RobertBaruch/lmarv/3dshapes/CAY_17-J.step

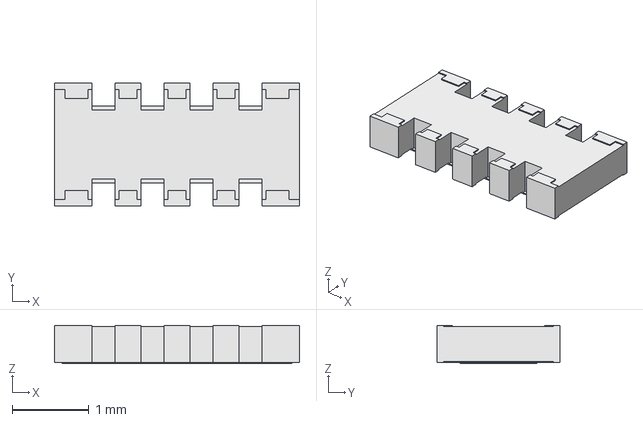
[picture p1: CAD file, 2018-12-16]
3dshapes/CAY_17-J.step
3.20 x 1.60 x 0.5 mm
