RobertBaruch/lmarv/3dshapes/APTD2012.step

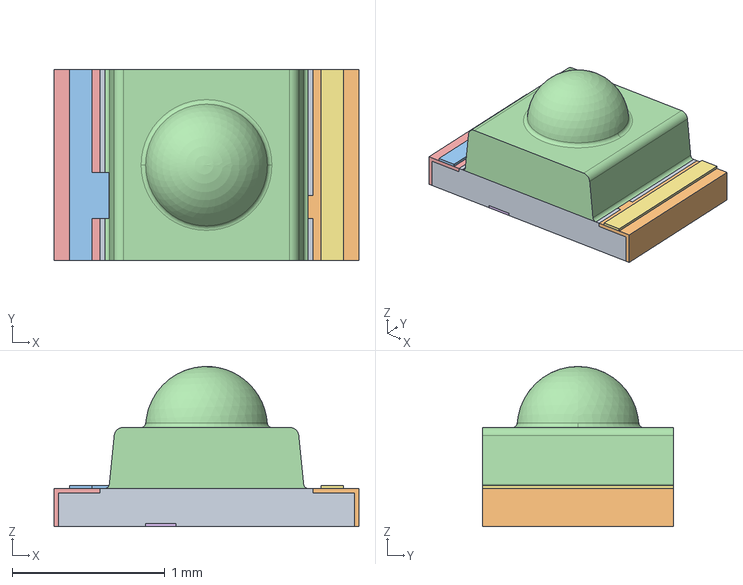
[picture p2: CAD file, 2018-12-16]
3dshapes/APTD2012.step
2.00 x 1.25 x 1.05 mm
