RobertBaruch/lmarv/3dshapes/qfp52_P1mm_14x14mm_v3_cp.step

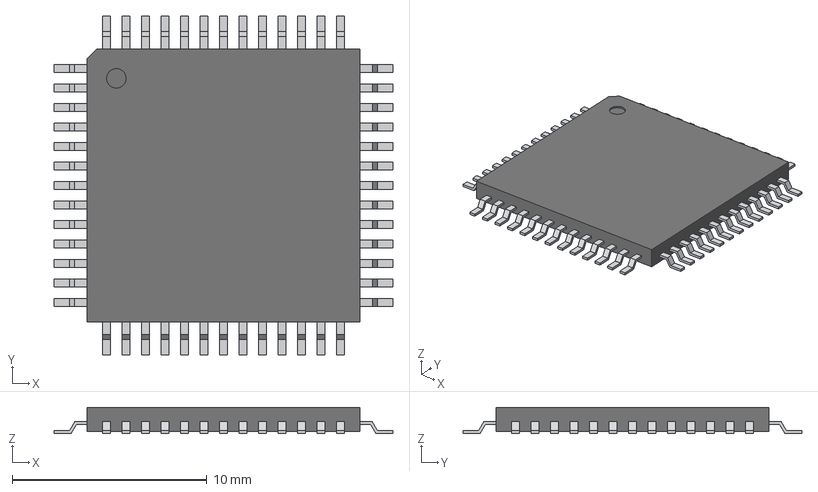
[picture p3: CAD file, 2018-12-16]
3dshapes/qfp52_P1mm_14x14mm_v3_cp.step
17.4 x 17.4 x 1.35 mm
