RobertBaruch/lmarv/lmarv-1/riscv-instructions-book/instr-add-datapath.png

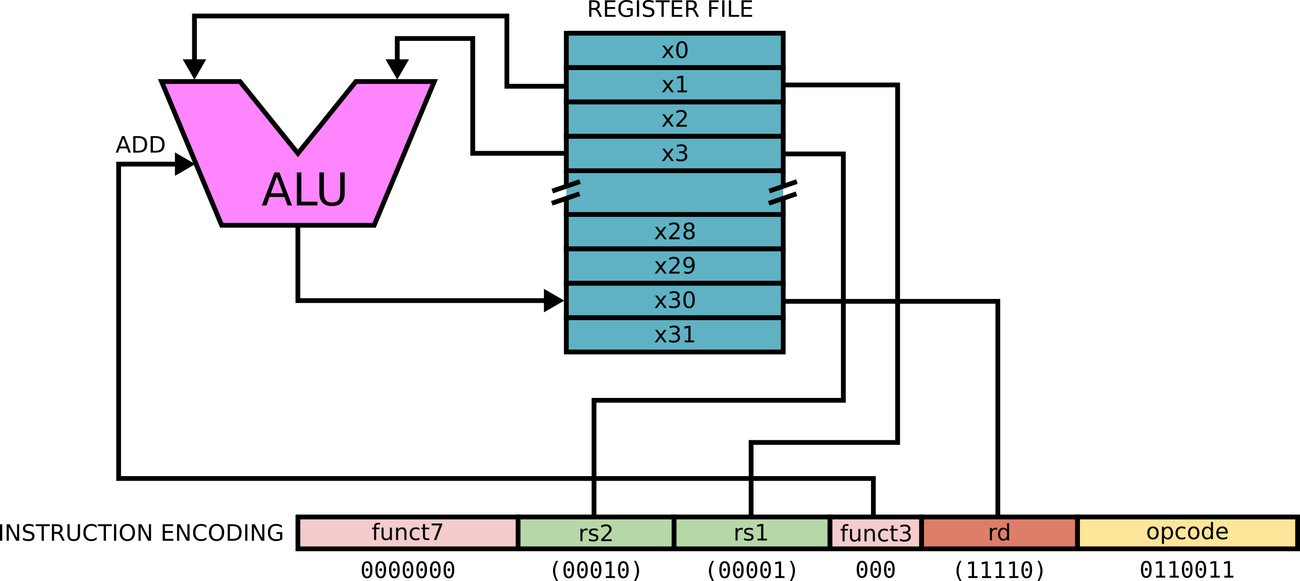
lmarv-1/riscv-instructions-book/instr-add-datapath.png
