RobertBaruch/lmarv/lmarv-1/riscv-instructions-book/instr-add-example.png

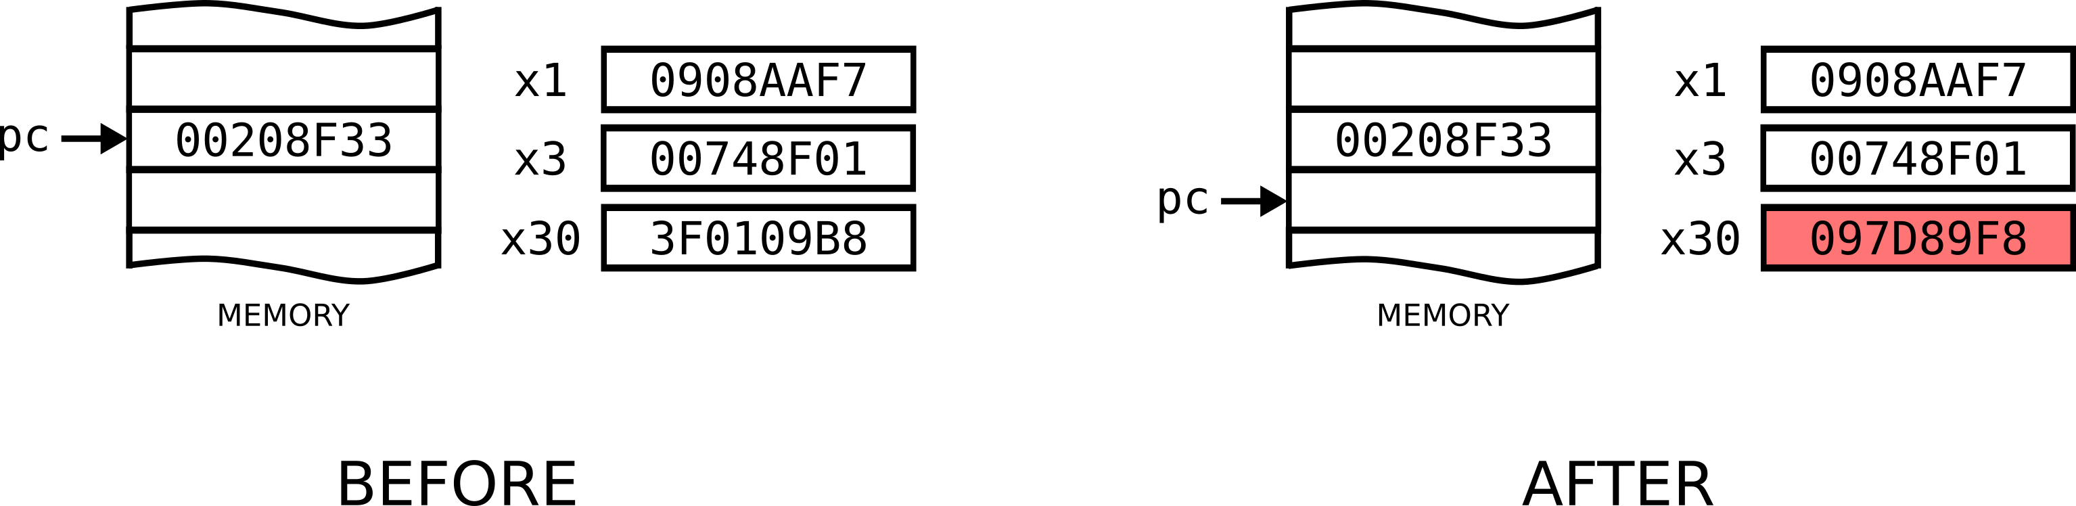
lmarv-1/riscv-instructions-book/instr-add-example.png
