RobertBaruch/lmarv/lmarv-1/riscv-instructions-book/instr-addi-datapath.png

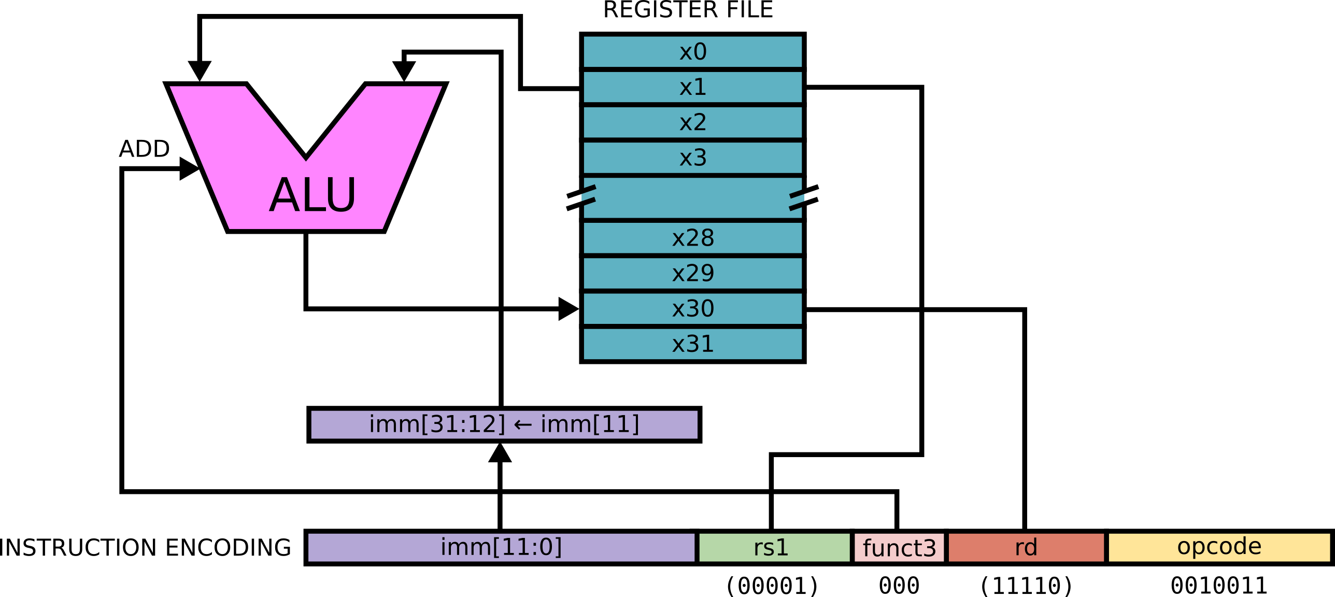
lmarv-1/riscv-instructions-book/instr-addi-datapath.png
