RobertBaruch/lmarv/lmarv-1/riscv-instructions-book/instr-auipc-datapath.png

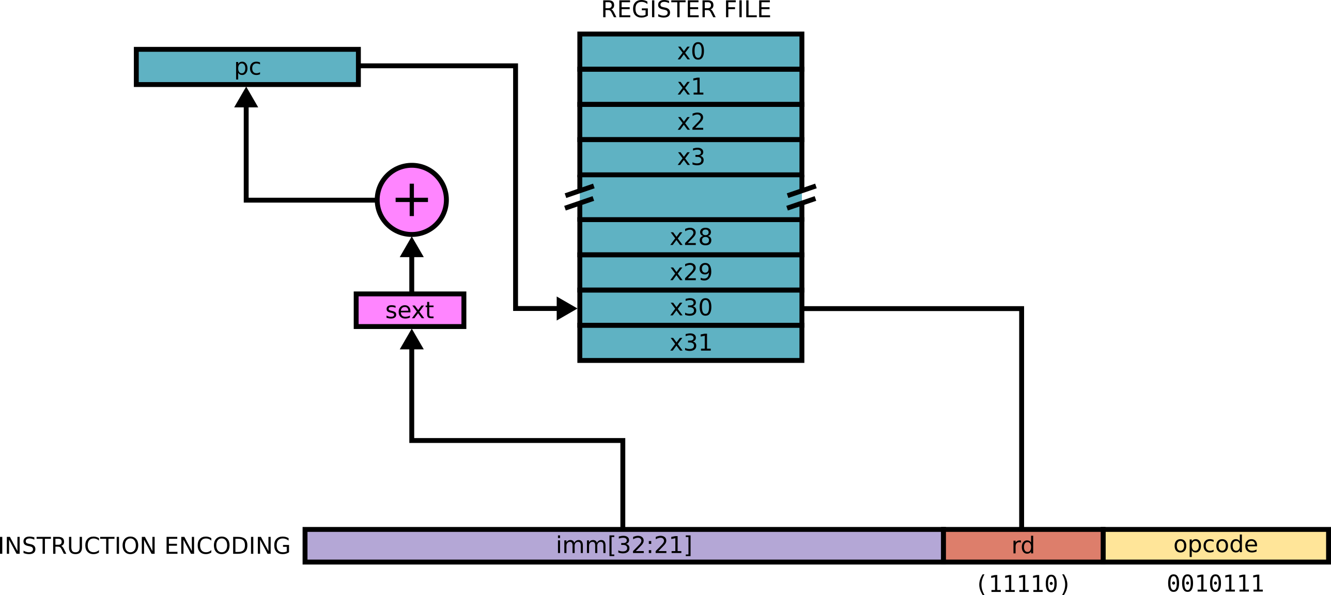
lmarv-1/riscv-instructions-book/instr-auipc-datapath.png
