RobertBaruch/lmarv/lmarv-1/riscv-instructions-book/instr-auipc-example.png

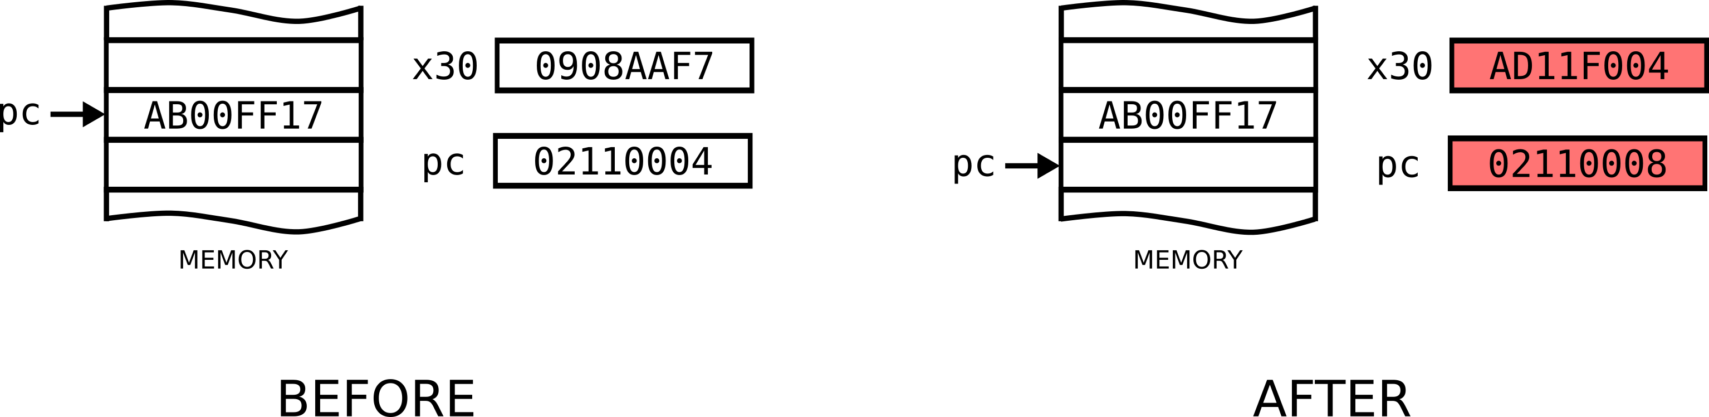
lmarv-1/riscv-instructions-book/instr-auipc-example.png
