RobertBaruch/lmarv/lmarv-1/riscv-instructions-book/instr-beq-datapath.png

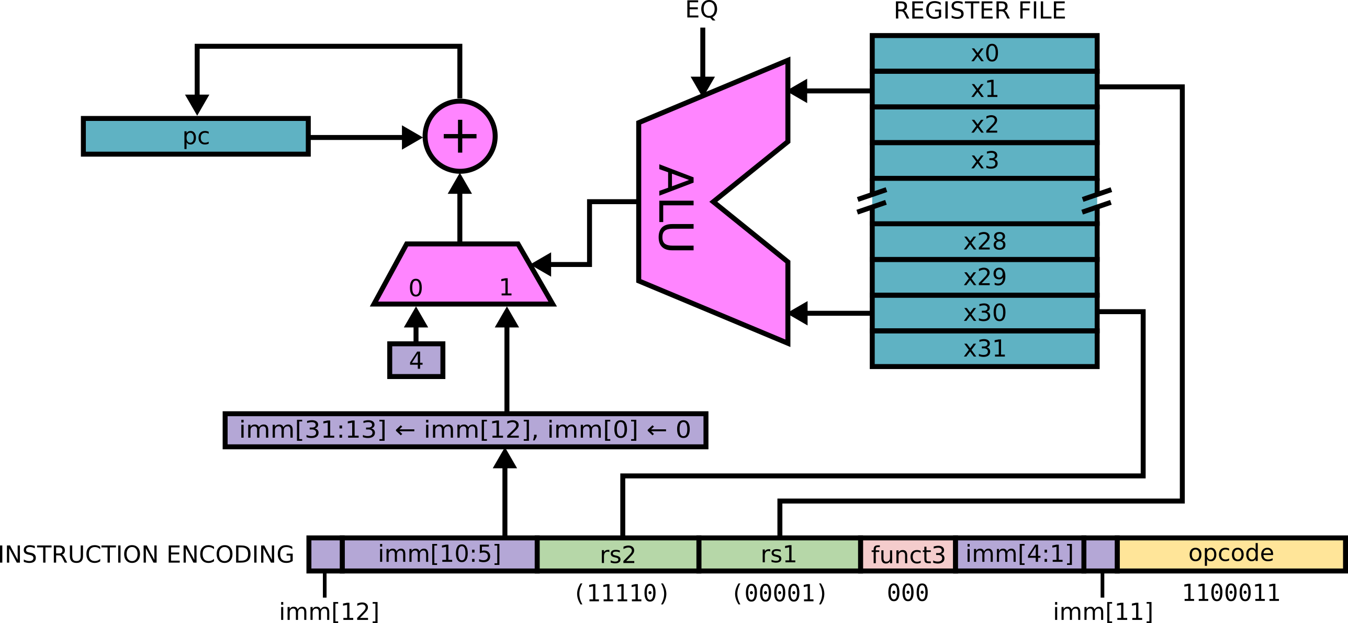
lmarv-1/riscv-instructions-book/instr-beq-datapath.png
