RobertBaruch/lmarv/lmarv-1/riscv-instructions-book/instr-beq-example.png

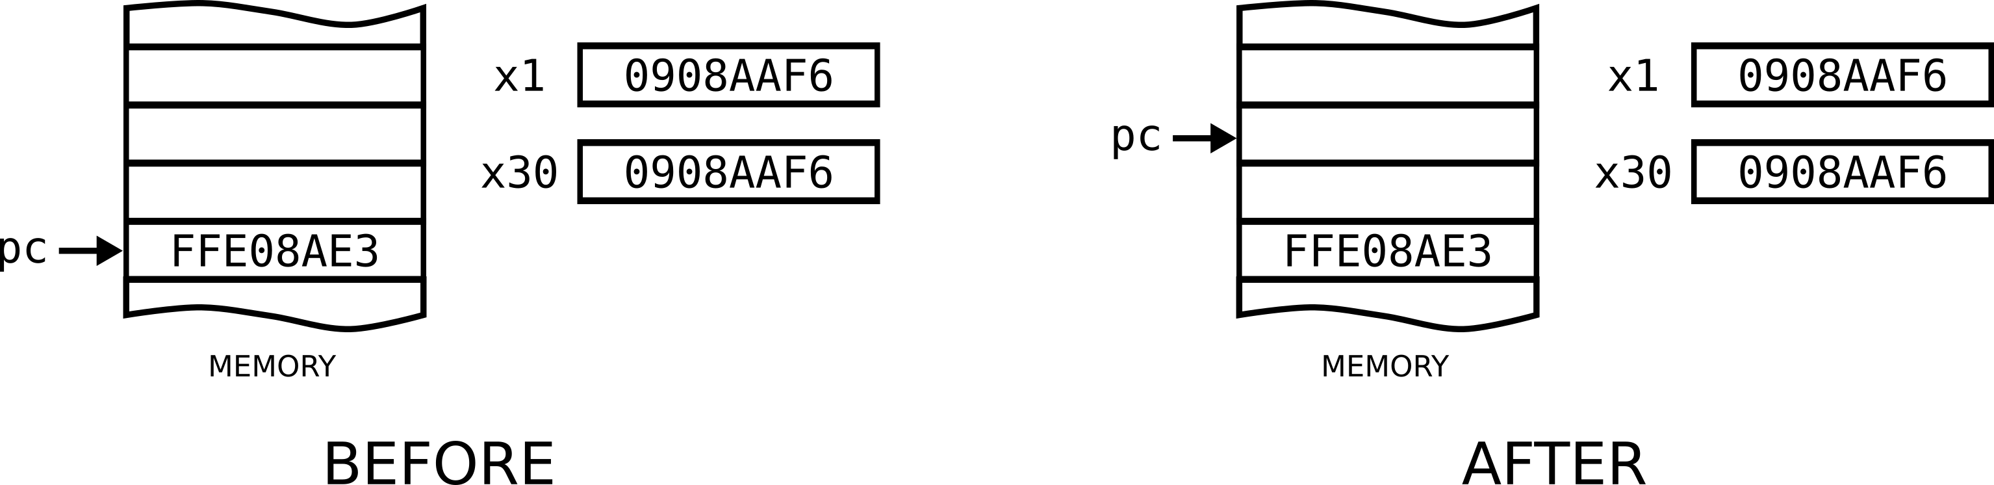
lmarv-1/riscv-instructions-book/instr-beq-example.png
