RobertBaruch/lmarv/lmarv-1/riscv-instructions-book/instr-csrrw-datapath.png

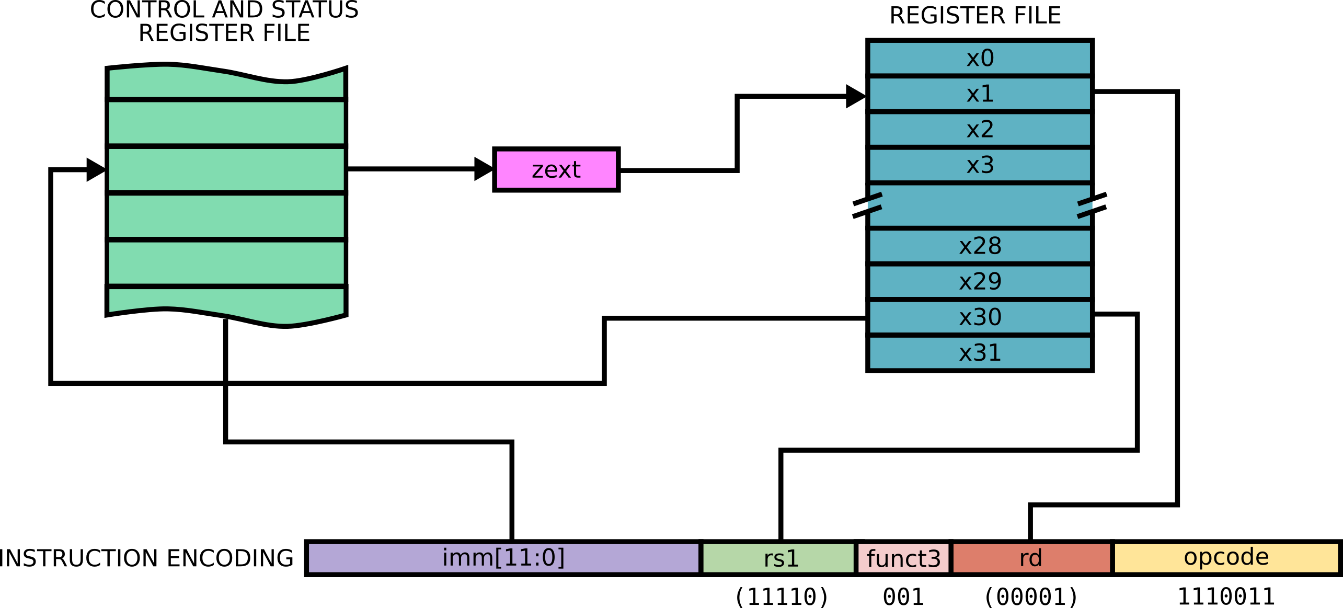
lmarv-1/riscv-instructions-book/instr-csrrw-datapath.png
