RobertBaruch/lmarv/lmarv-1/riscv-instructions-book/instr-csrrw-example.png

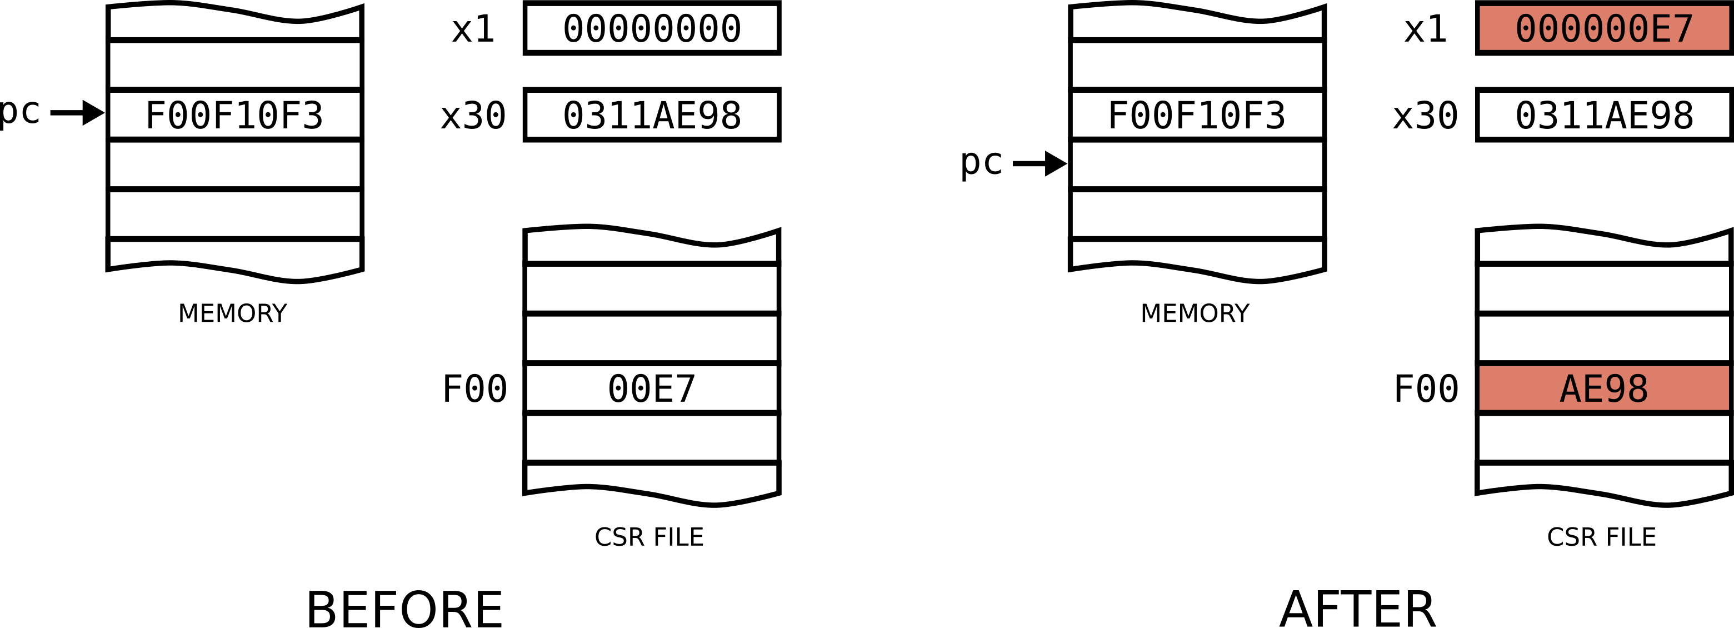
lmarv-1/riscv-instructions-book/instr-csrrw-example.png
