RobertBaruch/lmarv/lmarv-1/riscv-instructions-book/instr-diag-beq.png

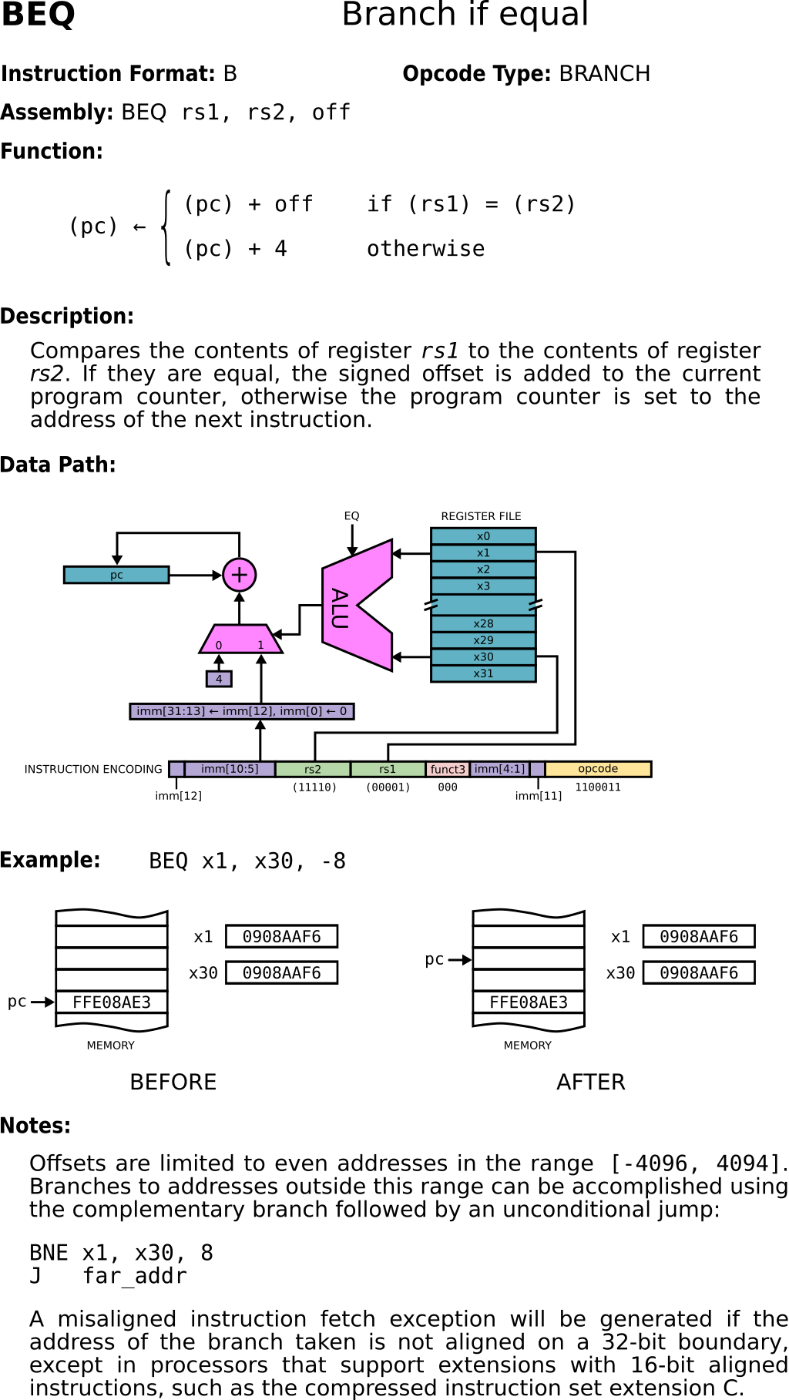
lmarv-1/riscv-instructions-book/instr-diag-beq.png
