RobertBaruch/lmarv/lmarv-1/riscv-instructions-book/instr-diag-csrrw.png

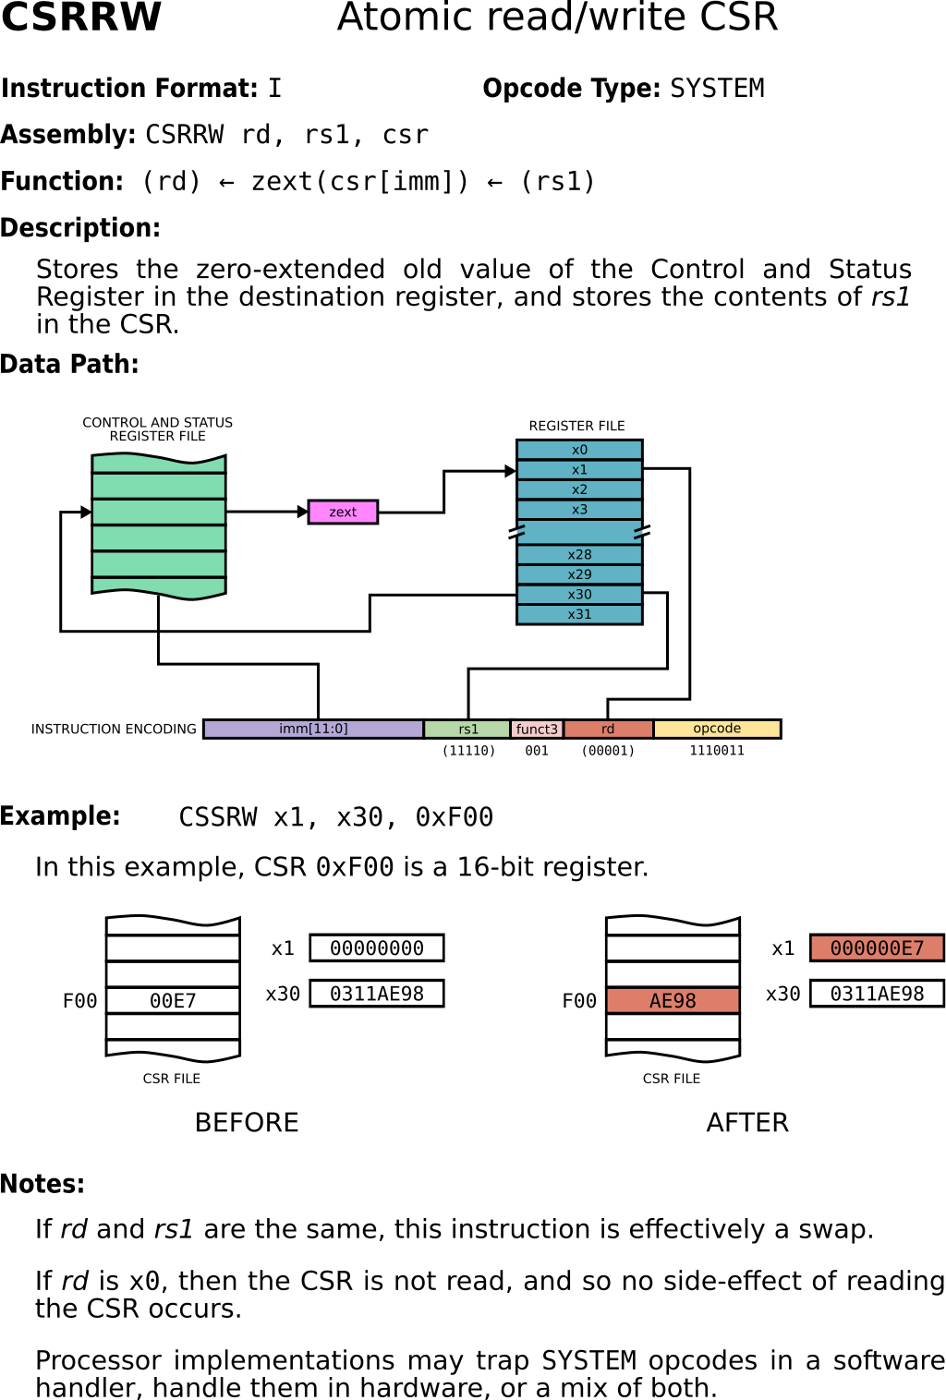
lmarv-1/riscv-instructions-book/instr-diag-csrrw.png
