RobertBaruch/lmarv/lmarv-1/riscv-instructions-book/instr-diag-jal.png

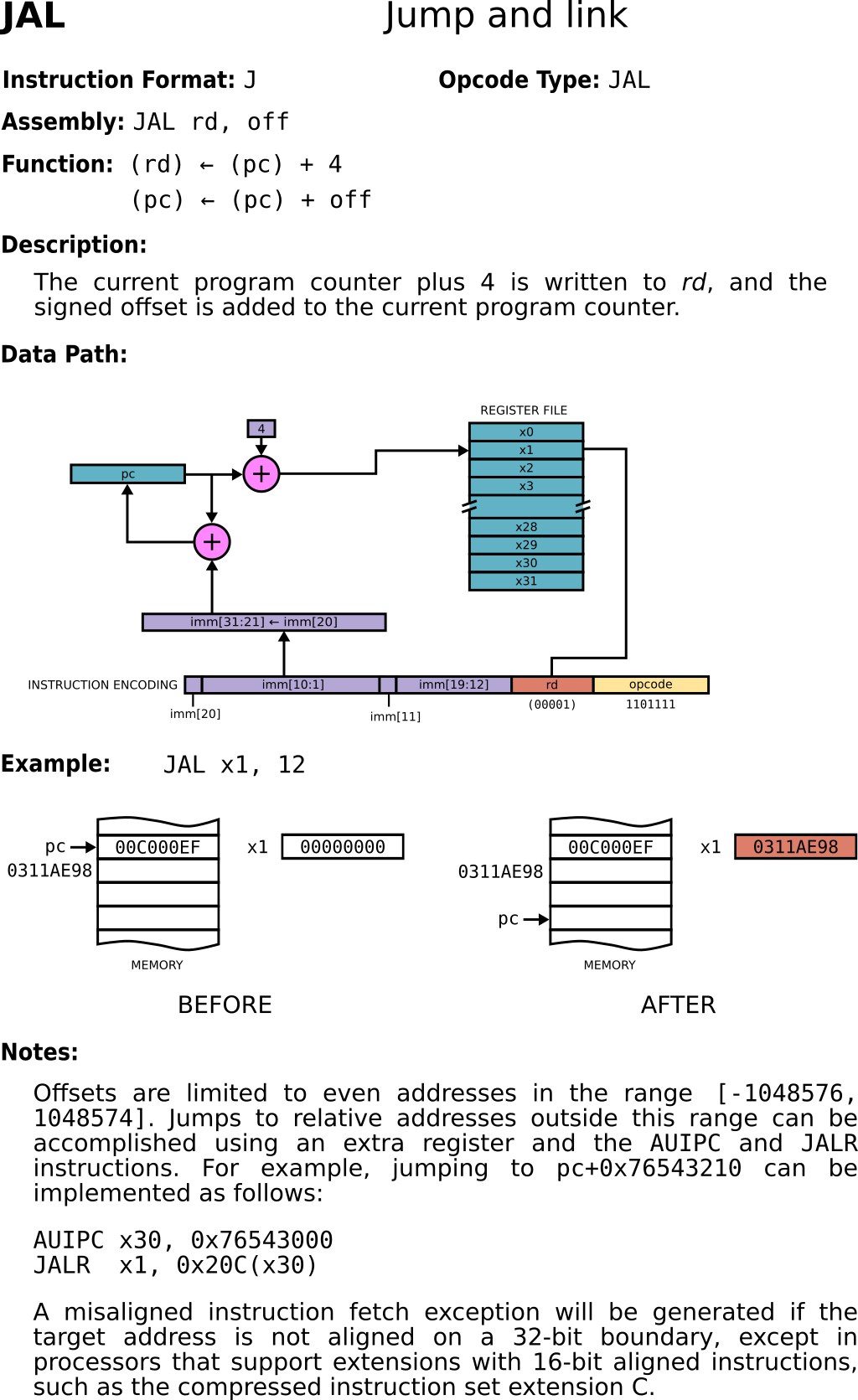
lmarv-1/riscv-instructions-book/instr-diag-jal.png
