RobertBaruch/lmarv/lmarv-1/riscv-instructions-book/instr-diag-jalr.png

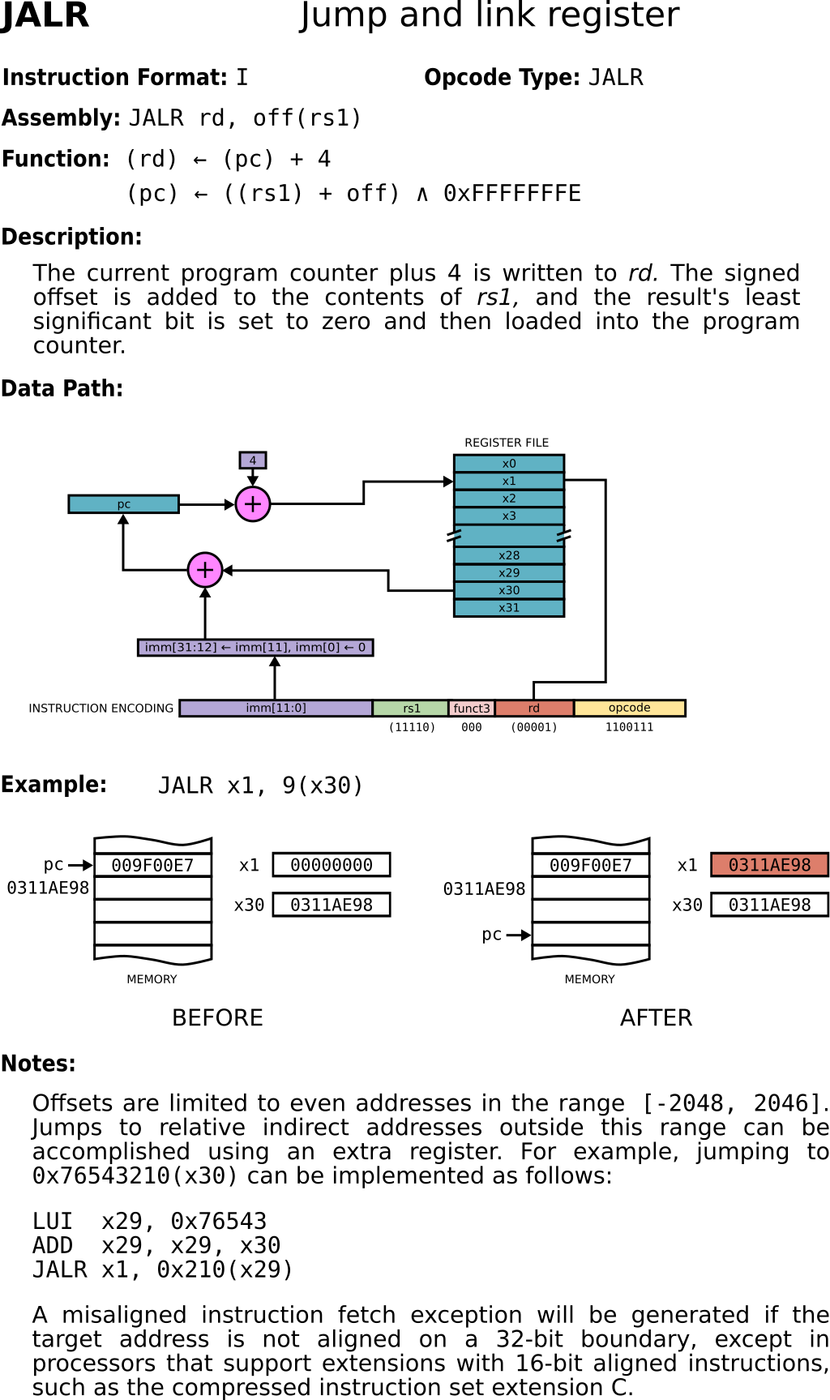
lmarv-1/riscv-instructions-book/instr-diag-jalr.png
