RobertBaruch/lmarv/lmarv-1/riscv-instructions-book/instr-diag-lh.png

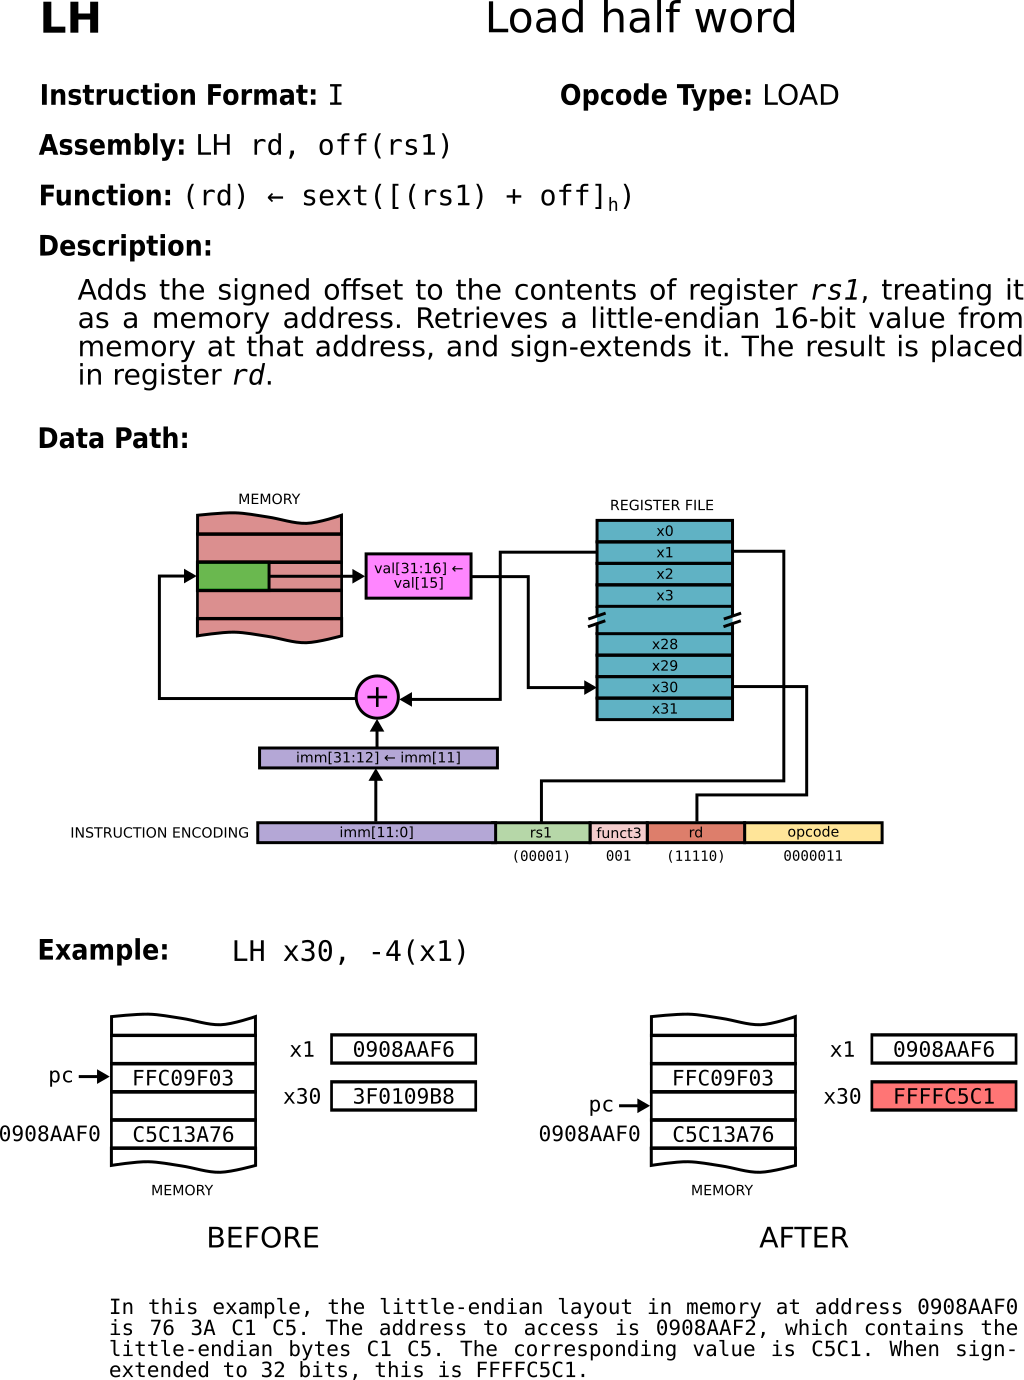
lmarv-1/riscv-instructions-book/instr-diag-lh.png
