RobertBaruch/lmarv/lmarv-1/riscv-instructions-book/instr-diag-nop.png

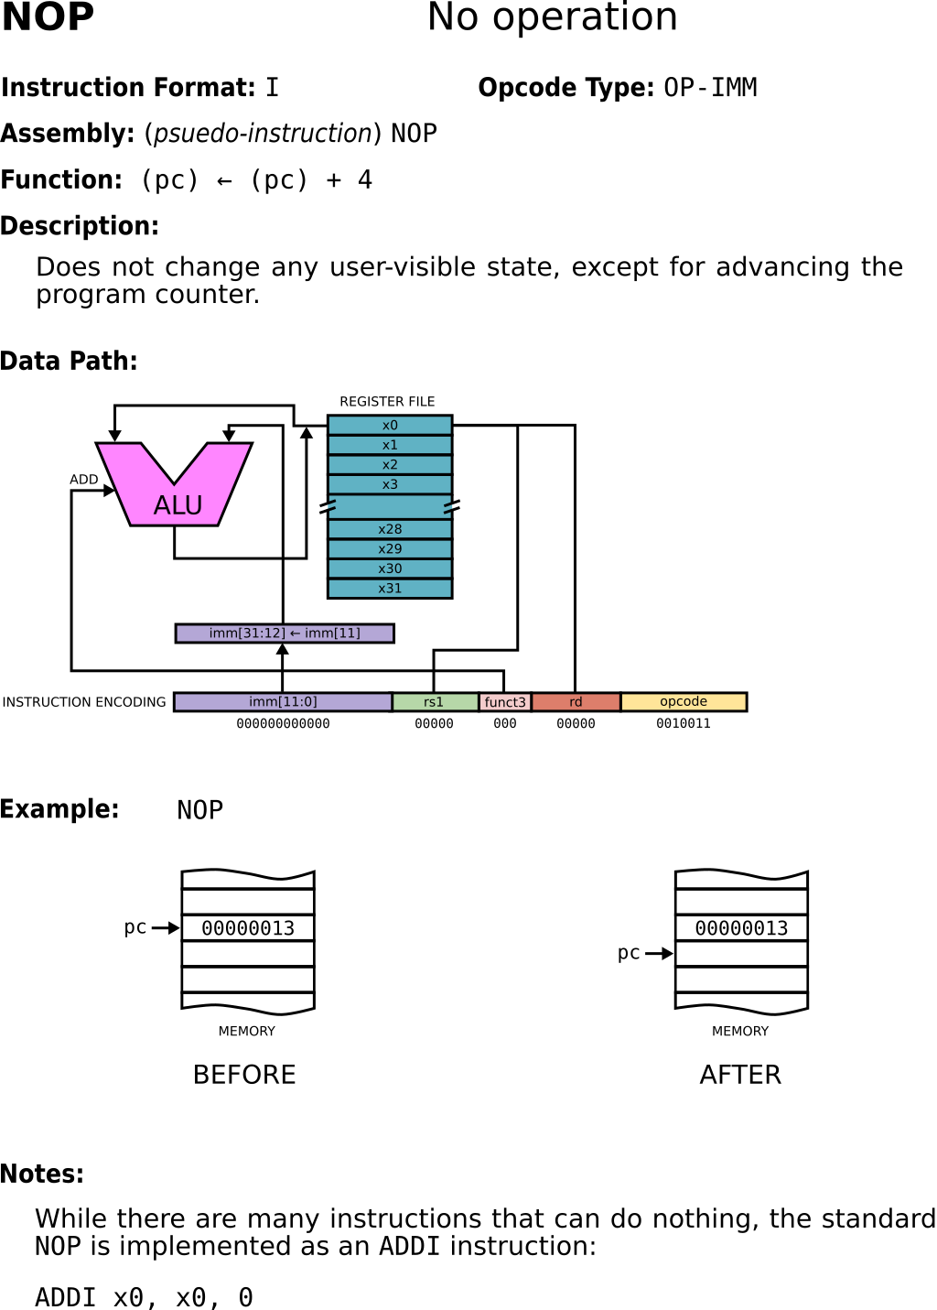
lmarv-1/riscv-instructions-book/instr-diag-nop.png
