RobertBaruch/lmarv/lmarv-1/riscv-instructions-book/instr-jal-datapath.png

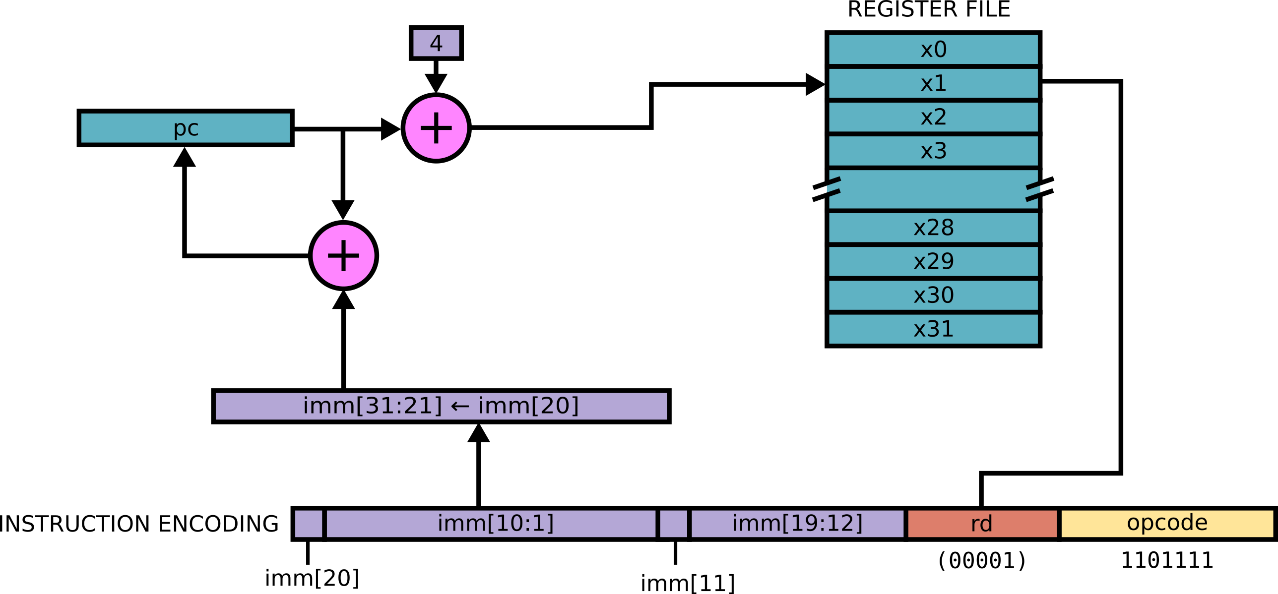
lmarv-1/riscv-instructions-book/instr-jal-datapath.png
