RobertBaruch/lmarv/lmarv-1/riscv-instructions-book/instr-jal-example.png

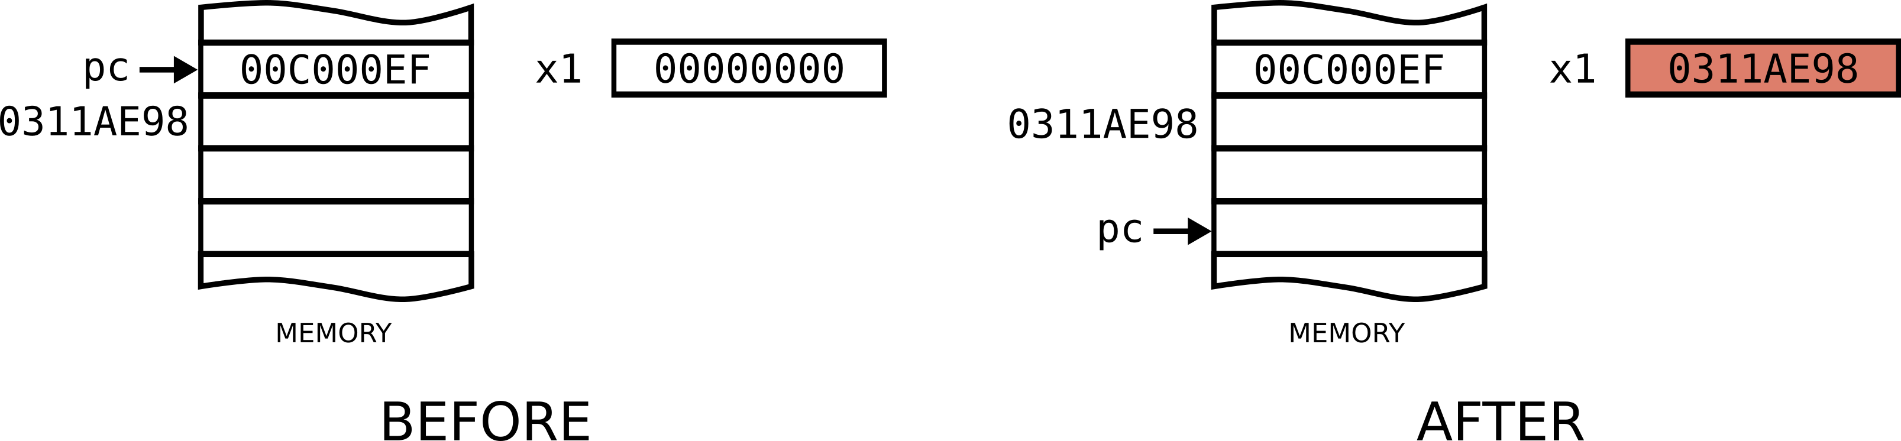
lmarv-1/riscv-instructions-book/instr-jal-example.png
