RobertBaruch/lmarv/lmarv-1/riscv-instructions-book/instr-jalr-datapath.png

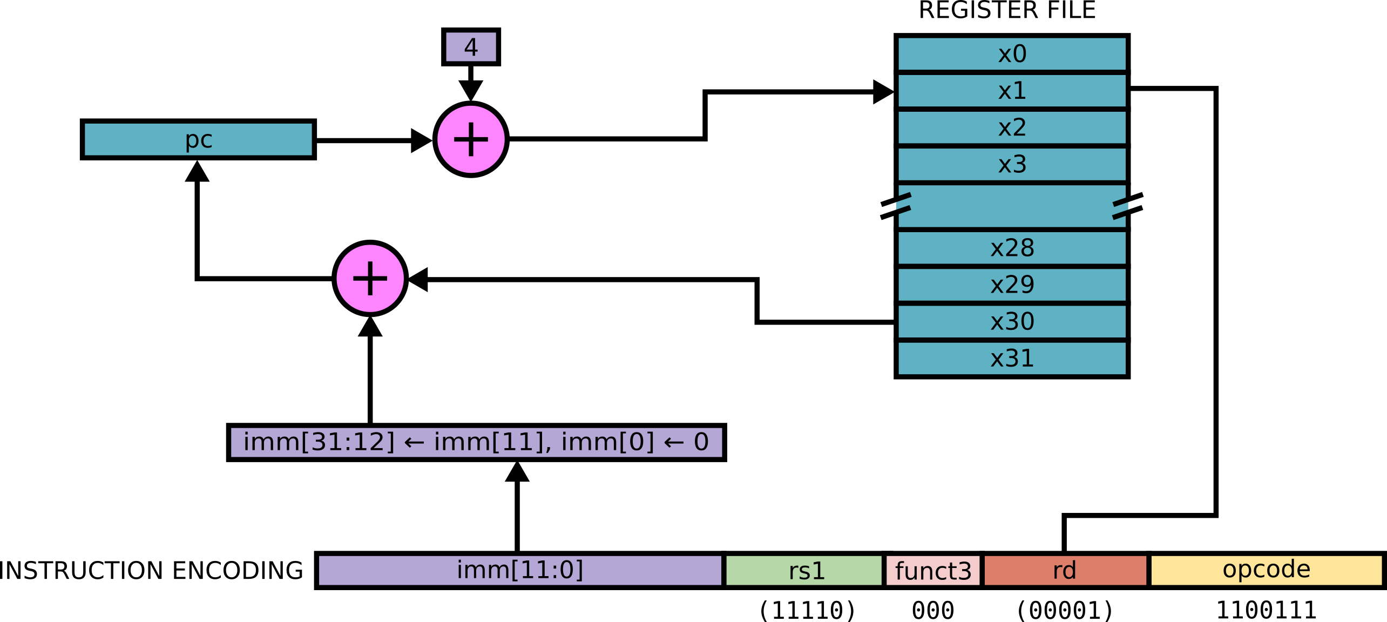
lmarv-1/riscv-instructions-book/instr-jalr-datapath.png
