RobertBaruch/lmarv/lmarv-1/riscv-instructions-book/instr-jalr-example.png

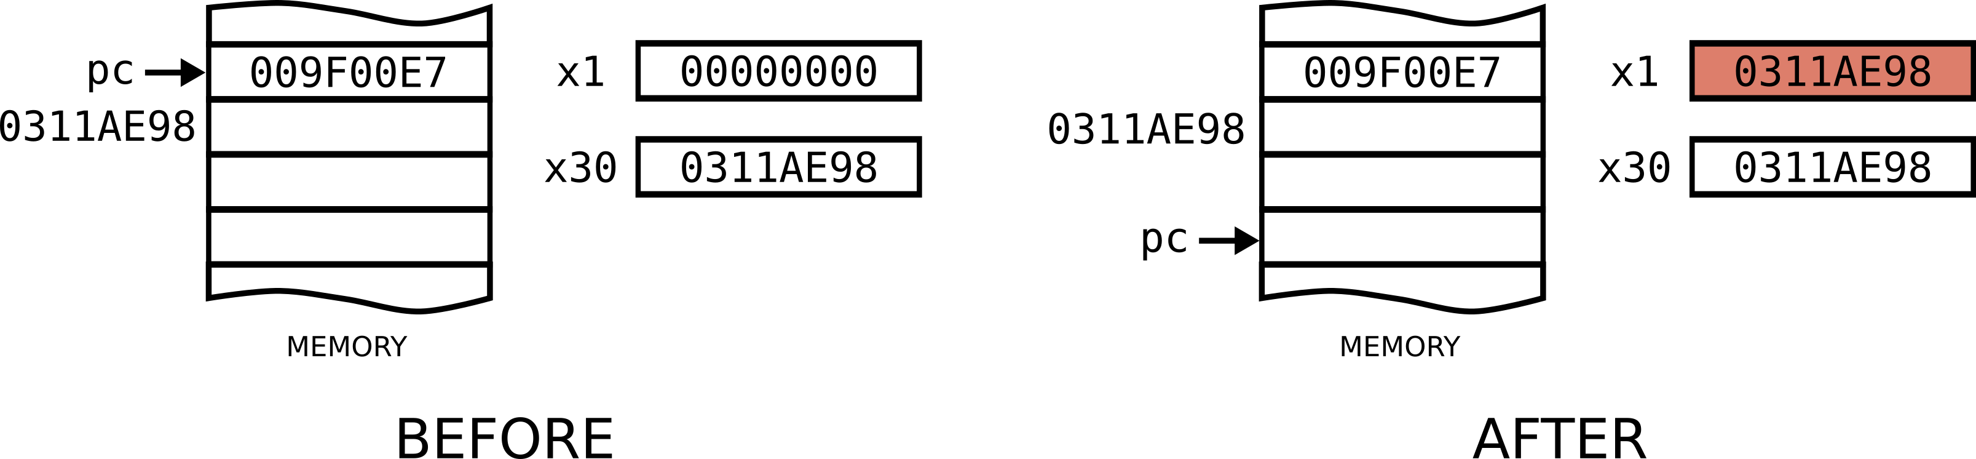
lmarv-1/riscv-instructions-book/instr-jalr-example.png
