RobertBaruch/lmarv/lmarv-1/riscv-instructions-book/instr-lb-datapath.png

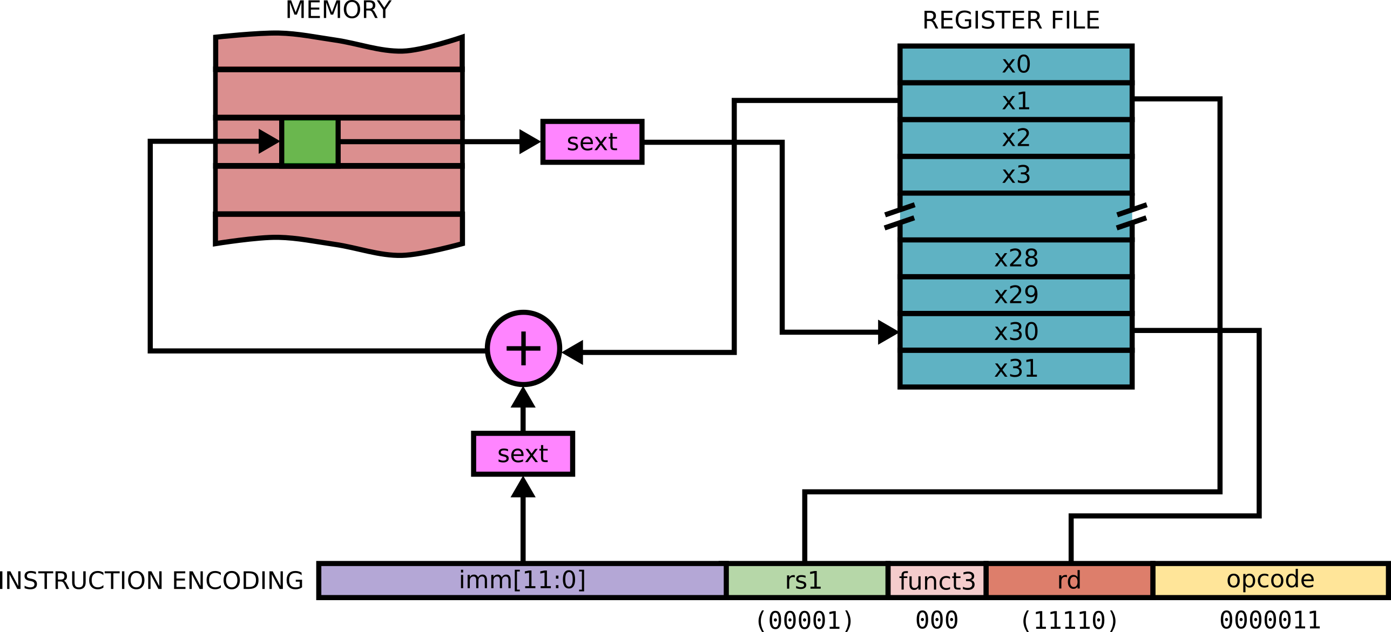
lmarv-1/riscv-instructions-book/instr-lb-datapath.png
