RobertBaruch/lmarv/lmarv-1/riscv-instructions-book/instr-lb-example.png

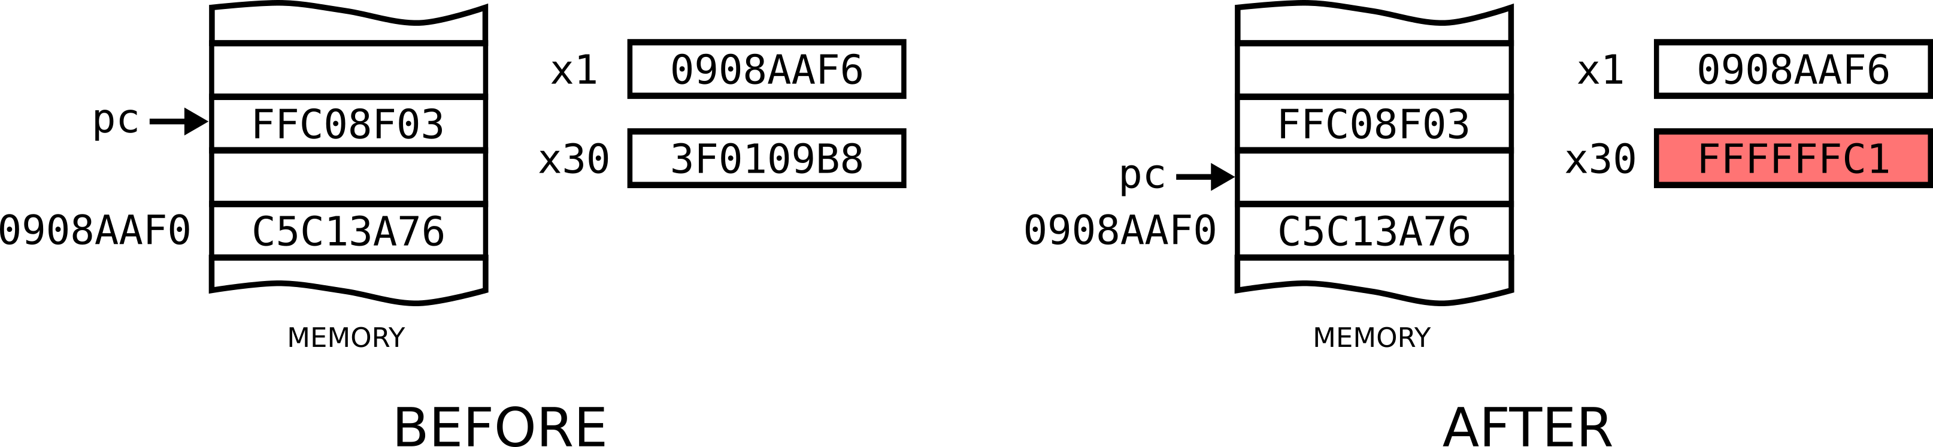
lmarv-1/riscv-instructions-book/instr-lb-example.png
