RobertBaruch/lmarv/lmarv-1/riscv-instructions-book/instr-lui-datapath.png

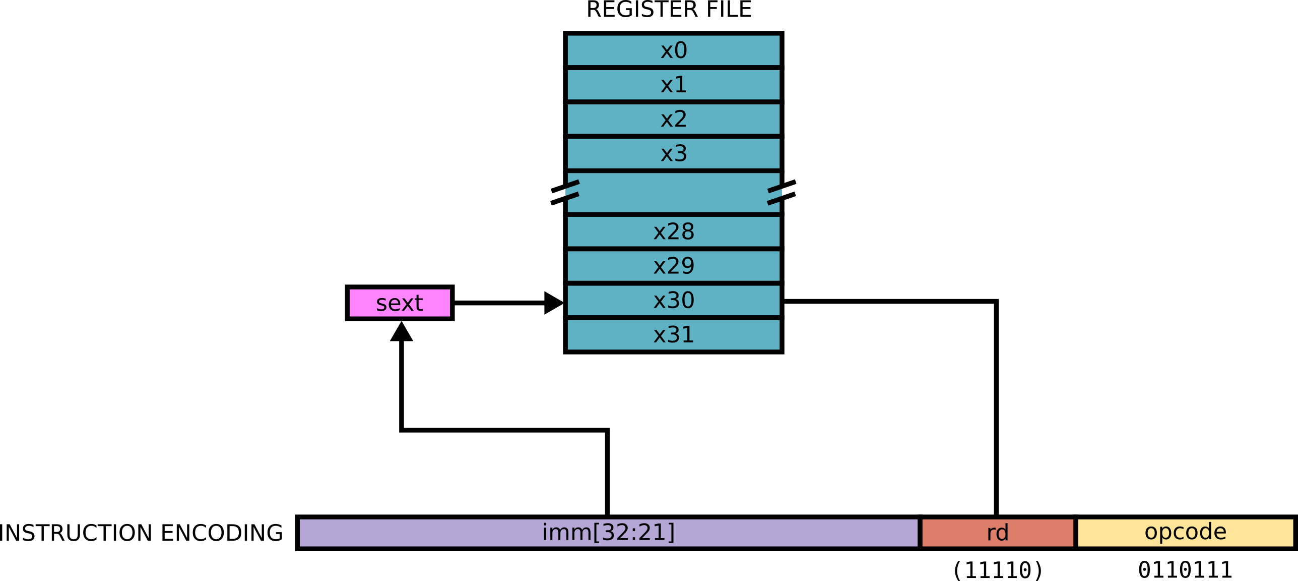
lmarv-1/riscv-instructions-book/instr-lui-datapath.png
