RobertBaruch/lmarv/lmarv-1/riscv-instructions-book/instr-lw-example.png

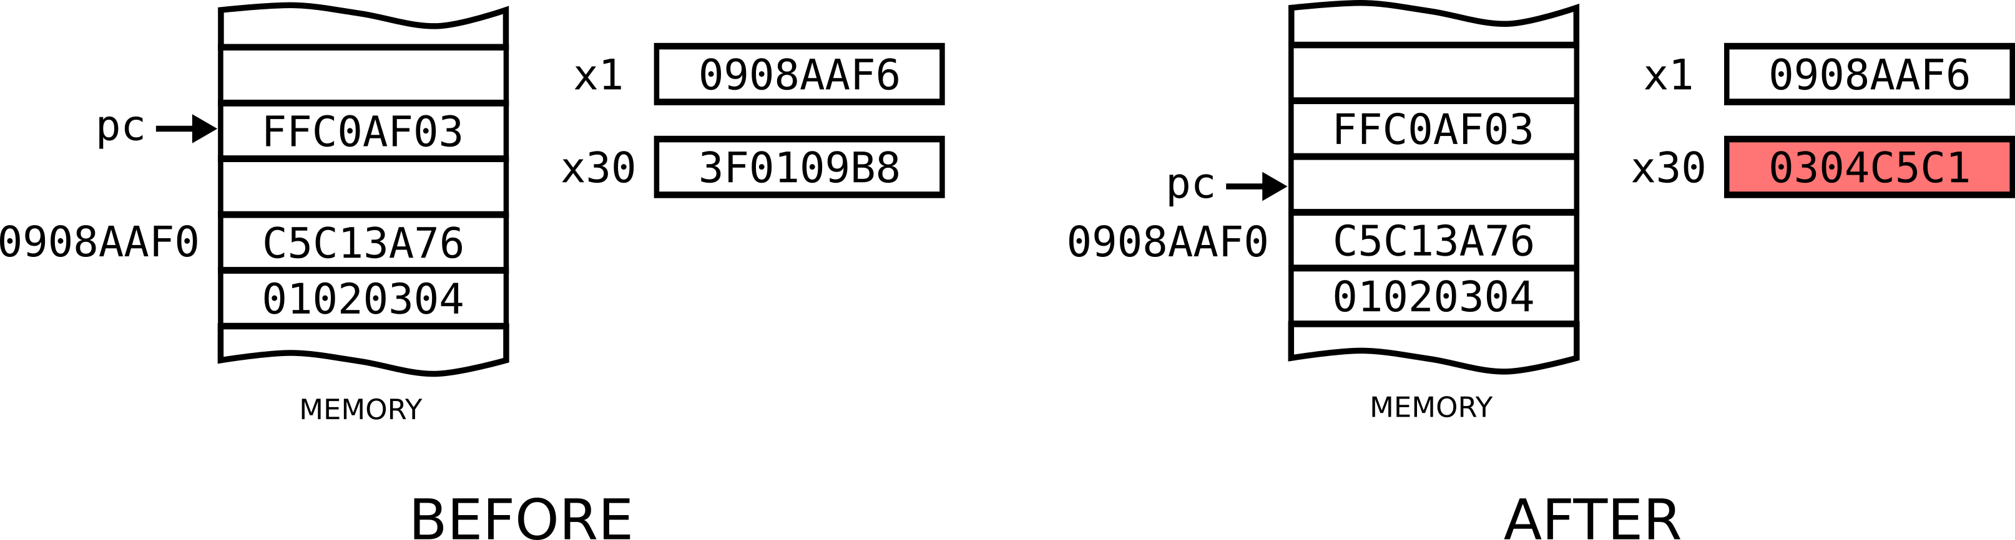
lmarv-1/riscv-instructions-book/instr-lw-example.png
