RobertBaruch/lmarv/lmarv-1/riscv-instructions-book/instr-sb-datapath.png

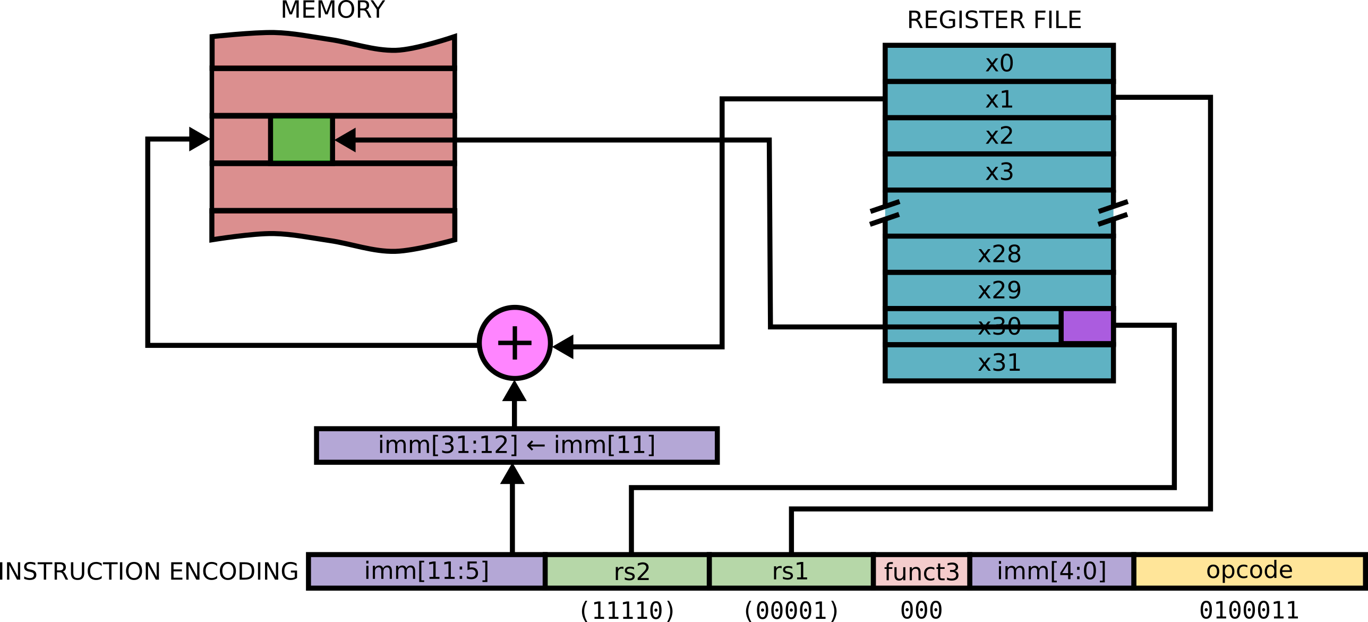
lmarv-1/riscv-instructions-book/instr-sb-datapath.png
