RobertBaruch/lmarv/lmarv-1/riscv-instructions-book/rev32-1.png

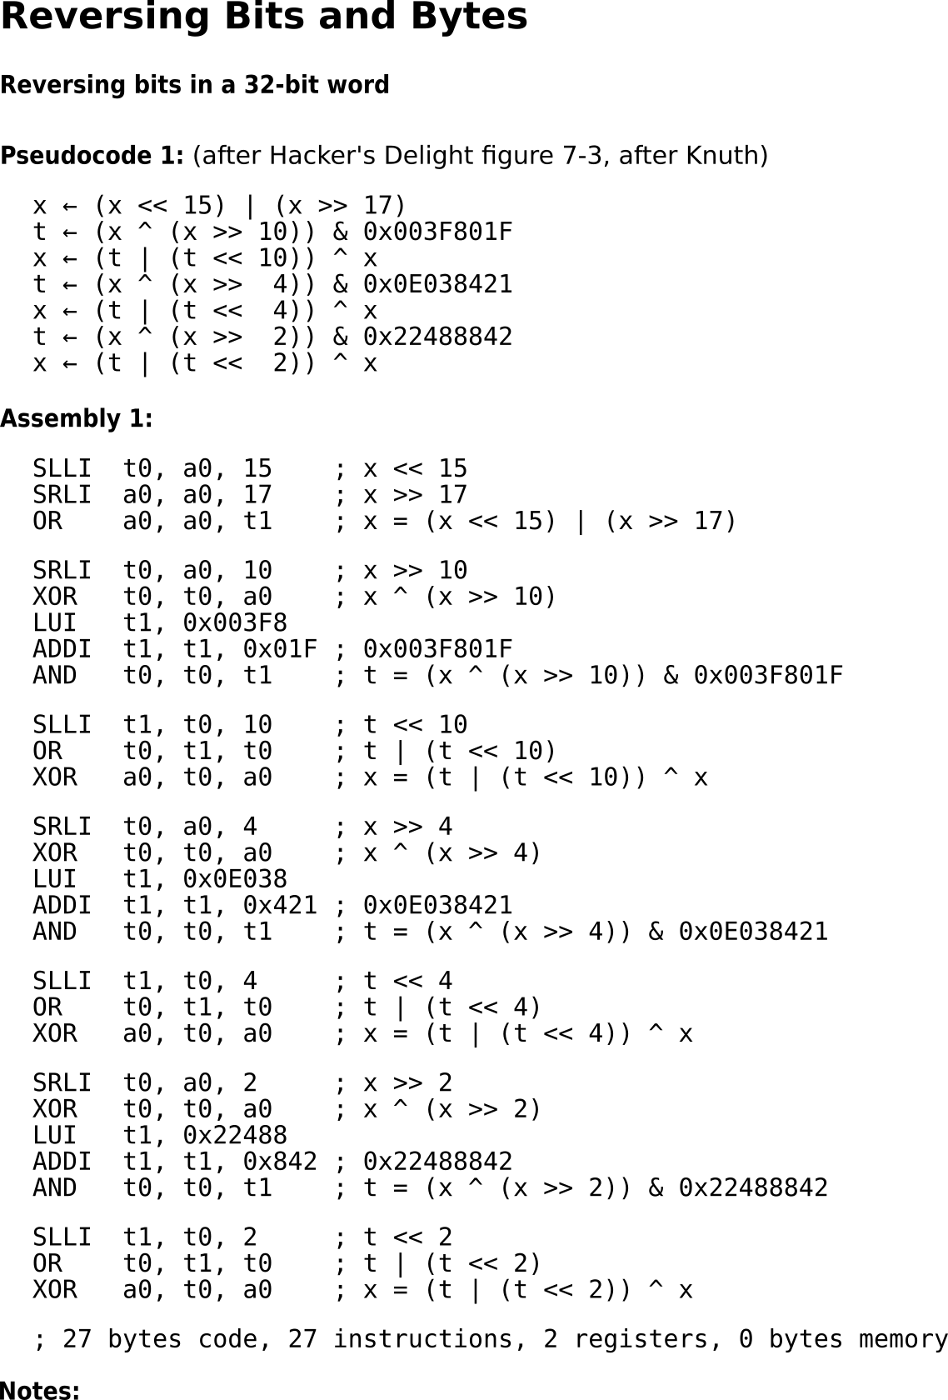
lmarv-1/riscv-instructions-book/rev32-1.png
