RobertBaruch/lmarv/lmarv-1/riscv-instructions-book/rev32-1a.png

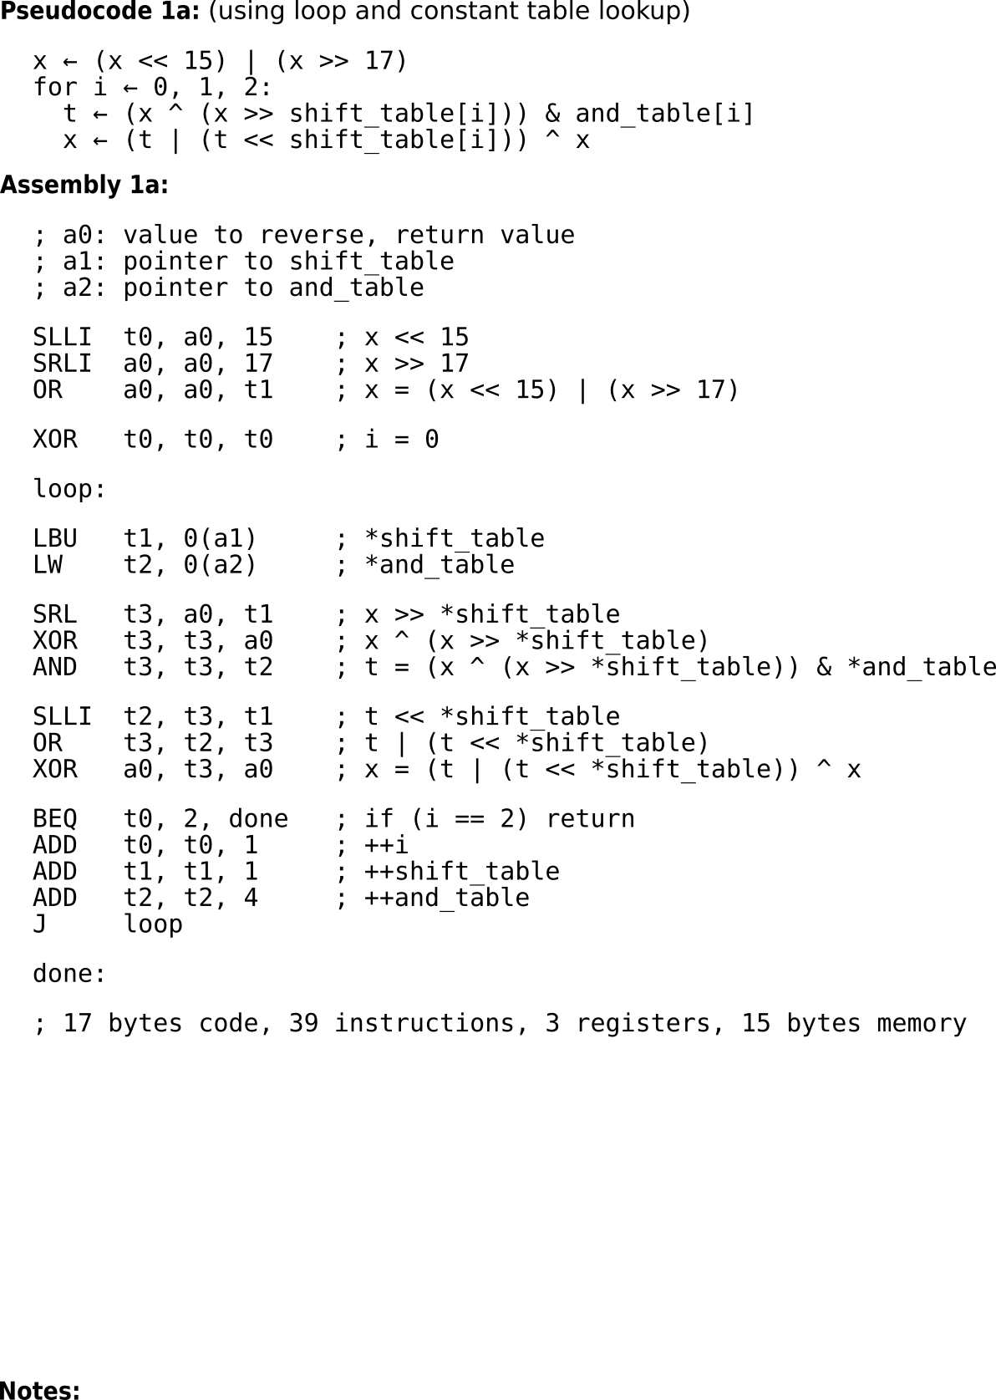
lmarv-1/riscv-instructions-book/rev32-1a.png
