RobertBaruch/lmarv/lmarv-1/riscv-instructions-book/rev32-2.png

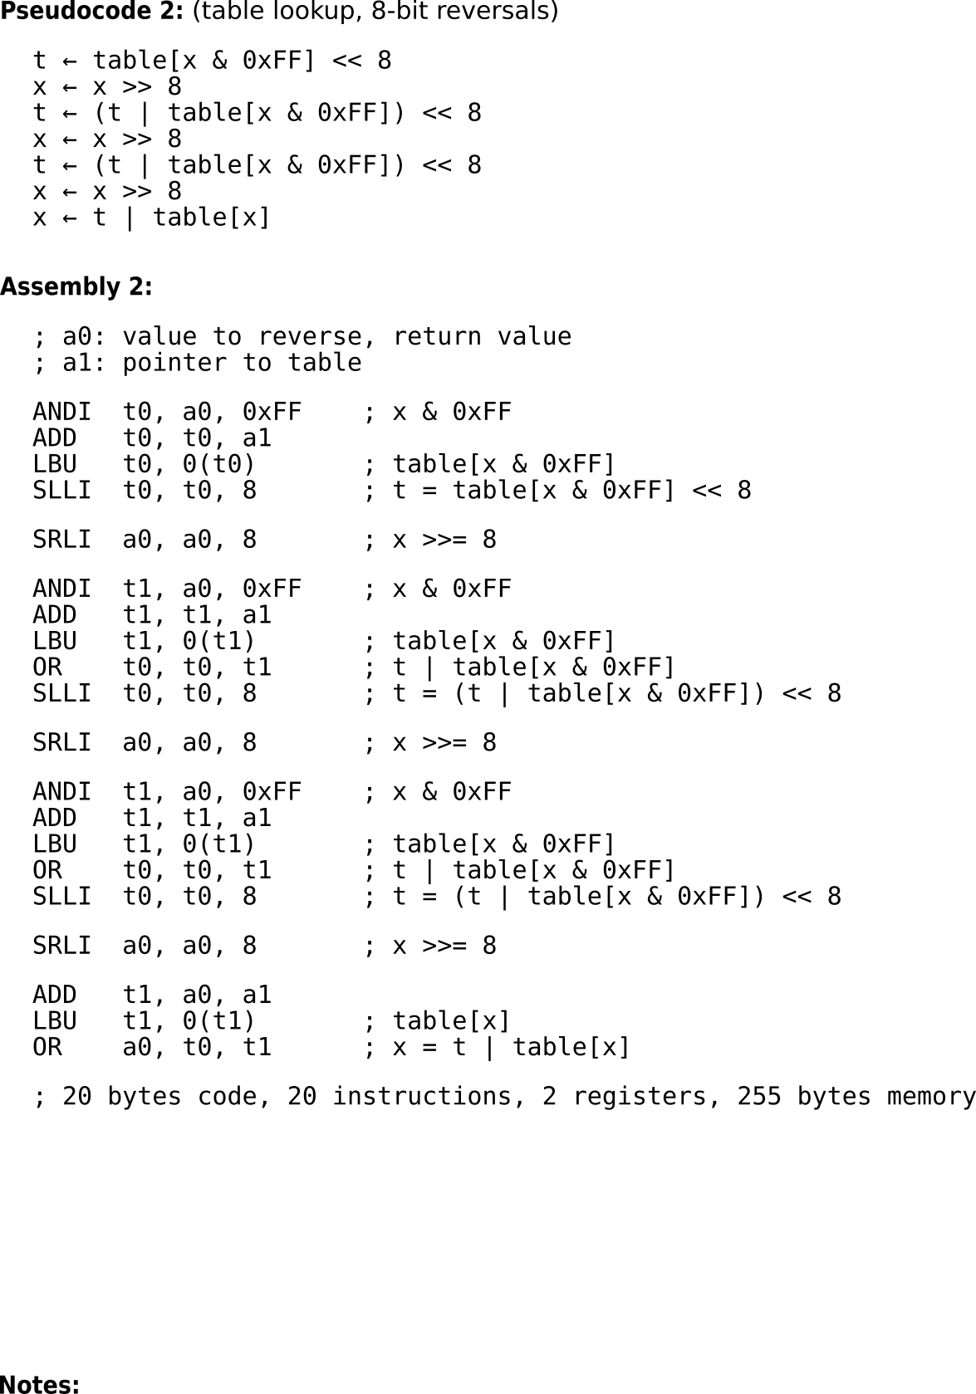
lmarv-1/riscv-instructions-book/rev32-2.png
