RobertBaruch/lmarv/lmarv-1/tester_v2/tester_v2.pdf

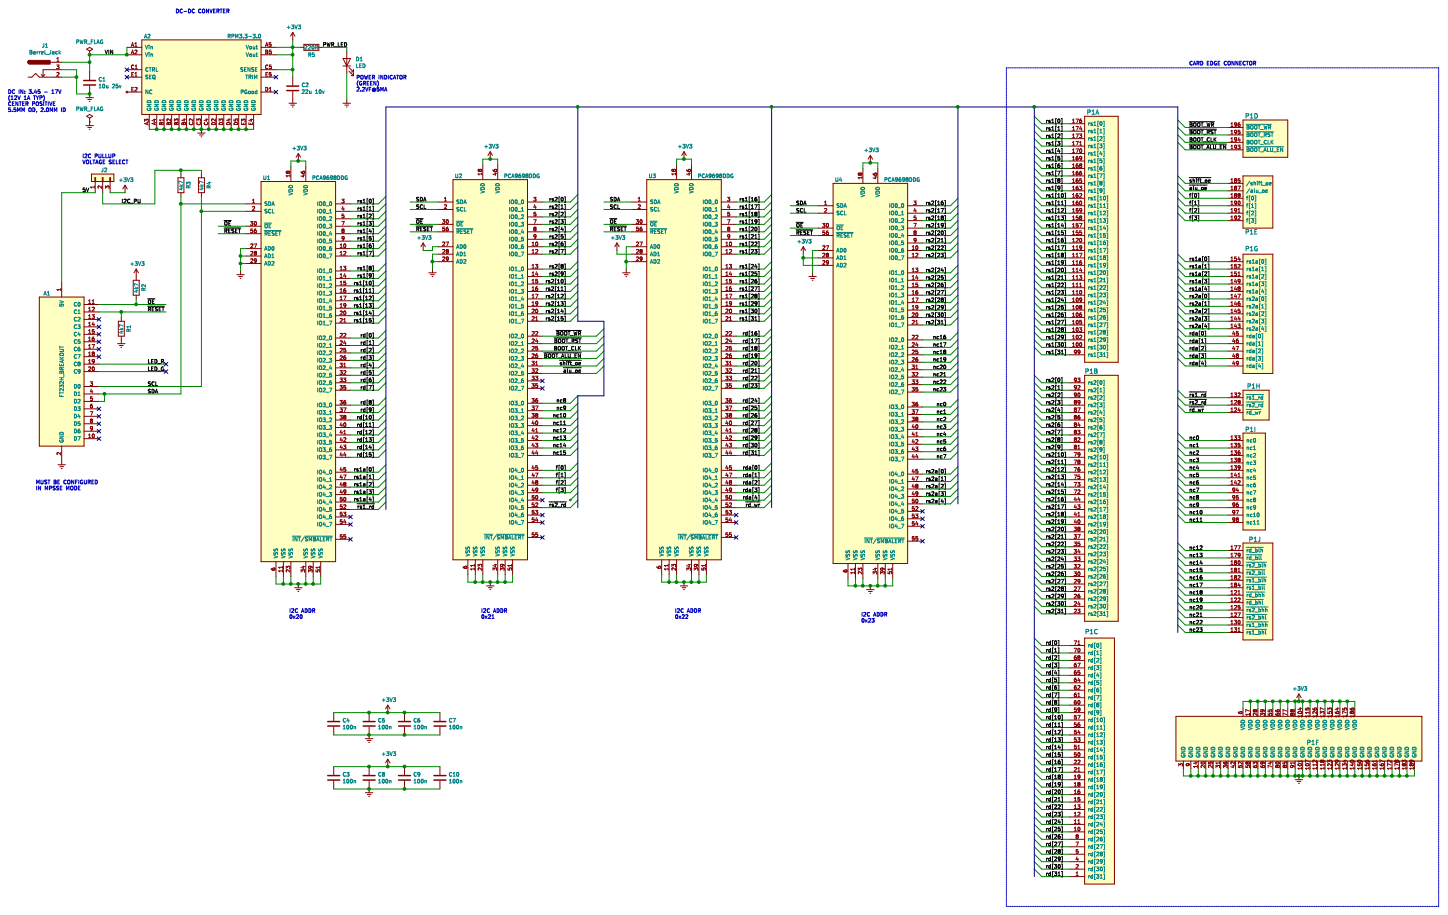
[picture p31: page 1]
