RobertBaruch/lmarv/lmarv-1/tester_v2/tester_v2-F.Cu.pdf

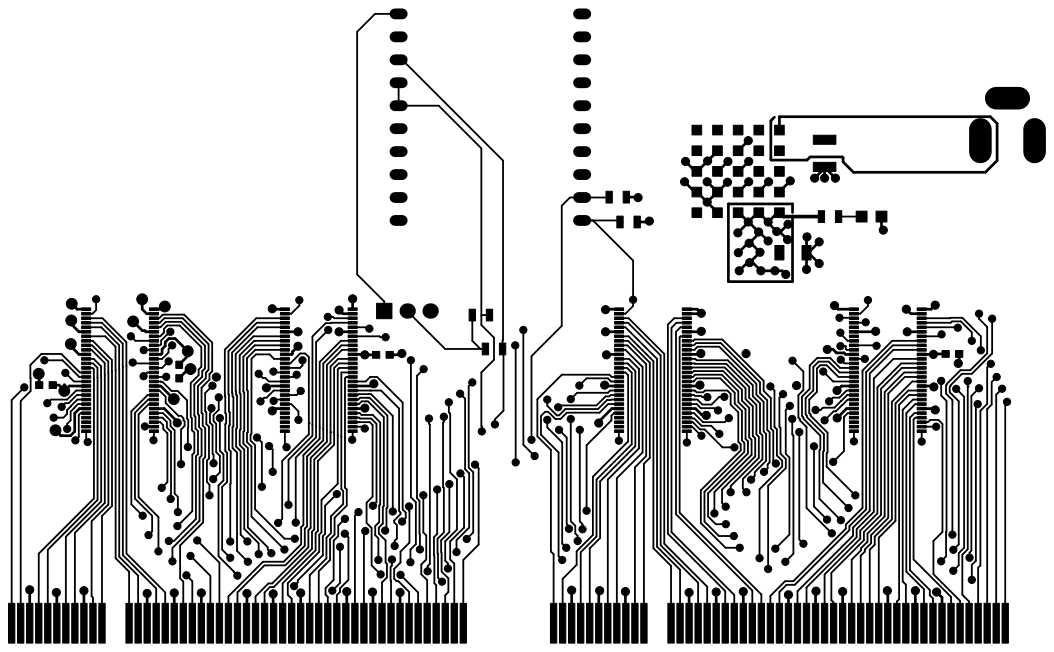
[picture p32: page 1]
