RobertBaruch/lmarv/lmarv-1/test_for_smd_networks/fabs/test_for_smd_networks-F.Mask.pdf

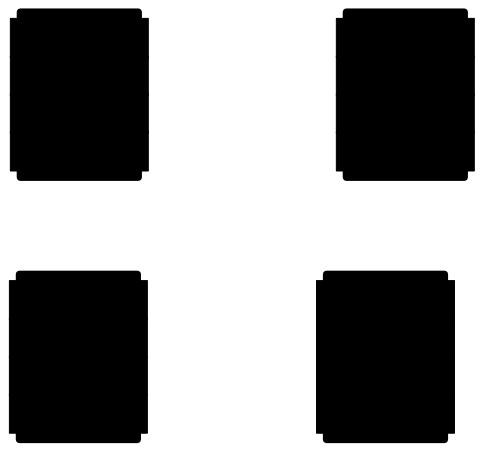
[picture p33: page 1]
