RobertBaruch/lmarv/lmarv-1/alu/alu.pdf

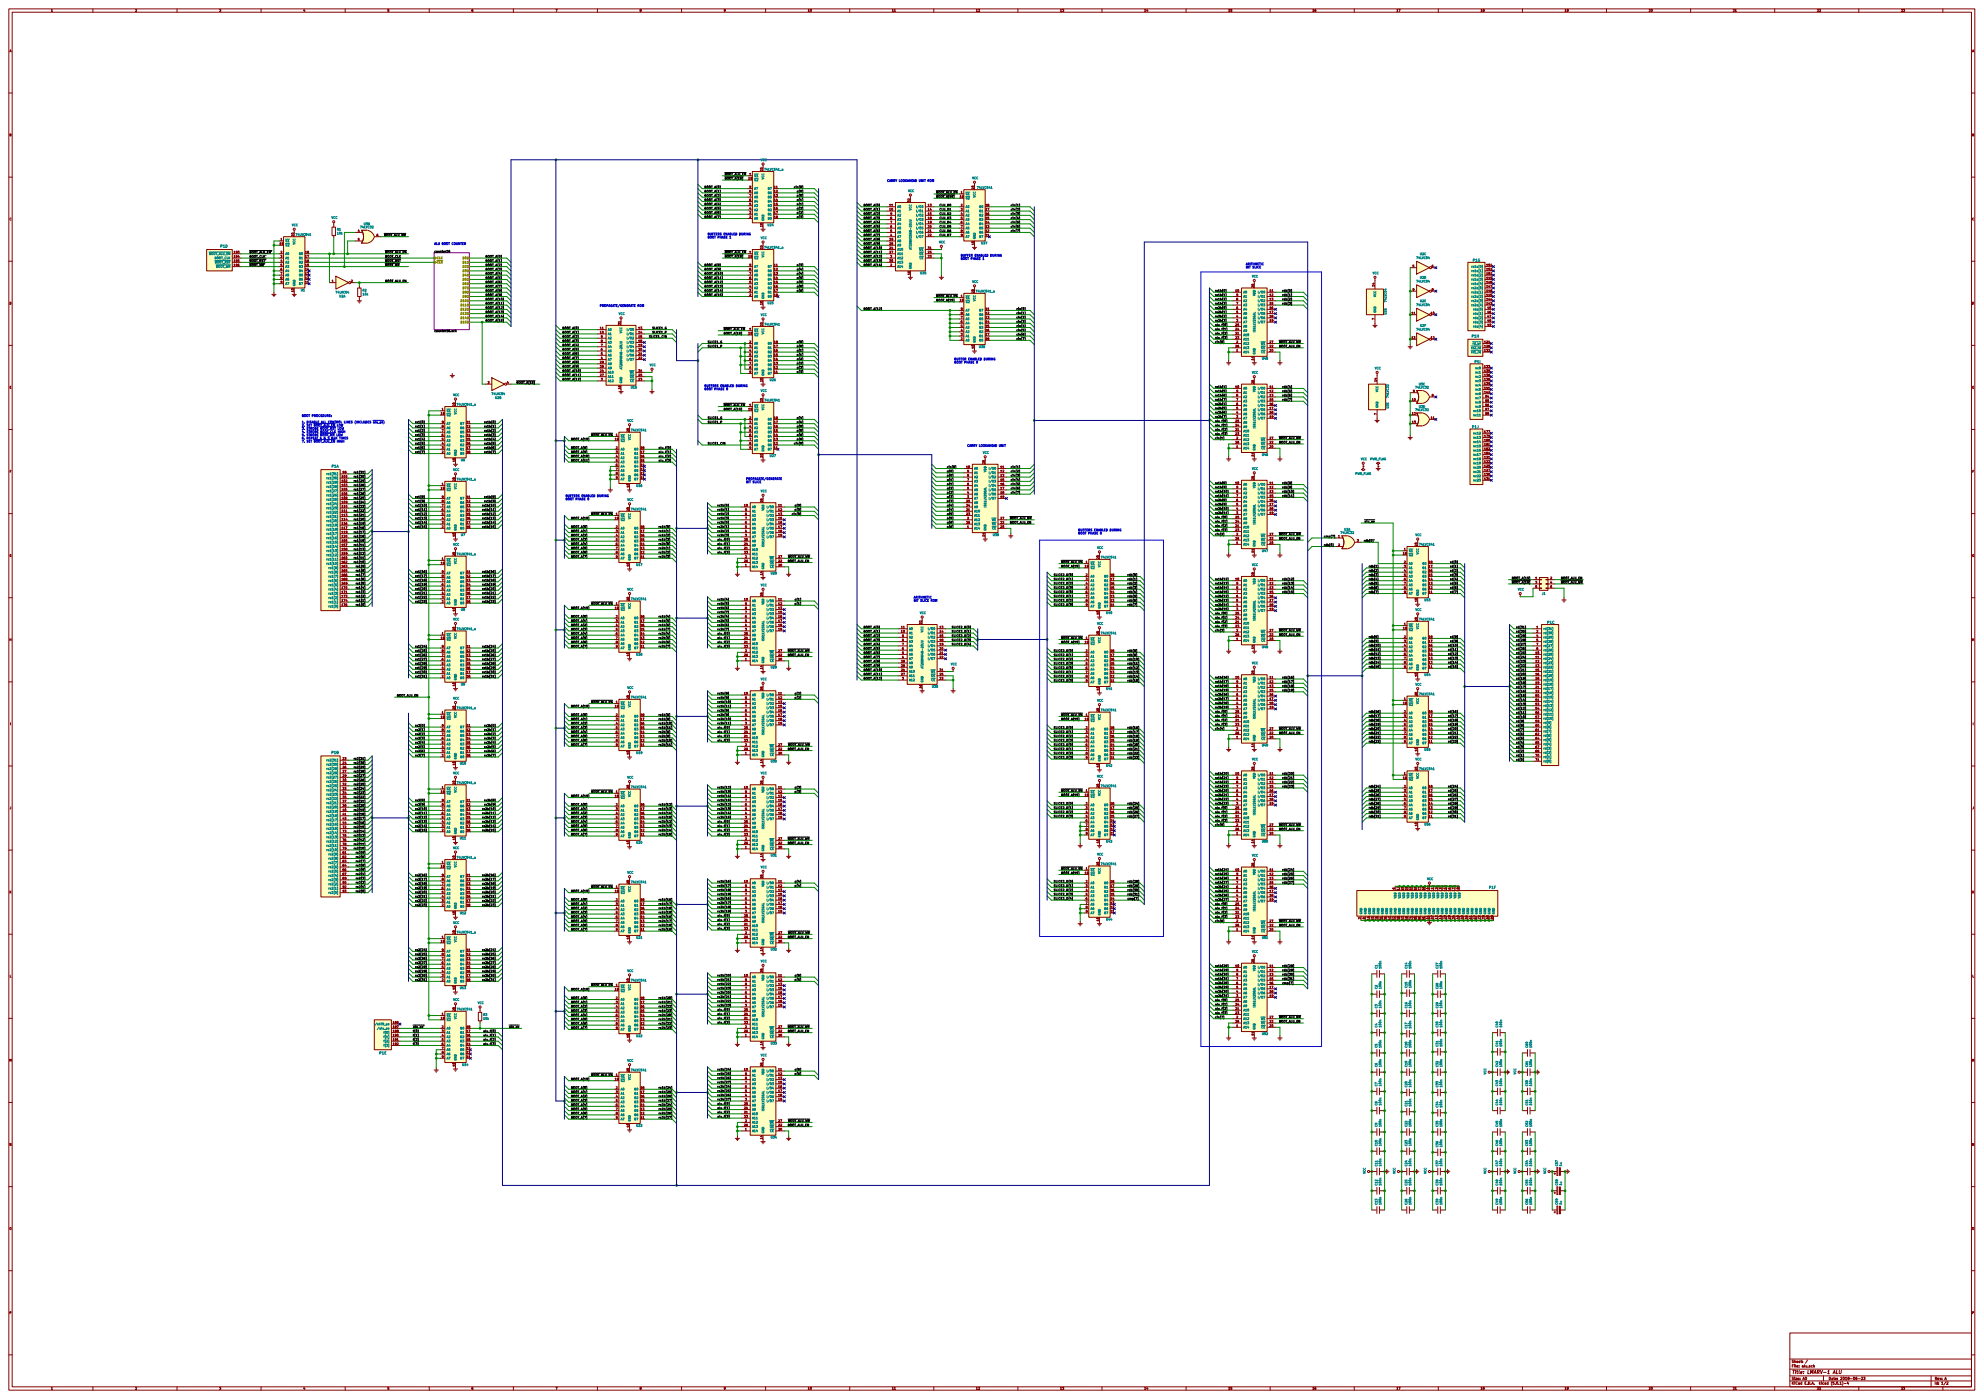
[picture p34: page 1]

CARRY LOOKAHEAD UNIT ROM

cin[6] BUFFER ENABLED DURING

BOOT PROCEDURE: 1. DISABLE ALL CONTROL LINES (INCLUDES alu_oe) 2. SET BOOT_ALU_EN LOW

Id: 1/2 Title: LMARV-1 ALU

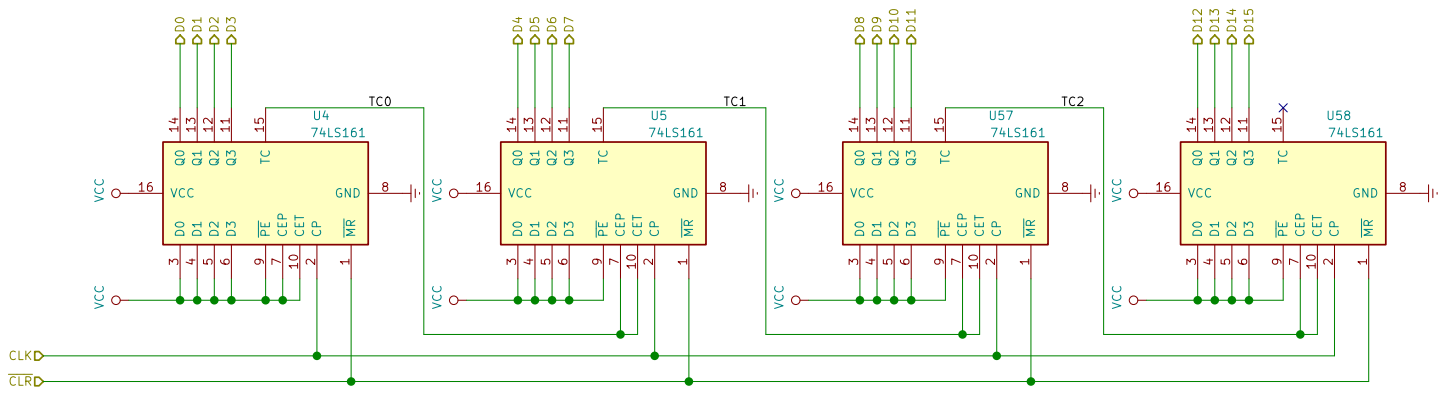
[picture p35: page 2]

Id: 2/2 Title: File: counter16.sch Sheet: /counter16/ MR
