RobertBaruch/lmarv/lmarv-1/alu/fabs/alu-B.Fab.pdf

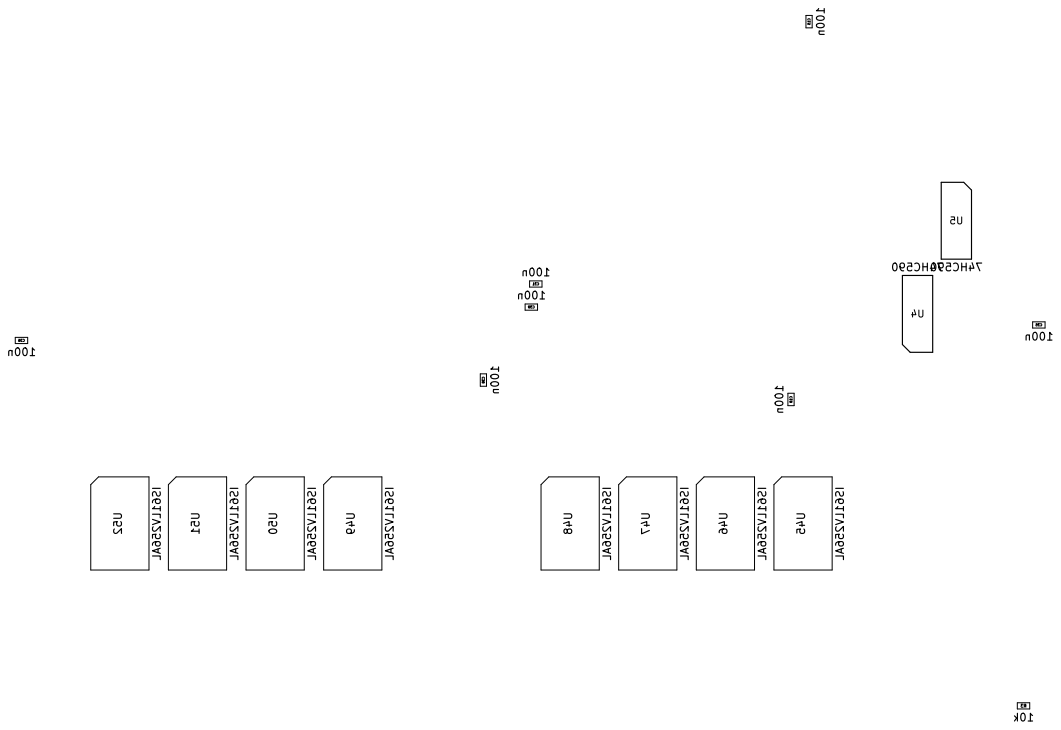
[picture p36: page 1]
