RobertBaruch/lmarv/lmarv-1/alu/fabs/alu-Edge.Cuts.pdf

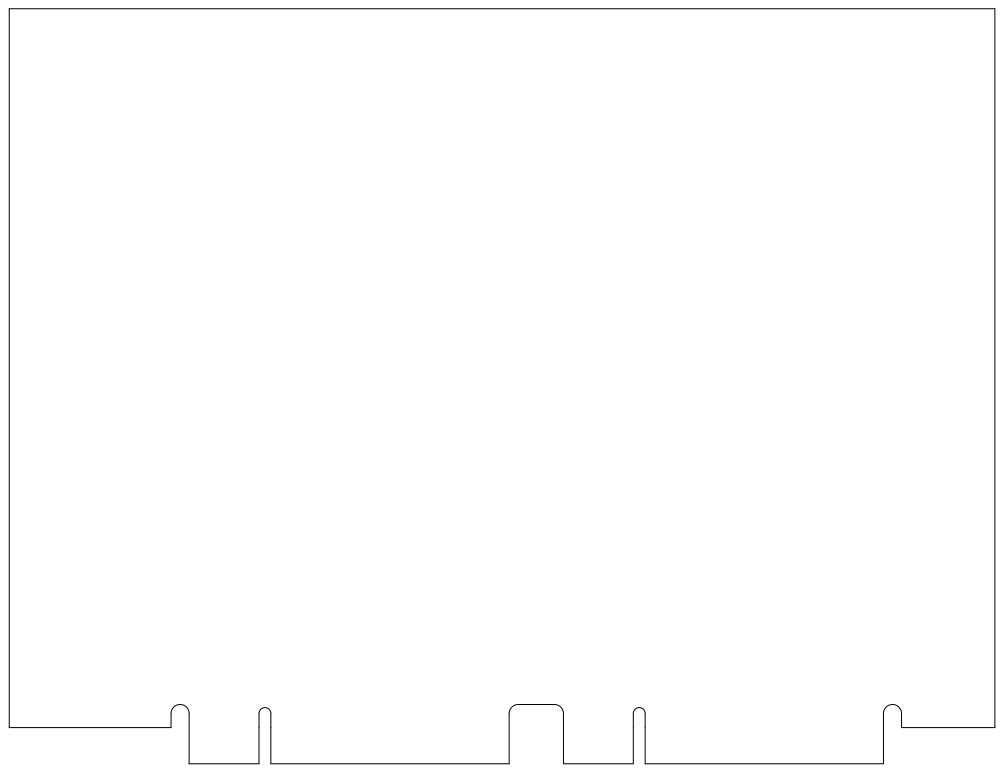
[picture p37: page 1]
