RobertBaruch/lmarv/lmarv-1/alu/fabs/alu-F.Fab.pdf

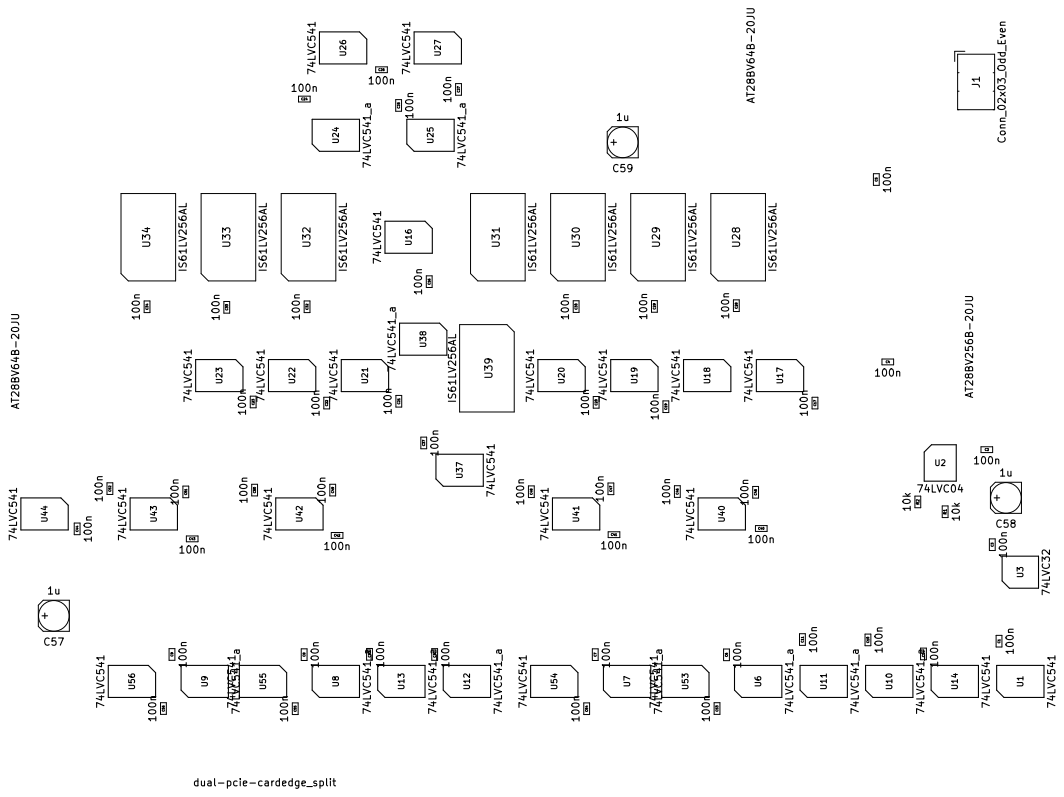
[picture p38: page 1]
