RobertBaruch/lmarv/lmarv-1/alu - v0/alu-schematic.pdf

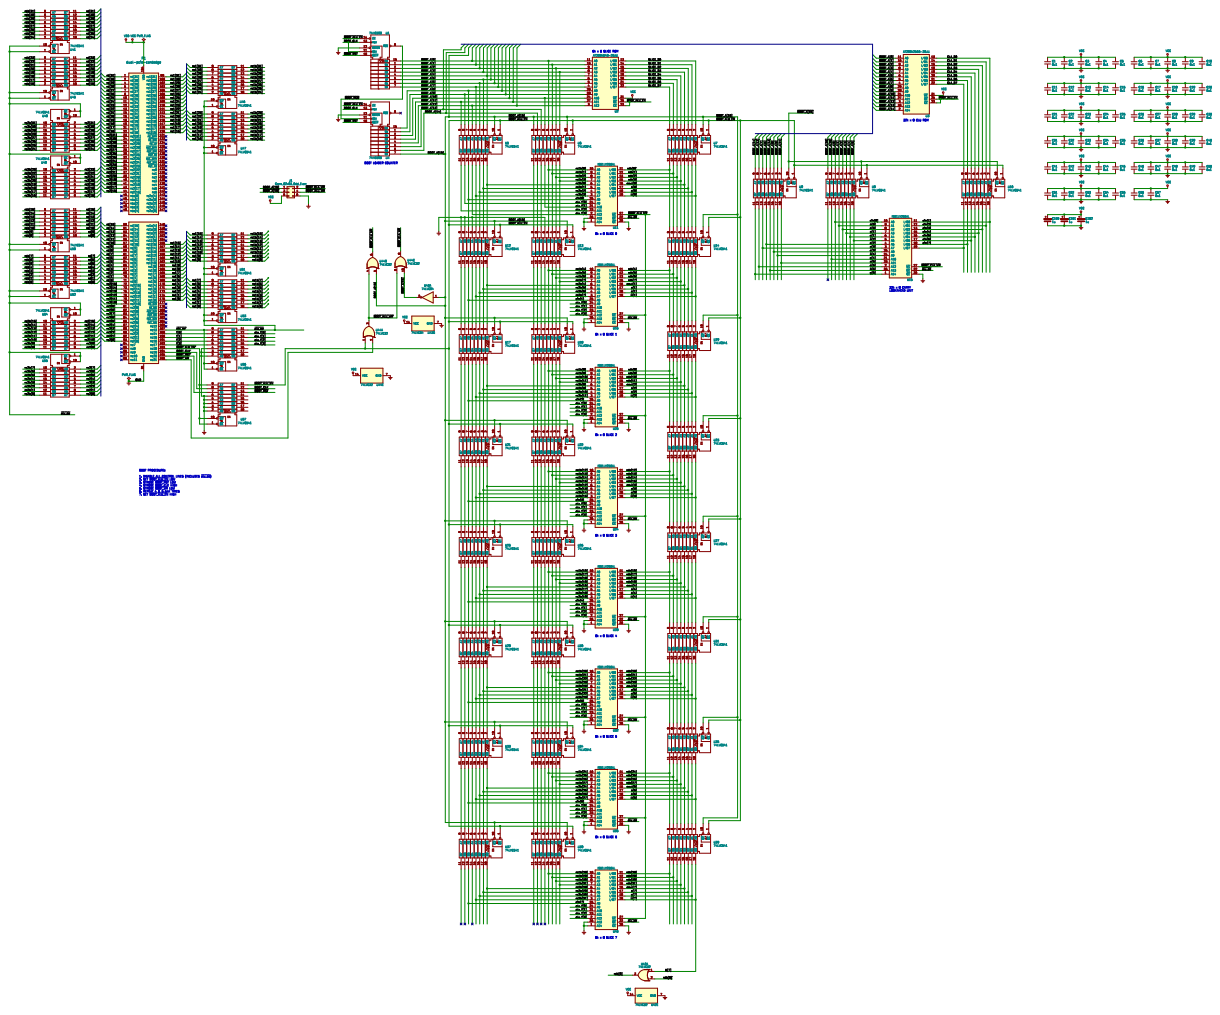
[picture p39: page 1]
