RobertBaruch/lmarv/lmarv-1/alu/alu.kicad_pcb

## KiCad design lmarv-1/alu/alu.kicad_pcb (2019-01-28)

Schematic: alu.sch, LMARV-1 ALU

Parts:
C1, C2, C3, C4, C5, C14, C15, C16, C24, C25, C26, C27, C28, C29, C30, C31, C32, C33, C34, C35, C36, C37, C38, C39, C40, C41, C42, C43, C44, C45, C46, C47, C48, C49, C50, C51, C52, C57, C58, C59: 100n; C_0603_1608Metric
C100, C101, C102: 1u; CP_Elec_4x4.5
D1, D2: APTD2012LSURCK; D_0805_Wide
P1: dual-pcie-cardedge_split; PCI-EXPRESS
R1, R2, R3, R4: 10k; R_0603_1608Metric
R5, R6: 3k3; R_0603_1608Metric
U1, U14, U16, U26, U27, U37, U40, U41, U42, U43, U44: 74LVC541; TSSOP-20_4.4x6.5mm_P0.65mm
U2: 74LVC04; TSSOP-14_4.4x5mm_P0.65mm
U3: 74LVC32; TSSOP-14_4.4x5mm_P0.65mm
U15: AT28BV64B-20JU; PLCC-32_THT-Socket
U24, U25, U38: 74LVC541_a; TSSOP-20_4.4x6.5mm_P0.65mm
U28, U29, U30, U31, U32, U33, U34, U39, U45, U46, U47, U48, U49, U50, U51, U52: IS61LV256AL; TSOP-I-28_18.4x8mm_Pitch0.55mm
U35: AT28BV256B-20JU; PLCC32
U36: AT28BV64B-20JU; PLCC32
U59: 74LS157; TSSOP-16_4.4x5mm_P0.65mm

Connections:
/BOOT_A[0]: U15.11 (A0), U24.9 (A7), U35.11 (A0), U36.11 (A0); also elsewhere on the board
/BOOT_A[1]: U15.10 (A1), U24.8 (A6), U35.10 (A1), U36.10 (A1); also elsewhere on the board
/BOOT_A[2]: U15.9 (A2), U24.7 (A5), U35.9 (A2), U36.9 (A2); also elsewhere on the board
/BOOT_A[3]: U15.8 (A3), U24.6 (A4), U35.8 (A3), U36.8 (A3); also elsewhere on the board
/BOOT_A[4]: U15.7 (A4), U24.5 (A3), U35.7 (A4), U36.7 (A4); also elsewhere on the board
/BOOT_A[5]: U15.6 (A5), U24.4 (A2), U35.6 (A5), U36.6 (A5); also elsewhere on the board
/BOOT_A[6]: U15.5 (A6), U24.3 (A1), U35.5 (A6), U36.5 (A6); also elsewhere on the board
/BOOT_A[7]: U15.4 (A7), U24.2 (A0), U35.4 (A7), U36.4 (A7); also elsewhere on the board
/BOOT_A[8]: U15.29 (A8), U16.2 (A0), U25.9 (A7), U35.29 (A8), U36.29 (A8); also elsewhere on the board
/BOOT_A[9]: U15.28 (A9), U16.3 (A1), U25.8 (A6), U35.28 (A9), U36.28 (A9); also elsewhere on the board
/BOOT_A[10]: U15.24 (A10), U16.4 (A2), U25.7 (A5), U35.24 (A10), U36.24 (A10); also elsewhere on the board
/BOOT_A[11]: U15.27 (A11), U16.5 (A3), U25.6 (A4), U35.27 (A11), U36.27 (A11); also elsewhere on the board
/BOOT_A[12]: U15.3 (A12), U25.5 (A3), U35.3 (A12), U36.3 (A12), U38.2 (A0), U38.3 (A1), U38.4 (A2), U38.5 (A3), U38.6 (A4), U38.7 (A5), U38.8 (A6), U38.9 (A7); also elsewhere on the board
/BOOT_A[13]: U25.4 (A2), U35.30 (A13); also elsewhere on the board
/BOOT_A[14]: U25.3 (A1), U35.2 (A14); also elsewhere on the board
/BOOT_A[15]: U2.3, U3.12, U16.19 (~G2), U25.2 (A0), U26.19 (~G2), U27.19 (~G2), U38.19 (~G2), U40.19 (~G2), U41.19 (~G2), U42.19 (~G2), U43.19 (~G2), U44.19 (~G2); also elsewhere on the board
/BOOT_CLK: U1.17 (B1); also elsewhere on the board
/BOOT_CLK': P1.194 (BOOT_CLK), U1.3 (A1)
/CLU_D0: U35.13 (I/O0), U37.2 (A0)
/CLU_D1: U35.14 (I/O1), U37.3 (A1)
/CLU_D2: U35.15 (I/O2), U37.4 (A2)
/CLU_D3: U35.18 (I/O3), U37.5 (A3)
/CLU_D4: U35.19 (I/O4), U37.6 (A4)
/CLU_D5: U35.20 (I/O5), U37.7 (A5)
/CLU_D6: U35.21 (I/O6), U37.8 (A6)
/CLU_D7: U35.22 (I/O7), U37.9 (A7)
/SLICE1_CIN: U15.15 (I/O2), U27.8 (A6)
/SLICE1_G: U15.13 (I/O0), U26.2 (A0), U26.4 (A2), U26.6 (A4), U26.8 (A6), U27.2 (A0), U27.4 (A2), U27.6 (A4)
/SLICE1_P: U15.14 (I/O1), U26.3 (A1), U26.5 (A3), U26.7 (A5), U26.9 (A7), U27.3 (A1), U27.5 (A3), U27.7 (A5), U27.9 (A7)
/SLICE2_D[0]: U36.13 (I/O0), U40.2 (A0), U40.6 (A4), U41.2 (A0), U41.6 (A4), U42.2 (A0), U42.6 (A4), U43.2 (A0), U44.2 (A0)
/SLICE2_D[1]: U36.14 (I/O1), U40.3 (A1), U40.7 (A5), U41.3 (A1), U41.7 (A5), U42.3 (A1), U42.7 (A5), U43.3 (A1), U44.3 (A1)
/SLICE2_D[2]: U36.15 (I/O2), U40.4 (A2), U40.8 (A6), U41.4 (A2), U41.8 (A6), U42.4 (A2), U42.8 (A6), U43.4 (A2), U44.4 (A2)
/SLICE2_D[3]: U36.18 (I/O3), U40.5 (A3), U40.9 (A7), U41.5 (A3), U41.9 (A7), U42.5 (A3), U42.9 (A7), U43.5 (A3), U44.5 (A3)
/SLICE2_D[4]: U36.19 (I/O4), U44.6 (A4)
/alu_f[0]: U14.17 (B1), U16.18 (B0), U28.25 (A8), U29.25 (A8), U30.25 (A8), U31.25 (A8), U32.25 (A8), U33.25 (A8), U34.25 (A8), U45.25 (A8), U46.25 (A8), U47.25 (A8), U48.25 (A8), U49.25 (A8), U50.25 (A8), U51.25 (A8), U52.25 (A8)
/alu_f[1]: U14.16 (B2), U16.17 (B1), U28.24 (A9), U29.24 (A9), U30.24 (A9), U31.24 (A9), U32.24 (A9), U33.24 (A9), U34.24 (A9), U45.24 (A9), U46.24 (A9), U47.24 (A9), U48.24 (A9), U49.24 (A9), U50.24 (A9), U51.24 (A9), U52.24 (A9)
/alu_f[2]: U14.15 (B3), U16.16 (B2), U28.21 (A10), U29.21 (A10), U30.21 (A10), U31.21 (A10), U32.21 (A10), U33.21 (A10), U34.21 (A10), U45.21 (A10), U46.21 (A10), U47.21 (A10), U48.21 (A10), U49.21 (A10), U50.21 (A10), U51.21 (A10), U52.21 (A10)
/alu_f[3]: U14.14 (B4), U16.15 (B3), U28.23 (A11), U29.23 (A11), U30.23 (A11), U31.23 (A11), U32.23 (A11), U33.23 (A11), U34.23 (A11), U45.23 (A11), U46.23 (A11), U47.23 (A11), U48.23 (A11), U49.23 (A11), U50.23 (A11), U51.23 (A11), U52.23 (A11)
/cin0': U45.2 (A12), U59.4 (Za)
/cin0_boot: R4.1, U38.11 (B7), U59.3 (I1a)
/cin[0]: U24.11 (B7), U27.12 (B6), U28.13 (I/O2), U39.10 (A0), U59.2 (I0a)
/cin[1]: U37.18 (B0), U38.12 (B6), U39.11 (I/O0), U46.2 (A12)
/cin[2]: U37.17 (B1), U38.13 (B5), U39.12 (I/O1), U47.2 (A12)
/cin[3]: U37.16 (B2), U38.14 (B4), U39.13 (I/O2), U48.2 (A12)
/cin[4]: U37.15 (B3), U38.15 (B3), U39.15 (I/O3), U49.2 (A12)
/cin[5]: U37.14 (B4), U38.16 (B2), U39.16 (I/O4), U50.2 (A12)
/cin[6]: U37.13 (B5), U38.17 (B1), U39.17 (I/O5), U51.2 (A12)
/cin[7]: U37.12 (B6), U38.18 (B0), U39.18 (I/O6), U52.2 (A12)
/cmp[7]: U3.1, U44.14 (B4), U52.16 (I/O4)
/f[0]: P1.188 (f[0]), U14.3 (A1)
/f[1]: P1.190 (f[1]), U14.4 (A2)
/f[2]: P1.191 (f[2]), U14.5 (A3)
/f[3]: P1.192 (f[3]), U14.6 (A4)
/g[0]: U24.12 (B6), U26.18 (B0), U28.11 (I/O0), U39.9 (A1)
/g[1]: U24.14 (B4), U26.16 (B2), U29.11 (I/O0), U39.7 (A3)
/g[2]: U24.16 (B2), U26.14 (B4), U30.11 (I/O0), U39.5 (A5)
/g[3]: U24.18 (B0), U26.12 (B6), U31.11 (I/O0), U39.3 (A7)
/g[4]: U25.12 (B6), U27.18 (B0), U32.11 (I/O0), U39.24 (A9)
/g[5]: U25.14 (B4), U27.16 (B2), U33.11 (I/O0), U39.23 (A11)
/g[6]: U25.16 (B2), U27.14 (B4), U34.11 (I/O0), U39.26 (A13)
/p[0]: U24.13 (B5), U26.17 (B1), U28.12 (I/O1), U39.8 (A2)
/p[1]: U24.15 (B3), U26.15 (B3), U29.12 (I/O1), U39.6 (A4)
/p[2]: U24.17 (B1), U26.13 (B5), U30.12 (I/O1), U39.4 (A6)
/p[3]: U25.11 (B7), U26.11 (B7), U31.12 (I/O1), U39.25 (A8)
/p[4]: U25.13 (B5), U27.17 (B1), U32.12 (I/O1), U39.21 (A10)
/p[5]: U25.15 (B3), U27.15 (B3), U33.12 (I/O1), U39.2 (A12)
/p[6]: U25.17 (B1), U27.13 (B5), U34.12 (I/O1), U39.1 (A14)
/rd[0]: P1.71 (rd[0]); also elsewhere on the board
/rd[1]: P1.70 (rd[1]); also elsewhere on the board
/rd[2]: P1.68 (rd[2]); also elsewhere on the board
/rd[3]: P1.67 (rd[3]); also elsewhere on the board
/rd[4]: P1.65 (rd[4]); also elsewhere on the board
/rd[5]: P1.64 (rd[5]); also elsewhere on the board
/rd[6]: P1.62 (rd[6]); also elsewhere on the board
/rd[7]: P1.61 (rd[7]); also elsewhere on the board
/rd[8]: P1.60 (rd[8]); also elsewhere on the board
/rd[9]: P1.59 (rd[9]); also elsewhere on the board
/rd[10]: P1.57 (rd[10]); also elsewhere on the board
/rd[11]: P1.56 (rd[11]); also elsewhere on the board
/rd[12]: P1.54 (rd[12]); also elsewhere on the board
/rd[13]: P1.53 (rd[13]); also elsewhere on the board
/rd[14]: P1.51 (rd[14]); also elsewhere on the board
/rd[15]: P1.50 (rd[15]); also elsewhere on the board
/rd[16]: P1.22 (rd[16]); also elsewhere on the board
/rd[17]: P1.21 (rd[17]); also elsewhere on the board
/rd[18]: P1.19 (rd[18]); also elsewhere on the board
/rd[19]: P1.18 (rd[19]); also elsewhere on the board
/rd[20]: P1.16 (rd[20]); also elsewhere on the board
/rd[21]: P1.15 (rd[21]); also elsewhere on the board
/rd[22]: P1.13 (rd[22]); also elsewhere on the board
/rd[23]: P1.12 (rd[23]); also elsewhere on the board
/rd[24]: P1.11 (rd[24]); also elsewhere on the board
/rd[25]: P1.10 (rd[25]); also elsewhere on the board
/rd[26]: P1.8 (rd[26]); also elsewhere on the board
/rd[27]: P1.7 (rd[27]); also elsewhere on the board
/rd[28]: P1.5 (rd[28]); also elsewhere on the board
/rd[29]: P1.4 (rd[29]); also elsewhere on the board
/rd[30]: P1.2 (rd[30]); also elsewhere on the board
/rd[31]: P1.1 (rd[31]); also elsewhere on the board
/rdb[0]: U3.2, U40.18 (B0), U45.11 (I/O0)
/rdb[0]': U3.3; also elsewhere on the board
/rdb[1]: U40.17 (B1), U45.12 (I/O1); also elsewhere on the board
/rdb[2]: U40.16 (B2), U45.13 (I/O2); also elsewhere on the board
/rdb[3]: U40.15 (B3), U45.15 (I/O3); also elsewhere on the board
/rdb[4]: U40.14 (B4), U46.11 (I/O0); also elsewhere on the board
/rdb[5]: U40.13 (B5), U46.12 (I/O1); also elsewhere on the board
/rdb[6]: U40.12 (B6), U46.13 (I/O2); also elsewhere on the board
/rdb[7]: U40.11 (B7), U46.15 (I/O3); also elsewhere on the board
/rdb[8]: U41.18 (B0), U47.11 (I/O0); also elsewhere on the board
/rdb[9]: U41.17 (B1), U47.12 (I/O1); also elsewhere on the board
/rdb[10]: U41.16 (B2), U47.13 (I/O2); also elsewhere on the board
/rdb[11]: U41.15 (B3), U47.15 (I/O3); also elsewhere on the board
/rdb[12]: U41.14 (B4), U48.11 (I/O0); also elsewhere on the board
/rdb[13]: U41.13 (B5), U48.12 (I/O1); also elsewhere on the board
/rdb[14]: U41.12 (B6), U48.13 (I/O2); also elsewhere on the board
/rdb[15]: U41.11 (B7), U48.15 (I/O3); also elsewhere on the board
/rdb[16]: U42.18 (B0), U49.11 (I/O0); also elsewhere on the board
/rdb[17]: U42.17 (B1), U49.12 (I/O1); also elsewhere on the board
/rdb[18]: U42.16 (B2), U49.13 (I/O2); also elsewhere on the board
/rdb[19]: U42.15 (B3), U49.15 (I/O3); also elsewhere on the board
/rdb[20]: U42.14 (B4), U50.11 (I/O0); also elsewhere on the board
/rdb[21]: U42.13 (B5), U50.12 (I/O1); also elsewhere on the board
/rdb[22]: U42.12 (B6), U50.13 (I/O2); also elsewhere on the board
/rdb[23]: U42.11 (B7), U50.15 (I/O3); also elsewhere on the board
/rdb[24]: U43.18 (B0), U51.11 (I/O0); also elsewhere on the board
/rdb[25]: U43.17 (B1), U51.12 (I/O1); also elsewhere on the board
/rdb[26]: U43.16 (B2), U51.13 (I/O2); also elsewhere on the board
/rdb[27]: U43.15 (B3), U51.15 (I/O3); also elsewhere on the board
/rdb[28]: U44.18 (B0), U52.11 (I/O0); also elsewhere on the board
/rdb[29]: U44.17 (B1), U52.12 (I/O1); also elsewhere on the board
/rdb[30]: U44.16 (B2), U52.13 (I/O2); also elsewhere on the board
/rdb[31]: U44.15 (B3), U52.15 (I/O3); also elsewhere on the board
/rs1[0]: P1.176 (rs1[0]); also elsewhere on the board
/rs1[1]: P1.174 (rs1[1]); also elsewhere on the board
/rs1[2]: P1.173 (rs1[2]); also elsewhere on the board
/rs1[3]: P1.171 (rs1[3]); also elsewhere on the board
/rs1[4]: P1.170 (rs1[4]); also elsewhere on the board
/rs1[5]: P1.169 (rs1[5]); also elsewhere on the board
/rs1[6]: P1.168 (rs1[6]); also elsewhere on the board
/rs1[7]: P1.166 (rs1[7]); also elsewhere on the board
/rs1[8]: P1.165 (rs1[8]); also elsewhere on the board
/rs1[9]: P1.163 (rs1[9]); also elsewhere on the board
/rs1[10]: P1.162 (rs1[10]); also elsewhere on the board
/rs1[11]: P1.160 (rs1[11]); also elsewhere on the board
/rs1[12]: P1.159 (rs1[12]); also elsewhere on the board
/rs1[13]: P1.158 (rs1[13]); also elsewhere on the board
/rs1[14]: P1.157 (rs1[14]); also elsewhere on the board
/rs1[15]: P1.155 (rs1[15]); also elsewhere on the board
/rs1[16]: P1.120 (rs1[16]); also elsewhere on the board
/rs1[17]: P1.119 (rs1[17]); also elsewhere on the board
/rs1[18]: P1.117 (rs1[18]); also elsewhere on the board
/rs1[19]: P1.116 (rs1[19]); also elsewhere on the board
/rs1[20]: P1.114 (rs1[20]); also elsewhere on the board
/rs1[21]: P1.113 (rs1[21]); also elsewhere on the board
/rs1[22]: P1.111 (rs1[22]); also elsewhere on the board
/rs1[23]: P1.110 (rs1[23]); also elsewhere on the board
/rs1[24]: P1.109 (rs1[24]); also elsewhere on the board
/rs1[25]: P1.108 (rs1[25]); also elsewhere on the board
/rs1[26]: P1.106 (rs1[26]); also elsewhere on the board
/rs1[27]: P1.105 (rs1[27]); also elsewhere on the board
/rs1[28]: P1.103 (rs1[28]); also elsewhere on the board
/rs1[29]: P1.102 (rs1[29]); also elsewhere on the board
/rs1[30]: P1.100 (rs1[30]); also elsewhere on the board
/rs1[31]: P1.99 (rs1[31]); also elsewhere on the board
/rs1b[0]: U28.10 (A0), U45.10 (A0); also elsewhere on the board
/rs1b[1]: U28.9 (A1), U45.9 (A1); also elsewhere on the board
/rs1b[2]: U28.8 (A2), U45.8 (A2); also elsewhere on the board
/rs1b[3]: U28.7 (A3), U45.7 (A3); also elsewhere on the board
/rs1b[4]: U29.10 (A0), U46.10 (A0); also elsewhere on the board
/rs1b[5]: U29.9 (A1), U46.9 (A1); also elsewhere on the board
/rs1b[6]: U29.8 (A2), U46.8 (A2); also elsewhere on the board
/rs1b[7]: U29.7 (A3), U46.7 (A3); also elsewhere on the board
/rs1b[8]: U30.10 (A0), U47.10 (A0); also elsewhere on the board
/rs1b[9]: U30.9 (A1), U47.9 (A1); also elsewhere on the board
/rs1b[10]: U30.8 (A2), U47.8 (A2); also elsewhere on the board
/rs1b[11]: U30.7 (A3), U47.7 (A3); also elsewhere on the board
/rs1b[12]: U31.10 (A0), U48.10 (A0); also elsewhere on the board
/rs1b[13]: U31.9 (A1), U48.9 (A1); also elsewhere on the board
/rs1b[14]: U31.8 (A2), U48.8 (A2); also elsewhere on the board
/rs1b[15]: U31.7 (A3), U48.7 (A3); also elsewhere on the board
/rs1b[16]: U32.10 (A0), U49.10 (A0); also elsewhere on the board
/rs1b[17]: U32.9 (A1), U49.9 (A1); also elsewhere on the board
/rs1b[18]: U32.8 (A2), U49.8 (A2); also elsewhere on the board
/rs1b[19]: U32.7 (A3), U49.7 (A3); also elsewhere on the board
/rs1b[20]: U33.10 (A0), U50.10 (A0); also elsewhere on the board
/rs1b[21]: U33.9 (A1), U50.9 (A1); also elsewhere on the board
/rs1b[22]: U33.8 (A2), U50.8 (A2); also elsewhere on the board
/rs1b[23]: U33.7 (A3), U50.7 (A3); also elsewhere on the board
/rs1b[24]: U34.10 (A0), U51.10 (A0); also elsewhere on the board
/rs1b[25]: U34.9 (A1), U51.9 (A1); also elsewhere on the board
/rs1b[26]: U34.8 (A2), U51.8 (A2); also elsewhere on the board
/rs1b[27]: U34.7 (A3), U51.7 (A3); also elsewhere on the board
/rs1b[28]: U52.10 (A0); also elsewhere on the board
/rs1b[29]: U52.9 (A1); also elsewhere on the board
/rs1b[30]: U52.8 (A2); also elsewhere on the board
/rs1b[31]: U52.7 (A3); also elsewhere on the board
/rs2[0]: P1.93 (rs2[0]); also elsewhere on the board
/rs2[1]: P1.92 (rs2[1]); also elsewhere on the board
/rs2[2]: P1.90 (rs2[2]); also elsewhere on the board
/rs2[3]: P1.89 (rs2[3]); also elsewhere on the board
/rs2[4]: P1.87 (rs2[4]); also elsewhere on the board
/rs2[5]: P1.86 (rs2[5]); also elsewhere on the board
/rs2[6]: P1.84 (rs2[6]); also elsewhere on the board
/rs2[7]: P1.83 (rs2[7]); also elsewhere on the board
/rs2[8]: P1.82 (rs2[8]); also elsewhere on the board
/rs2[9]: P1.81 (rs2[9]); also elsewhere on the board
/rs2[10]: P1.79 (rs2[10]); also elsewhere on the board
/rs2[11]: P1.78 (rs2[11]); also elsewhere on the board
/rs2[12]: P1.76 (rs2[12]); also elsewhere on the board
/rs2[13]: P1.75 (rs2[13]); also elsewhere on the board
/rs2[14]: P1.73 (rs2[14]); also elsewhere on the board
/rs2[15]: P1.72 (rs2[15]); also elsewhere on the board
/rs2[16]: P1.44 (rs2[16]); also elsewhere on the board
/rs2[17]: P1.43 (rs2[17]); also elsewhere on the board
/rs2[18]: P1.41 (rs2[18]); also elsewhere on the board
/rs2[19]: P1.40 (rs2[19]); also elsewhere on the board
/rs2[20]: P1.38 (rs2[20]); also elsewhere on the board
/rs2[21]: P1.37 (rs2[21]); also elsewhere on the board
/rs2[22]: P1.35 (rs2[22]); also elsewhere on the board
/rs2[23]: P1.34 (rs2[23]); also elsewhere on the board
/rs2[24]: P1.33 (rs2[24]); also elsewhere on the board
/rs2[25]: P1.32 (rs2[25]); also elsewhere on the board
/rs2[26]: P1.30 (rs2[26]); also elsewhere on the board
/rs2[27]: P1.29 (rs2[27]); also elsewhere on the board
/rs2[28]: P1.27 (rs2[28]); also elsewhere on the board
/rs2[29]: P1.26 (rs2[29]); also elsewhere on the board
/rs2[30]: P1.24 (rs2[30]); also elsewhere on the board
/rs2[31]: P1.23 (rs2[31]); also elsewhere on the board
/rs2b[0]: U28.6 (A4), U45.6 (A4); also elsewhere on the board
/rs2b[1]: U28.5 (A5), U45.5 (A5); also elsewhere on the board
/rs2b[2]: U28.4 (A6), U45.4 (A6); also elsewhere on the board
/rs2b[3]: U28.3 (A7), U45.3 (A7); also elsewhere on the board
/rs2b[4]: U29.6 (A4), U46.6 (A4); also elsewhere on the board
/rs2b[5]: U29.5 (A5), U46.5 (A5); also elsewhere on the board
/rs2b[6]: U29.4 (A6), U46.4 (A6); also elsewhere on the board
/rs2b[7]: U29.3 (A7), U46.3 (A7); also elsewhere on the board
/rs2b[8]: U30.6 (A4), U47.6 (A4); also elsewhere on the board
/rs2b[9]: U30.5 (A5), U47.5 (A5); also elsewhere on the board
/rs2b[10]: U30.4 (A6), U47.4 (A6); also elsewhere on the board
/rs2b[11]: U30.3 (A7), U47.3 (A7); also elsewhere on the board
/rs2b[12]: U31.6 (A4), U48.6 (A4); also elsewhere on the board
/rs2b[13]: U31.5 (A5), U48.5 (A5); also elsewhere on the board
/rs2b[14]: U31.4 (A6), U48.4 (A6); also elsewhere on the board
/rs2b[15]: U31.3 (A7), U48.3 (A7); also elsewhere on the board
/rs2b[16]: U32.6 (A4), U49.6 (A4); also elsewhere on the board
/rs2b[17]: U32.5 (A5), U49.5 (A5); also elsewhere on the board
/rs2b[18]: U32.4 (A6), U49.4 (A6); also elsewhere on the board
/rs2b[19]: U32.3 (A7), U49.3 (A7); also elsewhere on the board
/rs2b[20]: U33.6 (A4), U50.6 (A4); also elsewhere on the board
/rs2b[21]: U33.5 (A5), U50.5 (A5); also elsewhere on the board
/rs2b[22]: U33.4 (A6), U50.4 (A6); also elsewhere on the board
/rs2b[23]: U33.3 (A7), U50.3 (A7); also elsewhere on the board
/rs2b[24]: U34.6 (A4), U51.6 (A4); also elsewhere on the board
/rs2b[25]: U34.5 (A5), U51.5 (A5); also elsewhere on the board
/rs2b[26]: U34.4 (A6), U51.4 (A6); also elsewhere on the board
/rs2b[27]: U34.3 (A7), U51.3 (A7); also elsewhere on the board
/rs2b[28]: U52.6 (A4); also elsewhere on the board
/rs2b[29]: U52.5 (A5); also elsewhere on the board
/rs2b[30]: U52.4 (A6); also elsewhere on the board
/rs2b[31]: U52.3 (A7); also elsewhere on the board
/~BOOT_ALU_EN: R1.2, U1.18 (B0), U2.1, U3.5, U16.1 (~G1), U24.1 (~G1), U25.1 (~G1), U26.1 (~G1), U27.1 (~G1), U37.1 (~G1), U38.1 (~G1), U40.1 (~G1), U41.1 (~G1), U42.1 (~G1), U43.1 (~G1), U44.1 (~G1); also elsewhere on the board
/~BOOT_ALU_EN': P1.193 (~BOOT_ALU_EN), U1.2 (A0)
/~BOOT_ALU_WR: U3.6, U3.10, U3.13
/~BOOT_A[15]: U2.4, U3.9, U24.19 (~G2), U25.19 (~G2), U37.19 (~G2)
/~BOOT_PH0_WR: U3.11, U28.27 (~WE), U29.27 (~WE), U30.27 (~WE), U31.27 (~WE), U32.27 (~WE), U33.27 (~WE), U34.27 (~WE), U45.27 (~WE), U46.27 (~WE), U47.27 (~WE), U48.27 (~WE), U49.27 (~WE), U50.27 (~WE), U51.27 (~WE), U52.27 (~WE)
/~BOOT_PH1_WR: U3.8, U39.27 (~WE)
/~BOOT_RST': P1.195 (~BOOT_RST), U1.4 (A2)
/~BOOT_WR: U1.15 (B3), U3.4
/~BOOT_WR': P1.196 (~BOOT_WR), U1.5 (A3)
/~alu_oe: R3.2, U14.18 (B0); also elsewhere on the board
/~alu_oe': P1.187 (/alu_oe), U14.2 (A0), U14.7 (A5)
/~alu_oe_led: D2.1 (K), U14.13 (B5)
unnamed: D1.2 (A), R5.2
unnamed: D2.2 (A), R6.2

Notes on the sheet:
BOOT PROCEDURE: 1. DISABLE ALL CONTROL LINES (INCLUDES ~alu_oe~) 2. SET ~BOOT_ALU_EN~ LOW 3. STROBE ~BOOT_RST~ LOW 4. STROBE BOOT_CLK HIGH 5. STROBE ~BOOT_WR~ LOW 6. REPEAT 4 & 5 64K TIMES 7. SET ~BOOT_ALU_EN~ HIGH
BUFFERS ENABLED DURING BOOT PHASE 0
BUFFERS ENABLED DURING BOOT PHASE 1
BUFFER ENABLED DURING BOOT PHASE 1
CARRY LOOKAHEAD UNIT
ALU BOOT COUNTER
PROPAGATE/GENERATE BIT SLICE
ARITHMETIC BIT SLICE
BUFFER ENABLED DURING BOOT PHASE 0
CARRY LOOKAHEAD UNIT ROM
PROPAGATE/GENERATE ROM
ARITHMETIC BIT SLICE ROM
A15&~ALU_BOOT_WR~

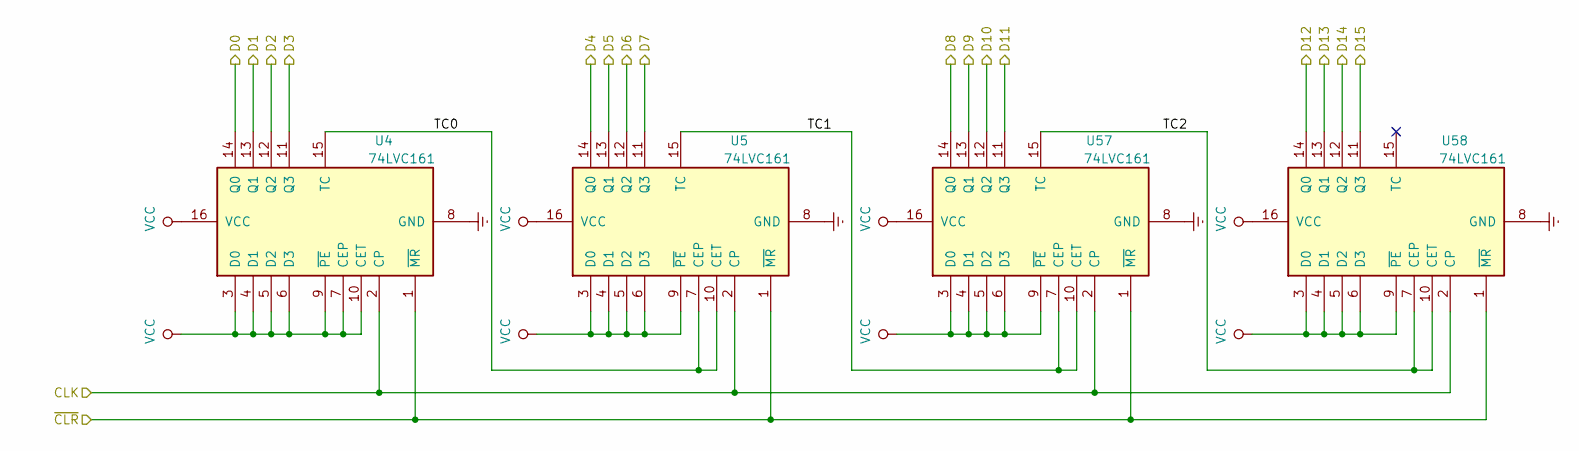
[picture p40: schematic counter16.sch]

Parts:
U4, U5, U57, U58: 74LVC161; TSSOP-16_4.4x5mm_P0.65mm

Connections:
/BOOT_A[0]: U4.14 (Q0); also elsewhere on the board
/BOOT_A[1]: U4.13 (Q1); also elsewhere on the board
/BOOT_A[2]: U4.12 (Q2); also elsewhere on the board
/BOOT_A[3]: U4.11 (Q3); also elsewhere on the board
/BOOT_A[4]: U5.14 (B4); also elsewhere on the board
/BOOT_A[5]: U5.13 (B5); also elsewhere on the board
/BOOT_A[6]: U5.12 (B6); also elsewhere on the board
/BOOT_A[7]: U5.11 (B7); also elsewhere on the board
/BOOT_A[8]: U57.14 (Q0); also elsewhere on the board
/BOOT_A[9]: U57.13 (Q1); also elsewhere on the board
/BOOT_A[10]: U57.12 (Q2); also elsewhere on the board
/BOOT_A[11]: U57.11 (Q3); also elsewhere on the board
/BOOT_A[12]: U58.14 (Q0); also elsewhere on the board
/BOOT_A[13]: U58.13 (Q1); also elsewhere on the board
/BOOT_A[14]: U58.12 (Q2); also elsewhere on the board
/BOOT_A[15]: U58.11 (Q3); also elsewhere on the board
/BOOT_CLK: U4.2 (CP), U5.2 (A0), U57.2 (CP), U58.2 (CP); also elsewhere on the board
/counter16/TC1: U5.15 (B3), U57.7 (CEP), U57.10 (CET)
/counter16/TC2: U57.15 (TC), U58.7 (CEP), U58.10 (CET)

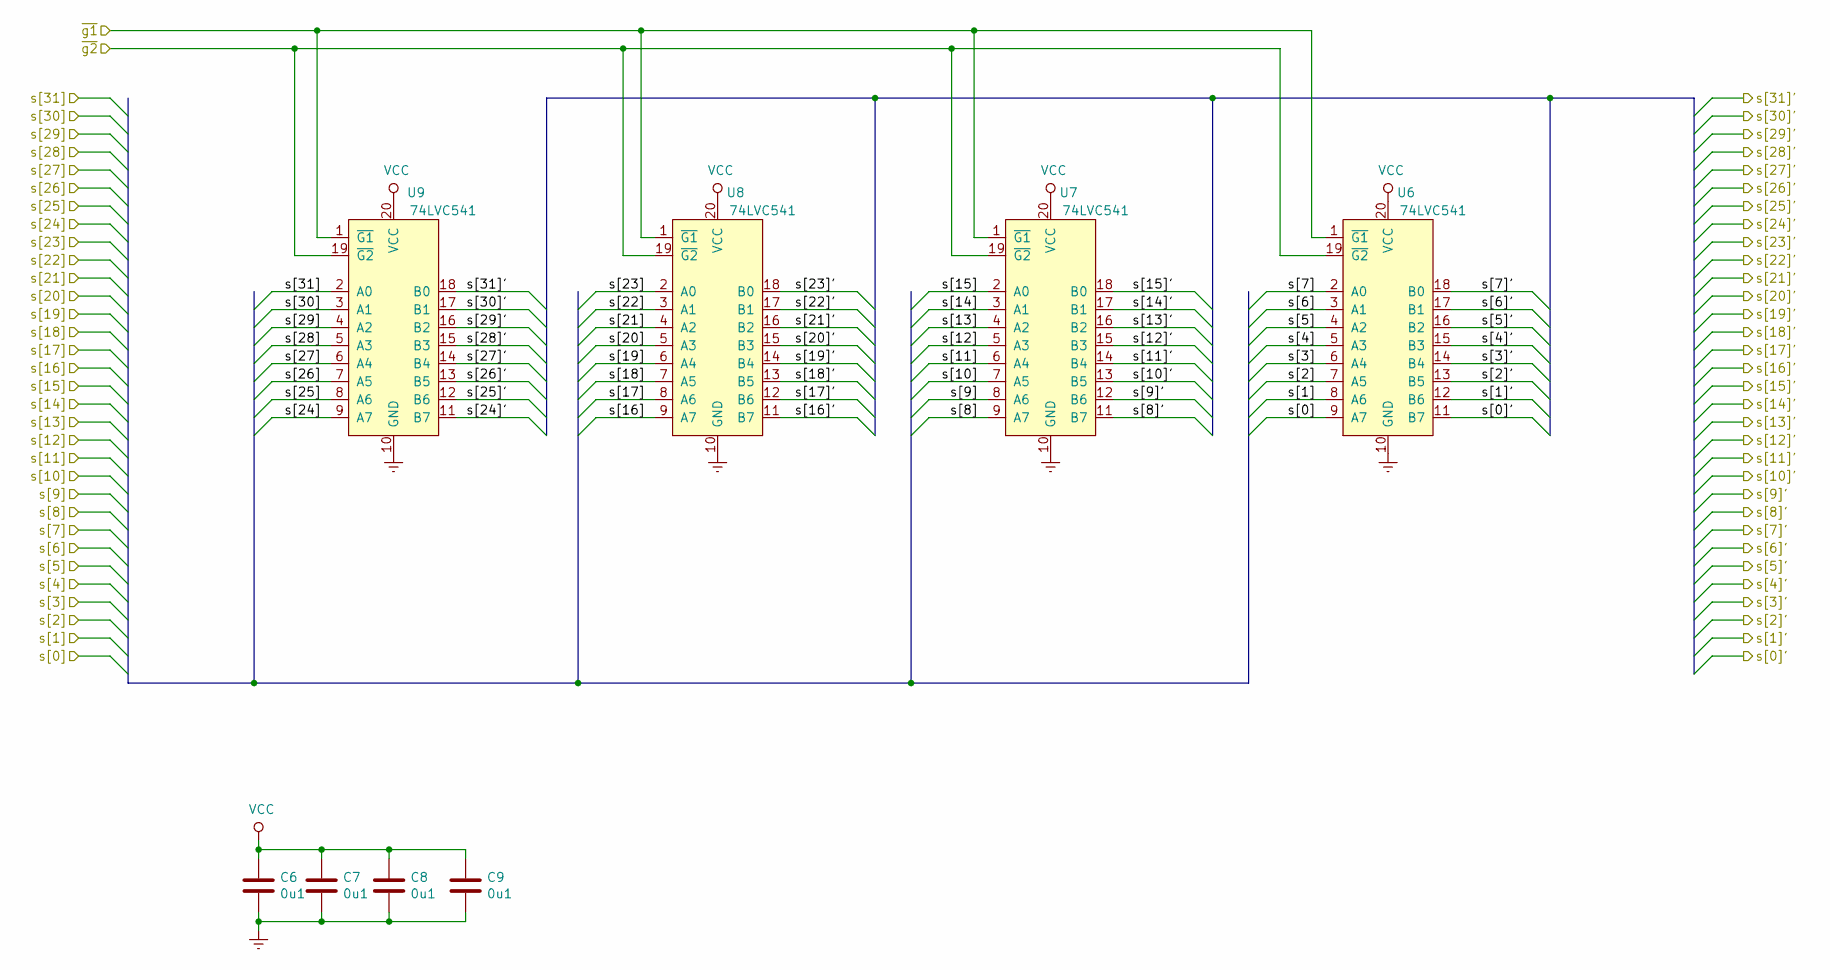
[picture p41: schematic buffer32.sch]

Parts:
C13, C14, C15, C16: 0u1; C_0603_1608Metric
U5, U6, U7, U8: 74LVC541; TSSOP-20_4.4x6.5mm_P0.65mm

Connections:
/BOOT_A[4]: U5.14 (B4); also elsewhere on the board
/BOOT_A[5]: U5.13 (B5); also elsewhere on the board
/BOOT_A[6]: U5.12 (B6); also elsewhere on the board
/BOOT_A[7]: U5.11 (B7); also elsewhere on the board
/BOOT_CLK: U5.2 (A0); also elsewhere on the board
/counter16/TC1: U5.15 (B3); also elsewhere on the board
/rs1[0]: U6.9 (A7); also elsewhere on the board
/rs1[1]: U6.8 (A6); also elsewhere on the board
/rs1[2]: U6.7 (A5); also elsewhere on the board
/rs1[3]: U6.6 (A4); also elsewhere on the board
/rs1[4]: U6.5 (A3); also elsewhere on the board
/rs1[5]: U6.4 (A2); also elsewhere on the board
/rs1[6]: U6.3 (A1); also elsewhere on the board
/rs1[7]: U6.2 (A0); also elsewhere on the board
/rs1[8]: U7.9 (A7); also elsewhere on the board
/rs1[9]: U7.8 (A6); also elsewhere on the board
/rs1[10]: U7.7 (A5); also elsewhere on the board
/rs1[11]: U7.6 (A4); also elsewhere on the board
/rs1[12]: U7.5 (A3); also elsewhere on the board
/rs1[13]: U7.4 (A2); also elsewhere on the board
/rs1[14]: U7.3 (A1); also elsewhere on the board
/rs1[15]: U7.2 (A0); also elsewhere on the board
/rs1[16]: U8.9 (A7); also elsewhere on the board
/rs1[17]: U8.8 (A6); also elsewhere on the board
/rs1[18]: U8.7 (A5); also elsewhere on the board
/rs1[19]: U8.6 (A4); also elsewhere on the board
/rs1[20]: U8.5 (A3); also elsewhere on the board
/rs1[21]: U8.4 (A2); also elsewhere on the board
/rs1[22]: U8.3 (A1); also elsewhere on the board
/rs1[23]: U8.2 (A0); also elsewhere on the board
/rs1b[0]: U6.11 (B7); also elsewhere on the board
/rs1b[1]: U6.12 (B6); also elsewhere on the board
/rs1b[2]: U6.13 (B5); also elsewhere on the board
/rs1b[3]: U6.14 (B4); also elsewhere on the board
/rs1b[4]: U6.15 (B3); also elsewhere on the board
/rs1b[5]: U6.16 (B2); also elsewhere on the board
/rs1b[6]: U6.17 (B1); also elsewhere on the board
/rs1b[7]: U6.18 (B0); also elsewhere on the board
/rs1b[8]: U7.11 (B7); also elsewhere on the board
/rs1b[9]: U7.12 (B6); also elsewhere on the board
/rs1b[10]: U7.13 (B5); also elsewhere on the board
/rs1b[11]: U7.14 (B4); also elsewhere on the board
/rs1b[12]: U7.15 (B3); also elsewhere on the board
/rs1b[13]: U7.16 (B2); also elsewhere on the board
/rs1b[14]: U7.17 (B1); also elsewhere on the board
/rs1b[15]: U7.18 (B0); also elsewhere on the board
/rs1b[16]: U8.11 (B7); also elsewhere on the board
/rs1b[17]: U8.12 (B6); also elsewhere on the board
/rs1b[18]: U8.13 (B5); also elsewhere on the board
/rs1b[19]: U8.14 (B4); also elsewhere on the board
/rs1b[20]: U8.15 (B3); also elsewhere on the board
/rs1b[21]: U8.16 (B2); also elsewhere on the board
/rs1b[22]: U8.17 (B1); also elsewhere on the board
/rs1b[23]: U8.18 (B0); also elsewhere on the board

Parts of its further copies:
C6, C7, C8, C9, C10, C11, C12, C17, C18, C19, C20, C21, C22, C23, C53, C54, C55, C56, C60: 0u1; C_0603_1608Metric
U9, U10, U11, U12, U13, U17, U18, U19, U20, U21, U22, U23, U60: 74LVC541; TSSOP-20_4.4x6.5mm_P0.65mm

Connections of its further copies:
/BOOT_A[0]: U17.2 (A0), U18.2 (A0), U19.2 (A0), U20.2 (A0), U21.2 (A0), U22.2 (A0), U23.2 (A0), U60.2 (A0); also elsewhere on the board
/BOOT_A[1]: U17.3 (A1), U18.3 (A1), U19.3 (A1), U20.3 (A1), U21.3 (A1), U22.3 (A1), U23.3 (A1), U60.3 (A1); also elsewhere on the board
/BOOT_A[2]: U17.4 (A2), U18.4 (A2), U19.4 (A2), U20.4 (A2), U21.4 (A2), U22.4 (A2), U23.4 (A2), U60.4 (A2); also elsewhere on the board
/BOOT_A[3]: U17.5 (A3), U18.5 (A3), U19.5 (A3), U20.5 (A3), U21.5 (A3), U22.5 (A3), U23.5 (A3), U60.5 (A3); also elsewhere on the board
/BOOT_A[4]: U17.6 (A4), U18.6 (A4), U19.6 (A4), U20.6 (A4), U21.6 (A4), U22.6 (A4), U23.6 (A4), U60.6 (A4); also elsewhere on the board
/BOOT_A[5]: U17.7 (A5), U18.7 (A5), U19.7 (A5), U20.7 (A5), U21.7 (A5), U22.7 (A5), U23.7 (A5), U60.7 (A5); also elsewhere on the board
/BOOT_A[6]: U17.8 (A6), U18.8 (A6), U19.8 (A6), U20.8 (A6), U21.8 (A6), U22.8 (A6), U23.8 (A6), U60.8 (A6); also elsewhere on the board
/BOOT_A[7]: U17.9 (A7), U18.9 (A7), U19.9 (A7), U20.9 (A7), U21.9 (A7), U22.9 (A7), U23.9 (A7), U60.9 (A7); also elsewhere on the board
/BOOT_A[15]: U17.19 (~G2), U18.19 (~G2), U19.19 (~G2), U20.19 (~G2), U21.1 (~G1), U22.1 (~G1), U23.1 (~G1), U60.1 (~G1); also elsewhere on the board
/rs1[24]: U9.9 (A7); also elsewhere on the board
/rs1[25]: U9.8 (A6); also elsewhere on the board
/rs1[26]: U9.7 (A5); also elsewhere on the board
/rs1[27]: U9.6 (A4); also elsewhere on the board
/rs1[28]: U9.5 (A3); also elsewhere on the board
/rs1[29]: U9.4 (A2); also elsewhere on the board
/rs1[30]: U9.3 (A1); also elsewhere on the board
/rs1[31]: U9.2 (A0); also elsewhere on the board
/rs1b[0]: U17.18 (B0); also elsewhere on the board
/rs1b[1]: U17.17 (B1); also elsewhere on the board
/rs1b[2]: U17.16 (B2); also elsewhere on the board
/rs1b[3]: U17.15 (B3); also elsewhere on the board
/rs1b[4]: U18.18 (B0); also elsewhere on the board
/rs1b[5]: U18.17 (B1); also elsewhere on the board
/rs1b[6]: U18.16 (B2); also elsewhere on the board
/rs1b[7]: U18.15 (B3); also elsewhere on the board
/rs1b[8]: U19.18 (B0); also elsewhere on the board
/rs1b[9]: U19.17 (B1); also elsewhere on the board
/rs1b[10]: U19.16 (B2); also elsewhere on the board
/rs1b[11]: U19.15 (B3); also elsewhere on the board
/rs1b[12]: U20.18 (B0); also elsewhere on the board
/rs1b[13]: U20.17 (B1); also elsewhere on the board
/rs1b[14]: U20.16 (B2); also elsewhere on the board
/rs1b[15]: U20.15 (B3); also elsewhere on the board
/rs1b[16]: U21.18 (B0); also elsewhere on the board
/rs1b[17]: U21.17 (B1); also elsewhere on the board
/rs1b[18]: U21.16 (B2); also elsewhere on the board
/rs1b[19]: U21.15 (B3); also elsewhere on the board
/rs1b[20]: U22.18 (B0); also elsewhere on the board
/rs1b[21]: U22.17 (B1); also elsewhere on the board
/rs1b[22]: U22.16 (B2); also elsewhere on the board
/rs1b[23]: U22.15 (B3); also elsewhere on the board
/rs1b[24]: U9.11 (B7), U23.18 (B0); also elsewhere on the board
/rs1b[25]: U9.12 (B6), U23.17 (B1); also elsewhere on the board
/rs1b[26]: U9.13 (B5), U23.16 (B2); also elsewhere on the board
/rs1b[27]: U9.14 (B4), U23.15 (B3); also elsewhere on the board
/rs1b[28]: U9.15 (B3), U60.18 (B0); also elsewhere on the board
/rs1b[29]: U9.16 (B2), U60.17 (B1); also elsewhere on the board
/rs1b[30]: U9.17 (B1), U60.16 (B2); also elsewhere on the board
/rs1b[31]: U9.18 (B0), U60.15 (B3); also elsewhere on the board
/rs2[0]: U10.9 (A7); also elsewhere on the board
/rs2[1]: U10.8 (A6); also elsewhere on the board
/rs2[2]: U10.7 (A5); also elsewhere on the board
/rs2[3]: U10.6 (A4); also elsewhere on the board
/rs2[4]: U10.5 (A3); also elsewhere on the board
/rs2[5]: U10.4 (A2); also elsewhere on the board
/rs2[6]: U10.3 (A1); also elsewhere on the board
/rs2[7]: U10.2 (A0); also elsewhere on the board
/rs2[8]: U11.9 (A7); also elsewhere on the board
/rs2[9]: U11.8 (A6); also elsewhere on the board
/rs2[10]: U11.7 (A5); also elsewhere on the board
/rs2[11]: U11.6 (A4); also elsewhere on the board
/rs2[12]: U11.5 (A3); also elsewhere on the board
/rs2[13]: U11.4 (A2); also elsewhere on the board
/rs2[14]: U11.3 (A1); also elsewhere on the board
/rs2[15]: U11.2 (A0); also elsewhere on the board
/rs2[16]: U12.9 (A7); also elsewhere on the board
/rs2[17]: U12.8 (A6); also elsewhere on the board
/rs2[18]: U12.7 (A5); also elsewhere on the board
/rs2[19]: U12.6 (A4); also elsewhere on the board
/rs2[20]: U12.5 (A3); also elsewhere on the board
/rs2[21]: U12.4 (A2); also elsewhere on the board
/rs2[22]: U12.3 (A1); also elsewhere on the board
/rs2[23]: U12.2 (A0); also elsewhere on the board
/rs2[24]: U13.9 (A7); also elsewhere on the board
/rs2[25]: U13.8 (A6); also elsewhere on the board
/rs2[26]: U13.7 (A5); also elsewhere on the board
/rs2[27]: U13.6 (A4); also elsewhere on the board
/rs2[28]: U13.5 (A3); also elsewhere on the board
/rs2[29]: U13.4 (A2); also elsewhere on the board
/rs2[30]: U13.3 (A1); also elsewhere on the board
/rs2[31]: U13.2 (A0); also elsewhere on the board
/rs2b[0]: U10.11 (B7), U17.14 (B4); also elsewhere on the board
/rs2b[1]: U10.12 (B6), U17.13 (B5); also elsewhere on the board
/rs2b[2]: U10.13 (B5), U17.12 (B6); also elsewhere on the board
/rs2b[3]: U10.14 (B4), U17.11 (B7); also elsewhere on the board
/rs2b[4]: U10.15 (B3), U18.14 (B4); also elsewhere on the board
/rs2b[5]: U10.16 (B2), U18.13 (B5); also elsewhere on the board
/rs2b[6]: U10.17 (B1), U18.12 (B6); also elsewhere on the board
/rs2b[7]: U10.18 (B0), U18.11 (B7); also elsewhere on the board
/rs2b[8]: U11.11 (B7), U19.14 (B4); also elsewhere on the board
/rs2b[9]: U11.12 (B6), U19.13 (B5); also elsewhere on the board
/rs2b[10]: U11.13 (B5), U19.12 (B6); also elsewhere on the board
/rs2b[11]: U11.14 (B4), U19.11 (B7); also elsewhere on the board
/rs2b[12]: U11.15 (B3), U20.14 (B4); also elsewhere on the board
/rs2b[13]: U11.16 (B2), U20.13 (B5); also elsewhere on the board
/rs2b[14]: U11.17 (B1), U20.12 (B6); also elsewhere on the board
/rs2b[15]: U11.18 (B0), U20.11 (B7); also elsewhere on the board
/rs2b[16]: U12.11 (B7), U21.14 (B4); also elsewhere on the board
/rs2b[17]: U12.12 (B6), U21.13 (B5); also elsewhere on the board
/rs2b[18]: U12.13 (B5), U21.12 (B6); also elsewhere on the board
/rs2b[19]: U12.14 (B4), U21.11 (B7); also elsewhere on the board
/rs2b[20]: U12.15 (B3), U22.14 (B4); also elsewhere on the board
/rs2b[21]: U12.16 (B2), U22.13 (B5); also elsewhere on the board
/rs2b[22]: U12.17 (B1), U22.12 (B6); also elsewhere on the board
/rs2b[23]: U12.18 (B0), U22.11 (B7); also elsewhere on the board
/rs2b[24]: U13.11 (B7), U23.14 (B4); also elsewhere on the board
/rs2b[25]: U13.12 (B6), U23.13 (B5); also elsewhere on the board
/rs2b[26]: U13.13 (B5), U23.12 (B6); also elsewhere on the board
/rs2b[27]: U13.14 (B4), U23.11 (B7); also elsewhere on the board
/rs2b[28]: U13.15 (B3), U60.14 (B4); also elsewhere on the board
/rs2b[29]: U13.16 (B2), U60.13 (B5); also elsewhere on the board
/rs2b[30]: U13.17 (B1), U60.12 (B6); also elsewhere on the board
/rs2b[31]: U13.18 (B0), U60.11 (B7); also elsewhere on the board
/~BOOT_ALU_EN: U17.1 (~G1), U18.1 (~G1), U19.1 (~G1), U20.1 (~G1), U21.19 (~G2), U22.19 (~G2), U23.19 (~G2), U60.19 (~G2); also elsewhere on the board
