RobertBaruch/lmarv/lmarv-1/alu/alu.kicad_pcb

## KiCad design lmarv-1/alu/alu.kicad_pcb (continued)

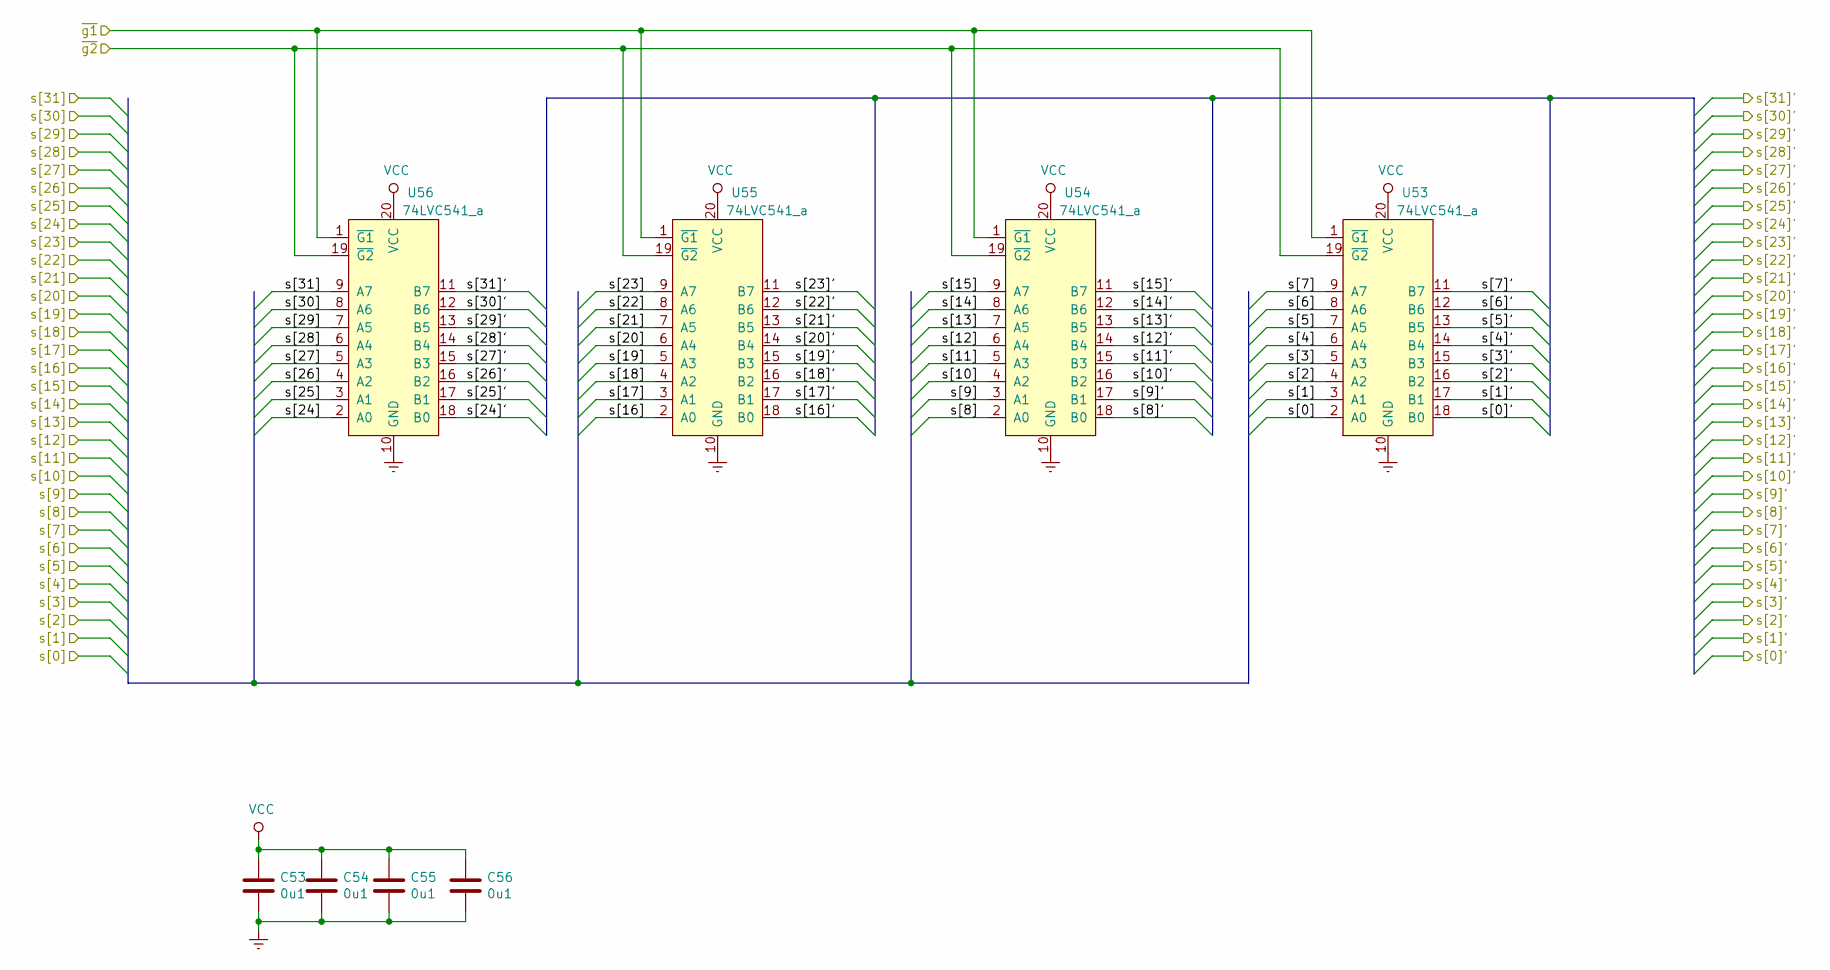
[picture p42: schematic buffer32_rev.sch]

Parts:
C13, C14, C15, C16: 0u1; C_0603_1608Metric
U53, U54, U55, U56: 74LVC541_a; TSSOP-20_4.4x6.5mm_P0.65mm

Connections:
/rd[0]: U53.18 (B0); also elsewhere on the board
/rd[1]: U53.17 (B1); also elsewhere on the board
/rd[2]: U53.16 (B2); also elsewhere on the board
/rd[3]: U53.15 (B3); also elsewhere on the board
/rd[4]: U53.14 (B4); also elsewhere on the board
/rd[5]: U53.13 (B5); also elsewhere on the board
/rd[6]: U53.12 (B6); also elsewhere on the board
/rd[7]: U53.11 (B7); also elsewhere on the board
/rd[8]: U54.18 (B0); also elsewhere on the board
/rd[9]: U54.17 (B1); also elsewhere on the board
/rd[10]: U54.16 (B2); also elsewhere on the board
/rd[11]: U54.15 (B3); also elsewhere on the board
/rd[12]: U54.14 (B4); also elsewhere on the board
/rd[13]: U54.13 (B5); also elsewhere on the board
/rd[14]: U54.12 (B6); also elsewhere on the board
/rd[15]: U54.11 (B7); also elsewhere on the board
/rd[16]: U55.18 (B0); also elsewhere on the board
/rd[17]: U55.17 (B1); also elsewhere on the board
/rd[18]: U55.16 (B2); also elsewhere on the board
/rd[19]: U55.15 (B3); also elsewhere on the board
/rd[20]: U55.14 (B4); also elsewhere on the board
/rd[21]: U55.13 (B5); also elsewhere on the board
/rd[22]: U55.12 (B6); also elsewhere on the board
/rd[23]: U55.11 (B7); also elsewhere on the board
/rd[24]: U56.18 (B0); also elsewhere on the board
/rd[25]: U56.17 (B1); also elsewhere on the board
/rd[26]: U56.16 (B2); also elsewhere on the board
/rd[27]: U56.15 (B3); also elsewhere on the board
/rd[28]: U56.14 (B4); also elsewhere on the board
/rd[29]: U56.13 (B5); also elsewhere on the board
/rd[30]: U56.12 (B6); also elsewhere on the board
/rd[31]: U56.11 (B7); also elsewhere on the board
/rdb[0]': U53.2 (A0); also elsewhere on the board
/rdb[1]: U53.3 (A1); also elsewhere on the board
/rdb[2]: U53.4 (A2); also elsewhere on the board
/rdb[3]: U53.5 (A3); also elsewhere on the board
/rdb[4]: U53.6 (A4); also elsewhere on the board
/rdb[5]: U53.7 (A5); also elsewhere on the board
/rdb[6]: U53.8 (A6); also elsewhere on the board
/rdb[7]: U53.9 (A7); also elsewhere on the board
/rdb[8]: U54.2 (A0); also elsewhere on the board
/rdb[9]: U54.3 (A1); also elsewhere on the board
/rdb[10]: U54.4 (A2); also elsewhere on the board
/rdb[11]: U54.5 (A3); also elsewhere on the board
/rdb[12]: U54.6 (A4); also elsewhere on the board
/rdb[13]: U54.7 (A5); also elsewhere on the board
/rdb[14]: U54.8 (A6); also elsewhere on the board
/rdb[15]: U54.9 (A7); also elsewhere on the board
/rdb[16]: U55.2 (A0); also elsewhere on the board
/rdb[17]: U55.3 (A1); also elsewhere on the board
/rdb[18]: U55.4 (A2); also elsewhere on the board
/rdb[19]: U55.5 (A3); also elsewhere on the board
/rdb[20]: U55.6 (A4); also elsewhere on the board
/rdb[21]: U55.7 (A5); also elsewhere on the board
/rdb[22]: U55.8 (A6); also elsewhere on the board
/rdb[23]: U55.9 (A7); also elsewhere on the board
/rdb[24]: U56.2 (A0); also elsewhere on the board
/rdb[25]: U56.3 (A1); also elsewhere on the board
/rdb[26]: U56.4 (A2); also elsewhere on the board
/rdb[27]: U56.5 (A3); also elsewhere on the board
/rdb[28]: U56.6 (A4); also elsewhere on the board
/rdb[29]: U56.7 (A5); also elsewhere on the board
/rdb[30]: U56.8 (A6); also elsewhere on the board
/rdb[31]: U56.9 (A7); also elsewhere on the board
/~alu_oe: U53.1 (~G1), U53.19 (~G2), U54.1 (~G1), U54.19 (~G2), U55.1 (~G1), U55.19 (~G2), U56.1 (~G1), U56.19 (~G2); also elsewhere on the board

Parts of its further copies:
C6, C7, C8, C9, C10, C11, C12, C17, C18, C19, C20, C21, C22, C23, C53, C54, C55, C56, C60: 0u1; C_0603_1608Metric

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
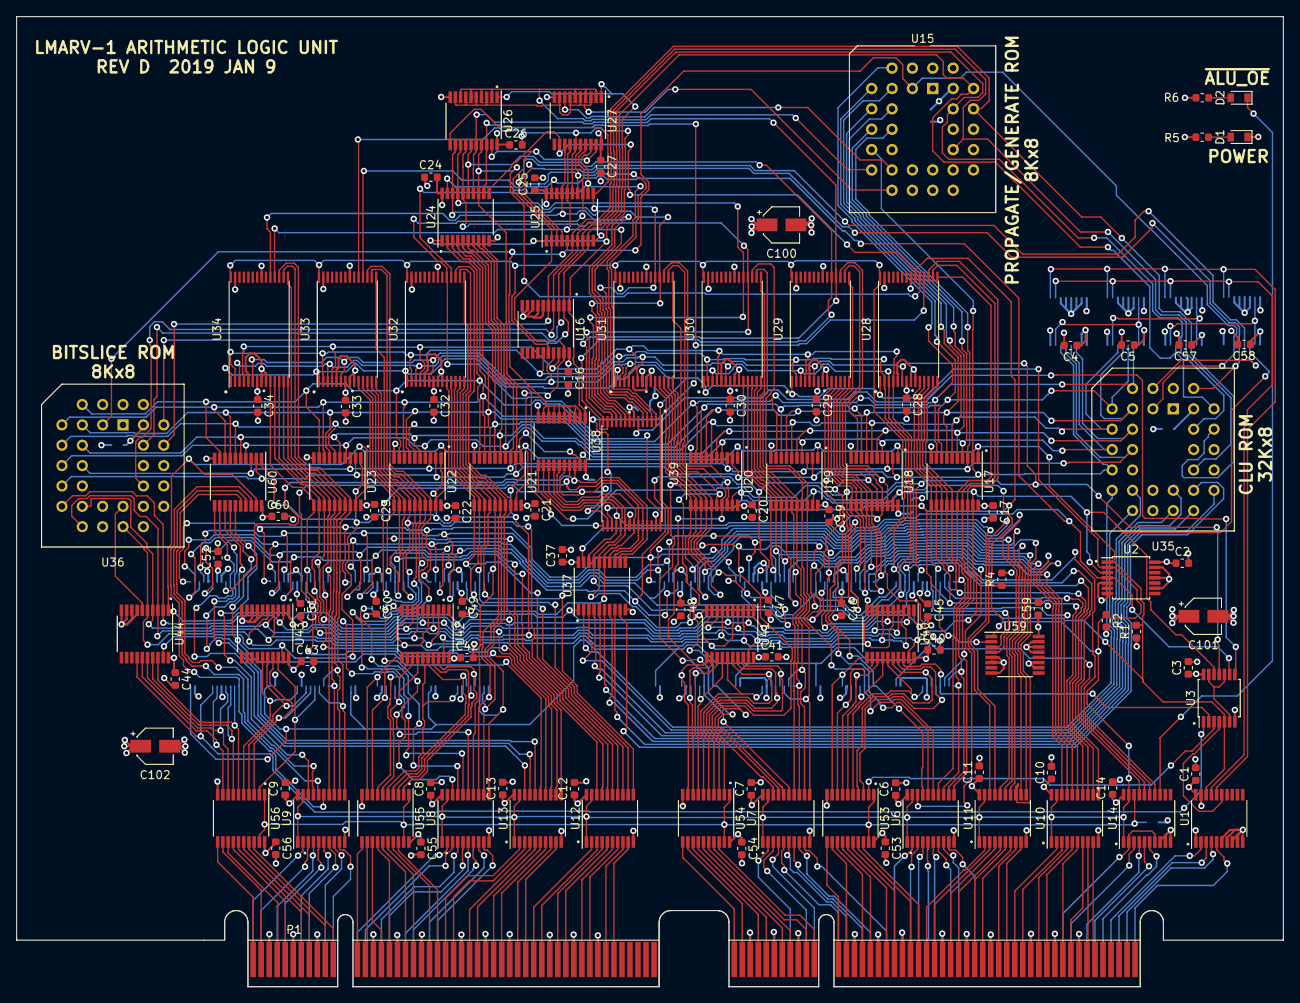
[picture p43: board lmarv-1/alu/alu.kicad_pcb from above]

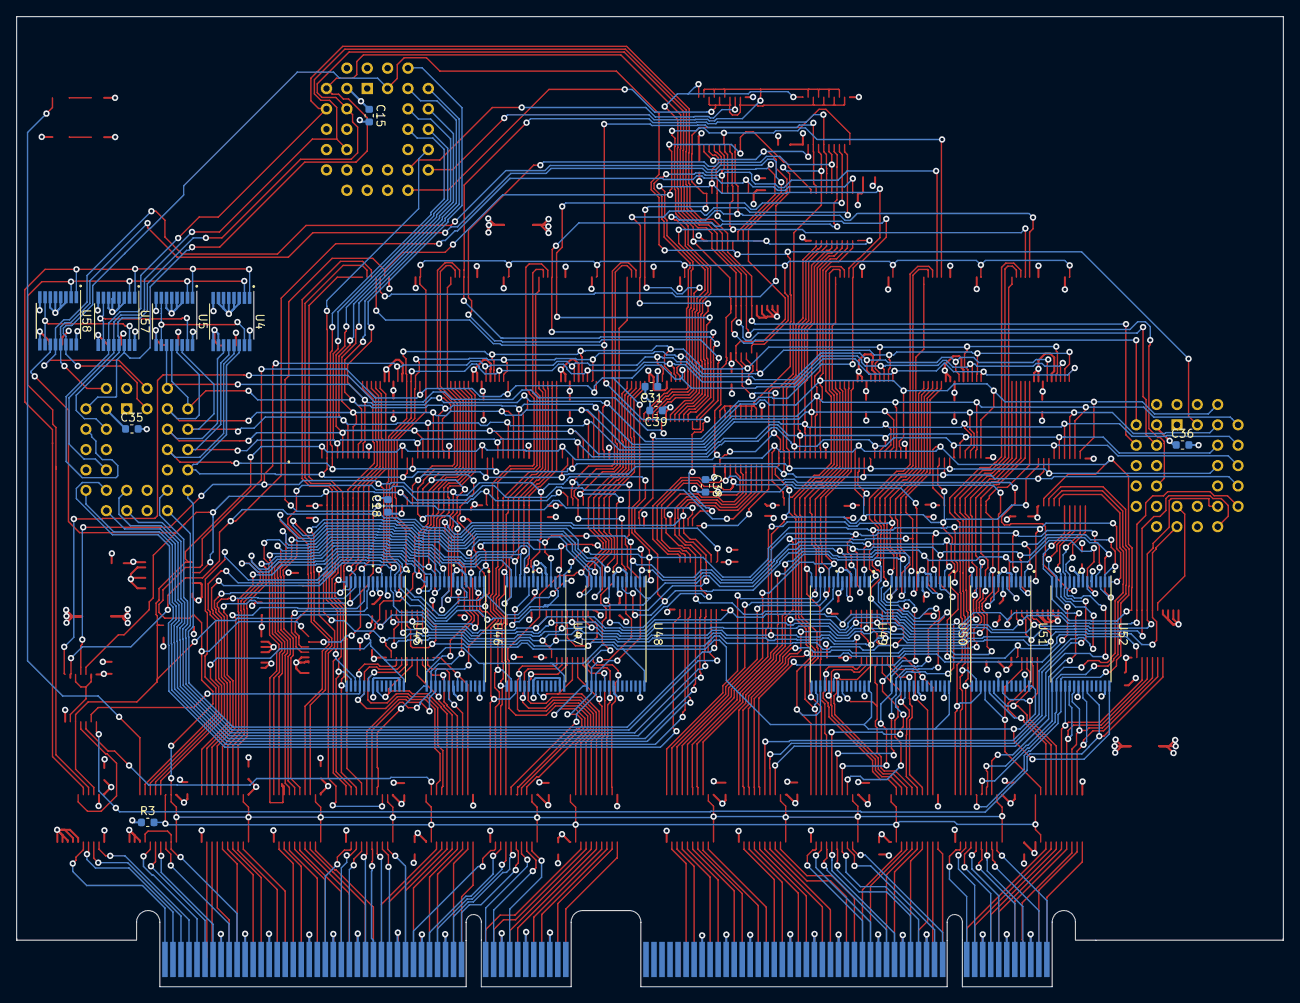
[picture p44: board lmarv-1/alu/alu.kicad_pcb from below]

Board: 4 copper layers, 158.0 x 121.0 mm, 132 parts (20 on the bottom side), 281 nets.
