RobertBaruch/lmarv/lmarv-1/ram-based-register-card/ram-based-register-card.kicad_pcb

## KiCad design lmarv-1/ram-based-register-card/ram-based-register-card.kicad_pcb (2019-01-28)

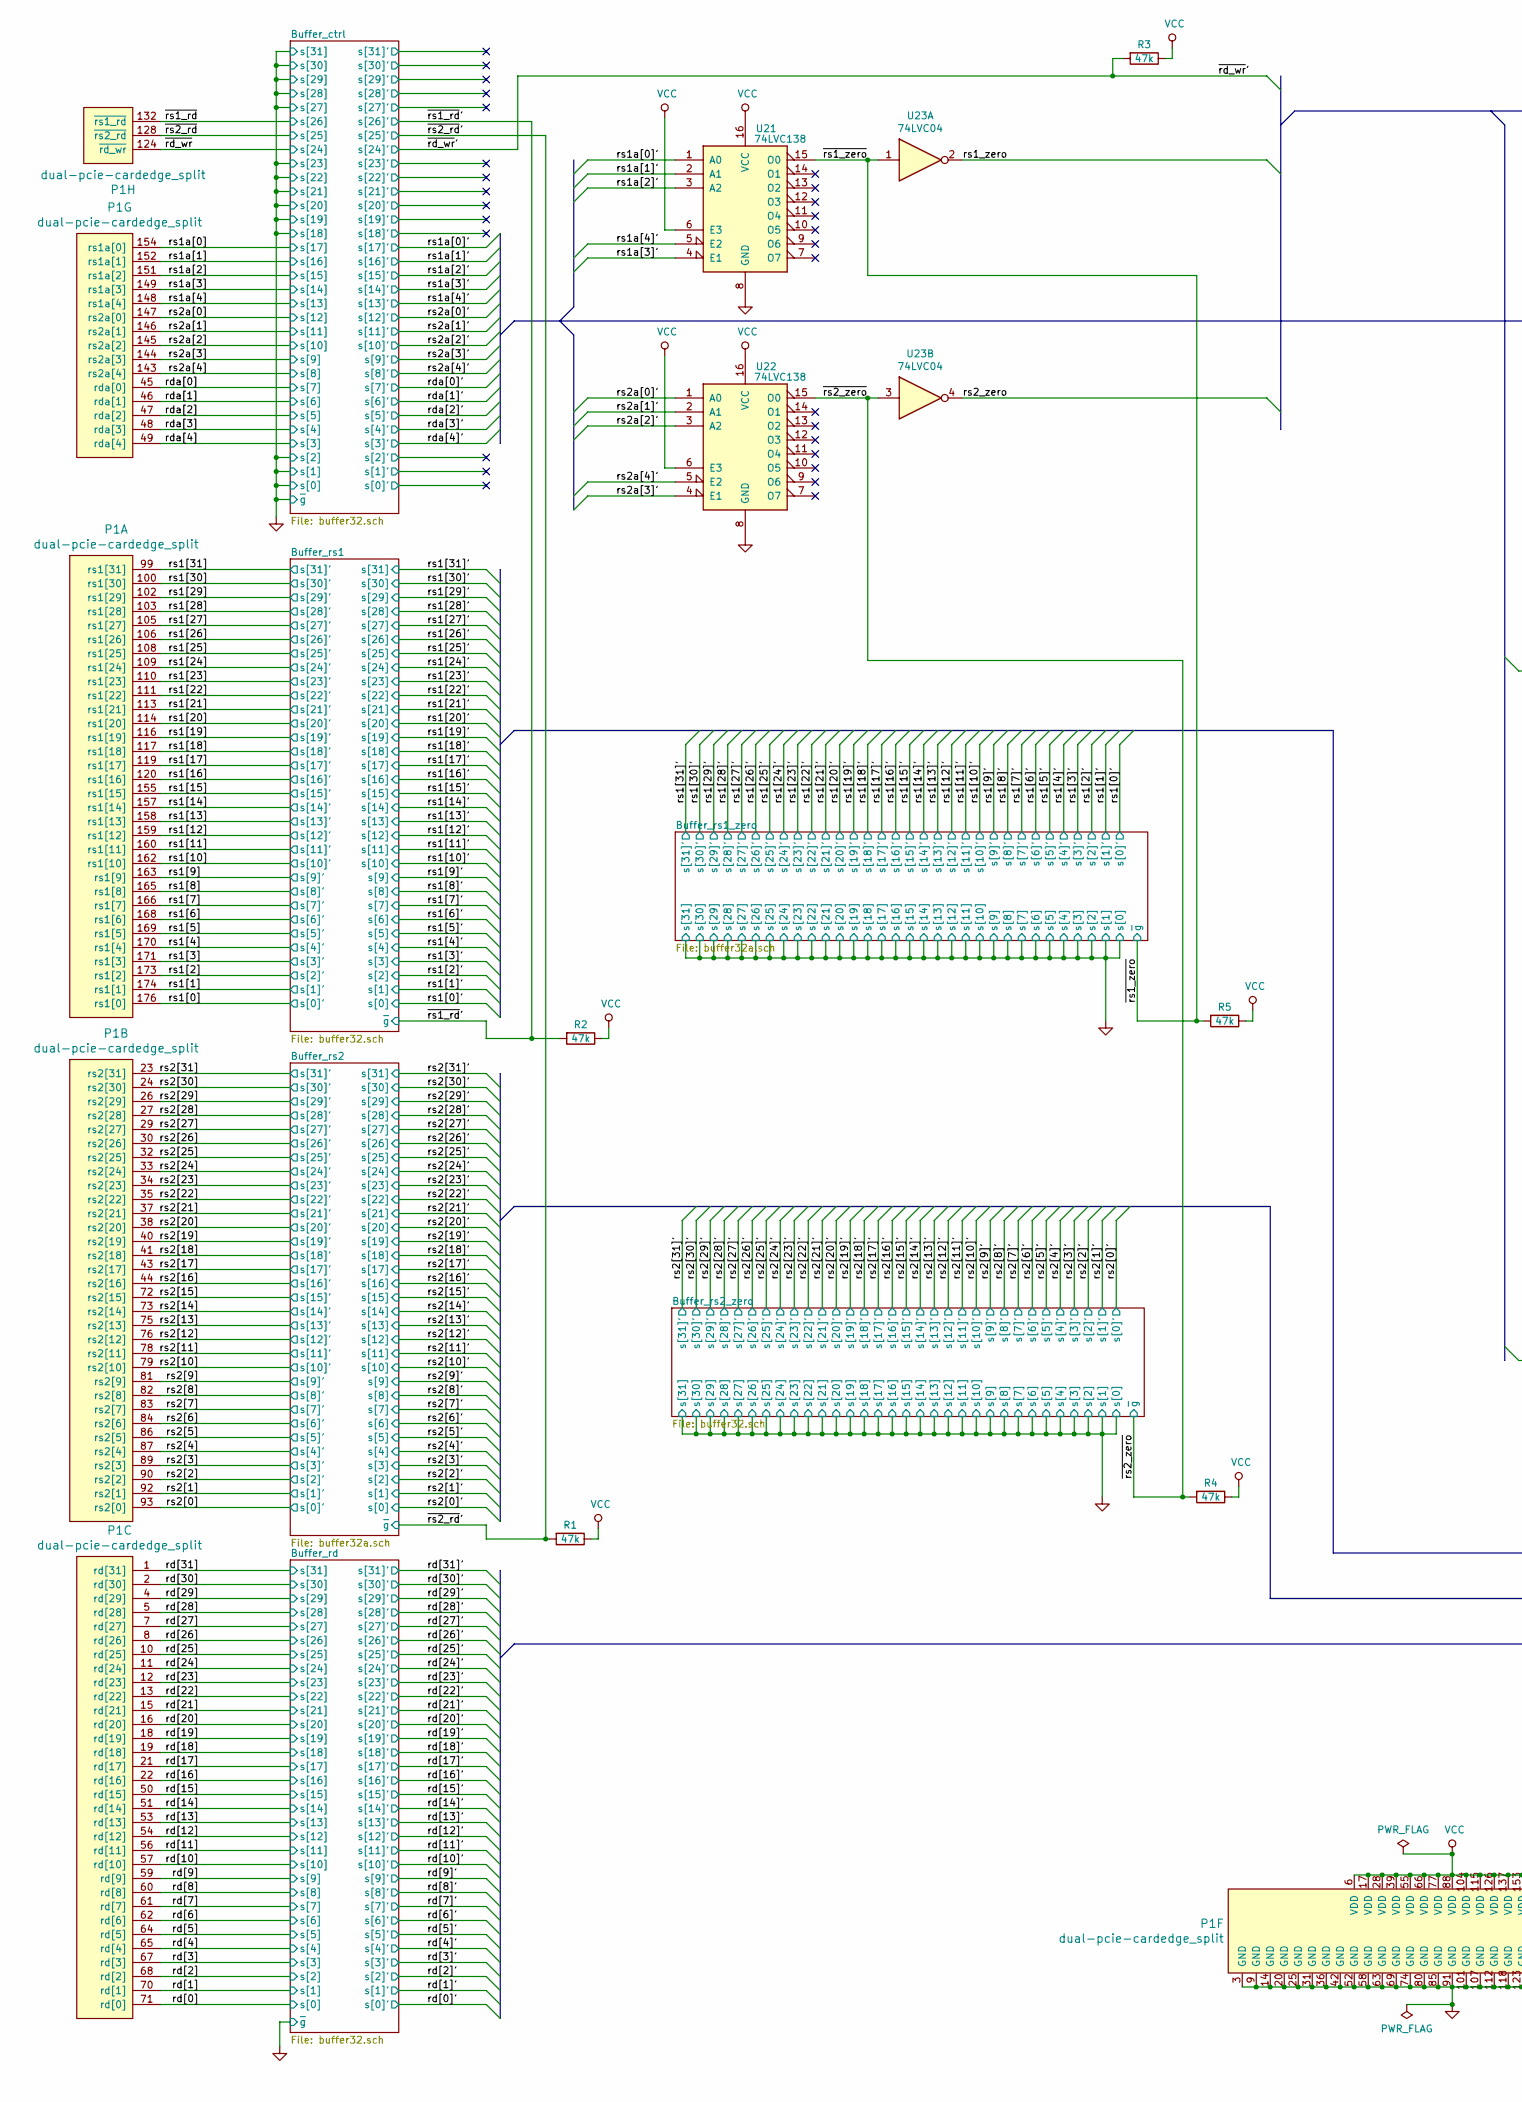
[picture p45: schematic ram-based-register-card.sch, part in row 1, column 1]

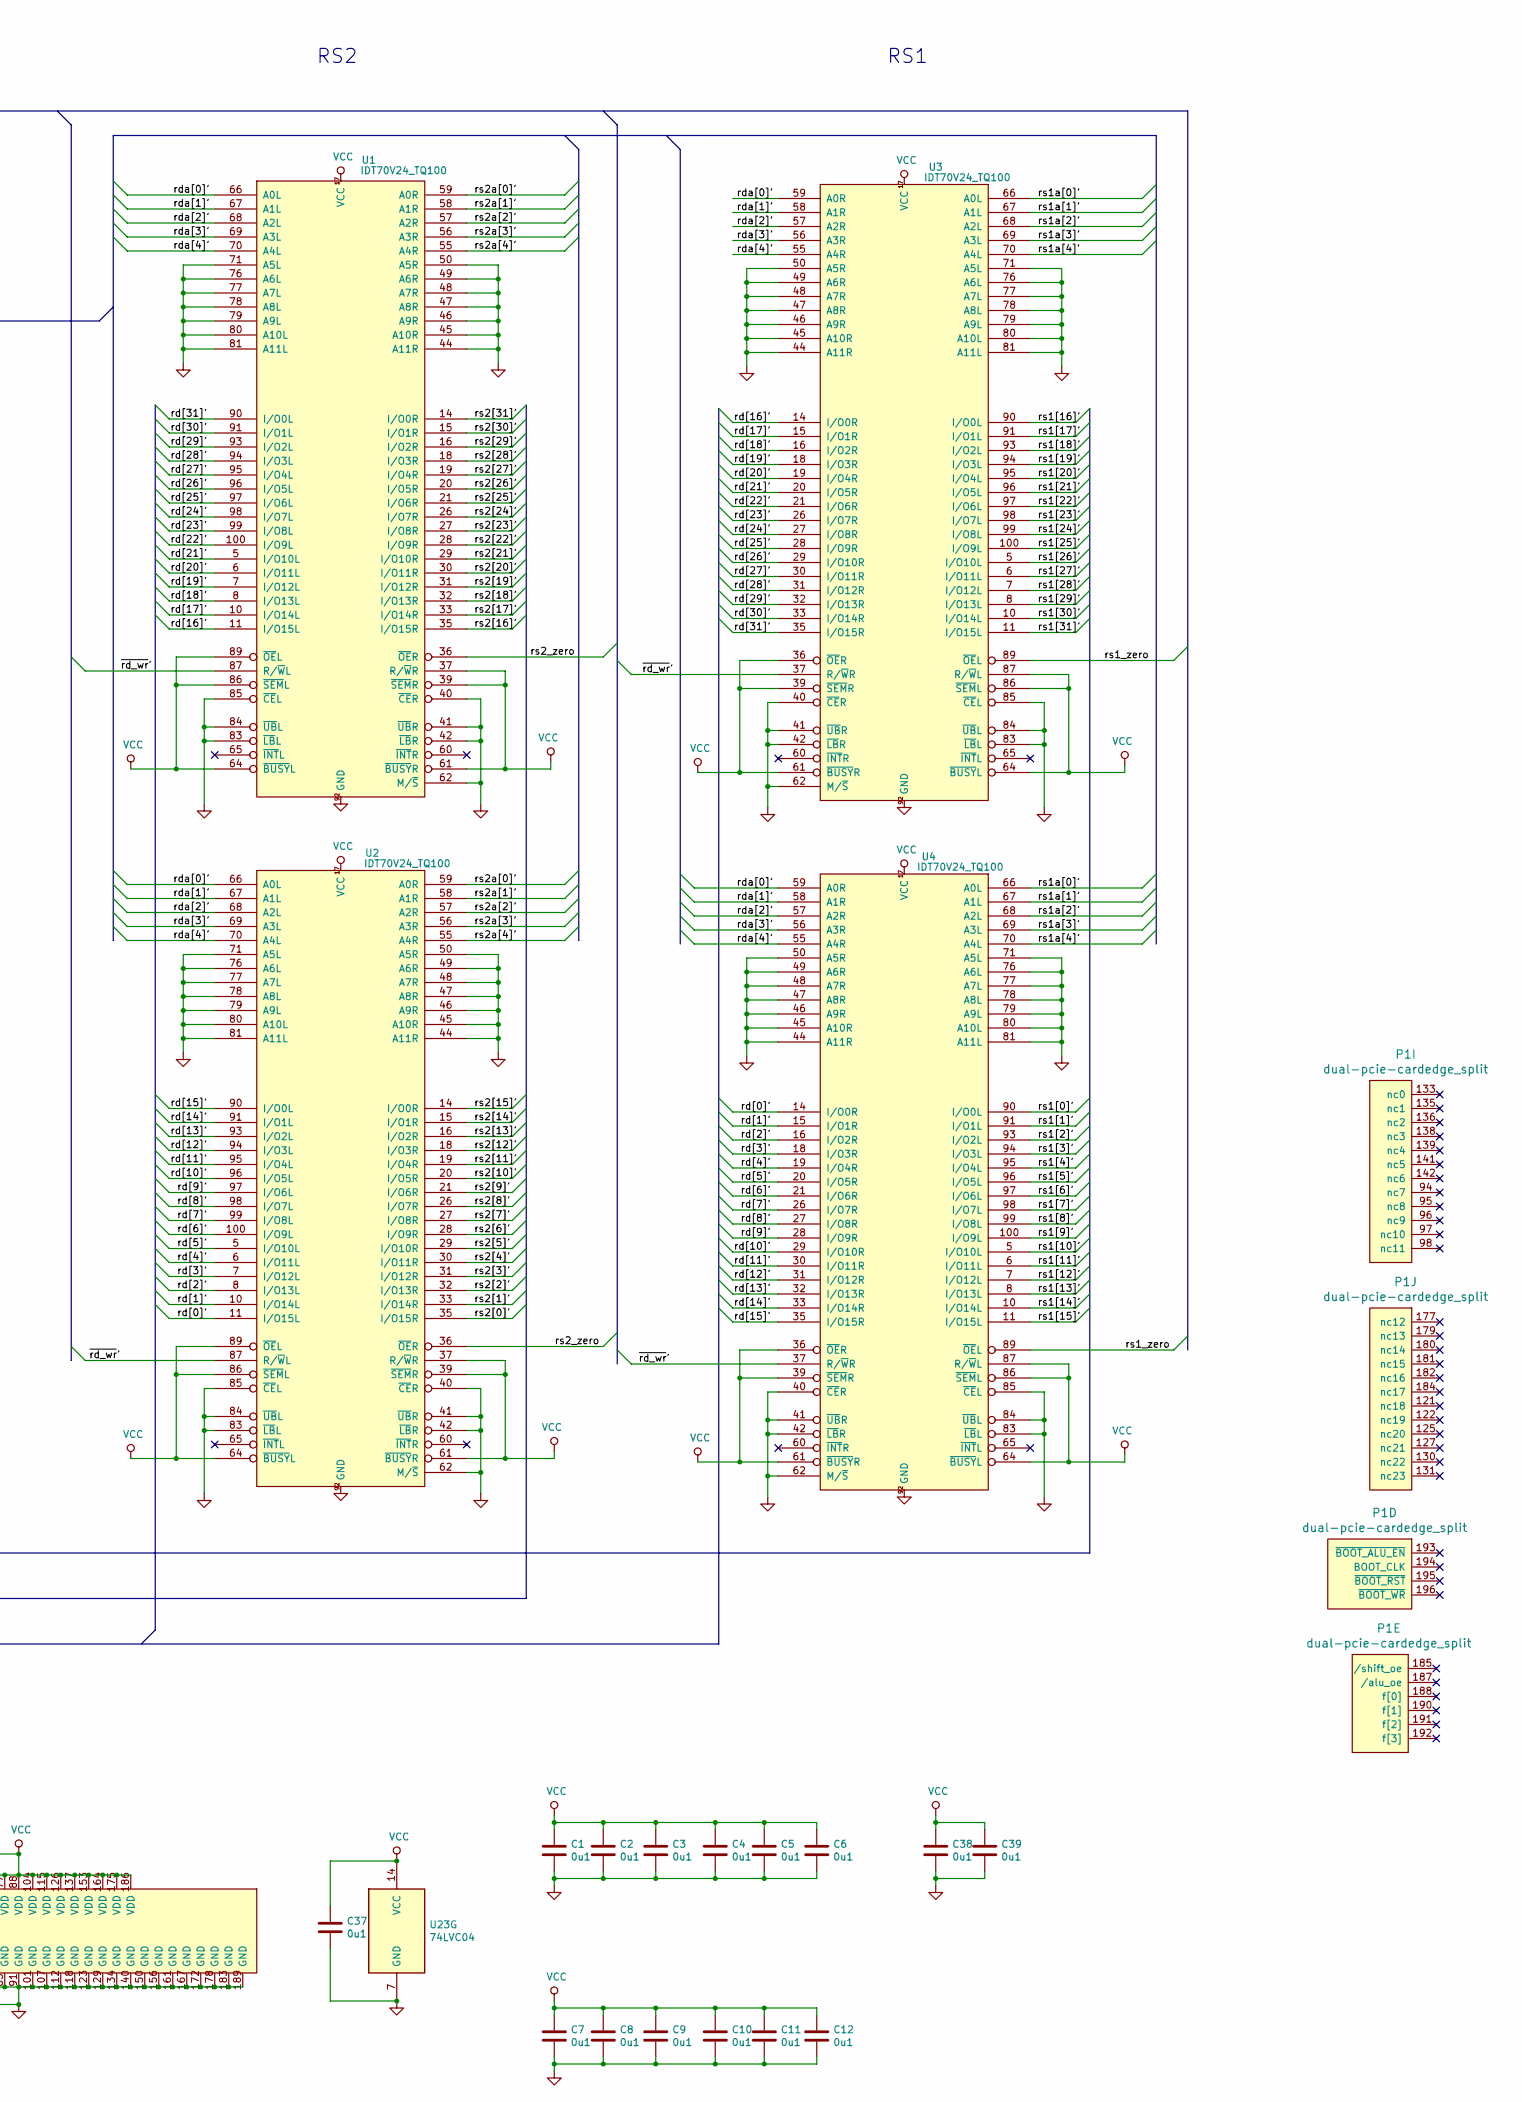
[picture p46: schematic ram-based-register-card.sch, part in row 1, column 2]

Parts:
C1, C2, C3, C4, C5, C6, C7, C8, C9, C10, C11, C12, C37, C38, C39: 0u1; C_0603_1608Metric
P1: dual-pcie-cardedge_split; PCI-EXPRESS
R1, R2, R3, R4, R5: 47k; R_0603_1608Metric
U1, U2, U3, U4: IDT70V24_TQ100; TQFP-100_14x14mm_P0.5mm
U21, U22: 74LVC138; TSSOP-16_4.4x5mm_P0.65mm
U23: 74LVC04; TSSOP-14_4.4x5mm_P0.65mm

Connections:
/rd[0]: P1.71 (rd[0]); also elsewhere on the board
/rd[0]': U2.11 (I/O15L), U4.14 (I/O0R); also elsewhere on the board
/rd[1]: P1.70 (rd[1]); also elsewhere on the board
/rd[1]': U2.10 (I/O14L), U4.15 (I/O1R); also elsewhere on the board
/rd[2]: P1.68 (rd[2]); also elsewhere on the board
/rd[2]': U2.8 (I/O13L), U4.16 (I/O2R); also elsewhere on the board
/rd[3]: P1.67 (rd[3]); also elsewhere on the board
/rd[3]': U2.7 (I/O12L), U4.18 (I/O3R); also elsewhere on the board
/rd[4]: P1.65 (rd[4]); also elsewhere on the board
/rd[4]': U2.6 (I/O11L), U4.19 (I/O4R); also elsewhere on the board
/rd[5]: P1.64 (rd[5]); also elsewhere on the board
/rd[5]': U2.5 (I/O10L), U4.20 (I/O5R); also elsewhere on the board
/rd[6]: P1.62 (rd[6]); also elsewhere on the board
/rd[6]': U2.100 (I/O9L), U4.21 (I/O6R); also elsewhere on the board
/rd[7]: P1.61 (rd[7]); also elsewhere on the board
/rd[7]': U2.99 (I/O8L), U4.26 (I/O7R); also elsewhere on the board
/rd[8]: P1.60 (rd[8]); also elsewhere on the board
/rd[8]': U2.98 (I/O7L), U4.27 (I/O8R); also elsewhere on the board
/rd[9]: P1.59 (rd[9]); also elsewhere on the board
/rd[9]': U2.97 (I/O6L), U4.28 (I/O9R); also elsewhere on the board
/rd[10]: P1.57 (rd[10]); also elsewhere on the board
/rd[10]': U2.96 (I/O5L), U4.29 (I/O10R); also elsewhere on the board
/rd[11]: P1.56 (rd[11]); also elsewhere on the board
/rd[11]': U2.95 (I/O4L), U4.30 (I/O11R); also elsewhere on the board
/rd[12]: P1.54 (rd[12]); also elsewhere on the board
/rd[12]': U2.94 (I/O3L), U4.31 (I/O12R); also elsewhere on the board
/rd[13]: P1.53 (rd[13]); also elsewhere on the board
/rd[13]': U2.93 (I/O2L), U4.32 (I/O13R); also elsewhere on the board
/rd[14]: P1.51 (rd[14]); also elsewhere on the board
/rd[14]': U2.91 (I/O1L), U4.33 (I/O14R); also elsewhere on the board
/rd[15]: P1.50 (rd[15]); also elsewhere on the board
/rd[15]': U2.90 (I/O0L), U4.35 (I/O15R); also elsewhere on the board
/rd[16]: P1.22 (rd[16]); also elsewhere on the board
/rd[16]': U1.11 (I/O15L), U3.14 (I/O0R); also elsewhere on the board
/rd[17]: P1.21 (rd[17]); also elsewhere on the board
/rd[17]': U1.10 (I/O14L), U3.15 (I/O1R); also elsewhere on the board
/rd[18]: P1.19 (rd[18]); also elsewhere on the board
/rd[18]': U1.8 (I/O13L), U3.16 (I/O2R); also elsewhere on the board
/rd[19]: P1.18 (rd[19]); also elsewhere on the board
/rd[19]': U1.7 (I/O12L), U3.18 (I/O3R); also elsewhere on the board
/rd[20]: P1.16 (rd[20]); also elsewhere on the board
/rd[20]': U1.6 (I/O11L), U3.19 (I/O4R); also elsewhere on the board
/rd[21]: P1.15 (rd[21]); also elsewhere on the board
/rd[21]': U1.5 (I/O10L), U3.20 (I/O5R); also elsewhere on the board
/rd[22]: P1.13 (rd[22]); also elsewhere on the board
/rd[22]': U1.100 (I/O9L), U3.21 (I/O6R); also elsewhere on the board
/rd[23]: P1.12 (rd[23]); also elsewhere on the board
/rd[23]': U1.99 (I/O8L), U3.26 (I/O7R); also elsewhere on the board
/rd[24]: P1.11 (rd[24]); also elsewhere on the board
/rd[24]': U1.98 (I/O7L), U3.27 (I/O8R); also elsewhere on the board
/rd[25]: P1.10 (rd[25]); also elsewhere on the board
/rd[25]': U1.97 (I/O6L), U3.28 (I/O9R); also elsewhere on the board
/rd[26]: P1.8 (rd[26]); also elsewhere on the board
/rd[26]': U1.96 (I/O5L), U3.29 (I/O10R); also elsewhere on the board
/rd[27]: P1.7 (rd[27]); also elsewhere on the board
/rd[27]': U1.95 (I/O4L), U3.30 (I/O11R); also elsewhere on the board
/rd[28]: P1.5 (rd[28]); also elsewhere on the board
/rd[28]': U1.94 (I/O3L), U3.31 (I/O12R); also elsewhere on the board
/rd[29]: P1.4 (rd[29]); also elsewhere on the board
/rd[29]': U1.93 (I/O2L), U3.32 (I/O13R); also elsewhere on the board
/rd[30]: P1.2 (rd[30]); also elsewhere on the board
/rd[30]': U1.91 (I/O1L), U3.33 (I/O14R); also elsewhere on the board
/rd[31]: P1.1 (rd[31]); also elsewhere on the board
/rd[31]': U1.90 (I/O0L), U3.35 (I/O15R); also elsewhere on the board
/rda[0]: P1.45 (rda[0]); also elsewhere on the board
/rda[0]': U1.66 (A0L), U2.66 (A0L), U3.59 (A0R), U4.59 (A0R); also elsewhere on the board
/rda[1]: P1.46 (rda[1]); also elsewhere on the board
/rda[1]': U1.67 (A1L), U2.67 (A1L), U3.58 (A1R), U4.58 (A1R); also elsewhere on the board
/rda[2]: P1.47 (rda[2]); also elsewhere on the board
/rda[2]': U1.68 (A2L), U2.68 (A2L), U3.57 (A2R), U4.57 (A2R); also elsewhere on the board
/rda[3]: P1.48 (rda[3]); also elsewhere on the board
/rda[3]': U1.69 (A3L), U2.69 (A3L), U3.56 (A3R), U4.56 (A3R); also elsewhere on the board
/rda[4]: P1.49 (rda[4]); also elsewhere on the board
/rda[4]': U1.70 (A4L), U2.70 (A4L), U3.55 (A4R), U4.55 (A4R); also elsewhere on the board
/rs1[0]: P1.176 (rs1[0]); also elsewhere on the board
/rs1[0]': U4.90 (I/O0L); also elsewhere on the board
/rs1[1]: P1.174 (rs1[1]); also elsewhere on the board
/rs1[1]': U4.91 (I/O1L); also elsewhere on the board
/rs1[2]: P1.173 (rs1[2]); also elsewhere on the board
/rs1[2]': U4.93 (I/O2L); also elsewhere on the board
/rs1[3]: P1.171 (rs1[3]); also elsewhere on the board
/rs1[3]': U4.94 (I/O3L); also elsewhere on the board
/rs1[4]: P1.170 (rs1[4]); also elsewhere on the board
/rs1[4]': U4.95 (I/O4L); also elsewhere on the board
/rs1[5]: P1.169 (rs1[5]); also elsewhere on the board
/rs1[5]': U4.96 (I/O5L); also elsewhere on the board
/rs1[6]: P1.168 (rs1[6]); also elsewhere on the board
/rs1[6]': U4.97 (I/O6L); also elsewhere on the board
/rs1[7]: P1.166 (rs1[7]); also elsewhere on the board
/rs1[7]': U4.98 (I/O7L); also elsewhere on the board
/rs1[8]: P1.165 (rs1[8]); also elsewhere on the board
/rs1[8]': U4.99 (I/O8L); also elsewhere on the board
/rs1[9]: P1.163 (rs1[9]); also elsewhere on the board
/rs1[9]': U4.100 (I/O9L); also elsewhere on the board
/rs1[10]: P1.162 (rs1[10]); also elsewhere on the board
/rs1[10]': U4.5 (I/O10L); also elsewhere on the board
/rs1[11]: P1.160 (rs1[11]); also elsewhere on the board
/rs1[11]': U4.6 (I/O11L); also elsewhere on the board
/rs1[12]: P1.159 (rs1[12]); also elsewhere on the board
/rs1[12]': U4.7 (I/O12L); also elsewhere on the board
/rs1[13]: P1.158 (rs1[13]); also elsewhere on the board
/rs1[13]': U4.8 (I/O13L); also elsewhere on the board
/rs1[14]: P1.157 (rs1[14]); also elsewhere on the board
/rs1[14]': U4.10 (I/O14L); also elsewhere on the board
/rs1[15]: P1.155 (rs1[15]); also elsewhere on the board
/rs1[15]': U4.11 (I/O15L); also elsewhere on the board
/rs1[16]: P1.120 (rs1[16]); also elsewhere on the board
/rs1[16]': U3.90 (I/O0L); also elsewhere on the board
/rs1[17]: P1.119 (rs1[17]); also elsewhere on the board
/rs1[17]': U3.91 (I/O1L); also elsewhere on the board
/rs1[18]: P1.117 (rs1[18]); also elsewhere on the board
/rs1[18]': U3.93 (I/O2L); also elsewhere on the board
/rs1[19]: P1.116 (rs1[19]); also elsewhere on the board
/rs1[19]': U3.94 (I/O3L); also elsewhere on the board
/rs1[20]: P1.114 (rs1[20]); also elsewhere on the board
/rs1[20]': U3.95 (I/O4L); also elsewhere on the board
/rs1[21]: P1.113 (rs1[21]); also elsewhere on the board
/rs1[21]': U3.96 (I/O5L); also elsewhere on the board
/rs1[22]: P1.111 (rs1[22]); also elsewhere on the board
/rs1[22]': U3.97 (I/O6L); also elsewhere on the board
/rs1[23]: P1.110 (rs1[23]); also elsewhere on the board
/rs1[23]': U3.98 (I/O7L); also elsewhere on the board
/rs1[24]: P1.109 (rs1[24]); also elsewhere on the board
/rs1[24]': U3.99 (I/O8L); also elsewhere on the board
/rs1[25]: P1.108 (rs1[25]); also elsewhere on the board
/rs1[25]': U3.100 (I/O9L); also elsewhere on the board
/rs1[26]: P1.106 (rs1[26]); also elsewhere on the board
/rs1[26]': U3.5 (I/O10L); also elsewhere on the board
/rs1[27]: P1.105 (rs1[27]); also elsewhere on the board
/rs1[27]': U3.6 (I/O11L); also elsewhere on the board
/rs1[28]: P1.103 (rs1[28]); also elsewhere on the board
/rs1[28]': U3.7 (I/O12L); also elsewhere on the board
/rs1[29]: P1.102 (rs1[29]); also elsewhere on the board
/rs1[29]': U3.8 (I/O13L); also elsewhere on the board
/rs1[30]: P1.100 (rs1[30]); also elsewhere on the board
/rs1[30]': U3.10 (I/O14L); also elsewhere on the board
/rs1[31]: P1.99 (rs1[31]); also elsewhere on the board
/rs1[31]': U3.11 (I/O15L); also elsewhere on the board
/rs1_zero: U3.89 (~OE~L), U4.89 (~OE~L), U23.2
/rs1a[0]: P1.154 (rs1a[0]); also elsewhere on the board
/rs1a[0]': U3.66 (A0L), U4.66 (A0L), U21.1 (A0); also elsewhere on the board
/rs1a[1]: P1.152 (rs1a[1]); also elsewhere on the board
/rs1a[1]': U3.67 (A1L), U4.67 (A1L), U21.2 (A1); also elsewhere on the board
/rs1a[2]: P1.151 (rs1a[2]); also elsewhere on the board
/rs1a[2]': U3.68 (A2L), U4.68 (A2L), U21.3 (A2); also elsewhere on the board
/rs1a[3]: P1.149 (rs1a[3]); also elsewhere on the board
/rs1a[3]': U3.69 (A3L), U4.69 (A3L), U21.4 (E1); also elsewhere on the board
/rs1a[4]: P1.148 (rs1a[4]); also elsewhere on the board
/rs1a[4]': U3.70 (A4L), U4.70 (A4L), U21.5 (E2); also elsewhere on the board
/rs2[0]: P1.93 (rs2[0]); also elsewhere on the board
/rs2[0]': U2.35 (I/O15R); also elsewhere on the board
/rs2[1]: P1.92 (rs2[1]); also elsewhere on the board
/rs2[1]': U2.33 (I/O14R); also elsewhere on the board
/rs2[2]: P1.90 (rs2[2]); also elsewhere on the board
/rs2[2]': U2.32 (I/O13R); also elsewhere on the board
/rs2[3]: P1.89 (rs2[3]); also elsewhere on the board
/rs2[3]': U2.31 (I/O12R); also elsewhere on the board
/rs2[4]: P1.87 (rs2[4]); also elsewhere on the board
/rs2[4]': U2.30 (I/O11R); also elsewhere on the board
/rs2[5]: P1.86 (rs2[5]); also elsewhere on the board
/rs2[5]': U2.29 (I/O10R); also elsewhere on the board
/rs2[6]: P1.84 (rs2[6]); also elsewhere on the board
/rs2[6]': U2.28 (I/O9R); also elsewhere on the board
/rs2[7]: P1.83 (rs2[7]); also elsewhere on the board
/rs2[7]': U2.27 (I/O8R); also elsewhere on the board
/rs2[8]: P1.82 (rs2[8]); also elsewhere on the board
/rs2[8]': U2.26 (I/O7R); also elsewhere on the board
/rs2[9]: P1.81 (rs2[9]); also elsewhere on the board
/rs2[9]': U2.21 (I/O6R); also elsewhere on the board
/rs2[10]: P1.79 (rs2[10]); also elsewhere on the board
/rs2[10]': U2.20 (I/O5R); also elsewhere on the board
/rs2[11]: P1.78 (rs2[11]); also elsewhere on the board
/rs2[11]': U2.19 (I/O4R); also elsewhere on the board
/rs2[12]: P1.76 (rs2[12]); also elsewhere on the board
/rs2[12]': U2.18 (I/O3R); also elsewhere on the board
/rs2[13]: P1.75 (rs2[13]); also elsewhere on the board
/rs2[13]': U2.16 (I/O2R); also elsewhere on the board
/rs2[14]: P1.73 (rs2[14]); also elsewhere on the board
/rs2[14]': U2.15 (I/O1R); also elsewhere on the board
/rs2[15]: P1.72 (rs2[15]); also elsewhere on the board
/rs2[15]': U2.14 (I/O0R); also elsewhere on the board
/rs2[16]: P1.44 (rs2[16]); also elsewhere on the board
/rs2[16]': U1.35 (I/O15R); also elsewhere on the board
/rs2[17]: P1.43 (rs2[17]); also elsewhere on the board
/rs2[17]': U1.33 (I/O14R); also elsewhere on the board
/rs2[18]: P1.41 (rs2[18]); also elsewhere on the board
/rs2[18]': U1.32 (I/O13R); also elsewhere on the board
/rs2[19]: P1.40 (rs2[19]); also elsewhere on the board
/rs2[19]': U1.31 (I/O12R); also elsewhere on the board
/rs2[20]: P1.38 (rs2[20]); also elsewhere on the board
/rs2[20]': U1.30 (I/O11R); also elsewhere on the board
/rs2[21]: P1.37 (rs2[21]); also elsewhere on the board
/rs2[21]': U1.29 (I/O10R); also elsewhere on the board
/rs2[22]: P1.35 (rs2[22]); also elsewhere on the board
/rs2[22]': U1.28 (I/O9R); also elsewhere on the board
/rs2[23]: P1.34 (rs2[23]); also elsewhere on the board
/rs2[23]': U1.27 (I/O8R); also elsewhere on the board
/rs2[24]: P1.33 (rs2[24]); also elsewhere on the board
/rs2[24]': U1.26 (I/O7R); also elsewhere on the board
/rs2[25]: P1.32 (rs2[25]); also elsewhere on the board
/rs2[25]': U1.21 (I/O6R); also elsewhere on the board
/rs2[26]: P1.30 (rs2[26]); also elsewhere on the board
/rs2[26]': U1.20 (I/O5R); also elsewhere on the board
/rs2[27]: P1.29 (rs2[27]); also elsewhere on the board
/rs2[27]': U1.19 (I/O4R); also elsewhere on the board
/rs2[28]: P1.27 (rs2[28]); also elsewhere on the board
/rs2[28]': U1.18 (I/O3R); also elsewhere on the board
/rs2[29]: P1.26 (rs2[29]); also elsewhere on the board
/rs2[29]': U1.16 (I/O2R); also elsewhere on the board
/rs2[30]: P1.24 (rs2[30]); also elsewhere on the board
/rs2[30]': U1.15 (I/O1R); also elsewhere on the board
/rs2[31]: P1.23 (rs2[31]); also elsewhere on the board
/rs2[31]': U1.14 (I/O0R); also elsewhere on the board
/rs2_zero: U1.36 (~OE~R), U2.36 (~OE~R), U23.4
/rs2a[0]: P1.147 (rs2a[0]); also elsewhere on the board
/rs2a[0]': U1.59 (A0R), U2.59 (A0R), U22.1 (A0); also elsewhere on the board
/rs2a[1]: P1.146 (rs2a[1]); also elsewhere on the board
/rs2a[1]': U1.58 (A1R), U2.58 (A1R), U22.2 (A1); also elsewhere on the board
/rs2a[2]: P1.145 (rs2a[2]); also elsewhere on the board
/rs2a[2]': U1.57 (A2R), U2.57 (A2R), U22.3 (A2); also elsewhere on the board
/rs2a[3]: P1.144 (rs2a[3]); also elsewhere on the board
/rs2a[3]': U1.56 (A3R), U2.56 (A3R), U22.4 (E1); also elsewhere on the board
/rs2a[4]: P1.143 (rs2a[4]); also elsewhere on the board
/rs2a[4]': U1.55 (A4R), U2.55 (A4R), U22.5 (E2); also elsewhere on the board
/~rd_wr: P1.124 (~rd_wr); also elsewhere on the board
/~rd_wr~': R3.2, U1.87 (R/~W~L), U2.87 (R/~W~L), U3.37 (R/~W~R), U4.37 (R/~W~R); also elsewhere on the board
/~rs1_rd: P1.132 (~rs1_rd); also elsewhere on the board
/~rs1_rd~': R2.2; also elsewhere on the board
/~rs1_zero: R5.2, U21.15 (O0), U23.1; also elsewhere on the board
/~rs2_rd: P1.128 (~rs2_rd); also elsewhere on the board
/~rs2_rd~': R1.2; also elsewhere on the board
/~rs2_zero: R4.2, U22.15 (O0), U23.3; also elsewhere on the board
GND: C1.2, C2.2, C3.2, C4.2, C5.2, C6.2, C7.2, C8.2, C9.2, C10.2, C11.2, C12.2, C37.2, C38.2, C39.2, P1.3 (GND), P1.9 (GND), P1.14 (GND), P1.20 (GND), P1.25 (GND), P1.31 (GND), P1.36 (GND), P1.42 (GND), P1.52 (GND), P1.58 (GND), P1.63 (GND), P1.69 (GND), P1.74 (GND), P1.80 (GND), P1.85 (GND), P1.91 (GND), P1.101 (GND), P1.107 (GND), P1.112 (GND), P1.118 (GND), P1.123 (GND), P1.129 (GND), P1.134 (GND), P1.140 (GND), P1.150 (GND), P1.156 (GND), P1.161 (GND), P1.167 (GND), P1.172 (GND), P1.178 (GND), P1.183 (GND), P1.189 (GND), U1.9 (GND), U1.13 (GND), U1.34 (GND), U1.38 (GND), U1.40 (~CE~R), U1.41 (~UB~R), U1.42 (~LB~R), U1.44 (A11R), U1.45 (A10R), U1.46 (A9R), U1.47 (A8R), U1.48 (A7R), U1.49 (A6R), U1.50 (A5R), U1.62 (M/~S~), U1.63 (GND), U1.71 (A5L), U1.76 (A6L), U1.77 (A7L), U1.78 (A8L), U1.79 (A9L), U1.80 (A10L), U1.81 (A11L), U1.83 (~LB~L), U1.84 (~UB~L), U1.85 (~CE~L), U1.92 (GND), U2.9 (GND), U2.13 (GND), U2.34 (GND), U2.38 (GND), U2.40 (~CE~R), U2.41 (~UB~R), U2.42 (~LB~R), U2.44 (A11R), U2.45 (A10R), U2.46 (A9R), U2.47 (A8R), U2.48 (A7R), U2.49 (A6R), U2.50 (A5R), U2.62 (M/~S~), U2.63 (GND), U2.71 (A5L), U2.76 (A6L), U2.77 (A7L), U2.78 (A8L), U2.79 (A9L), U2.80 (A10L), U2.81 (A11L), U2.83 (~LB~L), U2.84 (~UB~L), U2.85 (~CE~L), U2.92 (GND), U3.9 (GND), U3.13 (GND), U3.34 (GND), U3.38 (GND), U3.40 (~CE~R), U3.41 (~UB~R), U3.42 (~LB~R), U3.44 (A11R), U3.45 (A10R), U3.46 (A9R), U3.47 (A8R), U3.48 (A7R), U3.49 (A6R), U3.50 (A5R), U3.62 (M/~S~), U3.63 (GND), U3.71 (A5L), U3.76 (A6L), U3.77 (A7L), U3.78 (A8L), U3.79 (A9L), U3.80 (A10L), U3.81 (A11L), U3.83 (~LB~L), U3.84 (~UB~L), U3.85 (~CE~L), U3.92 (GND), U4.9 (GND), U4.13 (GND), U4.34 (GND), U4.38 (GND), U4.40 (~CE~R), U4.41 (~UB~R), U4.42 (~LB~R), U4.44 (A11R), U4.45 (A10R), U4.46 (A9R), U4.47 (A8R), U4.48 (A7R), U4.49 (A6R), U4.50 (A5R), U4.62 (M/~S~), U4.63 (GND), U4.71 (A5L), U4.76 (A6L), U4.77 (A7L), U4.78 (A8L), U4.79 (A9L), U4.80 (A10L), U4.81 (A11L), U4.83 (~LB~L), U4.84 (~UB~L), U4.85 (~CE~L), U4.92 (GND), U21.8 (GND), U22.8 (GND), U23.7 (GND); also elsewhere on the board
VCC: C1.1, C2.1, C3.1, C4.1, C5.1, C6.1, C7.1, C8.1, C9.1, C10.1, C11.1, C12.1, C37.1, C38.1, C39.1, P1.6 (VDD), P1.17 (VDD), P1.28 (VDD), P1.39 (VDD), P1.55 (VDD), P1.66 (VDD), P1.77 (VDD), P1.88 (VDD), P1.104 (VDD), P1.115 (VDD), P1.126 (VDD), P1.137 (VDD), P1.153 (VDD), P1.164 (VDD), P1.175 (VDD), P1.186 (VDD), R1.1, R2.1, R3.1, R4.1, R5.1, U1.12 (VCC), U1.17 (VCC), U1.37 (R/~W~R), U1.39 (~SEM~R), U1.61 (~BUSY~R), U1.64 (~BUSY~L), U1.86 (~SEM~L), U1.88 (VCC), U1.89 (~OE~L), U2.12 (VCC), U2.17 (VCC), U2.37 (R/~W~R), U2.39 (~SEM~R), U2.61 (~BUSY~R), U2.64 (~BUSY~L), U2.86 (~SEM~L), U2.88 (VCC), U2.89 (~OE~L), U3.12 (VCC), U3.17 (VCC), U3.36 (~OE~R), U3.39 (~SEM~R), U3.61 (~BUSY~R), U3.64 (~BUSY~L), U3.86 (~SEM~L), U3.87 (R/~W~L), U3.88 (VCC), U4.12 (VCC), U4.17 (VCC), U4.36 (~OE~R), U4.39 (~SEM~R), U4.61 (~BUSY~R), U4.64 (~BUSY~L), U4.86 (~SEM~L), U4.87 (R/~W~L), U4.88 (VCC), U21.6 (E3), U21.16 (VCC), U22.6 (E3), U22.16 (VCC), U23.14 (VCC); also elsewhere on the board

Notes on the sheet:
RS2
RS1
