RobertBaruch/lmarv/lmarv-1/ram-based-register-card/ram-based-register-card.kicad_pcb

## KiCad design lmarv-1/ram-based-register-card/ram-based-register-card.kicad_pcb (continued)

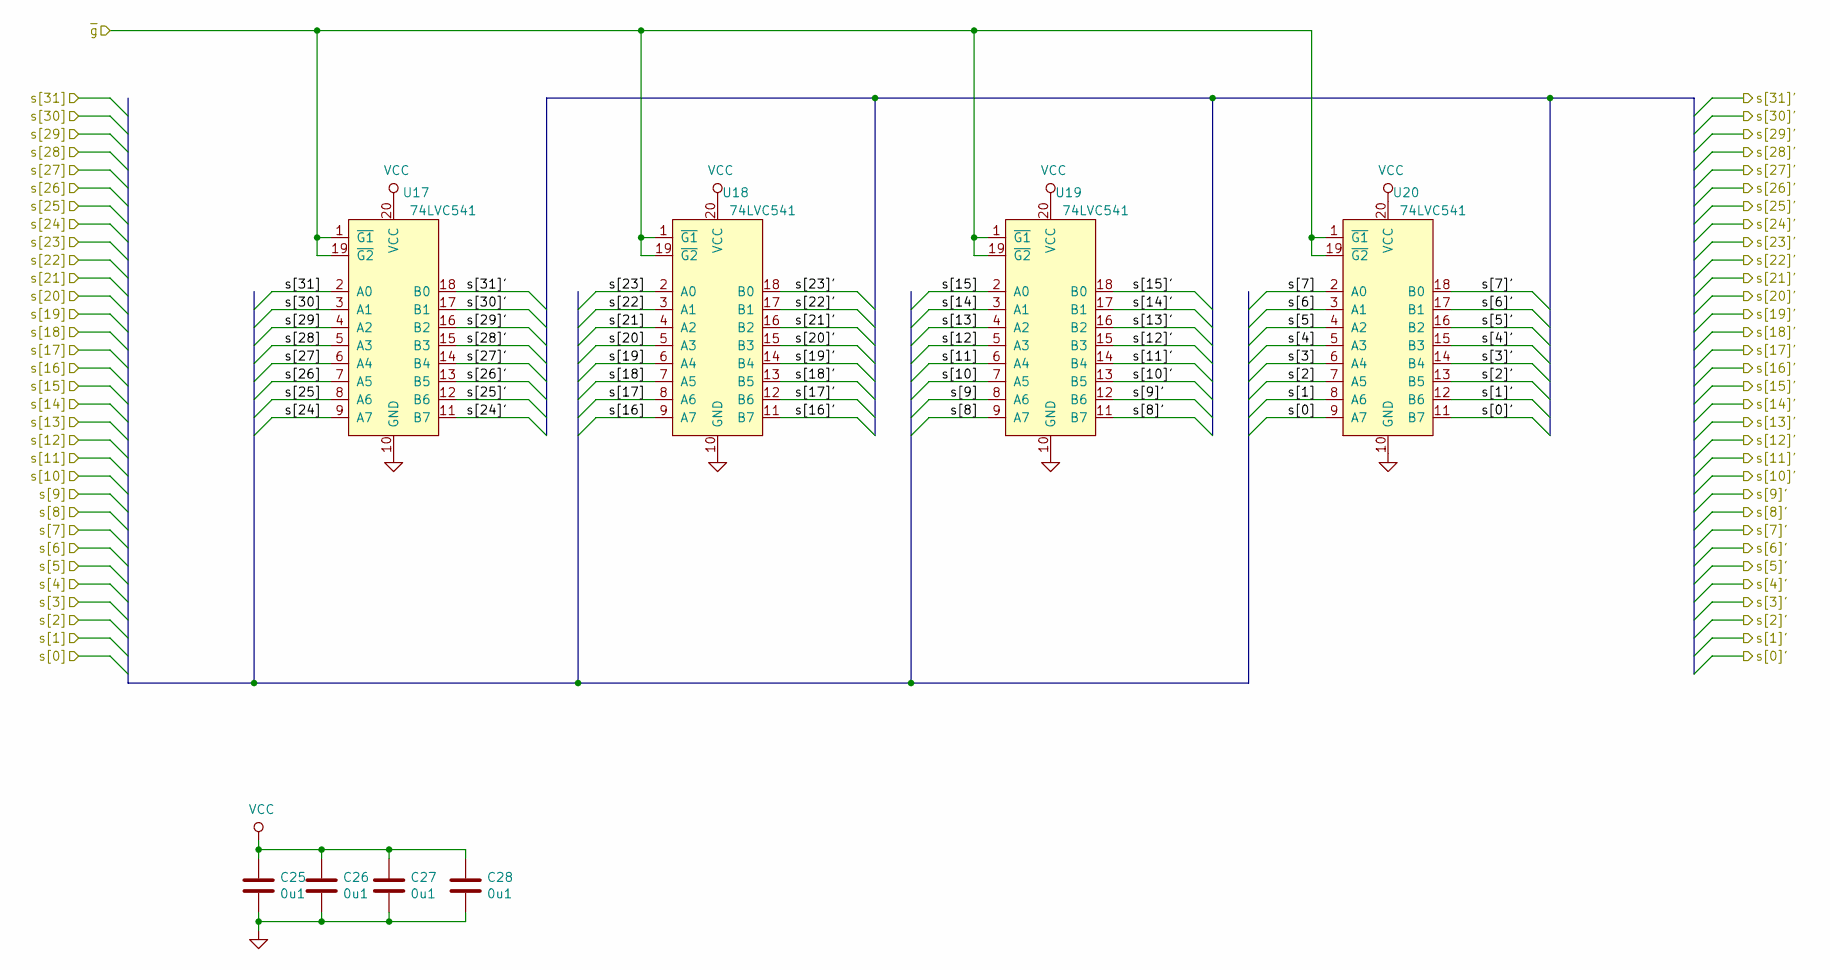
[picture p47: schematic buffer32.sch]

Parts:
C13, C14, C15, C16: 0u1; C_0603_1608Metric
U5, U6, U7, U8: 74LVC541; TSSOP-20_4.4x6.5mm_P0.65mm

Connections:
/rs1[0]: U8.11 (B7); also elsewhere on the board
/rs1[0]': U8.9 (A7); also elsewhere on the board
/rs1[1]: U8.12 (B6); also elsewhere on the board
/rs1[1]': U8.8 (A6); also elsewhere on the board
/rs1[2]: U8.13 (B5); also elsewhere on the board
/rs1[2]': U8.7 (A5); also elsewhere on the board
/rs1[3]: U8.14 (B4); also elsewhere on the board
/rs1[3]': U8.6 (A4); also elsewhere on the board
/rs1[4]: U8.15 (B3); also elsewhere on the board
/rs1[4]': U8.5 (A3); also elsewhere on the board
/rs1[5]: U8.16 (B2); also elsewhere on the board
/rs1[5]': U8.4 (A2); also elsewhere on the board
/rs1[6]: U8.17 (B1); also elsewhere on the board
/rs1[6]': U8.3 (A1); also elsewhere on the board
/rs1[7]: U8.18 (B0); also elsewhere on the board
/rs1[7]': U8.2 (A0); also elsewhere on the board
/rs1[8]: U7.11 (B7); also elsewhere on the board
/rs1[8]': U7.9 (A7); also elsewhere on the board
/rs1[9]: U7.12 (B6); also elsewhere on the board
/rs1[9]': U7.8 (A6); also elsewhere on the board
/rs1[10]: U7.13 (B5); also elsewhere on the board
/rs1[10]': U7.7 (A5); also elsewhere on the board
/rs1[11]: U7.14 (B4); also elsewhere on the board
/rs1[11]': U7.6 (A4); also elsewhere on the board
/rs1[12]: U7.15 (B3); also elsewhere on the board
/rs1[12]': U7.5 (A3); also elsewhere on the board
/rs1[13]: U7.16 (B2); also elsewhere on the board
/rs1[13]': U7.4 (A2); also elsewhere on the board
/rs1[14]: U7.17 (B1); also elsewhere on the board
/rs1[14]': U7.3 (A1); also elsewhere on the board
/rs1[15]: U7.18 (B0); also elsewhere on the board
/rs1[15]': U7.2 (A0); also elsewhere on the board
/rs1[16]: U6.11 (B7); also elsewhere on the board
/rs1[16]': U6.9 (A7); also elsewhere on the board
/rs1[17]: U6.12 (B6); also elsewhere on the board
/rs1[17]': U6.8 (A6); also elsewhere on the board
/rs1[18]: U6.13 (B5); also elsewhere on the board
/rs1[18]': U6.7 (A5); also elsewhere on the board
/rs1[19]: U6.14 (B4); also elsewhere on the board
/rs1[19]': U6.6 (A4); also elsewhere on the board
/rs1[20]: U6.15 (B3); also elsewhere on the board
/rs1[20]': U6.5 (A3); also elsewhere on the board
/rs1[21]: U6.16 (B2); also elsewhere on the board
/rs1[21]': U6.4 (A2); also elsewhere on the board
/rs1[22]: U6.17 (B1); also elsewhere on the board
/rs1[22]': U6.3 (A1); also elsewhere on the board
/rs1[23]: U6.18 (B0); also elsewhere on the board
/rs1[23]': U6.2 (A0); also elsewhere on the board
/rs1[24]: U5.11 (B7); also elsewhere on the board
/rs1[24]': U5.9 (A7); also elsewhere on the board
/rs1[25]: U5.12 (B6); also elsewhere on the board
/rs1[25]': U5.8 (A6); also elsewhere on the board
/rs1[26]: U5.13 (B5); also elsewhere on the board
/rs1[26]': U5.7 (A5); also elsewhere on the board
/rs1[27]: U5.14 (B4); also elsewhere on the board
/rs1[27]': U5.6 (A4); also elsewhere on the board
/rs1[28]: U5.15 (B3); also elsewhere on the board
/rs1[28]': U5.5 (A3); also elsewhere on the board
/rs1[29]: U5.16 (B2); also elsewhere on the board
/rs1[29]': U5.4 (A2); also elsewhere on the board
/rs1[30]: U5.17 (B1); also elsewhere on the board
/rs1[30]': U5.3 (A1); also elsewhere on the board
/rs1[31]: U5.18 (B0); also elsewhere on the board
/rs1[31]': U5.2 (A0); also elsewhere on the board
/~rs1_rd~': U5.1 (~G1), U5.19 (~G2), U6.1 (~G1), U6.19 (~G2), U7.1 (~G1), U7.19 (~G2), U8.1 (~G1), U8.19 (~G2); also elsewhere on the board
GND: C13.2, C14.2, C15.2, C16.2, U5.10 (GND), U6.10 (GND), U7.10 (GND), U8.10 (GND); also elsewhere on the board
VCC: C13.1, C14.1, C15.1, C16.1, U5.20 (VCC), U6.20 (VCC), U7.20 (VCC), U8.20 (VCC); also elsewhere on the board

Parts of its further copies:
C17, C18, C19, C20, C21, C22, C23, C24, C25, C26, C27, C28, C29, C30, C31, C32, C33, C34, C35, C36: 0u1; C_0603_1608Metric
U13, U14, U15, U16, U17, U18, U19, U20, U28, U29, U30, U31, U32: 74LVC541; TSSOP-20_4.4x6.5mm_P0.65mm

Connections of its further copies:
/Buffer_ctrl/s[0]': U20.11 (B7)
/Buffer_ctrl/s[1]': U20.12 (B6)
/Buffer_ctrl/s[2]': U20.13 (B5)
/Buffer_ctrl/s[18]': U18.13 (B5)
/Buffer_ctrl/s[19]': U18.14 (B4)
/Buffer_ctrl/s[20]': U18.15 (B3)
/Buffer_ctrl/s[21]': U18.16 (B2)
/Buffer_ctrl/s[22]': U18.17 (B1)
/Buffer_ctrl/s[23]': U18.18 (B0)
/Buffer_ctrl/s[27]': U17.14 (B4)
/Buffer_ctrl/s[28]': U17.15 (B3)
/Buffer_ctrl/s[29]': U17.16 (B2)
/Buffer_ctrl/s[30]': U17.17 (B1)
/Buffer_ctrl/s[31]': U17.18 (B0)
/rd[0]: U16.9 (A7); also elsewhere on the board
/rd[0]': U16.11 (B7); also elsewhere on the board
/rd[1]: U16.8 (A6); also elsewhere on the board
/rd[1]': U16.12 (B6); also elsewhere on the board
/rd[2]: U16.7 (A5); also elsewhere on the board
/rd[2]': U16.13 (B5); also elsewhere on the board
/rd[3]: U16.6 (A4); also elsewhere on the board
/rd[3]': U16.14 (B4); also elsewhere on the board
/rd[4]: U16.5 (A3); also elsewhere on the board
/rd[4]': U16.15 (B3); also elsewhere on the board
/rd[5]: U16.4 (A2); also elsewhere on the board
/rd[5]': U16.16 (B2); also elsewhere on the board
/rd[6]: U16.3 (A1); also elsewhere on the board
/rd[6]': U16.17 (B1); also elsewhere on the board
/rd[7]: U16.2 (A0); also elsewhere on the board
/rd[7]': U16.18 (B0); also elsewhere on the board
/rd[8]: U15.9 (A7); also elsewhere on the board
/rd[8]': U15.11 (B7); also elsewhere on the board
/rd[9]: U15.8 (A6); also elsewhere on the board
/rd[9]': U15.12 (B6); also elsewhere on the board
/rd[10]: U15.7 (A5); also elsewhere on the board
/rd[10]': U15.13 (B5); also elsewhere on the board
/rd[11]: U15.6 (A4); also elsewhere on the board
/rd[11]': U15.14 (B4); also elsewhere on the board
/rd[12]: U15.5 (A3); also elsewhere on the board
/rd[12]': U15.15 (B3); also elsewhere on the board
/rd[13]: U15.4 (A2); also elsewhere on the board
/rd[13]': U15.16 (B2); also elsewhere on the board
/rd[14]: U15.3 (A1); also elsewhere on the board
/rd[14]': U15.17 (B1); also elsewhere on the board
/rd[15]: U15.2 (A0); also elsewhere on the board
/rd[15]': U15.18 (B0); also elsewhere on the board
/rd[16]: U14.9 (A7); also elsewhere on the board
/rd[16]': U14.11 (B7); also elsewhere on the board
/rd[17]: U14.8 (A6); also elsewhere on the board
/rd[17]': U14.12 (B6); also elsewhere on the board
/rd[18]: U14.7 (A5); also elsewhere on the board
/rd[18]': U14.13 (B5); also elsewhere on the board
/rd[19]: U14.6 (A4); also elsewhere on the board
/rd[19]': U14.14 (B4); also elsewhere on the board
/rd[20]: U14.5 (A3); also elsewhere on the board
/rd[20]': U14.15 (B3); also elsewhere on the board
/rd[21]: U14.4 (A2); also elsewhere on the board
/rd[21]': U14.16 (B2); also elsewhere on the board
/rd[22]: U14.3 (A1); also elsewhere on the board
/rd[22]': U14.17 (B1); also elsewhere on the board
/rd[23]: U14.2 (A0); also elsewhere on the board
/rd[23]': U14.18 (B0); also elsewhere on the board
/rd[24]: U13.9 (A7); also elsewhere on the board
/rd[24]': U13.11 (B7); also elsewhere on the board
/rd[25]: U13.8 (A6); also elsewhere on the board
/rd[25]': U13.12 (B6); also elsewhere on the board
/rd[26]: U13.7 (A5); also elsewhere on the board
/rd[26]': U13.13 (B5); also elsewhere on the board
/rd[27]: U13.6 (A4); also elsewhere on the board
/rd[27]': U13.14 (B4); also elsewhere on the board
/rd[28]: U13.5 (A3); also elsewhere on the board
/rd[28]': U13.15 (B3); also elsewhere on the board
/rd[29]: U13.4 (A2); also elsewhere on the board
/rd[29]': U13.16 (B2); also elsewhere on the board
/rd[30]: U13.3 (A1); also elsewhere on the board
/rd[30]': U13.17 (B1); also elsewhere on the board
/rd[31]: U13.2 (A0); also elsewhere on the board
/rd[31]': U13.18 (B0); also elsewhere on the board
/rda[0]: U20.2 (A0); also elsewhere on the board
/rda[0]': U20.18 (B0); also elsewhere on the board
/rda[1]: U20.3 (A1); also elsewhere on the board
/rda[1]': U20.17 (B1); also elsewhere on the board
/rda[2]: U20.4 (A2); also elsewhere on the board
/rda[2]': U20.16 (B2); also elsewhere on the board
/rda[3]: U20.5 (A3); also elsewhere on the board
/rda[3]': U20.15 (B3); also elsewhere on the board
/rda[4]: U20.6 (A4); also elsewhere on the board
/rda[4]': U20.14 (B4); also elsewhere on the board
/rs1a[0]: U18.8 (A6); also elsewhere on the board
/rs1a[0]': U18.12 (B6); also elsewhere on the board
/rs1a[1]: U18.9 (A7); also elsewhere on the board
/rs1a[1]': U18.11 (B7); also elsewhere on the board
/rs1a[2]: U19.2 (A0); also elsewhere on the board
/rs1a[2]': U19.18 (B0); also elsewhere on the board
/rs1a[3]: U19.3 (A1); also elsewhere on the board
/rs1a[3]': U19.17 (B1); also elsewhere on the board
/rs1a[4]: U19.4 (A2); also elsewhere on the board
/rs1a[4]': U19.16 (B2); also elsewhere on the board
/rs2[0]': U32.11 (B7); also elsewhere on the board
/rs2[1]': U32.12 (B6); also elsewhere on the board
/rs2[2]': U32.13 (B5); also elsewhere on the board
/rs2[3]': U32.14 (B4); also elsewhere on the board
/rs2[4]': U32.15 (B3); also elsewhere on the board
/rs2[5]': U32.16 (B2); also elsewhere on the board
/rs2[6]': U32.17 (B1); also elsewhere on the board
/rs2[7]': U32.18 (B0); also elsewhere on the board
/rs2[8]': U31.11 (B7); also elsewhere on the board
/rs2[9]': U31.12 (B6); also elsewhere on the board
/rs2[10]': U31.13 (B5); also elsewhere on the board
/rs2[11]': U31.14 (B4); also elsewhere on the board
/rs2[12]': U31.15 (B3); also elsewhere on the board
/rs2[13]': U31.16 (B2); also elsewhere on the board
/rs2[14]': U31.17 (B1); also elsewhere on the board
/rs2[15]': U31.18 (B0); also elsewhere on the board
/rs2[16]': U30.11 (B7); also elsewhere on the board
/rs2[17]': U30.12 (B6); also elsewhere on the board
/rs2[18]': U30.13 (B5); also elsewhere on the board
/rs2[19]': U30.14 (B4); also elsewhere on the board
/rs2[20]': U30.15 (B3); also elsewhere on the board
/rs2[21]': U30.16 (B2); also elsewhere on the board
/rs2[22]': U30.17 (B1); also elsewhere on the board
/rs2[23]': U30.18 (B0); also elsewhere on the board
/rs2[24]': U29.11 (B7); also elsewhere on the board
/rs2[25]': U29.12 (B6); also elsewhere on the board
/rs2[26]': U29.13 (B5); also elsewhere on the board
/rs2[27]': U29.14 (B4); also elsewhere on the board
/rs2[28]': U29.15 (B3); also elsewhere on the board
/rs2[29]': U29.16 (B2); also elsewhere on the board
/rs2[30]': U29.17 (B1); also elsewhere on the board
/rs2[31]': U29.18 (B0); also elsewhere on the board
/rs2a[0]: U19.5 (A3); also elsewhere on the board
/rs2a[0]': U19.15 (B3); also elsewhere on the board
/rs2a[1]: U19.6 (A4); also elsewhere on the board
/rs2a[1]': U19.14 (B4); also elsewhere on the board
/rs2a[2]: U19.7 (A5); also elsewhere on the board
/rs2a[2]': U19.13 (B5); also elsewhere on the board
/rs2a[3]: U19.8 (A6); also elsewhere on the board
/rs2a[3]': U19.12 (B6); also elsewhere on the board
/rs2a[4]: U19.9 (A7); also elsewhere on the board
/rs2a[4]': U19.11 (B7); also elsewhere on the board
/~rd_wr: U17.9 (A7); also elsewhere on the board
/~rd_wr~': U17.11 (B7); also elsewhere on the board
/~rs1_rd: U17.7 (A5); also elsewhere on the board
/~rs1_rd~': U17.13 (B5); also elsewhere on the board
/~rs2_rd: U17.8 (A6); also elsewhere on the board
/~rs2_rd~': U17.12 (B6); also elsewhere on the board
/~rs2_zero: U29.1 (~G1), U29.19 (~G2), U30.1 (~G1), U30.19 (~G2), U31.1 (~G1), U31.19 (~G2), U32.1 (~G1), U32.19 (~G2); also elsewhere on the board
GND: C17.2, C18.2, C19.2, C20.2, C21.2, C22.2, C23.2, C24.2, C25.2, C26.2, C27.2, C28.2, C29.2, C30.2, C31.2, C32.2, C33.2, C34.2, C35.2, C36.2, U13.1 (~G1), U13.10 (GND), U13.19 (~G2), U14.1 (~G1), U14.10 (GND), U14.19 (~G2), U15.1 (~G1), U15.10 (GND), U15.19 (~G2), U16.1 (~G1), U16.10 (GND), U16.19 (~G2), U17.1 (~G1), U17.2 (A0), U17.3 (A1), U17.4 (A2), U17.5 (A3), U17.6 (A4), U17.10 (GND), U17.19 (~G2), U18.1 (~G1), U18.2 (A0), U18.3 (A1), U18.4 (A2), U18.5 (A3), U18.6 (A4), U18.7 (A5), U18.10 (GND), U18.19 (~G2), U19.1 (~G1), U19.10 (GND), U19.19 (~G2), U20.1 (~G1), U20.7 (A5), U20.8 (A6), U20.9 (A7), U20.10 (GND), U20.19 (~G2), U29.2 (A0), U29.3 (A1), U29.4 (A2), U29.5 (A3), U29.6 (A4), U29.7 (A5), U29.8 (A6), U29.9 (A7), U29.10 (GND), U30.2 (A0), U30.3 (A1), U30.4 (A2), U30.5 (A3), U30.6 (A4), U30.7 (A5), U30.8 (A6), U30.9 (A7), U30.10 (GND), U31.2 (A0), U31.3 (A1), U31.4 (A2), U31.5 (A3), U31.6 (A4), U31.7 (A5), U31.8 (A6), U31.9 (A7), U31.10 (GND), U32.2 (A0), U32.3 (A1), U32.4 (A2), U32.5 (A3), U32.6 (A4), U32.7 (A5), U32.8 (A6), U32.9 (A7), U32.10 (GND); also elsewhere on the board
VCC: C17.1, C18.1, C19.1, C20.1, C21.1, C22.1, C23.1, C24.1, C25.1, C26.1, C27.1, C28.1, C29.1, C30.1, C31.1, C32.1, C33.1, C34.1, C35.1, C36.1, U13.20 (VCC), U14.20 (VCC), U15.20 (VCC), U16.20 (VCC), U17.20 (VCC), U18.20 (VCC), U19.20 (VCC), U20.20 (VCC), U29.20 (VCC), U30.20 (VCC), U31.20 (VCC), U32.20 (VCC); also elsewhere on the board

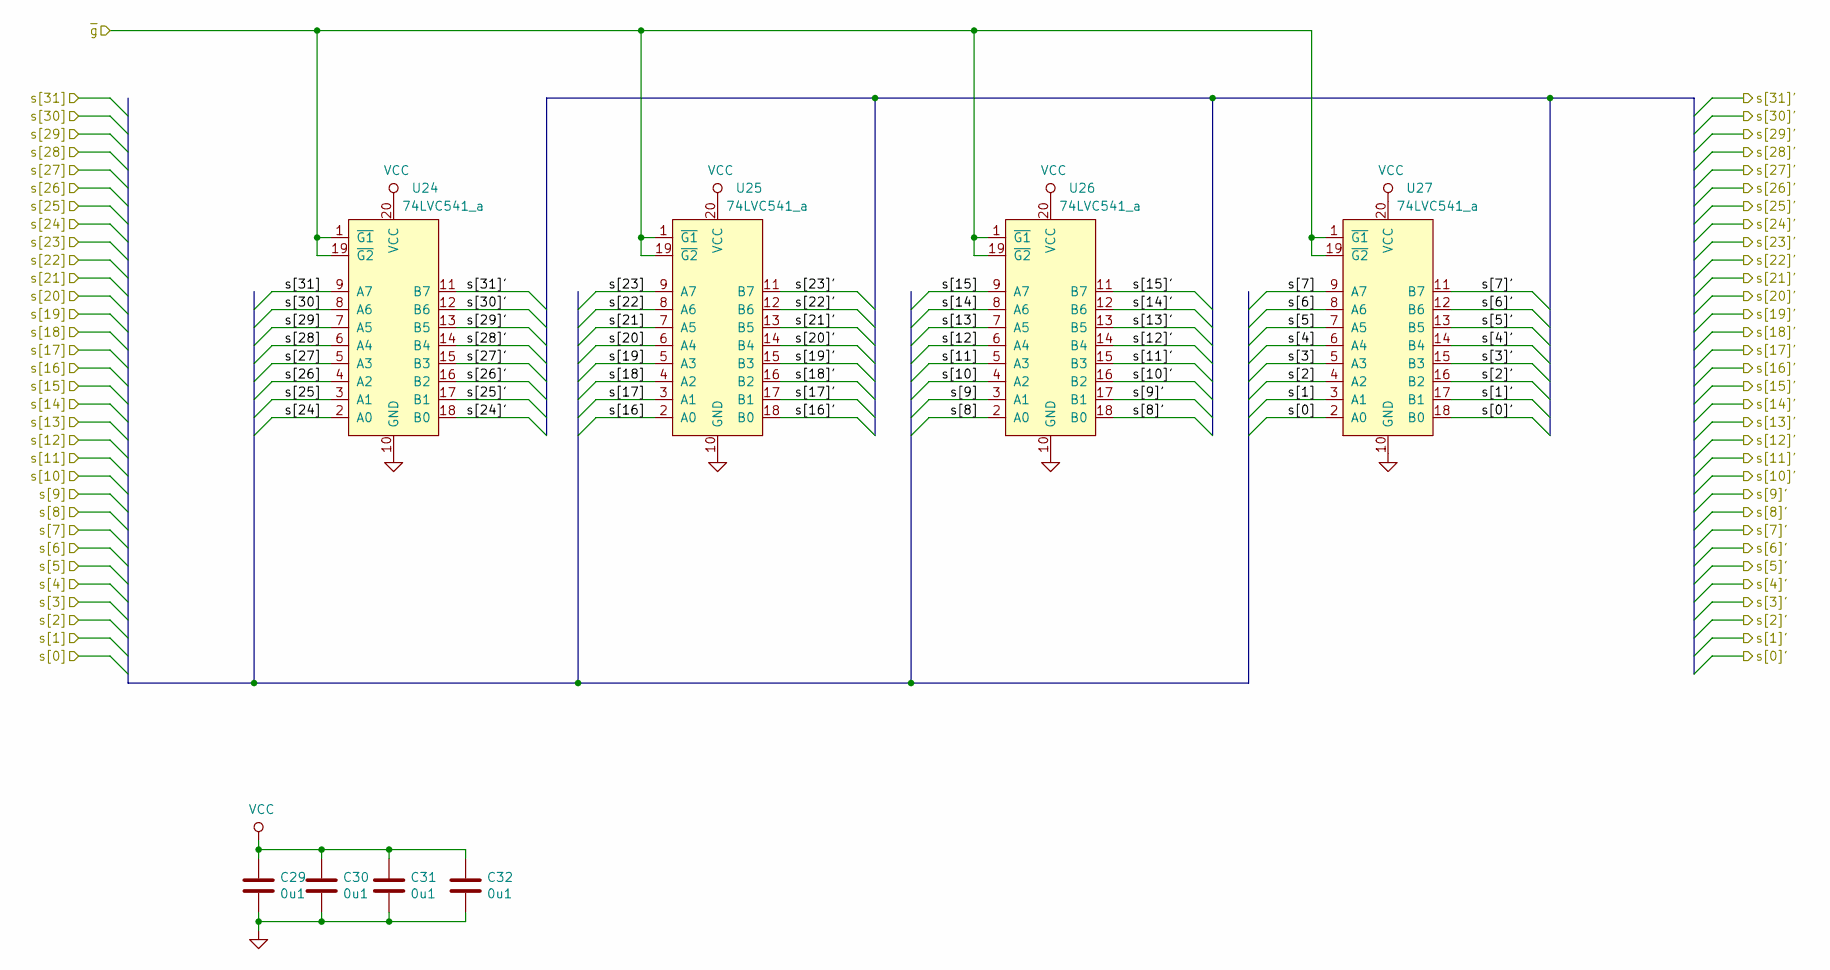
[picture p48: schematic buffer32a.sch]

Parts:
C13, C14, C15, C16: 0u1; C_0603_1608Metric
U9, U10, U11, U12: 74LVC541_a; TSSOP-20_4.4x6.5mm_P0.65mm

Connections:
/rs2[0]: U12.18 (B0); also elsewhere on the board
/rs2[0]': U12.2 (A0); also elsewhere on the board
/rs2[1]: U12.17 (B1); also elsewhere on the board
/rs2[1]': U12.3 (A1); also elsewhere on the board
/rs2[2]: U12.16 (B2); also elsewhere on the board
/rs2[2]': U12.4 (A2); also elsewhere on the board
/rs2[3]: U12.15 (B3); also elsewhere on the board
/rs2[3]': U12.5 (A3); also elsewhere on the board
/rs2[4]: U12.14 (B4); also elsewhere on the board
/rs2[4]': U12.6 (A4); also elsewhere on the board
/rs2[5]: U12.13 (B5); also elsewhere on the board
/rs2[5]': U12.7 (A5); also elsewhere on the board
/rs2[6]: U12.12 (B6); also elsewhere on the board
/rs2[6]': U12.8 (A6); also elsewhere on the board
/rs2[7]: U12.11 (B7); also elsewhere on the board
/rs2[7]': U12.9 (A7); also elsewhere on the board
/rs2[8]: U11.18 (B0); also elsewhere on the board
/rs2[8]': U11.2 (A0); also elsewhere on the board
/rs2[9]: U11.17 (B1); also elsewhere on the board
/rs2[9]': U11.3 (A1); also elsewhere on the board
/rs2[10]: U11.16 (B2); also elsewhere on the board
/rs2[10]': U11.4 (A2); also elsewhere on the board
/rs2[11]: U11.15 (B3); also elsewhere on the board
/rs2[11]': U11.5 (A3); also elsewhere on the board
/rs2[12]: U11.14 (B4); also elsewhere on the board
/rs2[12]': U11.6 (A4); also elsewhere on the board
/rs2[13]: U11.13 (B5); also elsewhere on the board
/rs2[13]': U11.7 (A5); also elsewhere on the board
/rs2[14]: U11.12 (B6); also elsewhere on the board
/rs2[14]': U11.8 (A6); also elsewhere on the board
/rs2[15]: U11.11 (B7); also elsewhere on the board
/rs2[15]': U11.9 (A7); also elsewhere on the board
/rs2[16]: U10.18 (B0); also elsewhere on the board
/rs2[16]': U10.2 (A0); also elsewhere on the board
/rs2[17]: U10.17 (B1); also elsewhere on the board
/rs2[17]': U10.3 (A1); also elsewhere on the board
/rs2[18]: U10.16 (B2); also elsewhere on the board
/rs2[18]': U10.4 (A2); also elsewhere on the board
/rs2[19]: U10.15 (B3); also elsewhere on the board
/rs2[19]': U10.5 (A3); also elsewhere on the board
/rs2[20]: U10.14 (B4); also elsewhere on the board
/rs2[20]': U10.6 (A4); also elsewhere on the board
/rs2[21]: U10.13 (B5); also elsewhere on the board
/rs2[21]': U10.7 (A5); also elsewhere on the board
/rs2[22]: U10.12 (B6); also elsewhere on the board
/rs2[22]': U10.8 (A6); also elsewhere on the board
/rs2[23]: U10.11 (B7); also elsewhere on the board
/rs2[23]': U10.9 (A7); also elsewhere on the board
/rs2[24]: U9.18 (B0); also elsewhere on the board
/rs2[24]': U9.2 (A0); also elsewhere on the board
/rs2[25]: U9.17 (B1); also elsewhere on the board
/rs2[25]': U9.3 (A1); also elsewhere on the board
/rs2[26]: U9.16 (B2); also elsewhere on the board
/rs2[26]': U9.4 (A2); also elsewhere on the board
/rs2[27]: U9.15 (B3); also elsewhere on the board
/rs2[27]': U9.5 (A3); also elsewhere on the board
/rs2[28]: U9.14 (B4); also elsewhere on the board
/rs2[28]': U9.6 (A4); also elsewhere on the board
/rs2[29]: U9.13 (B5); also elsewhere on the board
/rs2[29]': U9.7 (A5); also elsewhere on the board
/rs2[30]: U9.12 (B6); also elsewhere on the board
/rs2[30]': U9.8 (A6); also elsewhere on the board
/rs2[31]: U9.11 (B7); also elsewhere on the board
/rs2[31]': U9.9 (A7); also elsewhere on the board
/~rs2_rd~': U9.1 (~G1), U9.19 (~G2), U10.1 (~G1), U10.19 (~G2), U11.1 (~G1), U11.19 (~G2), U12.1 (~G1), U12.19 (~G2); also elsewhere on the board
GND: C13.2, C14.2, C15.2, C16.2, U9.10 (GND), U10.10 (GND), U11.10 (GND), U12.10 (GND); also elsewhere on the board
VCC: C13.1, C14.1, C15.1, C16.1, U9.20 (VCC), U10.20 (VCC), U11.20 (VCC), U12.20 (VCC); also elsewhere on the board

Parts of its further copies:
C17, C18, C19, C20, C21, C22, C23, C24, C25, C26, C27, C28, C29, C30, C31, C32, C33, C34, C35, C36: 0u1; C_0603_1608Metric
U24, U25, U26, U27: 74LVC541_a; TSSOP-20_4.4x6.5mm_P0.65mm

Connections of its further copies:
/rs1[0]': U27.18 (B0); also elsewhere on the board
/rs1[1]': U27.17 (B1); also elsewhere on the board
/rs1[2]': U27.16 (B2); also elsewhere on the board
/rs1[3]': U27.15 (B3); also elsewhere on the board
/rs1[4]': U27.14 (B4); also elsewhere on the board
/rs1[5]': U27.13 (B5); also elsewhere on the board
/rs1[6]': U27.12 (B6); also elsewhere on the board
/rs1[7]': U27.11 (B7); also elsewhere on the board
/rs1[8]': U26.18 (B0); also elsewhere on the board
/rs1[9]': U26.17 (B1); also elsewhere on the board
/rs1[10]': U26.16 (B2); also elsewhere on the board
/rs1[11]': U26.15 (B3); also elsewhere on the board
/rs1[12]': U26.14 (B4); also elsewhere on the board
/rs1[13]': U26.13 (B5); also elsewhere on the board
/rs1[14]': U26.12 (B6); also elsewhere on the board
/rs1[15]': U26.11 (B7); also elsewhere on the board
/rs1[16]': U25.18 (B0); also elsewhere on the board
/rs1[17]': U25.17 (B1); also elsewhere on the board
/rs1[18]': U25.16 (B2); also elsewhere on the board
/rs1[19]': U25.15 (B3); also elsewhere on the board
/rs1[20]': U25.14 (B4); also elsewhere on the board
/rs1[21]': U25.13 (B5); also elsewhere on the board
/rs1[22]': U25.12 (B6); also elsewhere on the board
/rs1[23]': U25.11 (B7); also elsewhere on the board
/rs1[24]': U24.18 (B0); also elsewhere on the board
/rs1[25]': U24.17 (B1); also elsewhere on the board
/rs1[26]': U24.16 (B2); also elsewhere on the board
/rs1[27]': U24.15 (B3); also elsewhere on the board
/rs1[28]': U24.14 (B4); also elsewhere on the board
/rs1[29]': U24.13 (B5); also elsewhere on the board
/rs1[30]': U24.12 (B6); also elsewhere on the board
/rs1[31]': U24.11 (B7); also elsewhere on the board
/~rs1_zero: U24.1 (~G1), U24.19 (~G2), U25.1 (~G1), U25.19 (~G2), U26.1 (~G1), U26.19 (~G2), U27.1 (~G1), U27.19 (~G2); also elsewhere on the board
GND: C17.2, C18.2, C19.2, C20.2, C21.2, C22.2, C23.2, C24.2, C25.2, C26.2, C27.2, C28.2, C29.2, C30.2, C31.2, C32.2, C33.2, C34.2, C35.2, C36.2, U24.2 (A0), U24.3 (A1), U24.4 (A2), U24.5 (A3), U24.6 (A4), U24.7 (A5), U24.8 (A6), U24.9 (A7), U24.10 (GND), U25.2 (A0), U25.3 (A1), U25.4 (A2), U25.5 (A3), U25.6 (A4), U25.7 (A5), U25.8 (A6), U25.9 (A7), U25.10 (GND), U26.2 (A0), U26.3 (A1), U26.4 (A2), U26.5 (A3), U26.6 (A4), U26.7 (A5), U26.8 (A6), U26.9 (A7), U26.10 (GND), U27.2 (A0), U27.3 (A1), U27.4 (A2), U27.5 (A3), U27.6 (A4), U27.7 (A5), U27.8 (A6), U27.9 (A7), U27.10 (GND); also elsewhere on the board
VCC: C17.1, C18.1, C19.1, C20.1, C21.1, C22.1, C23.1, C24.1, C25.1, C26.1, C27.1, C28.1, C29.1, C30.1, C31.1, C32.1, C33.1, C34.1, C35.1, C36.1, U24.20 (VCC), U25.20 (VCC), U26.20 (VCC), U27.20 (VCC); also elsewhere on the board

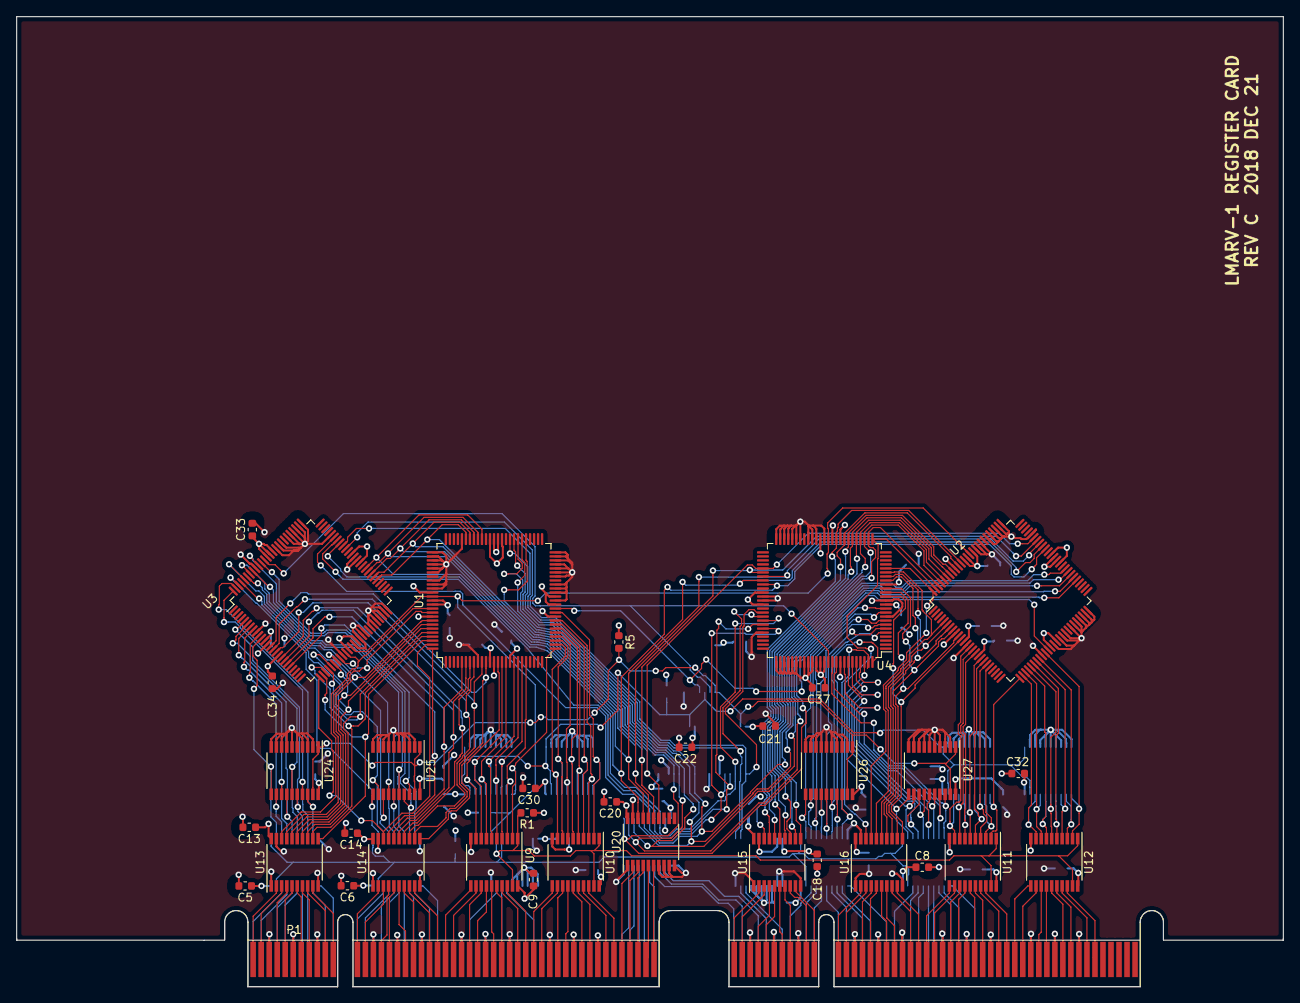
[picture p49: board ram-based-register-card.kicad_pcb from above]

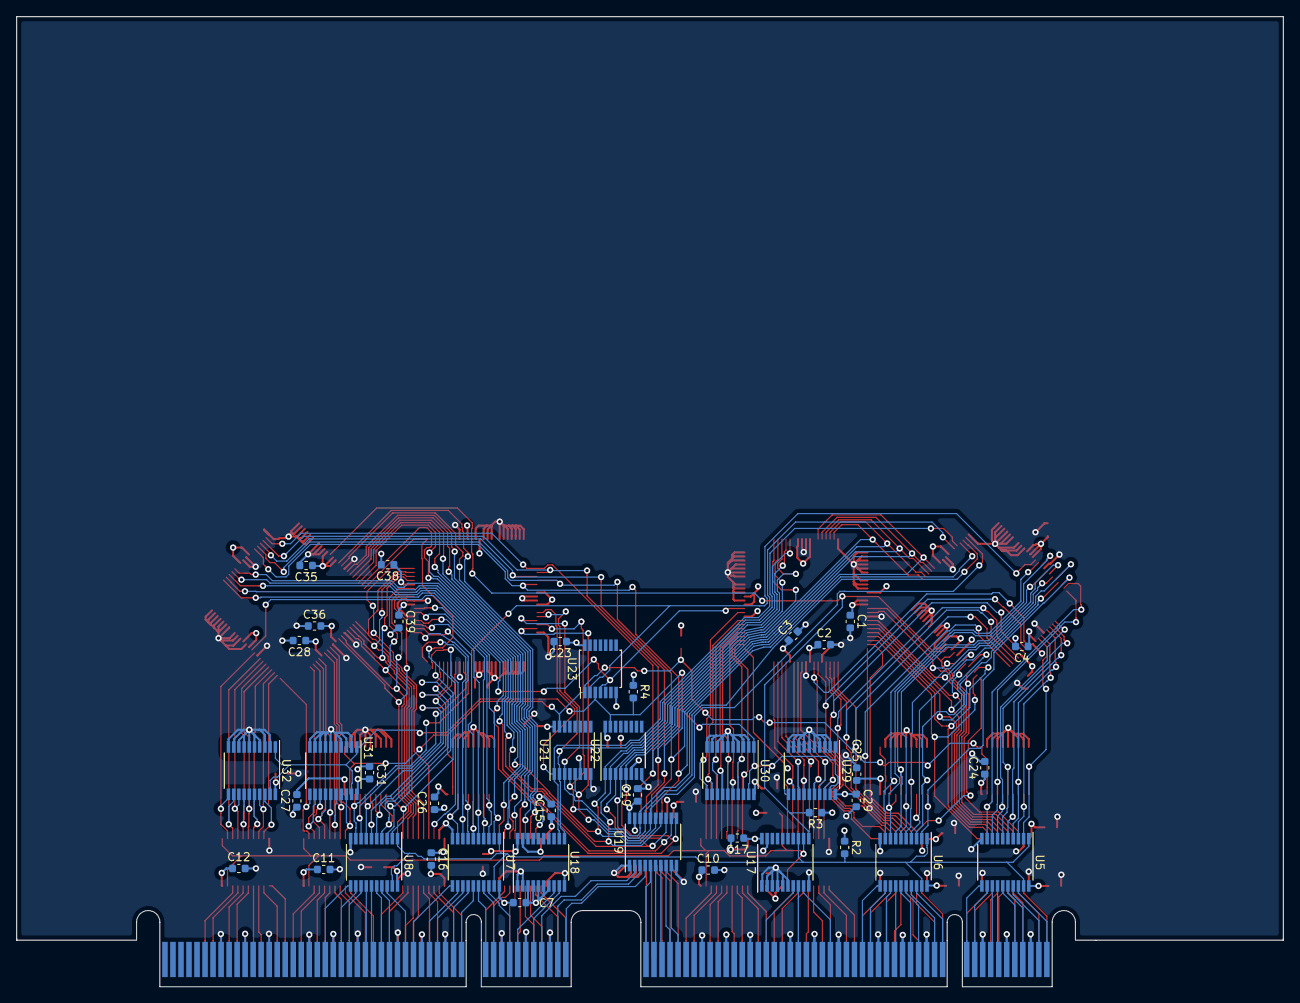
[picture p50: board ram-based-register-card.kicad_pcb from below]

Board: 4 copper layers, 158.0 x 121.0 mm, 76 parts (41 on the bottom side), 234 nets.
