RobertBaruch/lmarv/lmarv-1/test_for_smd_networks/test_for_smd_networks.kicad_pcb

## KiCad design lmarv-1/test_for_smd_networks/test_for_smd_networks.kicad_pcb (2018-12-16)

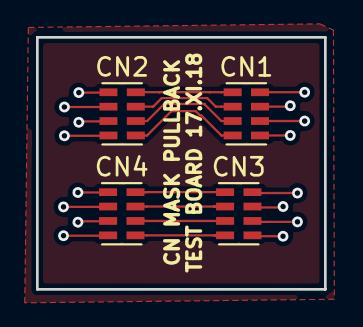
[picture p51: board test_for_smd_networks.kicad_pcb from above]

Board: 2 copper layers, 16.0 x 14.0 mm, 4 parts (0 on the bottom side), 9 nets.

Parts:
CN1, CN2, CN3, CN4: CKCA43C0G1H; RN_1206_4

Connections:
GND: CN1.5, CN1.6, CN1.7, CN1.8, CN2.1, CN2.2, CN2.3, CN2.4, CN3.5, CN3.6, CN3.7, CN3.8, CN4.1, CN4.2, CN4.3, CN4.4
unnamed: CN1.1, CN2.8
unnamed: CN1.2, CN2.7
unnamed: CN1.3, CN2.6
unnamed: CN1.4, CN2.5
unnamed: CN3.1, CN4.8
unnamed: CN3.2, CN4.7
unnamed: CN3.3, CN4.6
unnamed: CN3.4, CN4.5
