RobertBaruch/lmarv/lmarv-1/alu - v0/alu.kicad_pcb

## KiCad design lmarv-1/alu - v0/alu.kicad_pcb (2018-07-08, an earlier design)

Schematic: alu.sch, LMARV-1 ALU

Parts:
C1, C2, C3, C4, C5, C6, C7, C8, C9, C10, C11, C12, C13, C14, C15, C16, C17, C18, C19, C20, C21, C22, C23, C24, C25, C26, C27, C28, C29, C30, C31, C32, C33, C34, C35, C36, C37, C38, C39, C40, C41, C42, C43, C44, C45, C46, C47, C48, C49, C50, C51, C52, C53, C54, C55, C56: 0u1; C_0603
C100, C101, C102: 1u; CP_Elec_4x4.5
J1: Conn_02x03_Odd_Even; SDL-106-X-XX_2x03
J2, J3, J4: Conn_01x01; SL-101-X-XX_1x01
P1: dual-pcie-cardedge; PCI-EXPRESS
Q1, Q2, Q3: SSM3J358R; SOT-23_Handsoldering
R1, R2, R3: 10k; R_0603
U1, U4: 74HC590; SOIC-16_3.9x9.9mm_Pitch1.27mm
U2: AT28BV64B-20JU; PLCC32
U3: AT28BV256B-20JU; PLCC32
U5, U6, U7, U8, U9, U10, U12, U13, U14, U17, U18, U19, U21, U22, U23, U25, U26, U27, U29, U30, U31, U33, U34, U35, U37, U38, U39, U41, U45, U46, U47, U48, U49, U50, U51, U52, U53, U54, U55, U56: 74LVC541; TSSOP-20_4.4x6.5mm_Pitch0.65mm
U11, U15, U16, U20, U24, U28, U32, U36, U40: IS61LV256AL; TSOP-I-28_18.4x8mm_Pitch0.55mm
U42, U44: 74LVC32; TSSOP-14_4.4x5mm_Pitch0.65mm
U43: 74LVC04; TSSOP-14_4.4x5mm_Pitch0.65mm

Connections:
/BOOT_ALU_EN: R2.2, U43.4, U46.1, U46.19, U47.1, U47.19, U48.1, U48.19, U49.1, U49.19, U51.1, U51.19, U53.1, U53.19, U54.1, U54.19, U55.1, U55.19
/BOOT_A[0]: U1.15, U2.11, U3.11, U6.5, U9.7
/BOOT_A[1]: U1.1, U2.10, U3.10, U6.4, U9.6
/BOOT_A[2]: U1.2, U2.9, U3.9, U6.3, U9.5
/BOOT_A[3]: U1.3, U2.8, U3.8, U6.2, U9.4
/BOOT_A[4]: U1.4, U2.7, U3.7, U5.2, U9.3
/BOOT_A[5]: U1.5, U2.6, U3.6, U5.3, U9.2
/BOOT_A[6]: U1.6, U2.5, U3.5, U5.4, U8.6
/BOOT_A[7]: U1.7, U2.4, U3.4, U5.5, U8.7
/BOOT_A[8]: U2.29, U3.29, U4.15, U5.7, U8.4
/BOOT_A[9]: U2.28, U3.28, U4.1, U5.8, U8.3
/BOOT_A[10]: U2.24, U3.24, U4.2, U6.6, U9.8
/BOOT_A[11]: U2.27, U3.27, U4.3, U5.9, U8.2
/BOOT_A[12]: U2.3, U3.3, U4.4, U5.6, U8.8
/BOOT_A[13]: U3.30, U4.5, U6.7, U8.5
/BOOT_A[14]: U3.2, U4.6, U6.8, U8.9
/BOOT_A[15]: J1.1, U2.25, U4.7, U5.19, U6.9, U6.19, U7.19, U9.9, U12.19, U13.19, U14.19, U17.19, U18.19, U19.19, U21.19, U22.19, U23.19, U25.19, U26.19, U27.19, U29.19, U30.19, U31.19, U33.19, U34.19, U35.19, U37.19, U38.19, U39.19, U43.1, U44.5
/BOOT_CLK: U1.11, U1.13, U4.13, U56.17
/BOOT_CLK': P1.194 (nc19), U56.3
/CLA_D0: U3.13, U10.2
/CLA_D1: U3.14, U10.3
/CLA_D2: U3.15, U10.4
/CLA_D3: U3.18, U10.5
/CLA_D4: U3.19, U10.6
/CLA_D5: U3.20, U10.7
/CLA_D6: U3.21, U10.8
/CLA_D7: U3.22, U10.9
/SLICE_D0: U2.13, U7.2
/SLICE_D1: U2.14, U7.3
/SLICE_D2: U2.15, U7.4
/SLICE_D3: U2.18, U7.5
/SLICE_D4: U2.19, U7.6
/SLICE_D5: U2.20, U7.7
/SLICE_D6: U2.21, U7.8
/SLICE_D7: U2.22, U7.9
/SW_VCC1: C5.1, C6.1, C7.1, C12.1, C13.1, C14.1, C17.1, C18.1, C19.1, J3.1, Q1.3, U5.20, U6.20, U7.20, U12.20, U13.20, U14.20, U17.20, U18.20, U19.20
/SW_VCC2: C8.1, C9.1, C10.1, C21.1, C22.1, C23.1, C25.1, C26.1, C27.1, J4.1, Q2.3, U8.20, U9.20, U10.20, U21.20, U22.20, U23.20, U25.20, U26.20, U27.20
/SW_VCC3: C29.1, C30.1, C31.1, C33.1, C34.1, C35.1, C37.1, C38.1, C39.1, J2.1, Q3.3, U29.20, U30.20, U31.20, U33.20, U34.20, U35.20, U37.20, U38.20, U39.20
/alu_f[0]: U5.12, U11.24, U16.24, U20.24, U24.24, U28.24, U32.24, U36.24, U40.24, U56.12
/alu_f[1]: U6.14, U11.21, U16.21, U20.21, U24.21, U28.21, U32.21, U36.21, U40.21, U56.13
/alu_f[2]: U5.11, U11.23, U16.23, U20.23, U24.23, U28.23, U32.23, U36.23, U40.23, U56.14
/alu_f[3]: U5.14, U11.2, U16.2, U20.2, U24.2, U28.2, U32.2, U36.2, U40.2, U56.15
/cin[0]: U5.13, U9.13, U11.25, U12.7, U15.10
/cin[1]: U10.18, U12.13, U15.11, U16.25, U17.7
/cin[2]: U10.17, U15.12, U17.13, U20.25, U21.7
/cin[3]: U10.16, U15.13, U21.13, U24.25, U25.7
/cin[4]: U10.15, U15.15, U25.13, U28.25, U29.7
/cin[5]: U10.14, U15.16, U29.13, U32.25, U33.7
/cin[6]: U10.13, U15.17, U33.13, U36.25, U37.7
/cin[7]: U10.12, U15.18, U37.13, U40.25
/cout[0]: U7.15, U11.16, U14.5
/cout[1]: U14.15, U16.16, U19.5
/cout[2]: U19.15, U20.16, U23.5
/cout[3]: U23.15, U24.16, U27.5
/cout[4]: U27.15, U28.16, U31.5
/cout[5]: U31.15, U32.16, U35.5
/cout[6]: U35.15, U36.16, U39.5
/cout[7]: U39.15, U40.16
/f[0]: P1.188 (nc14), U56.8
/f[1]: P1.190 (nc15), U56.7
/f[2]: P1.191 (nc16), U56.6
/f[3]: P1.192 (nc17), U56.5
/g[0]: U7.17, U9.15, U11.18, U14.3, U15.8
/g[1]: U9.17, U14.17, U15.6, U16.18, U19.3
/g[2]: U8.14, U15.4, U19.17, U20.18, U23.3
/g[3]: U8.16, U15.25, U23.17, U24.18, U27.3
/g[4]: U9.12, U15.21, U27.17, U28.18, U31.3
/g[5]: U8.12, U15.2, U31.17, U32.18, U35.3
/g[6]: U8.11, U15.1, U35.17, U36.18, U39.3
/g[7]: U39.17, U40.18
/lt[0]: U7.18, U11.19, U14.2
/lt[1]: U14.18, U16.19, U19.2
/lt[2]: U19.18, U20.19, U23.2
/lt[3]: U23.18, U24.19, U27.2
/lt[4]: U27.18, U28.19, U31.2
/lt[5]: U31.18, U32.19, U35.2
/lt[6]: U35.18, U36.19, U39.2
/lt[7]: U39.18, U40.19, U42.1
/p[0]: U7.16, U9.14, U11.17, U14.4, U15.9
/p[1]: U9.16, U14.16, U15.7, U16.17, U19.4
/p[2]: U9.18, U15.5, U19.16, U20.17, U23.4
/p[3]: U8.13, U15.3, U23.16, U24.17, U27.4
/p[4]: U8.17, U15.24, U27.16, U28.17, U31.4
/p[5]: U8.18, U15.23, U31.16, U32.17, U35.4
/p[6]: U8.15, U15.26, U35.16, U36.17, U39.4
/p[7]: U39.16, U40.17
/rd[0]: P1.71 (rd[0]), U52.18
/rd[1]: P1.70 (rd[1]), U52.17
/rd[2]: P1.68 (rd[2]), U52.16
/rd[3]: P1.67 (rd[3]), U52.15
/rd[4]: P1.65 (rd[4]), U52.14
/rd[5]: P1.64 (rd[5]), U52.13
/rd[6]: P1.62 (rd[6]), U52.12
/rd[7]: P1.61 (rd[7]), U52.11
/rd[8]: P1.60 (rd[8]), U50.18
/rd[9]: P1.59 (rd[9]), U50.17
/rd[10]: P1.57 (rd[10]), U50.16
/rd[11]: P1.56 (rd[11]), U50.15
/rd[12]: P1.54 (rd[12]), U50.14
/rd[13]: P1.53 (rd[13]), U50.13
/rd[14]: P1.51 (rd[14]), U50.12
/rd[15]: P1.50 (rd[15]), U50.11
/rd[16]: P1.22 (rd[16]), U45.18
/rd[17]: P1.21 (rd[17]), U45.17
/rd[18]: P1.19 (rd[18]), U45.16
/rd[19]: P1.18 (rd[19]), U45.15
/rd[20]: P1.16 (rd[20]), U45.14
/rd[21]: P1.15 (rd[21]), U45.13
/rd[22]: P1.13 (rd[22]), U45.12
/rd[23]: P1.12 (rd[23]), U45.11
/rd[24]: P1.11 (rd[24]), U41.18
/rd[25]: P1.10 (rd[25]), U41.17
/rd[26]: P1.8 (rd[26]), U41.16
/rd[27]: P1.7 (rd[27]), U41.15
/rd[28]: P1.5 (rd[28]), U41.14
/rd[29]: P1.4 (rd[29]), U41.13
/rd[30]: P1.2 (rd[30]), U41.12
/rd[31]: P1.1 (rd[31]), U41.11
/rdb[0]: U42.3, U52.2
/rdb[0]': U7.11, U11.11, U14.9, U42.2
/rdb[1]: U7.12, U11.12, U14.8, U52.3
/rdb[2]: U7.13, U11.13, U14.7, U52.4
/rdb[3]: U7.14, U11.15, U14.6, U52.5
/rdb[4]: U14.11, U16.11, U19.9, U52.6
/rdb[5]: U14.12, U16.12, U19.8, U52.7
/rdb[6]: U14.13, U16.13, U19.7, U52.8
/rdb[7]: U14.14, U16.15, U19.6, U52.9
/rdb[8]: U19.11, U20.11, U23.9, U50.2
/rdb[9]: U19.12, U20.12, U23.8, U50.3
/rdb[10]: U19.13, U20.13, U23.7, U50.4
/rdb[11]: U19.14, U20.15, U23.6, U50.5
/rdb[12]: U23.11, U24.11, U27.9, U50.6
/rdb[13]: U23.12, U24.12, U27.8, U50.7
/rdb[14]: U23.13, U24.13, U27.7, U50.8
/rdb[15]: U23.14, U24.15, U27.6, U50.9
/rdb[16]: U27.11, U28.11, U31.9, U45.2
/rdb[17]: U27.12, U28.12, U31.8, U45.3
/rdb[18]: U27.13, U28.13, U31.7, U45.4
/rdb[19]: U27.14, U28.15, U31.6, U45.5
/rdb[20]: U31.11, U32.11, U35.9, U45.6
/rdb[21]: U31.12, U32.12, U35.8, U45.7
/rdb[22]: U31.13, U32.13, U35.7, U45.8
/rdb[23]: U31.14, U32.15, U35.6, U45.9
/rdb[24]: U35.11, U36.11, U39.9, U41.2
/rdb[25]: U35.12, U36.12, U39.8, U41.3
/rdb[26]: U35.13, U36.13, U39.7, U41.4
/rdb[27]: U35.14, U36.15, U39.6, U41.5
/rdb[28]: U39.11, U40.11, U41.6
/rdb[29]: U39.12, U40.12, U41.7
/rdb[30]: U39.13, U40.13, U41.8
/rdb[31]: U39.14, U40.15, U41.9
/rs1[0]: P1.176 (rs1[0]), U53.2
/rs1[1]: P1.174 (rs1[1]), U53.3
/rs1[2]: P1.173 (rs1[2]), U53.4
/rs1[3]: P1.171 (rs1[3]), U53.5
/rs1[4]: P1.170 (rs1[4]), U53.6
/rs1[5]: P1.169 (rs1[5]), U53.7
/rs1[6]: P1.168 (rs1[6]), U53.8
/rs1[7]: P1.166 (rs1[7]), U53.9
/rs1[8]: P1.165 (rs1[8]), U51.2
/rs1[9]: P1.163 (rs1[9]), U51.3
/rs1[10]: P1.162 (rs1[10]), U51.4
/rs1[11]: P1.160 (rs1[11]), U51.5
/rs1[12]: P1.159 (rs1[12]), U51.6
/rs1[13]: P1.158 (rs1[13]), U51.7
/rs1[14]: P1.157 (rs1[14]), U51.8
/rs1[15]: P1.155 (rs1[15]), U51.9
/rs1[16]: P1.120 (rs1[16]), U47.2
/rs1[17]: P1.119 (rs1[17]), U47.3
/rs1[18]: P1.117 (rs1[18]), U47.4
/rs1[19]: P1.116 (rs1[19]), U47.5
/rs1[20]: P1.114 (rs1[20]), U47.6
/rs1[21]: P1.113 (rs1[21]), U47.7
/rs1[22]: P1.111 (rs1[22]), U47.8
/rs1[23]: P1.110 (rs1[23]), U47.9
/rs1[24]: P1.109 (rs1[24]), U46.2
/rs1[25]: P1.108 (rs1[25]), U46.3
/rs1[26]: P1.106 (rs1[26]), U46.4
/rs1[27]: P1.105 (rs1[27]), U46.5
/rs1[28]: P1.103 (rs1[28]), U46.6
/rs1[29]: P1.102 (rs1[29]), U46.7
/rs1[30]: P1.100 (rs1[30]), U46.8
/rs1[31]: P1.99 (rs1[31]), U46.9
/rs1b[0]: U6.15, U11.10, U13.5, U53.18
/rs1b[1]: U6.16, U11.9, U13.4, U53.17
/rs1b[2]: U6.17, U11.8, U13.3, U53.16
/rs1b[3]: U6.18, U11.7, U13.2, U53.15
/rs1b[4]: U13.15, U16.10, U18.5, U53.14
/rs1b[5]: U13.16, U16.9, U18.4, U53.13
/rs1b[6]: U13.17, U16.8, U18.3, U53.12
/rs1b[7]: U13.18, U16.7, U18.2, U53.11
/rs1b[8]: U18.15, U20.10, U22.5, U51.18
/rs1b[9]: U18.16, U20.9, U22.4, U51.17
/rs1b[10]: U18.17, U20.8, U22.3, U51.16
/rs1b[11]: U18.18, U20.7, U22.2, U51.15
/rs1b[12]: U22.15, U24.10, U26.5, U51.14
/rs1b[13]: U22.16, U24.9, U26.4, U51.13
/rs1b[14]: U22.17, U24.8, U26.3, U51.12
/rs1b[15]: U22.18, U24.7, U26.2, U51.11
/rs1b[16]: U26.15, U28.10, U30.5, U47.18
/rs1b[17]: U26.16, U28.9, U30.4, U47.17
/rs1b[18]: U26.17, U28.8, U30.3, U47.16
/rs1b[19]: U26.18, U28.7, U30.2, U47.15
/rs1b[20]: U30.15, U32.10, U34.5, U47.14
/rs1b[21]: U30.16, U32.9, U34.4, U47.13
/rs1b[22]: U30.17, U32.8, U34.3, U47.12
/rs1b[23]: U30.18, U32.7, U34.2, U47.11
/rs1b[24]: U34.15, U36.10, U38.5, U46.18
/rs1b[25]: U34.16, U36.9, U38.4, U46.17
/rs1b[26]: U34.17, U36.8, U38.3, U46.16
/rs1b[27]: U34.18, U36.7, U38.2, U46.15
/rs1b[28]: U38.15, U40.10, U46.14
/rs1b[29]: U38.16, U40.9, U46.13
/rs1b[30]: U38.17, U40.8, U46.12
/rs1b[31]: U38.18, U40.7, U46.11
/rs2[0]: P1.93 (rs2[0]), U55.9
/rs2[1]: P1.92 (rs2[1]), U55.8
/rs2[2]: P1.90 (rs2[2]), U55.7
/rs2[3]: P1.89 (rs2[3]), U55.6
/rs2[4]: P1.87 (rs2[4]), U55.5
/rs2[5]: P1.86 (rs2[5]), U55.4
/rs2[6]: P1.84 (rs2[6]), U55.3
/rs2[7]: P1.83 (rs2[7]), U55.2
/rs2[8]: P1.82 (rs2[8]), U54.9
/rs2[9]: P1.81 (rs2[9]), U54.8
/rs2[10]: P1.79 (rs2[10]), U54.7
/rs2[11]: P1.78 (rs2[11]), U54.6
/rs2[12]: P1.76 (rs2[12]), U54.5
/rs2[13]: P1.75 (rs2[13]), U54.4
/rs2[14]: P1.73 (rs2[14]), U54.3
/rs2[15]: P1.72 (rs2[15]), U54.2
/rs2[16]: P1.44 (rs2[16]), U49.9
/rs2[17]: P1.43 (rs2[17]), U49.8
/rs2[18]: P1.41 (rs2[18]), U49.7
/rs2[19]: P1.40 (rs2[19]), U49.6
/rs2[20]: P1.38 (rs2[20]), U49.5
/rs2[21]: P1.37 (rs2[21]), U49.4
/rs2[22]: P1.35 (rs2[22]), U49.3
/rs2[23]: P1.34 (rs2[23]), U49.2
/rs2[24]: P1.33 (rs2[24]), U48.9
/rs2[25]: P1.32 (rs2[25]), U48.8
/rs2[26]: P1.30 (rs2[26]), U48.7
/rs2[27]: P1.29 (rs2[27]), U48.6
/rs2[28]: P1.27 (rs2[28]), U48.5
/rs2[29]: P1.26 (rs2[29]), U48.4
/rs2[30]: P1.24 (rs2[30]), U48.3
/rs2[31]: P1.23 (rs2[31]), U48.2
/rs2b[0]: U5.18, U11.6, U12.2, U55.11
/rs2b[1]: U5.17, U11.5, U12.3, U55.12
/rs2b[2]: U5.16, U11.4, U12.4, U55.13
/rs2b[3]: U5.15, U11.3, U12.5, U55.14
/rs2b[4]: U12.18, U16.6, U17.2, U55.15
/rs2b[5]: U12.17, U16.5, U17.3, U55.16
/rs2b[6]: U12.16, U16.4, U17.4, U55.17
/rs2b[7]: U12.15, U16.3, U17.5, U55.18
/rs2b[8]: U17.18, U20.6, U21.2, U54.11
/rs2b[9]: U17.17, U20.5, U21.3, U54.12
/rs2b[10]: U17.16, U20.4, U21.4, U54.13
/rs2b[11]: U17.15, U20.3, U21.5, U54.14
/rs2b[12]: U21.18, U24.6, U25.2, U54.15
/rs2b[13]: U21.17, U24.5, U25.3, U54.16
/rs2b[14]: U21.16, U24.4, U25.4, U54.17
/rs2b[15]: U21.15, U24.3, U25.5, U54.18
/rs2b[16]: U25.18, U28.6, U29.2, U49.11
/rs2b[17]: U25.17, U28.5, U29.3, U49.12
/rs2b[18]: U25.16, U28.4, U29.4, U49.13
/rs2b[19]: U25.15, U28.3, U29.5, U49.14
/rs2b[20]: U29.18, U32.6, U33.2, U49.15
/rs2b[21]: U29.17, U32.5, U33.3, U49.16
/rs2b[22]: U29.16, U32.4, U33.4, U49.17
/rs2b[23]: U29.15, U32.3, U33.5, U49.18
/rs2b[24]: U33.18, U36.6, U37.2, U48.11
/rs2b[25]: U33.17, U36.5, U37.3, U48.12
/rs2b[26]: U33.16, U36.4, U37.4, U48.13
/rs2b[27]: U33.15, U36.3, U37.5, U48.14
/rs2b[28]: U37.18, U40.6, U48.15
/rs2b[29]: U37.17, U40.5, U48.16
/rs2b[30]: U37.16, U40.4, U48.17
/rs2b[31]: U37.15, U40.3, U48.18
/~BOOT_ALU_EN: Q1.1, Q2.1, Q3.1, R3.2, U1.14, U2.23, U3.23, U4.14, U5.1, U6.1, U7.1, U8.1, U9.1, U10.1, U12.1, U13.1, U14.1, U17.1, U18.1, U19.1, U21.1, U22.1, U23.1, U25.1, U26.1, U27.1, U29.1, U30.1, U31.1, U33.1, U34.1, U35.1, U37.1, U38.1, U39.1, U43.3, U44.1, U56.16
/~BOOT_ALU_EN': P1.193 (nc18), U56.4
/~BOOT_ALU_WR: J1.4, U11.27, U16.27, U20.27, U24.27, U28.27, U32.27, U36.27, U40.27, U44.6
/~BOOT_ALU_WR': U44.3, U44.4, U44.9
/~BOOT_A[15]: J1.3, U3.25, U8.19, U9.19, U10.19, U43.2, U44.10
/~BOOT_CLA_WR: J1.2, U15.27, U44.8
/~BOOT_RCO: U1.9, U4.11
/~BOOT_RST: U1.10, U4.10, U56.18
/~BOOT_RST': P1.195 (nc20), U56.2
/~BOOT_WR: P1.196 (nc21), U44.2
/~alu_oe: R1.2, U11.22, U15.22, U16.22, U20.22, U24.22, U28.22, U32.22, U36.22, U40.22, U41.1, U41.19, U45.1, U45.19, U50.1, U50.19, U52.1, U52.19, U56.11
/~alu_oe': P1.187 (nc13), U56.9
GND: C1.2, C2.2, C3.2, C4.2, C5.2, C6.2, C7.2, C8.2, C9.2, C10.2, C11.2, C12.2, C13.2, C14.2, C15.2, C16.2, C17.2, C18.2, C19.2, C20.2, C21.2, C22.2, C23.2, C24.2, C25.2, C26.2, C27.2, C28.2, C29.2, C30.2, C31.2, C32.2, C33.2, C34.2, C35.2, C36.2, C37.2, C38.2, C39.2, C40.2, C41.2, C42.2, C43.2, C44.2, C45.2, C46.2, C47.2, C48.2, C49.2, C50.2, C51.2, C52.2, C53.2, C54.2, C55.2, C56.2, C100.2, C101.2, C102.2, J1.6, P1.3 (GND), P1.9 (GND), P1.14 (GND), P1.20 (GND), P1.25 (GND), P1.31 (GND), P1.36 (GND), P1.42 (GND), P1.52 (GND), P1.58 (GND), P1.63 (GND), P1.69 (GND), P1.74 (GND), P1.80 (GND), P1.85 (GND), P1.91 (GND), P1.101 (GND), P1.107 (GND), P1.112 (GND), P1.118 (GND), P1.123 (GND), P1.129 (GND), P1.134 (GND), P1.140 (GND), P1.150 (GND), P1.156 (GND), P1.161 (GND), P1.167 (GND), P1.172 (GND), P1.178 (GND), P1.183 (GND), P1.189 (GND), U1.8, U1.12, U2.16, U3.16, U4.8, U4.12, U5.10, U6.10, U7.10, U8.10, U9.10, U10.10, U11.1, U11.14, U11.20, U11.26, U12.6, U12.8, U12.9, U12.10, U13.6, U13.10, U14.10, U15.14, U15.20, U16.1, U16.14, U16.20, U16.26, U17.10, U18.10, U19.10, U20.1, U20.14, U20.20, U20.26, U21.10, U22.10, U23.10, U24.1, U24.14, U24.20, U24.26, U25.10, U26.10, U27.10, U28.1, U28.14, U28.20, U28.26, U29.10, U30.10, U31.10, U32.1, U32.14, U32.20, U32.26, U33.10, U34.10, U35.10, U36.1, U36.14, U36.20, U36.26, U37.10, U38.10, U39.10, U40.1, U40.14, U40.20, U40.26, U41.10, U42.4, U42.5, U42.7, U42.9, U42.10, U42.12, U42.13, U43.5, U43.7, U43.9, U43.11, U43.13, U44.7, U44.12, U44.13, U45.10, U46.10, U47.10, U48.10, U49.10, U50.10, U51.10, U52.10, U53.10, U54.10, U55.10, U56.1, U56.10, U56.19
unnamed: U10.11, U15.19
unnamed: U12.11, U17.9
unnamed: U12.12, U17.8
unnamed: U12.14, U17.6
unnamed: U6.13, U13.7
unnamed: U6.12, U13.8
unnamed: U6.11, U13.9
unnamed: U13.11, U18.9
unnamed: U13.12, U18.8
unnamed: U13.13, U18.7
unnamed: U13.14, U18.6
unnamed: U17.11, U21.9
unnamed: U17.12, U21.8
unnamed: U17.14, U21.6
unnamed: U18.11, U22.9
unnamed: U18.12, U22.8
unnamed: U18.13, U22.7
unnamed: U18.14, U22.6
unnamed: U21.11, U25.9
unnamed: U21.12, U25.8
unnamed: U21.14, U25.6
unnamed: U22.11, U26.9
unnamed: U22.12, U26.8
unnamed: U22.13, U26.7
unnamed: U22.14, U26.6
unnamed: U25.11, U29.9
unnamed: U25.12, U29.8
unnamed: U25.14, U29.6
unnamed: U26.11, U30.9
unnamed: U26.12, U30.8
unnamed: U26.13, U30.7
unnamed: U26.14, U30.6
unnamed: U29.11, U33.9
unnamed: U29.12, U33.8
unnamed: U29.14, U33.6
unnamed: U30.11, U34.9
unnamed: U30.12, U34.8
unnamed: U30.13, U34.7
unnamed: U30.14, U34.6
unnamed: U33.11, U37.9
unnamed: U33.12, U37.8
unnamed: U33.14, U37.6
unnamed: U34.11, U38.9
unnamed: U34.12, U38.8
unnamed: U34.13, U38.7
unnamed: U34.14, U38.6
VCC: C1.1, C2.1, C3.1, C4.1, C11.1, C15.1, C16.1, C20.1, C24.1, C28.1, C32.1, C36.1, C40.1, C41.1, C42.1, C43.1, C44.1, C45.1, C46.1, C47.1, C48.1, C49.1, C50.1, C51.1, C52.1, C53.1, C54.1, C55.1, C56.1, C100.1, C101.1, C102.1, J1.5, P1.6 (VDD), P1.17 (VDD), P1.28 (VDD), P1.39 (VDD), P1.55 (VDD), P1.66 (VDD), P1.77 (VDD), P1.88 (VDD), P1.104 (VDD), P1.115 (VDD), P1.126 (VDD), P1.137 (VDD), P1.153 (VDD), P1.164 (VDD), P1.175 (VDD), P1.186 (VDD), Q1.2, Q2.2, Q3.2, R1.1, R2.1, R3.1, U1.16, U2.31, U2.32, U3.31, U3.32, U4.16, U11.28, U15.28, U16.28, U20.28, U24.28, U28.28, U32.28, U36.28, U40.28, U41.20, U42.14, U43.14, U44.14, U45.20, U46.20, U47.20, U48.20, U49.20, U50.20, U51.20, U52.20, U53.20, U54.20, U55.20, U56.20

Notes on the sheet:
32k x 8 CARRY LOOKAHEAD UNIT
8k x 8 SLICE 7
8k x 8 SLICE 6
8k x 8 SLICE 5
8k x 8 SLICE 4
8k x 8 SLICE 3
8k x 8 SLICE 2
8k x 8 SLICE 1
8k x 8 SLICE 0
8k x 8 SLICE ROM
32k x 8 CLU ROM
BOOT LOADER COUNTER
BOOT PROCEDURE: 1. DISABLE ALL CONTROL LINES (INCLUDES ~alu_oe~) 2. SET ~BOOT_ALU_EN~ LOW 3. STROBE ~BOOT_RST~ LOW 4. STROBE BOOT_CLK HIGH 5. STROBE ~BOOT_WR~ LOW 6. REPEAT 4 & 5 64K TIMES 7. SET ~BOOT_ALU_EN~ HIGH

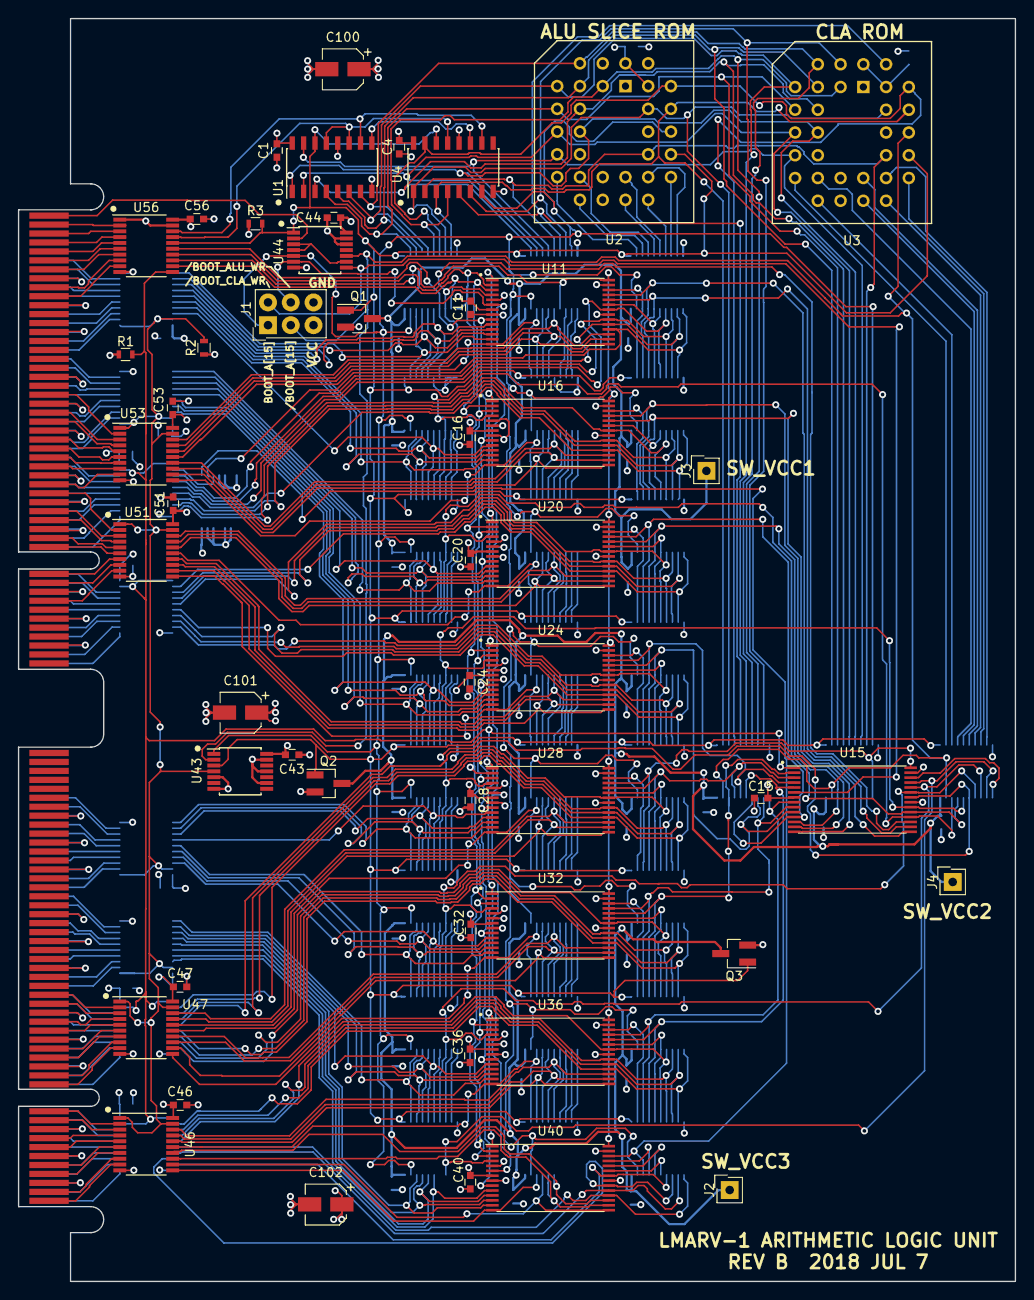
[picture p52: board lmarv-1/alu - v0/alu.kicad_pcb from above]

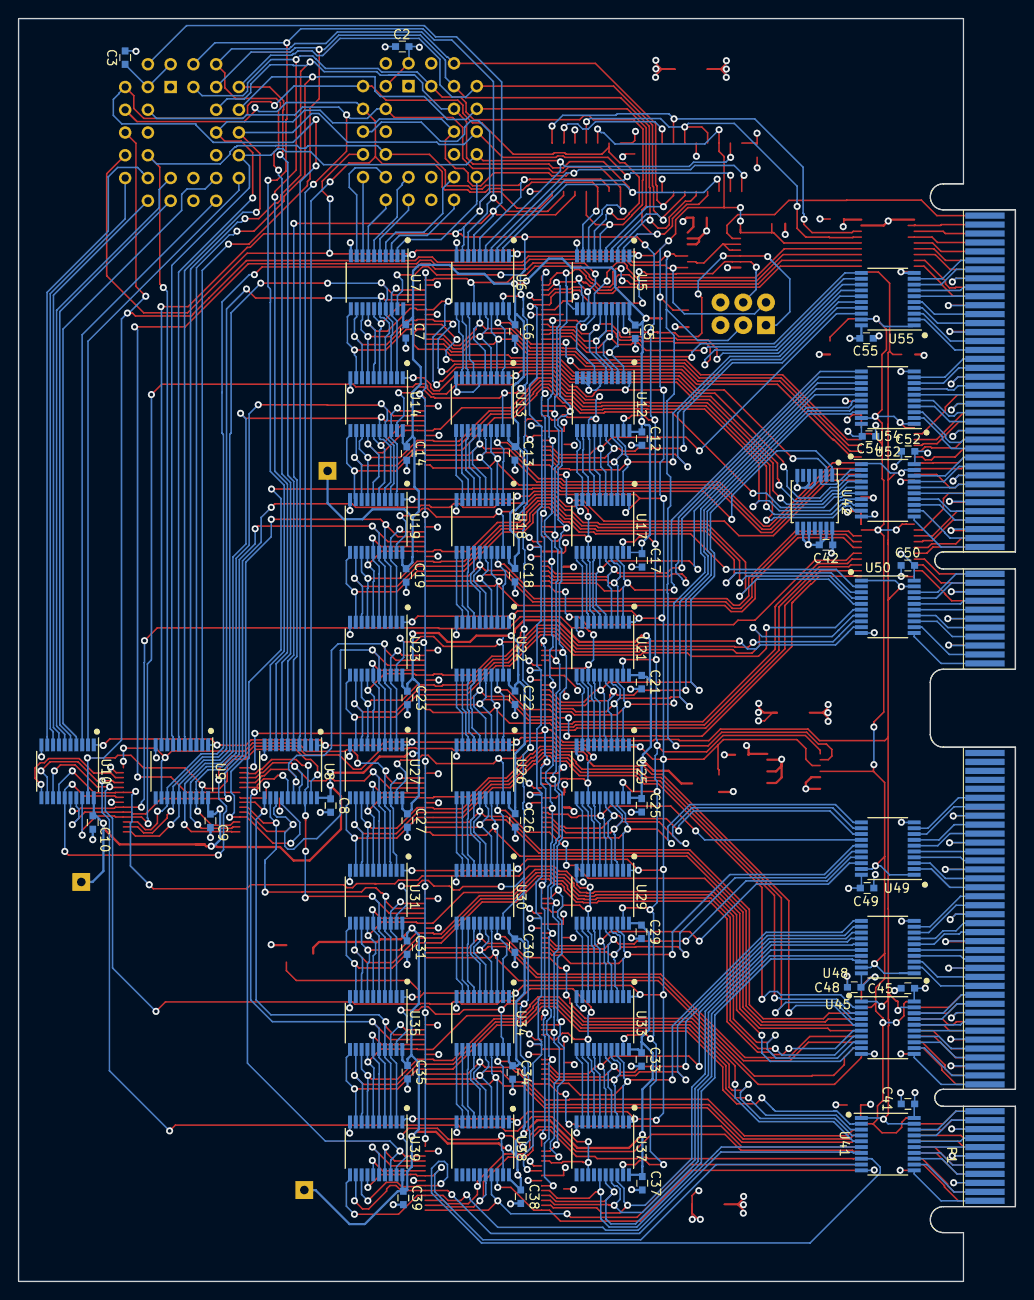
[picture p53: board lmarv-1/alu - v0/alu.kicad_pcb from below]

Board: 4 copper layers, 111.3 x 141.0 mm, 126 parts (75 on the bottom side), 339 nets.
