RobertBaruch/lmarv/lmarv-1/lights_n_jumpers/lights_n_jumpers.kicad_pcb

## KiCad design lmarv-1/lights_n_jumpers/lights_n_jumpers.kicad_pcb (2018-12-16)

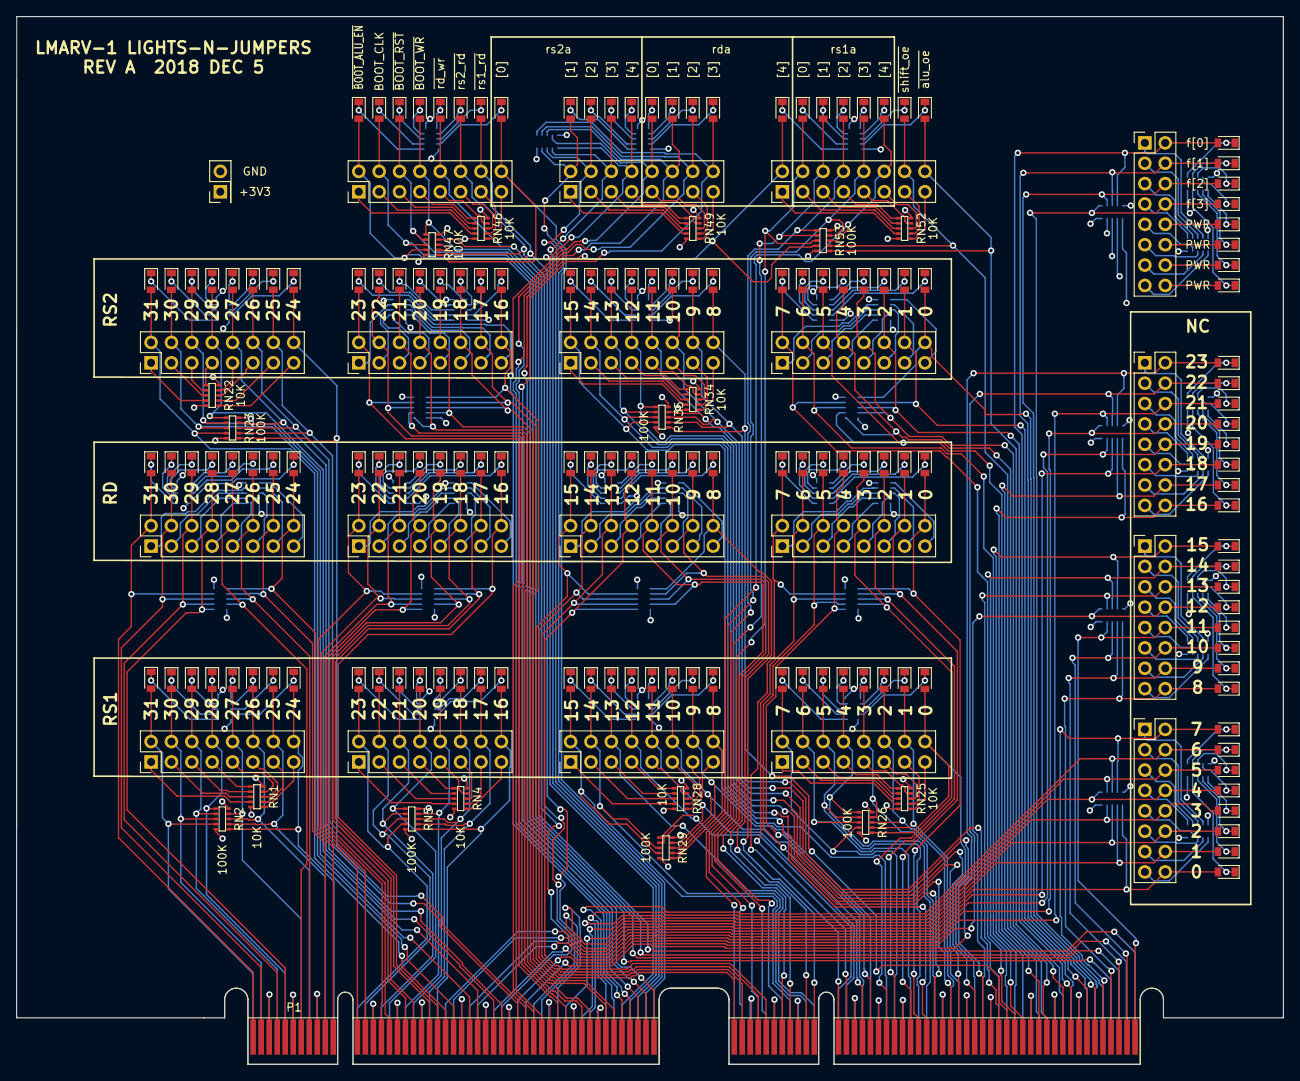
[picture p54: board lights_n_jumpers.kicad_pcb from above]

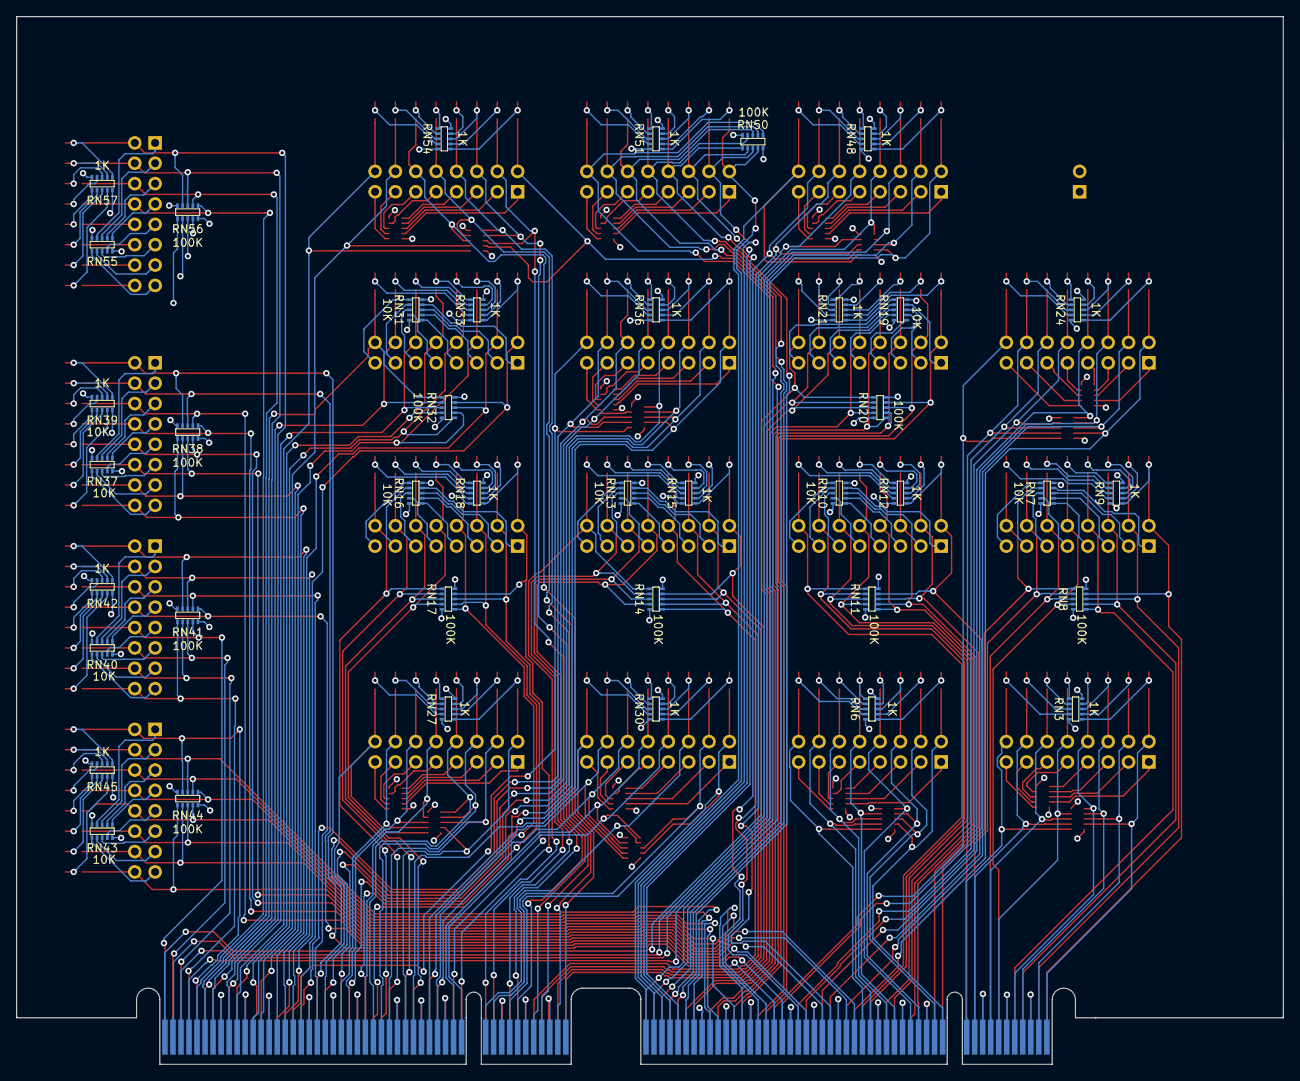
[picture p55: board lights_n_jumpers.kicad_pcb from below]

Board: 4 copper layers, 158.0 x 130.7 mm, 230 parts (40 on the bottom side), 454 nets.

Parts:
D1, D2, D3, D4, D5, D6, D7, D8, D9, D10, D11, D12, D13, D14, D15, D16, D17, D18, D19, D20, D21, D22, D23, D24, D25, D26, D27, D28, D29, D30, D31, D32, D33, D34, D35, D36, D37, D38, D39, D40, D41, D42, D43, D44, D45, D46, D47, D48, D49, D50, D51, D52, D53, D54, D55, D56, D57, D58, D59, D60, D61, D62, D63, D64, D65, D66, D67, D68, D69, D70, D71, D72, D73, D74, D75, D76, D77, D78, D79, D80, D81, D82, D83, D84, D85, D86, D87, D88, D89, D90, D91, D92, D93, D94, D95, D96, D97, D98, D99, D100, D101, D102, D103, D104, D105, D106, D107, D108, D109, D110, D111, D112, D113, D114, D115, D116, D117, D118, D119, D120, D121, D122, D123, D124, D125, D126, D127, D128, D129, D130, D131, D132, D133, D134, D135, D136, D137, D138, D139, D140, D141, D142, D143, D144, D145, D146, D147, D148, D149, D150, D151, D152: APTD2012LSURCK; D_0805_Wide
J1, J2, J3, J4, J5, J6, J7, J8, J10, J11, J12, J13, J14, J15, J16, J17, J18, J19, J20: Conn_02x08_Odd_Even; PinHeader_2x08_P2.54mm_Vertical
J9: Conn_01x02; PinHeader_2x01_P2.54mm_Vertical
P1: dual-pcie-cardedge_split; PCI-EXPRESS
RN1, RN4, RN7, RN10, RN13, RN16, RN19, RN22, RN25, RN28, RN31, RN34, RN37, RN40, RN43, RN46, RN49, RN52, RN55: 10k; CAY17
RN2, RN5, RN8, RN11, RN14, RN17, RN20, RN23, RN26, RN29, RN32, RN35, RN38, RN41, RN44, RN47, RN50, RN53, RN56: 100k; CAY17
RN3, RN6, RN9, RN12, RN15, RN18, RN21, RN24, RN27, RN30, RN33, RN36, RN39, RN42, RN45, RN48, RN51, RN54, RN57: 1k; CAY17

Connections:
+3V3: D145.2, D146.2, D147.2, D148.2, J9.1, J20.10, J20.12, J20.14, J20.16, P1.6, P1.17, P1.28, P1.39, P1.55, P1.66, P1.77, P1.88, P1.104, P1.115, P1.126, P1.137, P1.153, P1.164, P1.175, P1.186, RN1.5, RN1.10, RN4.5, RN4.10, RN7.5, RN7.10, RN10.5, RN10.10, RN13.5, RN13.10, RN16.5, RN16.10, RN19.5, RN19.10, RN22.5, RN22.10, RN25.5, RN25.10, RN28.5, RN28.10, RN31.5, RN31.10, RN34.5, RN34.10, RN37.5, RN37.10, RN40.5, RN40.10, RN43.5, RN43.10, RN46.5, RN46.10, RN49.5, RN49.10, RN52.5, RN52.10, RN55.5, RN55.10, RN56.1, RN56.2, RN56.3, RN56.4
/BOOT_CLK: D127.2, J17.4, P1.194, RN47.8
/f[0]: D152.2, J20.2, P1.188, RN56.9
/f[1]: D151.2, J20.4, P1.190, RN56.8
/f[2]: D150.2, J20.6, P1.191, RN56.7
/f[3]: D149.2, J20.8, P1.192, RN56.6
/nc0: D113.2, J16.16, P1.133, RN44.1
/nc1: D114.2, J16.14, P1.135, RN44.2
/nc2: D115.2, J16.12, P1.136, RN44.3
/nc3: D116.2, J16.10, P1.138, RN44.4
/nc4: D117.2, J16.8, P1.139, RN44.6
/nc5: D118.2, J16.6, P1.141, RN44.7
/nc6: D119.2, J16.4, P1.142, RN44.8
/nc7: D120.2, J16.2, P1.94, RN44.9
/nc8: D105.2, J15.16, P1.95, RN41.1
/nc9: D106.2, J15.14, P1.96, RN41.2
/nc10: D107.2, J15.12, P1.97, RN41.3
/nc11: D108.2, J15.10, P1.98, RN41.4
/nc12: D109.2, J15.8, P1.177, RN41.6
/nc13: D110.2, J15.6, P1.179, RN41.7
/nc14: D111.2, J15.4, P1.180, RN41.8
/nc15: D112.2, J15.2, P1.181, RN41.9
/nc16: D97.2, J14.16, P1.182, RN38.1
/nc17: D98.2, J14.14, P1.184, RN38.2
/nc18: D99.2, J14.12, P1.121, RN38.3
/nc19: D100.2, J14.10, P1.122, RN38.4
/nc20: D101.2, J14.8, P1.125, RN38.6
/nc21: D102.2, J14.6, P1.127, RN38.7
/nc22: D103.2, J14.4, P1.130, RN38.8
/nc23: D104.2, J14.2, P1.131, RN38.9
/rd[0]: D41.2, J6.16, P1.71, RN17.1
/rd[1]: D42.2, J6.14, P1.70, RN17.2
/rd[2]: D43.2, J6.12, P1.68, RN17.3
/rd[3]: D44.2, J6.10, P1.67, RN17.4
/rd[4]: D45.2, J6.8, P1.65, RN17.6
/rd[5]: D46.2, J6.6, P1.64, RN17.7
/rd[6]: D47.2, J6.4, P1.62, RN17.8
/rd[7]: D48.2, J6.2, P1.61, RN17.9
/rd[8]: D33.2, J5.16, P1.60, RN14.1
/rd[9]: D34.2, J5.14, P1.59, RN14.2
/rd[10]: D35.2, J5.12, P1.57, RN14.3
/rd[11]: D36.2, J5.10, P1.56, RN14.4
/rd[12]: D37.2, J5.8, P1.54, RN14.6
/rd[13]: D38.2, J5.6, P1.53, RN14.7
/rd[14]: D39.2, J5.4, P1.51, RN14.8
/rd[15]: D40.2, J5.2, P1.50, RN14.9
/rd[16]: D25.2, J4.16, P1.22, RN11.1
/rd[17]: D26.2, J4.14, P1.21, RN11.2
/rd[18]: D27.2, J4.12, P1.19, RN11.3
/rd[19]: D28.2, J4.10, P1.18, RN11.4
/rd[20]: D29.2, J4.8, P1.16, RN11.6
/rd[21]: D30.2, J4.6, P1.15, RN11.7
/rd[22]: D31.2, J4.4, P1.13, RN11.8
/rd[23]: D32.2, J4.2, P1.12, RN11.9
/rd[24]: D17.2, J3.16, P1.11, RN8.1
/rd[25]: D18.2, J3.14, P1.10, RN8.2
/rd[26]: D19.2, J3.12, P1.8, RN8.3
/rd[27]: D20.2, J3.10, P1.7, RN8.4
/rd[28]: D21.2, J3.8, P1.5, RN8.6
/rd[29]: D22.2, J3.6, P1.4, RN8.7
/rd[30]: D23.2, J3.4, P1.2, RN8.8
/rd[31]: D24.2, J3.2, P1.1, RN8.9
/rda[0]: D132.2, J18.10, P1.45, RN50.4
/rda[1]: D131.2, J18.12, P1.46, RN50.3
/rda[2]: D130.2, J18.14, P1.47, RN50.2
/rda[3]: D129.2, J18.16, P1.48, RN50.1
/rda[4]: D144.2, J19.2, P1.49, RN53.9
/rs1[0]: D65.2, J10.16, P1.176, RN26.1
/rs1[1]: D66.2, J10.14, P1.174, RN26.2
/rs1[2]: D67.2, J10.12, P1.173, RN26.3
/rs1[3]: D68.2, J10.10, P1.171, RN26.4
/rs1[4]: D69.2, J10.8, P1.170, RN26.6
/rs1[5]: D70.2, J10.6, P1.169, RN26.7
/rs1[6]: D71.2, J10.4, P1.168, RN26.8
/rs1[7]: D72.2, J10.2, P1.166, RN26.9
/rs1[8]: D73.2, J11.16, P1.165, RN29.1
/rs1[9]: D74.2, J11.14, P1.163, RN29.2
/rs1[10]: D75.2, J11.12, P1.162, RN29.3
/rs1[11]: D76.2, J11.10, P1.160, RN29.4
/rs1[12]: D77.2, J11.8, P1.159, RN29.6
/rs1[13]: D78.2, J11.6, P1.158, RN29.7
/rs1[14]: D79.2, J11.4, P1.157, RN29.8
/rs1[15]: D80.2, J11.2, P1.155, RN29.9
/rs1[16]: D9.2, J2.16, P1.120, RN5.1
/rs1[17]: D10.2, J2.14, P1.119, RN5.2
/rs1[18]: D11.2, J2.12, P1.117, RN5.3
/rs1[19]: D12.2, J2.10, P1.116, RN5.4
/rs1[20]: D13.2, J2.8, P1.114, RN5.6
/rs1[21]: D14.2, J2.6, P1.113, RN5.7
/rs1[22]: D15.2, J2.4, P1.111, RN5.8
/rs1[23]: D16.2, J2.2, P1.110, RN5.9
/rs1[24]: D1.2, J1.16, P1.109, RN2.1
/rs1[25]: D2.2, J1.14, P1.108, RN2.2
/rs1[26]: D3.2, J1.12, P1.106, RN2.3
/rs1[27]: D4.2, J1.10, P1.105, RN2.4
/rs1[28]: D5.2, J1.8, P1.103, RN2.6
/rs1[29]: D6.2, J1.6, P1.102, RN2.7
/rs1[30]: D7.2, J1.4, P1.100, RN2.8
/rs1[31]: D8.2, J1.2, P1.99, RN2.9
/rs1a[0]: D143.2, J19.4, P1.154, RN53.8
/rs1a[1]: D142.2, J19.6, P1.152, RN53.7
/rs1a[2]: D141.2, J19.8, P1.151, RN53.6
/rs1a[3]: D140.2, J19.10, P1.149, RN53.4
/rs1a[4]: D139.2, J19.12, P1.148, RN53.3
/rs2[0]: D81.2, J12.16, P1.93, RN32.1
/rs2[1]: D82.2, J12.14, P1.92, RN32.2
/rs2[2]: D83.2, J12.12, P1.90, RN32.3
/rs2[3]: D84.2, J12.10, P1.89, RN32.4
/rs2[4]: D85.2, J12.8, P1.87, RN32.6
/rs2[5]: D86.2, J12.6, P1.86, RN32.7
/rs2[6]: D87.2, J12.4, P1.84, RN32.8
/rs2[7]: D88.2, J12.2, P1.83, RN32.9
/rs2[8]: D89.2, J13.16, P1.82, RN35.1
/rs2[9]: D90.2, J13.14, P1.81, RN35.2
/rs2[10]: D91.2, J13.12, P1.79, RN35.3
/rs2[11]: D92.2, J13.10, P1.78, RN35.4
/rs2[12]: D93.2, J13.8, P1.76, RN35.6
/rs2[13]: D94.2, J13.6, P1.75, RN35.7
/rs2[14]: D95.2, J13.4, P1.73, RN35.8
/rs2[15]: D96.2, J13.2, P1.72, RN35.9
/rs2[16]: D49.2, J7.16, P1.44, RN20.1
/rs2[17]: D50.2, J7.14, P1.43, RN20.2
/rs2[18]: D51.2, J7.12, P1.41, RN20.3
/rs2[19]: D52.2, J7.10, P1.40, RN20.4
/rs2[20]: D53.2, J7.8, P1.38, RN20.6
/rs2[21]: D54.2, J7.6, P1.37, RN20.7
/rs2[22]: D55.2, J7.4, P1.35, RN20.8
/rs2[23]: D56.2, J7.2, P1.34, RN20.9
/rs2[24]: D57.2, J8.16, P1.33, RN23.1
/rs2[25]: D58.2, J8.14, P1.32, RN23.2
/rs2[26]: D59.2, J8.12, P1.30, RN23.3
/rs2[27]: D60.2, J8.10, P1.29, RN23.4
/rs2[28]: D61.2, J8.8, P1.27, RN23.6
/rs2[29]: D62.2, J8.6, P1.26, RN23.7
/rs2[30]: D63.2, J8.4, P1.24, RN23.8
/rs2[31]: D64.2, J8.2, P1.23, RN23.9
/rs2a[0]: D121.2, J17.16, P1.147, RN47.1
/rs2a[1]: D136.2, J18.2, P1.146, RN50.9
/rs2a[2]: D135.2, J18.4, P1.145, RN50.8
/rs2a[3]: D134.2, J18.6, P1.144, RN50.7
/rs2a[4]: D133.2, J18.8, P1.143, RN50.6
/~BOOT_ALU_EN: D128.2, J17.2, P1.193, RN47.9
/~BOOT_RST: D126.2, J17.6, P1.195, RN47.7
/~BOOT_WR: D125.2, J17.8, P1.196, RN47.6
/~alu_oe: D137.2, J19.16, P1.187, RN53.1
/~rd_wr: D124.2, J17.10, P1.124, RN47.4
/~rs1_rd: D122.2, J17.14, P1.132, RN47.2
/~rs2_rd: D123.2, J17.12, P1.128, RN47.3
/~shift_oe: D138.2, J19.14, P1.185, RN53.2
GNDREF: J9.2, P1.3, P1.9, P1.14, P1.20, P1.25, P1.31, P1.36, P1.42, P1.52, P1.58, P1.63, P1.69, P1.74, P1.80, P1.85, P1.91, P1.101, P1.107, P1.112, P1.118, P1.123, P1.129, P1.134, P1.140, P1.150, P1.156, P1.161, P1.167, P1.172, P1.178, P1.183, P1.189, RN2.5, RN2.10, RN3.5, RN3.10, RN5.5, RN5.10, RN6.5, RN6.10, RN8.5, RN8.10, RN9.5, RN9.10, RN11.5, RN11.10, RN12.5, RN12.10, RN14.5, RN14.10, RN15.5, RN15.10, RN17.5, RN17.10, RN18.5, RN18.10, RN20.5, RN20.10, RN21.5, RN21.10, RN23.5, RN23.10, RN24.5, RN24.10, RN26.5, RN26.10, RN27.5, RN27.10, RN29.5, RN29.10, RN30.5, RN30.10, RN32.5, RN32.10, RN33.5, RN33.10, RN35.5, RN35.10, RN36.5, RN36.10, RN38.5, RN38.10, RN39.5, RN39.10, RN41.5, RN41.10, RN42.5, RN42.10, RN44.5, RN44.10, RN45.5, RN45.10, RN47.5, RN47.10, RN48.5, RN48.10, RN50.5, RN50.10, RN51.5, RN51.10, RN53.5, RN53.10, RN54.5, RN54.10, RN56.5, RN56.10, RN57.5, RN57.10
unnamed: D1.1, RN3.4
unnamed: D2.1, RN3.3
unnamed: D3.1, RN3.2
unnamed: D4.1, RN3.1
unnamed: D5.1, RN3.9
unnamed: D6.1, RN3.8
unnamed: D7.1, RN3.7
unnamed: D8.1, RN3.6
unnamed: D9.1, RN6.4
unnamed: D10.1, RN6.3
unnamed: D11.1, RN6.2
unnamed: D12.1, RN6.1
unnamed: D13.1, RN6.9
unnamed: D14.1, RN6.8
unnamed: D15.1, RN6.7
unnamed: D16.1, RN6.6
unnamed: D17.1, RN9.4
unnamed: D18.1, RN9.3
unnamed: D19.1, RN9.2
unnamed: D20.1, RN9.1
unnamed: D21.1, RN9.9
unnamed: D22.1, RN9.8
unnamed: D23.1, RN9.7
unnamed: D24.1, RN9.6
unnamed: D25.1, RN12.4
unnamed: D26.1, RN12.3
unnamed: D27.1, RN12.2
unnamed: D28.1, RN12.1
unnamed: D29.1, RN12.9
unnamed: D30.1, RN12.8
unnamed: D31.1, RN12.7
unnamed: D32.1, RN12.6
unnamed: D33.1, RN15.4
unnamed: D34.1, RN15.3
unnamed: D35.1, RN15.2
unnamed: D36.1, RN15.1
unnamed: D37.1, RN15.9
unnamed: D38.1, RN15.8
unnamed: D39.1, RN15.7
unnamed: D40.1, RN15.6
unnamed: D41.1, RN18.4
unnamed: D42.1, RN18.3
unnamed: D43.1, RN18.2
unnamed: D44.1, RN18.1
unnamed: D45.1, RN18.9
unnamed: D46.1, RN18.8
unnamed: D47.1, RN18.7
unnamed: D48.1, RN18.6
unnamed: D49.1, RN21.4
unnamed: D50.1, RN21.3
unnamed: D51.1, RN21.2
unnamed: D52.1, RN21.1
unnamed: D53.1, RN21.9
unnamed: D54.1, RN21.8
unnamed: D55.1, RN21.7
unnamed: D56.1, RN21.6
unnamed: D57.1, RN24.4
unnamed: D58.1, RN24.3
unnamed: D59.1, RN24.2
unnamed: D60.1, RN24.1
unnamed: D61.1, RN24.9
unnamed: D62.1, RN24.8
unnamed: D63.1, RN24.7
unnamed: D64.1, RN24.6
unnamed: D65.1, RN27.4
unnamed: D66.1, RN27.3
unnamed: D67.1, RN27.2
unnamed: D68.1, RN27.1
unnamed: D69.1, RN27.9
unnamed: D70.1, RN27.8
unnamed: D71.1, RN27.7
unnamed: D72.1, RN27.6
unnamed: D73.1, RN30.4
unnamed: D74.1, RN30.3
unnamed: D75.1, RN30.2
unnamed: D76.1, RN30.1
unnamed: D77.1, RN30.9
unnamed: D78.1, RN30.8
unnamed: D79.1, RN30.7
unnamed: D80.1, RN30.6
unnamed: D81.1, RN33.4
unnamed: D82.1, RN33.3
unnamed: D83.1, RN33.2
unnamed: D84.1, RN33.1
unnamed: D85.1, RN33.9
unnamed: D86.1, RN33.8
unnamed: D87.1, RN33.7
unnamed: D88.1, RN33.6
unnamed: D89.1, RN36.4
unnamed: D90.1, RN36.3
unnamed: D91.1, RN36.2
unnamed: D92.1, RN36.1
unnamed: D93.1, RN36.9
unnamed: D94.1, RN36.8
unnamed: D95.1, RN36.7
unnamed: D96.1, RN36.6
unnamed: D97.1, RN39.4
unnamed: D98.1, RN39.3
unnamed: D99.1, RN39.2
unnamed: D100.1, RN39.1
unnamed: D101.1, RN39.9
unnamed: D102.1, RN39.8
unnamed: D103.1, RN39.7
unnamed: D104.1, RN39.6
unnamed: D105.1, RN42.4
unnamed: D106.1, RN42.3
unnamed: D107.1, RN42.2
unnamed: D108.1, RN42.1
unnamed: D109.1, RN42.9
unnamed: D110.1, RN42.8
unnamed: D111.1, RN42.7
unnamed: D112.1, RN42.6
unnamed: D113.1, RN45.4
unnamed: D114.1, RN45.3
unnamed: D115.1, RN45.2
unnamed: D116.1, RN45.1
unnamed: D117.1, RN45.9
unnamed: D118.1, RN45.8
unnamed: D119.1, RN45.7
unnamed: D120.1, RN45.6
unnamed: D121.1, RN48.4
unnamed: D122.1, RN48.3
unnamed: D123.1, RN48.2
unnamed: D124.1, RN48.1
unnamed: D125.1, RN48.9
unnamed: D126.1, RN48.8
unnamed: D127.1, RN48.7
unnamed: D128.1, RN48.6
unnamed: D129.1, RN51.4
unnamed: D130.1, RN51.3
unnamed: D131.1, RN51.2
unnamed: D132.1, RN51.1
unnamed: D133.1, RN51.9
unnamed: D134.1, RN51.8
unnamed: D135.1, RN51.7
unnamed: D136.1, RN51.6
unnamed: D137.1, RN54.4
unnamed: D138.1, RN54.3
unnamed: D139.1, RN54.2
unnamed: D140.1, RN54.1
unnamed: D141.1, RN54.9
unnamed: D142.1, RN54.8
unnamed: D143.1, RN54.7
unnamed: D144.1, RN54.6
unnamed: D145.1, RN57.4
unnamed: D146.1, RN57.3
unnamed: D147.1, RN57.2
unnamed: D148.1, RN57.1
unnamed: D149.1, RN57.9
unnamed: D150.1, RN57.8
unnamed: D151.1, RN57.7
unnamed: D152.1, RN57.6
unnamed: J1.1, RN1.9
unnamed: J1.3, RN1.8
unnamed: J1.5, RN1.7
unnamed: J1.7, RN1.6
unnamed: J1.9, RN1.4
unnamed: J1.11, RN1.3
unnamed: J1.13, RN1.2
unnamed: J1.15, RN1.1
unnamed: J2.1, RN4.9
unnamed: J2.3, RN4.8
unnamed: J2.5, RN4.7
unnamed: J2.7, RN4.6
unnamed: J2.9, RN4.4
unnamed: J2.11, RN4.3
unnamed: J2.13, RN4.2
unnamed: J2.15, RN4.1
unnamed: J3.1, RN7.9
unnamed: J3.3, RN7.8
unnamed: J3.5, RN7.7
unnamed: J3.7, RN7.6
unnamed: J3.9, RN7.4
unnamed: J3.11, RN7.3
unnamed: J3.13, RN7.2
unnamed: J3.15, RN7.1
unnamed: J4.1, RN10.9
unnamed: J4.3, RN10.8
unnamed: J4.5, RN10.7
unnamed: J4.7, RN10.6
unnamed: J4.9, RN10.4
unnamed: J4.11, RN10.3
unnamed: J4.13, RN10.2
unnamed: J4.15, RN10.1
unnamed: J5.1, RN13.9
unnamed: J5.3, RN13.8
unnamed: J5.5, RN13.7
unnamed: J5.7, RN13.6
unnamed: J5.9, RN13.4
unnamed: J5.11, RN13.3
unnamed: J5.13, RN13.2
unnamed: J5.15, RN13.1
unnamed: J6.1, RN16.9
unnamed: J6.3, RN16.8
unnamed: J6.5, RN16.7
unnamed: J6.7, RN16.6
unnamed: J6.9, RN16.4
unnamed: J6.11, RN16.3
unnamed: J6.13, RN16.2
unnamed: J6.15, RN16.1
unnamed: J7.1, RN19.9
unnamed: J7.3, RN19.8
unnamed: J7.5, RN19.7
unnamed: J7.7, RN19.6
unnamed: J7.9, RN19.4
unnamed: J7.11, RN19.3
unnamed: J7.13, RN19.2
unnamed: J7.15, RN19.1
unnamed: J8.1, RN22.9
unnamed: J8.3, RN22.8
unnamed: J8.5, RN22.7
unnamed: J8.7, RN22.6
unnamed: J8.9, RN22.4
unnamed: J8.11, RN22.3
unnamed: J8.13, RN22.2
unnamed: J8.15, RN22.1
unnamed: J10.1, RN25.9
unnamed: J10.3, RN25.8
unnamed: J10.5, RN25.7
unnamed: J10.7, RN25.6
unnamed: J10.9, RN25.4
unnamed: J10.11, RN25.3
unnamed: J10.13, RN25.2
unnamed: J10.15, RN25.1
unnamed: J11.1, RN28.9
unnamed: J11.3, RN28.8
unnamed: J11.5, RN28.7
unnamed: J11.7, RN28.6
unnamed: J11.9, RN28.4
unnamed: J11.11, RN28.3
unnamed: J11.13, RN28.2
unnamed: J11.15, RN28.1
unnamed: J12.1, RN31.9
unnamed: J12.3, RN31.8
unnamed: J12.5, RN31.7
unnamed: J12.7, RN31.6
unnamed: J12.9, RN31.4
unnamed: J12.11, RN31.3
unnamed: J12.13, RN31.2
unnamed: J12.15, RN31.1
unnamed: J13.1, RN34.9
unnamed: J13.3, RN34.8
unnamed: J13.5, RN34.7
unnamed: J13.7, RN34.6
unnamed: J13.9, RN34.4
unnamed: J13.11, RN34.3
unnamed: J13.13, RN34.2
unnamed: J13.15, RN34.1
unnamed: J14.1, RN37.9
unnamed: J14.3, RN37.8
unnamed: J14.5, RN37.7
unnamed: J14.7, RN37.6
unnamed: J14.9, RN37.4
unnamed: J14.11, RN37.3
unnamed: J14.13, RN37.2
unnamed: J14.15, RN37.1
unnamed: J15.1, RN40.9
unnamed: J15.3, RN40.8
unnamed: J15.5, RN40.7
unnamed: J15.7, RN40.6
unnamed: J15.9, RN40.4
unnamed: J15.11, RN40.3
unnamed: J15.13, RN40.2
unnamed: J15.15, RN40.1
unnamed: J16.1, RN43.9
unnamed: J16.3, RN43.8
unnamed: J16.5, RN43.7
unnamed: J16.7, RN43.6
unnamed: J16.9, RN43.4
unnamed: J16.11, RN43.3
unnamed: J16.13, RN43.2
unnamed: J16.15, RN43.1
unnamed: J17.1, RN46.9
unnamed: J17.3, RN46.8
unnamed: J17.5, RN46.7
unnamed: J17.7, RN46.6
unnamed: J17.9, RN46.4
unnamed: J17.11, RN46.3
unnamed: J17.13, RN46.2
unnamed: J17.15, RN46.1
unnamed: J18.1, RN49.9
unnamed: J18.3, RN49.8
unnamed: J18.5, RN49.7
unnamed: J18.7, RN49.6
unnamed: J18.9, RN49.4
unnamed: J18.11, RN49.3
unnamed: J18.13, RN49.2
unnamed: J18.15, RN49.1
unnamed: J19.1, RN52.9
unnamed: J19.3, RN52.8
unnamed: J19.5, RN52.7
unnamed: J19.7, RN52.6
unnamed: J19.9, RN52.4
unnamed: J19.11, RN52.3
unnamed: J19.13, RN52.2
unnamed: J19.15, RN52.1
unnamed: J20.1, RN55.9
unnamed: J20.3, RN55.8
unnamed: J20.5, RN55.7
unnamed: J20.7, RN55.6
unnamed: J20.9, RN55.4
unnamed: J20.11, RN55.3
unnamed: J20.13, RN55.2
unnamed: J20.15, RN55.1
