RobertBaruch/lmarv/lmarv-1/ht1632c-to-dip/ht1632c-to-dip.kicad_pcb

## KiCad design lmarv-1/ht1632c-to-dip/ht1632c-to-dip.kicad_pcb (2018-12-16)

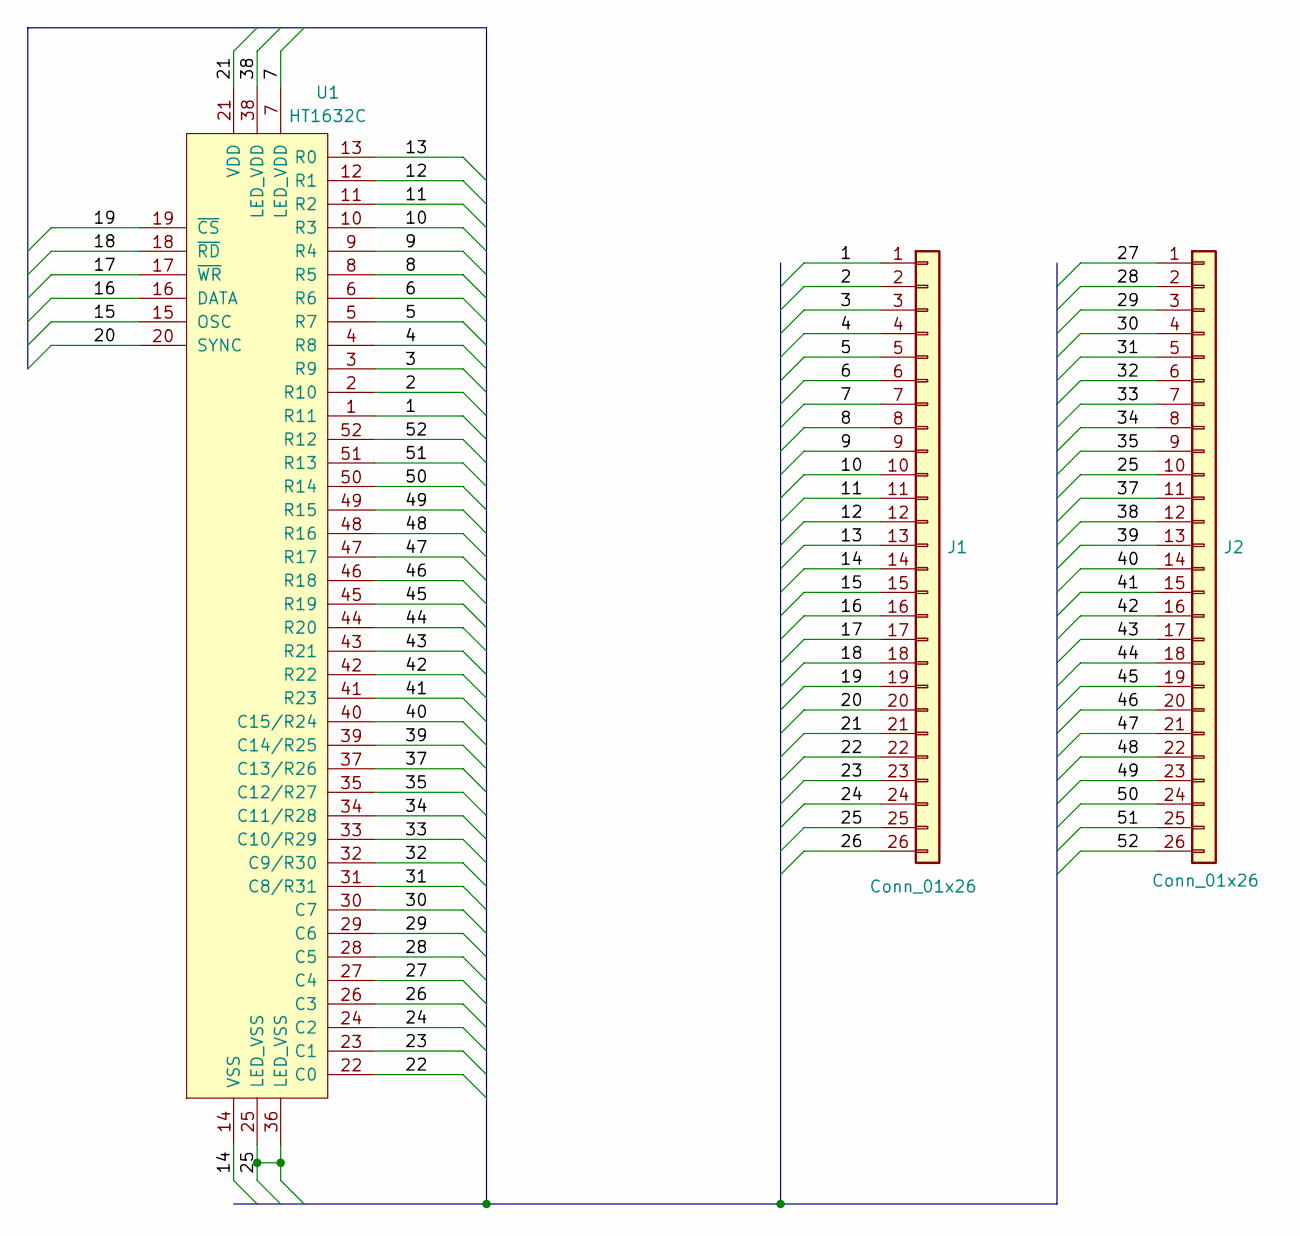
[picture p56: schematic ht1632c-to-dip.sch]

Parts:
J1, J2: Conn_01x26; PinHeader_1x26_P2.54mm_Vertical
U1: HT1632C; QFP-52_14x14_Pitch1mm

Connections:
/1: J1.1, U1.1 (R11)
/2: J1.2, U1.2 (R10)
/3: J1.3, U1.3 (R9)
/4: J1.4, U1.4 (R8)
/5: J1.5, U1.5 (R7)
/6: J1.6, U1.6 (R6)
/7: J1.7, U1.7 (LED_VDD)
/8: J1.8, U1.8 (R5)
/9: J1.9, U1.9 (R4)
/10: J1.10, U1.10 (R3)
/11: J1.11, U1.11 (R2)
/12: J1.12, U1.12 (R1)
/13: J1.13, U1.13 (R0)
/14: J1.14, U1.14 (VSS)
/15: J1.15, U1.15 (OSC)
/16: J1.16, U1.16 (DATA)
/17: J1.17, U1.17 (~WR)
/18: J1.18, U1.18 (~RD)
/19: J1.19, U1.19 (~CS)
/20: J1.20, U1.20 (SYNC)
/21: J1.21, U1.21 (VDD)
/22: J1.22, U1.22 (C0)
/23: J1.23, U1.23 (C1)
/24: J1.24, U1.24 (C2)
/25: J1.25, J2.10, U1.25 (LED_VSS), U1.36 (LED_VSS)
/26: J1.26, U1.26 (C3)
/27: J2.1, U1.27 (C4)
/28: J2.2, U1.28 (C5)
/29: J2.3, U1.29 (C6)
/30: J2.4, U1.30 (C7)
/31: J2.5, U1.31 (C8/R31)
/32: J2.6, U1.32 (C9/R30)
/33: J2.7, U1.33 (C10/R29)
/34: J2.8, U1.34 (C11/R28)
/35: J2.9, U1.35 (C12/R27)
/37: J2.11, U1.37 (C13/R26)
/38: J2.12, U1.38 (LED_VDD)
/39: J2.13, U1.39 (C14/R25)
/40: J2.14, U1.40 (C15/R24)
/41: J2.15, U1.41 (R23)
/42: J2.16, U1.42 (R22)
/43: J2.17, U1.43 (R21)
/44: J2.18, U1.44 (R20)
/45: J2.19, U1.45 (R19)
/46: J2.20, U1.46 (R18)
/47: J2.21, U1.47 (R17)
/48: J2.22, U1.48 (R16)
/49: J2.23, U1.49 (R15)
/50: J2.24, U1.50 (R14)
/51: J2.25, U1.51 (R13)
/52: J2.26, U1.52 (R12)

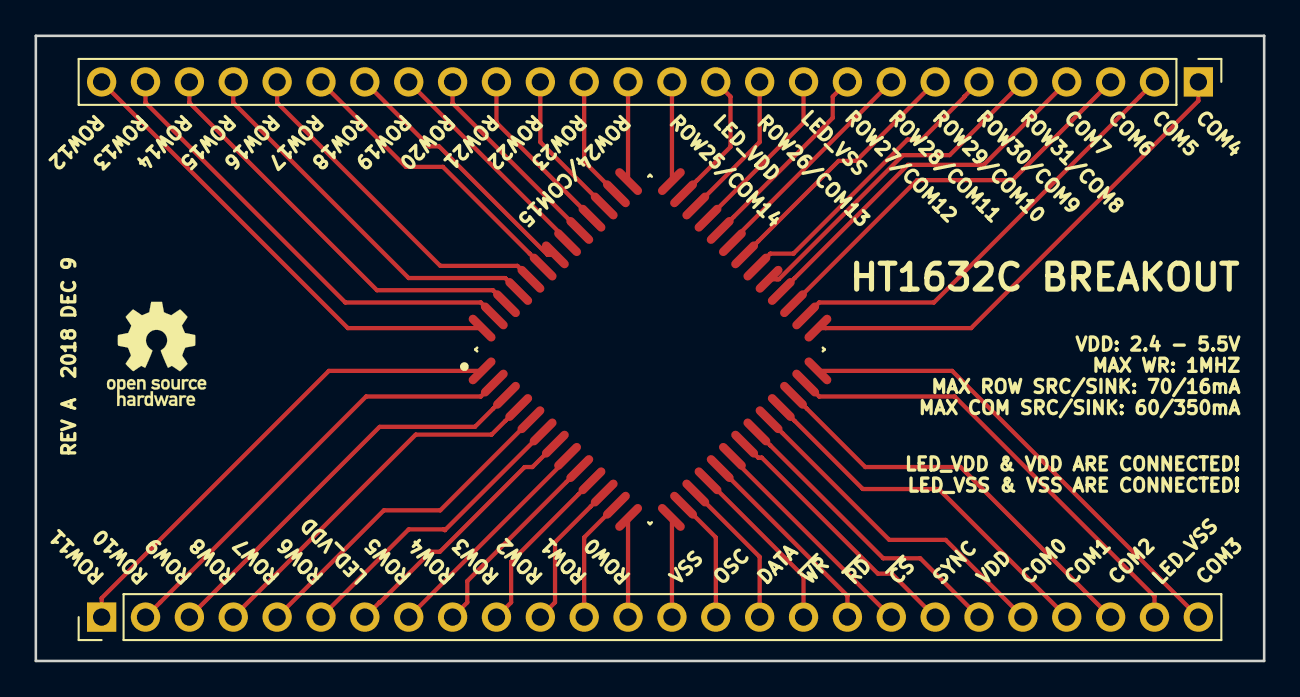
[picture p57: board ht1632c-to-dip.kicad_pcb from above]

Board: 2 copper layers, 71.1 x 36.2 mm, 3 parts (0 on the bottom side), 51 nets.
