RobertBaruch/lmarv/lmarv-1/tester_v2/tester_v2.kicad_pcb

## KiCad design lmarv-1/tester_v2/tester_v2.kicad_pcb (2018-11-14)

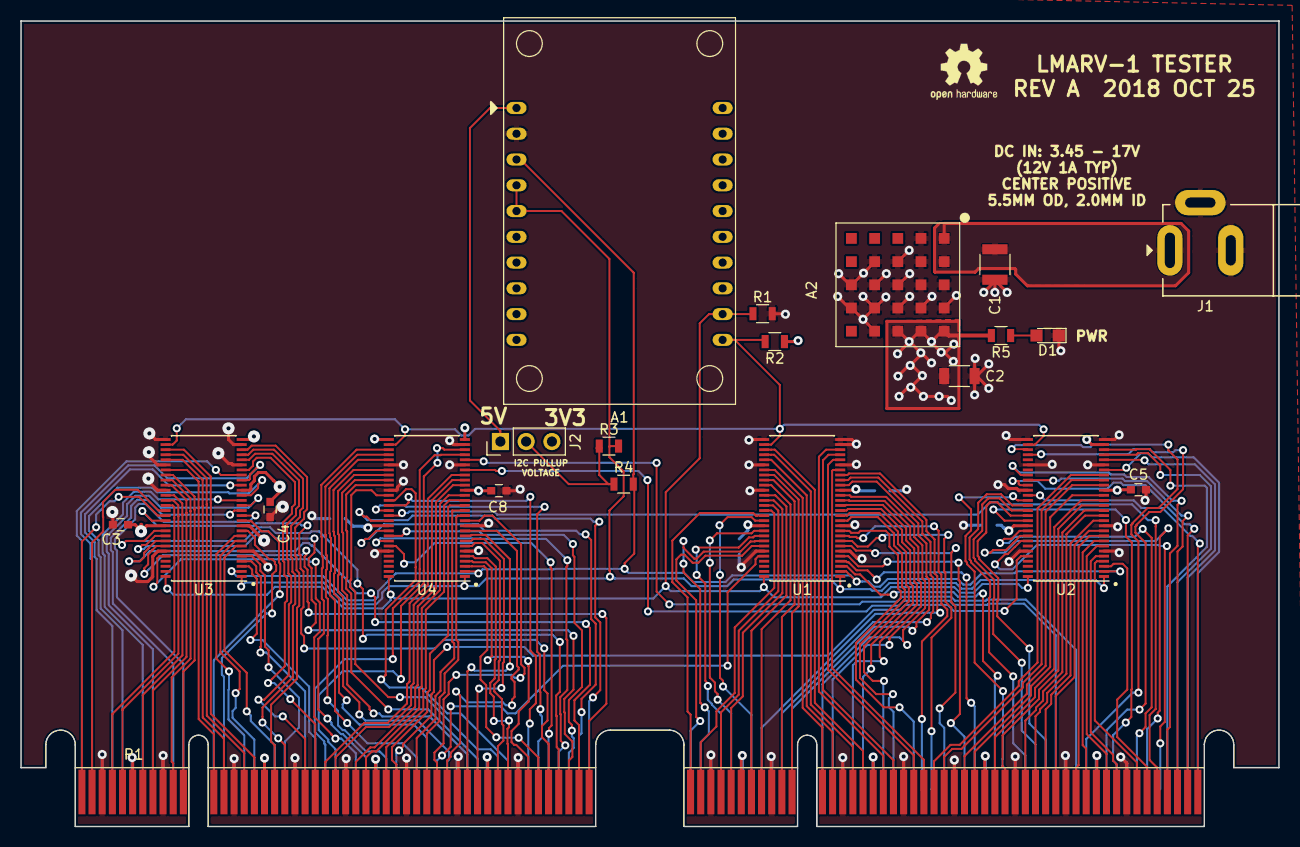
[picture p58: board tester_v2.kicad_pcb from above]

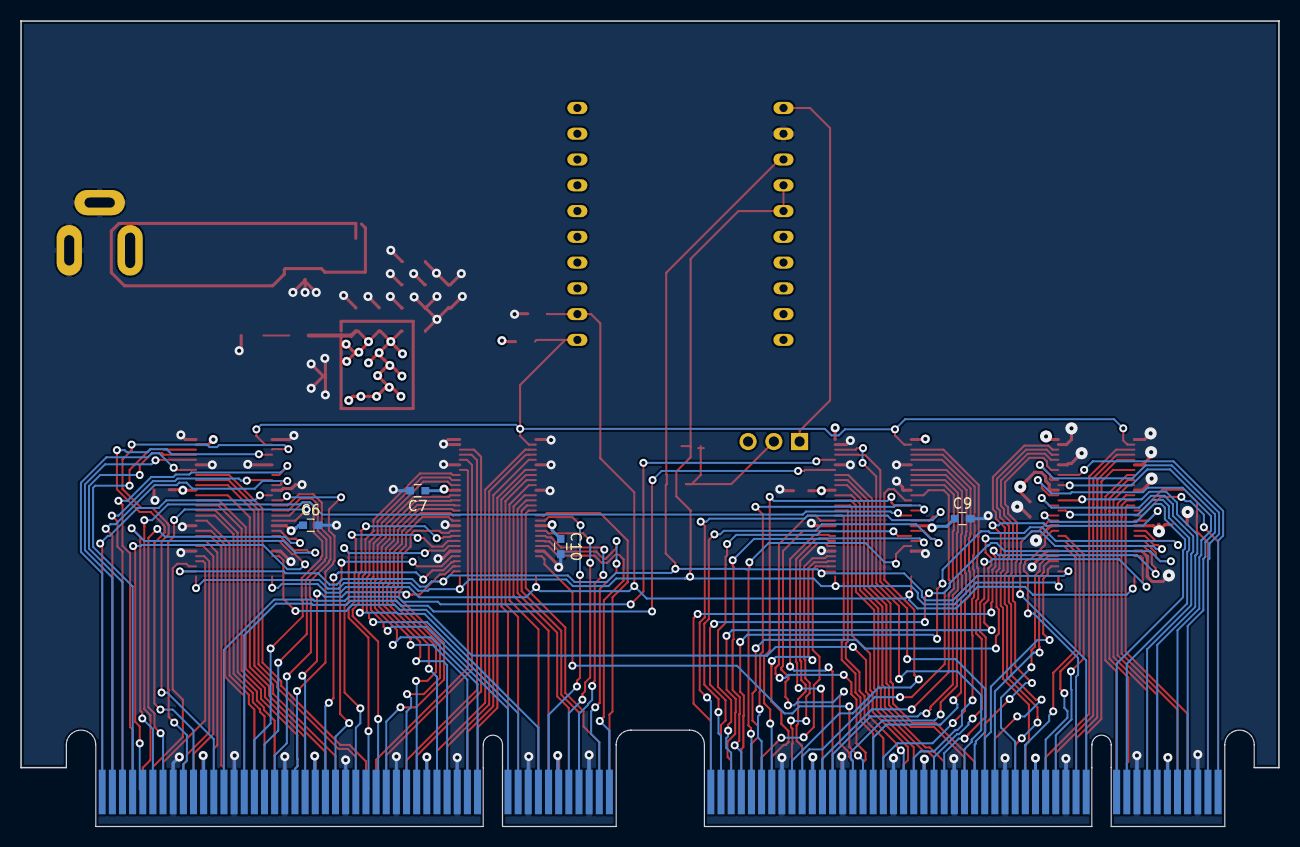
[picture p59: board tester_v2.kicad_pcb from below]

Board: 4 copper layers, 124.0 x 79.4 mm, 25 parts (4 on the bottom side), 158 nets.

Parts:
A1: FT232H_BREAKOUT; ADAFRUIT-FT232H
A2: RPM3.3-3.0; LGA-25_12.19x12.19mm_Layout5x5_P2.29mm_Pad1.0mm
C1: 10u 25v; C_1210
C2: 22u 10v; C_1206
C3, C4, C5, C6, C7, C8, C9, C10: 100n; C_0603
D1: LED; LED_0805
J1: Barrel_Jack; PWRJACK-3_14.4x9.0mm_P4.7mm+6.0mm
J2: Conn_01x03; Pin_Header_Straight_1x03_Pitch2.54mm
P1: dual-pcie-cardedge_split; PCI-EXPRESS
R1, R2, R3, R4: 4k7; R_0805
R5: 220R; R_0805
U1, U2, U3, U4: PCA9698DDG; TSSOP-56_6.1x14mm_Pitch0.5mm

Connections:
+3V3: A2.A5, A2.B5, A2.C5, C2.1, C3.1, C4.1, C5.1, C6.1, C7.1, C8.1, C9.1, C10.1, J2.3, P1.6, P1.17, P1.28, P1.39, P1.55, P1.66, P1.77, P1.88, P1.104, P1.115, P1.126, P1.137, P1.153, P1.164, P1.175, P1.186, R2.1, R5.2, U1.18, U1.46, U2.18, U2.27, U2.46, U3.18, U3.28, U3.46, U4.18, U4.28, U4.29, U4.46
/5V: A1.1, J2.1
/BOOT_CLK: P1.194, U2.25
/I2C_PU: J2.2, R3.1, R4.1
/PWR_LED: D1.2, R5.1
/SCL: A1.3, R4.2, U1.2, U2.2, U3.2, U4.2
/SDA: A1.4, A1.5, R3.2, U1.1, U2.1, U3.1, U4.1
/VIN: A2.A1, A2.A2, C1.1, J1.1
/f[0]: P1.188, U2.45
/f[1]: P1.190, U2.47
/f[2]: P1.191, U2.48
/f[3]: P1.192, U2.49
/nc0: P1.133, U4.36
/nc1: P1.135, U4.37
/nc2: P1.136, U4.38
/nc3: P1.138, U4.40
/nc4: P1.139, U4.41
/nc5: P1.141, U4.42
/nc6: P1.142, U4.43
/nc7: P1.94, U4.44
/nc8: P1.95, U2.36
/nc9: P1.96, U2.37
/nc10: P1.97, U2.38
/nc11: P1.98, U2.40
/nc12: P1.177, U2.41
/nc13: P1.179, U2.42
/nc14: P1.180, U2.43
/nc15: P1.181, U2.44
/nc16: P1.182, U4.22
/nc17: P1.184, U4.24
/nc18: P1.121, U4.25
/nc19: P1.122, U4.26
/nc20: P1.125, U4.31
/nc21: P1.127, U4.32
/nc22: P1.130, U4.33
/nc23: P1.131, U4.35
/rd[0]: P1.71, U1.22
/rd[1]: P1.70, U1.24
/rd[2]: P1.68, U1.25
/rd[3]: P1.67, U1.26
/rd[4]: P1.65, U1.31
/rd[5]: P1.64, U1.32
/rd[6]: P1.62, U1.33
/rd[7]: P1.61, U1.35
/rd[8]: P1.60, U1.36
/rd[9]: P1.59, U1.37
/rd[10]: P1.57, U1.38
/rd[11]: P1.56, U1.40
/rd[12]: P1.54, U1.41
/rd[13]: P1.53, U1.42
/rd[14]: P1.51, U1.43
/rd[15]: P1.50, U1.44
/rd[16]: P1.22, U3.22
/rd[17]: P1.21, U3.24
/rd[18]: P1.19, U3.25
/rd[19]: P1.18, U3.26
/rd[20]: P1.16, U3.31
/rd[21]: P1.15, U3.32
/rd[22]: P1.13, U3.33
/rd[23]: P1.12, U3.35
/rd[24]: P1.11, U3.36
/rd[25]: P1.10, U3.37
/rd[26]: P1.8, U3.38
/rd[27]: P1.7, U3.40
/rd[28]: P1.5, U3.41
/rd[29]: P1.4, U3.42
/rd[30]: P1.2, U3.43
/rd[31]: P1.1, U3.44
/rda[0]: P1.45, U3.45
/rda[1]: P1.46, U3.47
/rda[2]: P1.47, U3.48
/rda[3]: P1.48, U3.49
/rda[4]: P1.49, U3.50
/rs1[0]: P1.176, U1.3
/rs1[1]: P1.174, U1.4
/rs1[2]: P1.173, U1.5
/rs1[3]: P1.171, U1.7
/rs1[4]: P1.170, U1.8
/rs1[5]: P1.169, U1.9
/rs1[6]: P1.168, U1.10
/rs1[7]: P1.166, U1.12
/rs1[8]: P1.165, U1.13
/rs1[9]: P1.163, U1.14
/rs1[10]: P1.162, U1.15
/rs1[11]: P1.160, U1.16
/rs1[12]: P1.159, U1.17
/rs1[13]: P1.158, U1.19
/rs1[14]: P1.157, U1.20
/rs1[15]: P1.155, U1.21
/rs1[16]: P1.120, U3.3
/rs1[17]: P1.119, U3.4
/rs1[18]: P1.117, U3.5
/rs1[19]: P1.116, U3.7
/rs1[20]: P1.114, U3.8
/rs1[21]: P1.113, U3.9
/rs1[22]: P1.111, U3.10
/rs1[23]: P1.110, U3.12
/rs1[24]: P1.109, U3.13
/rs1[25]: P1.108, U3.14
/rs1[26]: P1.106, U3.15
/rs1[27]: P1.105, U3.16
/rs1[28]: P1.103, U3.17
/rs1[29]: P1.102, U3.19
/rs1[30]: P1.100, U3.20
/rs1[31]: P1.99, U3.21
/rs1a[0]: P1.154, U1.45
/rs1a[1]: P1.152, U1.47
/rs1a[2]: P1.151, U1.48
/rs1a[3]: P1.149, U1.49
/rs1a[4]: P1.148, U1.50
/rs2[0]: P1.93, U2.3
/rs2[1]: P1.92, U2.4
/rs2[2]: P1.90, U2.5
/rs2[3]: P1.89, U2.7
/rs2[4]: P1.87, U2.8
/rs2[5]: P1.86, U2.9
/rs2[6]: P1.84, U2.10
/rs2[7]: P1.83, U2.12
/rs2[8]: P1.82, U2.13
/rs2[9]: P1.81, U2.14
/rs2[10]: P1.79, U2.15
/rs2[11]: P1.78, U2.16
/rs2[12]: P1.76, U2.17
/rs2[13]: P1.75, U2.19
/rs2[14]: P1.73, U2.20
/rs2[15]: P1.72, U2.21
/rs2[16]: P1.44, U4.3
/rs2[17]: P1.43, U4.4
/rs2[18]: P1.41, U4.5
/rs2[19]: P1.40, U4.7
/rs2[20]: P1.38, U4.8
/rs2[21]: P1.37, U4.9
/rs2[22]: P1.35, U4.10
/rs2[23]: P1.34, U4.12
/rs2[24]: P1.33, U4.13
/rs2[25]: P1.32, U4.14
/rs2[26]: P1.30, U4.15
/rs2[27]: P1.29, U4.16
/rs2[28]: P1.27, U4.17
/rs2[29]: P1.26, U4.19
/rs2[30]: P1.24, U4.20
/rs2[31]: P1.23, U4.21
/rs2a[0]: P1.147, U4.45
/rs2a[1]: P1.146, U4.47
/rs2a[2]: P1.145, U4.48
/rs2a[3]: P1.144, U4.49
/rs2a[4]: P1.143, U4.50
/~BOOT_ALU_EN: P1.193, U2.26
/~BOOT_RST: P1.195, U2.24
/~BOOT_WR: P1.196, U2.22
/~OE: A1.11, R2.2, U1.30, U2.30, U3.30, U4.30
/~RESET: A1.12, R1.1, U1.56, U2.56, U3.56, U4.56
/~alu_oe: P1.187, U2.32
/~rd_wr: P1.124, U3.52
/~rs1_rd: P1.132, U1.52
/~rs2_rd: P1.128, U2.52
/~shift_oe: P1.185, U2.31
GNDREF: A1.2, A2.A3, A2.A4, A2.B1, A2.B2, A2.B3, A2.B4, A2.C2, A2.C3, A2.C4, A2.D2, A2.D3, A2.D4, A2.D5, A2.E3, A2.E4, C1.2, C2.2, C3.2, C4.2, C5.2, C6.2, C7.2, C8.2, C9.2, C10.2, D1.1, J1.2, J1.3, P1.3, P1.9, P1.14, P1.20, P1.25, P1.31, P1.36, P1.42, P1.52, P1.58, P1.63, P1.69, P1.74, P1.80, P1.85, P1.91, P1.101, P1.107, P1.112, P1.118, P1.123, P1.129, P1.134, P1.140, P1.150, P1.156, P1.161, P1.167, P1.172, P1.178, P1.183, P1.189, R1.2, U1.6, U1.11, U1.23, U1.27, U1.28, U1.29, U1.34, U1.39, U1.51, U2.6, U2.11, U2.23, U2.28, U2.29, U2.34, U2.39, U2.51, U3.6, U3.11, U3.23, U3.27, U3.29, U3.34, U3.39, U3.51, U4.6, U4.11, U4.23, U4.27, U4.34, U4.39, U4.51
