RobertBaruch/lmarv/lmarv-1/tester/tester.kicad_pcb

## KiCad design lmarv-1/tester/tester.kicad_pcb (2018-10-13, an earlier design)

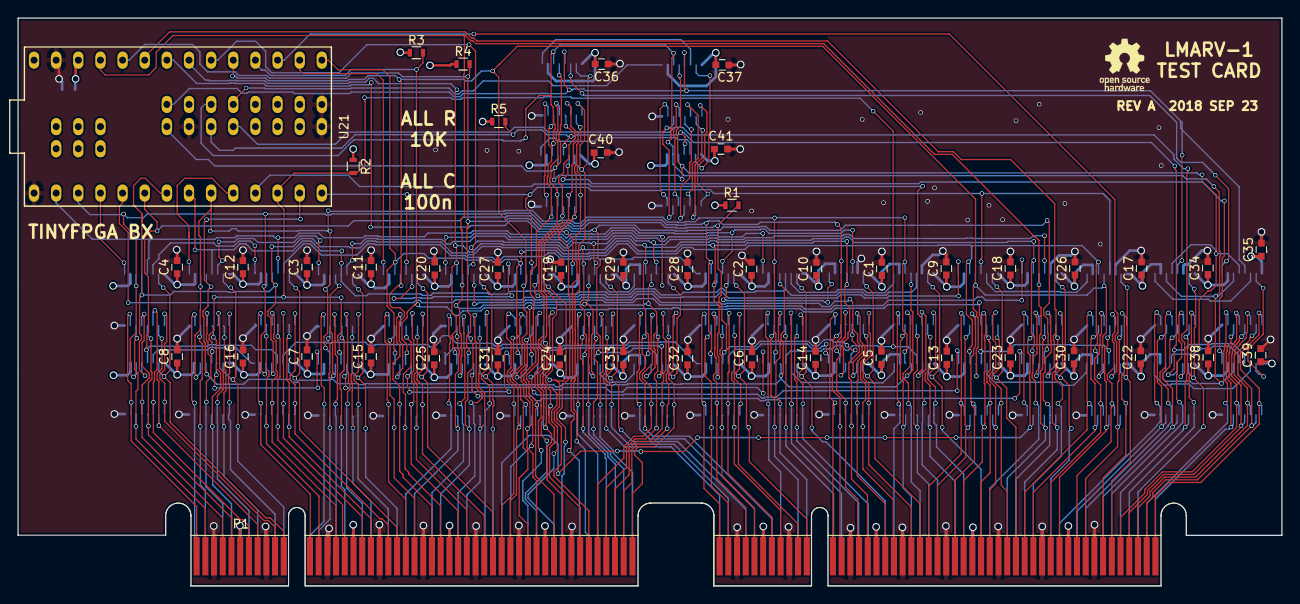
[picture p60: board tester.kicad_pcb from above]

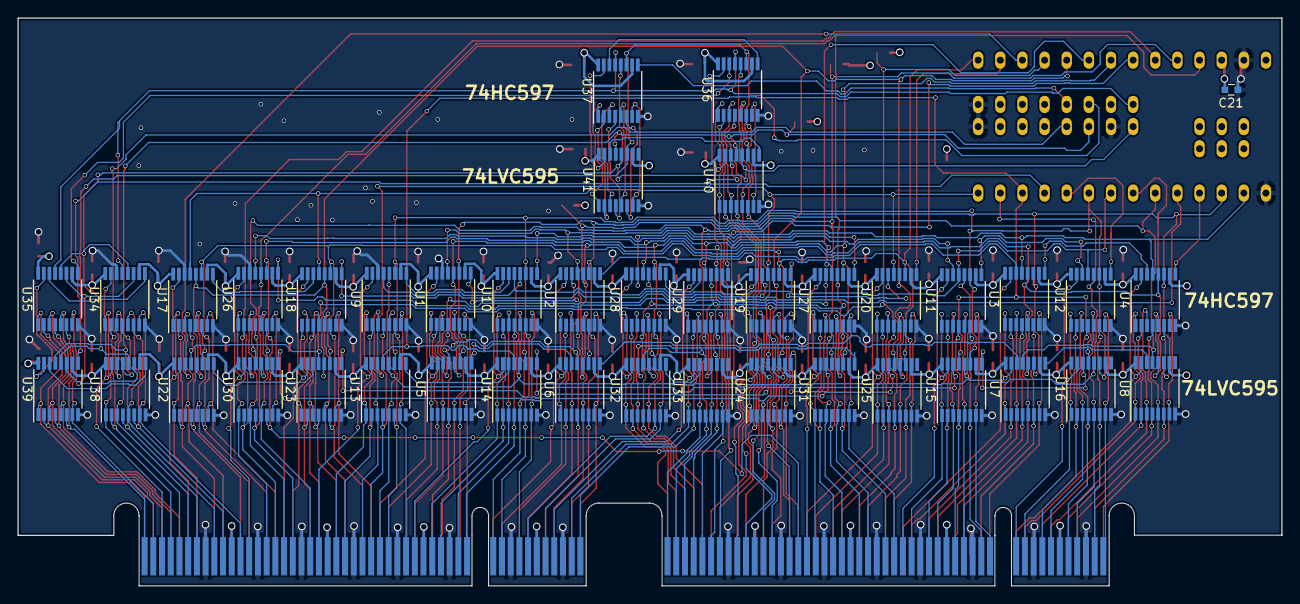
[picture p61: board tester.kicad_pcb from below]

Board: 4 copper layers, 145.0 x 65.1 mm, 88 parts (41 on the bottom side), 222 nets.

Parts:
C1, C2, C3, C4, C5, C6, C7, C8, C9, C10, C11, C12, C13, C14, C15, C16, C17, C18, C19, C20, C21, C22, C23, C24, C25, C26, C27, C28, C29, C30, C31, C32, C33, C34, C35, C36, C37, C38, C39, C40, C41: 0u1; C_0603
P1: dual-pcie-cardedge; PCI-EXPRESS
R1, R2, R3, R4, R5: 10k; R_0603
U1, U2, U3, U4, U9, U10, U11, U12, U17, U18, U19, U20, U26, U27, U28, U29, U34, U35, U36, U37: 74HC597; TSSOP-16_4.4x5mm_Pitch0.65mm
U5, U6, U7, U8, U13, U14, U15, U16, U22, U23, U24, U25, U30, U31, U32, U33, U38, U39, U40, U41: 74LVC595; TSSOP-16_4.4x5mm_Pitch0.65mm
U21: TinyFPGA_BX

Connections:
/BOOT_CLK: P1.194, U34.15, U38.15
/CCLK: U21.48, U34.11, U35.11, U36.11, U37.11, U38.11, U39.11, U40.11, U41.11
/CRS0: U34.9, U35.14
/CRS1: U35.9, U36.14
/CRS2: U36.9, U37.14
/CSI: U21.38, U38.14
/CSO: U21.47, U37.9
/CWLD: U21.35, U34.12, U35.12, U36.12, U37.12, U38.12, U39.12, U40.12, U41.12
/CWS0: U38.9, U39.14
/CWS1: U39.9, U40.14
/CWS2: U40.9, U41.14
/RCCLK: U21.21, U26.11, U27.11, U28.11, U29.11, U30.11, U31.11, U32.11, U33.11
/RCRS0: U26.9, U27.14
/RCRS1: U27.9, U28.14
/RCRS2: U28.9, U29.14
/RCSI: U21.23, U30.14
/RCSO: U21.22, U29.9
/RCWLD: U21.25, U26.12, U27.12, U28.12, U29.12, U30.12, U31.12, U32.12, U33.12
/RCWS0: U30.9, U31.14
/RCWS1: U31.9, U32.14
/RCWS2: U32.9, U33.14
/RDCLK: U1.11, U2.11, U3.11, U4.11, U5.11, U6.11, U7.11, U8.11, U21.3
/RDRS0: U1.9, U2.14
/RDRS1: U2.9, U3.14
/RDRS2: U3.9, U4.14
/RDSI: U5.14, U21.5
/RDSO: U4.9, U21.4
/RDWLD: U1.12, U2.12, U3.12, U4.12, U5.12, U6.12, U7.12, U8.12, U21.7
/RDWS0: U5.9, U6.14
/RDWS1: U6.9, U7.14
/RDWS2: U7.9, U8.14
/RS1CLK: U9.11, U10.11, U11.11, U12.11, U13.11, U14.11, U15.11, U16.11, U21.9
/RS1RS0: U9.9, U10.14
/RS1RS1: U10.9, U11.14
/RS1RS2: U11.9, U12.14
/RS1SI: U13.14, U21.11
/RS1SO: U12.9, U21.10
/RS1WLD: U9.12, U10.12, U11.12, U12.12, U13.12, U14.12, U15.12, U16.12, U21.13
/RS1WS0: U13.9, U14.14
/RS1WS1: U14.9, U15.14
/RS1WS2: U15.9, U16.14
/RS2CLK: U17.11, U18.11, U19.11, U20.11, U21.15, U22.11, U23.11, U24.11, U25.11
/RS2RS0: U17.9, U18.14
/RS2RS1: U18.9, U19.14
/RS2RS2: U19.9, U20.14
/RS2SI: U21.17, U22.14
/RS2SO: U20.9, U21.16
/RS2WLD: U17.12, U18.12, U19.12, U20.12, U21.19, U22.12, U23.12, U24.12, U25.12
/RS2WS0: U22.9, U23.14
/RS2WS1: U23.9, U24.14
/RS2WS2: U24.9, U25.14
/f[0]: P1.188, U34.5, U38.5
/f[1]: P1.190, U34.4, U38.4
/f[2]: P1.191, U34.3, U38.3
/f[3]: P1.192, U34.2, U38.2
/nc[0]: P1.133, U36.6, U40.6
/nc[1]: P1.135, U36.5, U40.5
/nc[2]: P1.136, U36.4, U40.4
/nc[3]: P1.138, U36.3, U40.3
/nc[4]: P1.139, U36.2, U40.2
/nc[5]: P1.141, U36.1, U40.1
/nc[6]: P1.142, U36.15, U40.15
/nc[7]: P1.94, U35.5, U39.5
/nc[8]: P1.95, U35.4, U39.4
/nc[9]: P1.96, U35.3, U39.3
/nc[10]: P1.97, U35.2, U39.2
/nc[11]: P1.98, U35.1, U39.1
/q0: U26.7, U30.7
/q1: U28.15, U32.15
/q2: U35.15, U39.15
/q3: U36.7, U40.7
/q4: U37.15, U41.15
/q5: U37.1, U41.1
/q6: U37.2, U41.2
/q7: U37.3, U41.3
/q8: U37.4, U41.4
/q9: U37.5, U41.5
/q10: U37.6, U41.6
/q11: U37.7, U41.7
/rd[0]: P1.71, U1.15, U5.15
/rd[1]: P1.70, U1.1, U5.1
/rd[2]: P1.68, U1.2, U5.2
/rd[3]: P1.67, U1.3, U5.3
/rd[4]: P1.65, U1.4, U5.4
/rd[5]: P1.64, U1.5, U5.5
/rd[6]: P1.62, U1.6, U5.6
/rd[7]: P1.61, U1.7, U5.7
/rd[8]: P1.60, U2.15, U6.15
/rd[9]: P1.59, U2.1, U6.1
/rd[10]: P1.57, U2.2, U6.2
/rd[11]: P1.56, U2.3, U6.3
/rd[12]: P1.54, U2.4, U6.4
/rd[13]: P1.53, U2.5, U6.5
/rd[14]: P1.51, U2.6, U6.6
/rd[15]: P1.50, U2.7, U6.7
/rd[16]: P1.22, U3.15, U7.15
/rd[17]: P1.21, U3.1, U7.1
/rd[18]: P1.19, U3.2, U7.2
/rd[19]: P1.18, U3.3, U7.3
/rd[20]: P1.16, U3.4, U7.4
/rd[21]: P1.15, U3.5, U7.5
/rd[22]: P1.13, U3.6, U7.6
/rd[23]: P1.12, U3.7, U7.7
/rd[24]: P1.11, U4.15, U8.15
/rd[25]: P1.10, U4.1, U8.1
/rd[26]: P1.8, U4.2, U8.2
/rd[27]: P1.7, U4.3, U8.3
/rd[28]: P1.5, U4.4, U8.4
/rd[29]: P1.4, U4.5, U8.5
/rd[30]: P1.2, U4.6, U8.6
/rd[31]: P1.1, U4.7, U8.7
/rda[0]: P1.45, U28.5, U32.5
/rda[1]: P1.46, U28.4, U32.4
/rda[2]: P1.47, U28.3, U32.3
/rda[3]: P1.48, U28.2, U32.2
/rda[4]: P1.49, U28.1, U32.1
/rs1[0]: P1.176, U9.15, U13.15
/rs1[1]: P1.174, U9.1, U13.1
/rs1[2]: P1.173, U9.2, U13.2
/rs1[3]: P1.171, U9.3, U13.3
/rs1[4]: P1.170, U9.4, U13.4
/rs1[5]: P1.169, U9.5, U13.5
/rs1[6]: P1.168, U9.6, U13.6
/rs1[7]: P1.166, U9.7, U13.7
/rs1[8]: P1.165, U10.15, U14.15
/rs1[9]: P1.163, U10.1, U14.1
/rs1[10]: P1.162, U10.2, U14.2
/rs1[11]: P1.160, U10.3, U14.3
/rs1[12]: P1.159, U10.4, U14.4
/rs1[13]: P1.158, U10.5, U14.5
/rs1[14]: P1.157, U10.6, U14.6
/rs1[15]: P1.155, U10.7, U14.7
/rs1[16]: P1.120, U11.15, U15.15
/rs1[17]: P1.119, U11.1, U15.1
/rs1[18]: P1.117, U11.2, U15.2
/rs1[19]: P1.116, U11.3, U15.3
/rs1[20]: P1.114, U11.4, U15.4
/rs1[21]: P1.113, U11.5, U15.5
/rs1[22]: P1.111, U11.6, U15.6
/rs1[23]: P1.110, U11.7, U15.7
/rs1[24]: P1.109, U12.15, U16.15
/rs1[25]: P1.108, U12.1, U16.1
/rs1[26]: P1.106, U12.2, U16.2
/rs1[27]: P1.105, U12.3, U16.3
/rs1[28]: P1.103, U12.4, U16.4
/rs1[29]: P1.102, U12.5, U16.5
/rs1[30]: P1.100, U12.6, U16.6
/rs1[31]: P1.99, U12.7, U16.7
/rs1a[0]: P1.154, U28.6, U32.6
/rs1a[1]: P1.152, U28.7, U32.7
/rs1a[2]: P1.151, U29.15, U33.15
/rs1a[3]: P1.149, U29.1, U33.1
/rs1a[4]: P1.148, U29.2, U33.2
/rs2[0]: P1.93, U17.15, U22.15
/rs2[1]: P1.92, U17.1, U22.1
/rs2[2]: P1.90, U17.2, U22.2
/rs2[3]: P1.89, U17.3, U22.3
/rs2[4]: P1.87, U17.4, U22.4
/rs2[5]: P1.86, U17.5, U22.5
/rs2[6]: P1.84, U17.6, U22.6
/rs2[7]: P1.83, U17.7, U22.7
/rs2[8]: P1.82, U18.15, U23.15
/rs2[9]: P1.81, U18.1, U23.1
/rs2[10]: P1.79, U18.2, U23.2
/rs2[11]: P1.78, U18.3, U23.3
/rs2[12]: P1.76, U18.4, U23.4
/rs2[13]: P1.75, U18.5, U23.5
/rs2[14]: P1.73, U18.6, U23.6
/rs2[15]: P1.72, U18.7, U23.7
/rs2[16]: P1.44, U19.15, U24.15
/rs2[17]: P1.43, U19.1, U24.1
/rs2[18]: P1.41, U19.2, U24.2
/rs2[19]: P1.40, U19.3, U24.3
/rs2[20]: P1.38, U19.4, U24.4
/rs2[21]: P1.37, U19.5, U24.5
/rs2[22]: P1.35, U19.6, U24.6
/rs2[23]: P1.34, U19.7, U24.7
/rs2[24]: P1.33, U20.15, U25.15
/rs2[25]: P1.32, U20.1, U25.1
/rs2[26]: P1.30, U20.2, U25.2
/rs2[27]: P1.29, U20.3, U25.3
/rs2[28]: P1.27, U20.4, U25.4
/rs2[29]: P1.26, U20.5, U25.5
/rs2[30]: P1.24, U20.6, U25.6
/rs2[31]: P1.23, U20.7, U25.7
/rs2a[0]: P1.147, U29.3, U33.3
/rs2a[1]: P1.146, U29.4, U33.4
/rs2a[2]: P1.145, U29.5, U33.5
/rs2a[3]: P1.144, U29.6, U33.6
/rs2a[4]: P1.143, U29.7, U33.7
/~BOOT_ALU_EN: P1.193, U34.1, U38.1
/~BOOT_RST: P1.195, U35.7, U39.7
/~BOOT_WR: P1.196, U35.6, U39.6
/~COE: R5.2, U21.37, U38.13, U39.13, U40.13, U41.13
/~CRLD: U21.50, U34.13, U35.13, U36.13, U37.13
/~RCOE: R4.2, U21.24, U30.13, U31.13, U32.13, U33.13
/~RCRLD: U21.20, U26.13, U27.13, U28.13, U29.13
/~RDOE: R1.2, U5.13, U6.13, U7.13, U8.13, U21.6
/~RDRLD: U1.13, U2.13, U3.13, U4.13, U21.2
/~RS1OE: R2.2, U13.13, U14.13, U15.13, U16.13, U21.12
/~RS1RLD: U9.13, U10.13, U11.13, U12.13, U21.8
/~RS2OE: R3.2, U21.18, U22.13, U23.13, U24.13, U25.13
/~RS2RLD: U17.13, U18.13, U19.13, U20.13, U21.14
/~alu_oe: P1.187, U34.6, U38.6
/~rd_bhh: P1.121, U27.7, U31.7
/~rd_bhl: P1.122, U27.6, U31.6
/~rd_blh: P1.177, U26.5, U30.5
/~rd_bll: P1.179, U26.4, U30.4
/~rd_wr: P1.124, U27.5, U31.5
/~rs1_bhh: P1.130, U27.1, U31.1
/~rs1_bhl: P1.131, U27.15, U31.15
/~rs1_blh: P1.182, U26.1, U30.1
/~rs1_bll: P1.184, U26.15, U30.15
/~rs1_rd: P1.132, U26.6, U30.6
/~rs2_bhh: P1.125, U27.4, U31.4
/~rs2_bhl: P1.127, U27.3, U31.3
/~rs2_blh: P1.180, U26.3, U30.3
/~rs2_bll: P1.181, U26.2, U30.2
/~rs2_rd: P1.128, U27.2, U31.2
/~shift_oe: P1.185, U34.7, U38.7
GND: C1.2, C2.2, C3.2, C4.2, C5.2, C6.2, C7.2, C8.2, C9.2, C10.2, C11.2, C12.2, C13.2, C14.2, C15.2, C16.2, C17.2, C18.2, C19.2, C20.2, C21.2, C22.2, C23.2, C24.2, C25.2, C26.2, C27.2, C28.2, C29.2, C30.2, C31.2, C32.2, C33.2, C34.2, C35.2, C36.2, C37.2, C38.2, C39.2, C40.2, C41.2, P1.3, P1.9, P1.14, P1.20, P1.25, P1.31, P1.36, P1.42, P1.52, P1.58, P1.63, P1.69, P1.74, P1.80, P1.85, P1.91, P1.101, P1.107, P1.112, P1.118, P1.123, P1.129, P1.134, P1.140, P1.150, P1.156, P1.161, P1.167, P1.172, P1.178, P1.183, P1.189, U1.8, U1.14, U2.8, U3.8, U4.8, U5.8, U6.8, U7.8, U8.8, U9.8, U9.14, U10.8, U11.8, U12.8, U13.8, U14.8, U15.8, U16.8, U17.8, U17.14, U18.8, U19.8, U20.8, U21.1, U21.27, U21.36, U21.42, U21.43, U22.8, U23.8, U24.8, U25.8, U26.8, U26.14, U27.8, U28.8, U29.8, U30.8, U31.8, U32.8, U33.8, U34.8, U34.14, U35.8, U36.8, U37.8, U38.8, U39.8, U40.8, U41.8
VCC: C1.1, C2.1, C3.1, C4.1, C5.1, C6.1, C7.1, C8.1, C9.1, C10.1, C11.1, C12.1, C13.1, C14.1, C15.1, C16.1, C17.1, C18.1, C19.1, C20.1, C21.1, C22.1, C23.1, C24.1, C25.1, C26.1, C27.1, C28.1, C29.1, C30.1, C31.1, C32.1, C33.1, C34.1, C35.1, C36.1, C37.1, C38.1, C39.1, C40.1, C41.1, P1.6, P1.17, P1.28, P1.39, P1.55, P1.66, P1.77, P1.88, P1.104, P1.115, P1.126, P1.137, P1.153, P1.164, P1.175, P1.186, R1.1, R2.1, R3.1, R4.1, R5.1, U1.10, U1.16, U2.10, U2.16, U3.10, U3.16, U4.10, U4.16, U5.10, U5.16, U6.10, U6.16, U7.10, U7.16, U8.10, U8.16, U9.10, U9.16, U10.10, U10.16, U11.10, U11.16, U12.10, U12.16, U13.10, U13.16, U14.10, U14.16, U15.10, U15.16, U16.10, U16.16, U17.10, U17.16, U18.10, U18.16, U19.10, U19.16, U20.10, U20.16, U21.26, U22.10, U22.16, U23.10, U23.16, U24.10, U24.16, U25.10, U25.16, U26.10, U26.16, U27.10, U27.16, U28.10, U28.16, U29.10, U29.16, U30.10, U30.16, U31.10, U31.16, U32.10, U32.16, U33.10, U33.16, U34.10, U34.16, U35.10, U35.16, U36.10, U36.16, U37.10, U37.16, U38.10, U38.16, U39.10, U39.16, U40.10, U40.16, U41.10, U41.16
