RobertBaruch/lmarv/lmarv-1/shifter/shifter.kicad_pcb

## KiCad design lmarv-1/shifter/shifter.kicad_pcb (2018-08-10)

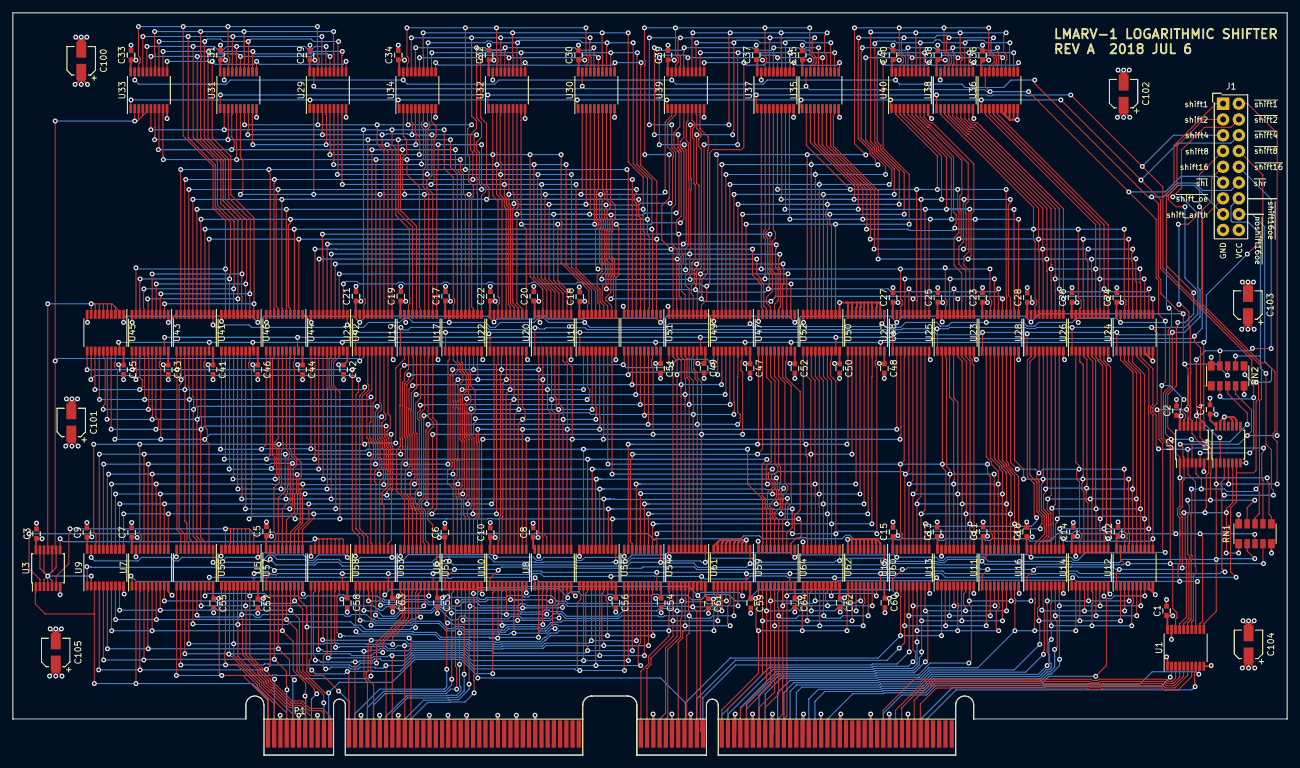
[picture p62: board shifter.kicad_pcb from above]

Board: 4 copper layers, 205.0 x 119.4 mm, 138 parts (0 on the bottom side), 222 nets.

Parts:
C1, C2, C3, C4, C5, C6, C7, C8, C9, C10, C11, C12, C13, C14, C15, C16, C17, C18, C19, C20, C21, C22, C23, C24, C25, C26, C27, C28, C29, C30, C31, C32, C33, C34, C35, C36, C37, C38, C39, C40, C41, C42, C43, C44, C45, C46, C47, C48, C49, C50, C51, C52, C53, C54, C55, C56, C57, C58, C59, C60, C61, C62, C63, C64: 100n; C_0603
C100, C101, C102, C103, C104, C105: 10u; CP_Elec_4x4.5
J1: Conn_02x09_Odd_Even; SDL-118-X-XX_2x09
P1: dual-pcie-cardedge; PCI-EXPRESS
RN1, RN2: RPACK8; Yageo_YC358
U1, U5, U6, U7, U8, U9, U10, U11, U12, U13, U14, U15, U16, U17, U18, U19, U20, U21, U22, U23, U24, U25, U26, U27, U28, U29, U30, U31, U32, U33, U34, U35, U36, U37, U38, U39, U40, U41, U42, U43, U44, U45, U46, U47, U48, U49, U50, U51, U52, U53, U54, U55, U56, U57, U58, U59, U60, U61, U62, U63, U64: 74LVC541; TSSOP-20_4.4x6.5mm_Pitch0.65mm
U2: 74LVC04; TSSOP-14_4.4x5mm_Pitch0.65mm
U3: 74LVC08; TSSOP-14_4.4x5mm_Pitch0.65mm
U4: 74LVC32; TSSOP-14_4.4x5mm_Pitch0.65mm

Connections:
/msb: U3.3, U3.4, U3.5, U3.9, U3.10, U3.12, U3.13, U9.2, U21.2, U21.3, U33.2, U33.3, U33.4, U33.5
/msb': U3.6, U57.2, U57.3, U57.4, U57.5, U57.6, U57.7, U57.8, U57.9
/msb'': U3.8, U58.2, U58.3, U58.4, U58.5, U58.6, U58.7, U58.8, U58.9
/msb''': U3.11, U45.2, U45.3, U45.4, U45.5, U45.6, U45.7, U45.8, U45.9
/rd[0]: P1.71, U60.18, U62.18, U64.18
/rd[1]: P1.70, U60.17, U62.17, U64.17
/rd[2]: P1.68, U60.16, U62.16, U64.16
/rd[3]: P1.67, U60.15, U62.15, U64.15
/rd[4]: P1.65, U60.14, U62.14, U64.14
/rd[5]: P1.64, U60.13, U62.13, U64.13
/rd[6]: P1.62, U60.12, U62.12, U64.12
/rd[7]: P1.61, U60.11, U62.11, U64.11
/rd[8]: P1.60, U59.18, U61.18, U63.18
/rd[9]: P1.59, U59.17, U61.17, U63.17
/rd[10]: P1.57, U59.16, U61.16, U63.16
/rd[11]: P1.56, U59.15, U61.15, U63.15
/rd[12]: P1.54, U59.14, U61.14, U63.14
/rd[13]: P1.53, U59.13, U61.13, U63.13
/rd[14]: P1.51, U59.12, U61.12, U63.12
/rd[15]: P1.50, U59.11, U61.11, U63.11
/rd[16]: P1.22, U54.18, U56.18, U58.18
/rd[17]: P1.21, U54.17, U56.17, U58.17
/rd[18]: P1.19, U54.16, U56.16, U58.16
/rd[19]: P1.18, U54.15, U56.15, U58.15
/rd[20]: P1.16, U54.14, U56.14, U58.14
/rd[21]: P1.15, U54.13, U56.13, U58.13
/rd[22]: P1.13, U54.12, U56.12, U58.12
/rd[23]: P1.12, U54.11, U56.11, U58.11
/rd[24]: P1.11, U53.18, U55.18, U57.18
/rd[25]: P1.10, U53.17, U55.17, U57.17
/rd[26]: P1.8, U53.16, U55.16, U57.16
/rd[27]: P1.7, U53.15, U55.15, U57.15
/rd[28]: P1.5, U53.14, U55.14, U57.14
/rd[29]: P1.4, U53.13, U55.13, U57.13
/rd[30]: P1.2, U53.12, U55.12, U57.12
/rd[31]: P1.1, U53.11, U55.11, U57.11
/rs1[0]: P1.176, U12.8, U14.9
/rs1[1]: P1.174, U12.7, U14.8, U16.9
/rs1[2]: P1.173, U12.6, U14.7, U16.8
/rs1[3]: P1.171, U12.5, U14.6, U16.7
/rs1[4]: P1.170, U12.4, U14.5, U16.6
/rs1[5]: P1.169, U12.3, U14.4, U16.5
/rs1[6]: P1.168, U12.2, U14.3, U16.4
/rs1[7]: P1.166, U11.9, U14.2, U16.3
/rs1[8]: P1.165, U11.8, U13.9, U16.2
/rs1[9]: P1.163, U11.7, U13.8, U15.9
/rs1[10]: P1.162, U11.6, U13.7, U15.8
/rs1[11]: P1.160, U11.5, U13.6, U15.7
/rs1[12]: P1.159, U11.4, U13.5, U15.6
/rs1[13]: P1.158, U11.3, U13.4, U15.5
/rs1[14]: P1.157, U11.2, U13.3, U15.4
/rs1[15]: P1.155, U6.9, U13.2, U15.3
/rs1[16]: P1.120, U6.8, U8.9, U15.2
/rs1[17]: P1.119, U6.7, U8.8, U10.9
/rs1[18]: P1.117, U6.6, U8.7, U10.8
/rs1[19]: P1.116, U6.5, U8.6, U10.7
/rs1[20]: P1.114, U6.4, U8.5, U10.6
/rs1[21]: P1.113, U6.3, U8.4, U10.5
/rs1[22]: P1.111, U6.2, U8.3, U10.4
/rs1[23]: P1.110, U5.9, U8.2, U10.3
/rs1[24]: P1.109, U5.8, U7.9, U10.2
/rs1[25]: P1.108, U5.7, U7.8, U9.9
/rs1[26]: P1.106, U5.6, U7.7, U9.8
/rs1[27]: P1.105, U5.5, U7.6, U9.7
/rs1[28]: P1.103, U5.4, U7.5, U9.6
/rs1[29]: P1.102, U5.3, U7.4, U9.5
/rs1[30]: P1.100, U5.2, U7.3, U9.4
/rs1[31]: P1.99, U3.1, U7.2, U9.3
/rs2[0]': P1.93, U1.7
/rs2[1]': P1.92, U1.6
/rs2[2]': P1.90, U1.5
/rs2[3]': P1.89, U1.4
/rs2[4]': P1.87, U1.3
/s1[0]: U12.11, U14.11, U16.11, U24.7, U26.9
/s1[1]: U12.12, U14.12, U16.12, U24.6, U26.8
/s1[2]: U12.13, U14.13, U16.13, U24.5, U26.7, U28.9
/s1[3]: U12.14, U14.14, U16.14, U24.4, U26.6, U28.8
/s1[4]: U12.15, U14.15, U16.15, U24.3, U26.5, U28.7
/s1[5]: U12.16, U14.16, U16.16, U24.2, U26.4, U28.6
/s1[6]: U12.17, U14.17, U16.17, U23.9, U26.3, U28.5
/s1[7]: U12.18, U14.18, U16.18, U23.8, U26.2, U28.4
/s1[8]: U11.11, U13.11, U15.11, U23.7, U25.9, U28.3
/s1[9]: U11.12, U13.12, U15.12, U23.6, U25.8, U28.2
/s1[10]: U11.13, U13.13, U15.13, U23.5, U25.7, U27.9
/s1[11]: U11.14, U13.14, U15.14, U23.4, U25.6, U27.8
/s1[12]: U11.15, U13.15, U15.15, U23.3, U25.5, U27.7
/s1[13]: U11.16, U13.16, U15.16, U23.2, U25.4, U27.6
/s1[14]: U11.17, U13.17, U15.17, U18.9, U25.3, U27.5
/s1[15]: U11.18, U13.18, U15.18, U18.8, U25.2, U27.4
/s1[16]: U6.11, U8.11, U10.11, U18.7, U20.9, U27.3
/s1[17]: U6.12, U8.12, U10.12, U18.6, U20.8, U27.2
/s1[18]: U6.13, U8.13, U10.13, U18.5, U20.7, U22.9
/s1[19]: U6.14, U8.14, U10.14, U18.4, U20.6, U22.8
/s1[20]: U6.15, U8.15, U10.15, U18.3, U20.5, U22.7
/s1[21]: U6.16, U8.16, U10.16, U18.2, U20.4, U22.6
/s1[22]: U6.17, U8.17, U10.17, U17.9, U20.3, U22.5
/s1[23]: U6.18, U8.18, U10.18, U17.8, U20.2, U22.4
/s1[24]: U5.11, U7.11, U9.11, U17.7, U19.9, U22.3
/s1[25]: U5.12, U7.12, U9.12, U17.6, U19.8, U22.2
/s1[26]: U5.13, U7.13, U9.13, U17.5, U19.7, U21.9
/s1[27]: U5.14, U7.14, U9.14, U17.4, U19.6, U21.8
/s1[28]: U5.15, U7.15, U9.15, U17.3, U19.5, U21.7
/s1[29]: U5.16, U7.16, U9.16, U17.2, U19.4, U21.6
/s1[30]: U5.17, U7.17, U9.17, U19.3, U21.5
/s1[31]: U5.18, U7.18, U9.18, U19.2, U21.4
/s2[0]: U24.11, U26.11, U28.11, U36.5, U38.9
/s2[1]: U24.12, U26.12, U28.12, U36.4, U38.8
/s2[2]: U24.13, U26.13, U28.13, U36.3, U38.7
/s2[3]: U24.14, U26.14, U28.14, U36.2, U38.6
/s2[4]: U24.15, U26.15, U28.15, U35.9, U38.5, U40.9
/s2[5]: U24.16, U26.16, U28.16, U35.8, U38.4, U40.8
/s2[6]: U24.17, U26.17, U28.17, U35.7, U38.3, U40.7
/s2[7]: U24.18, U26.18, U28.18, U35.6, U38.2, U40.6
/s2[8]: U23.11, U25.11, U27.11, U35.5, U37.9, U40.5
/s2[9]: U23.12, U25.12, U27.12, U35.4, U37.8, U40.4
/s2[10]: U23.13, U25.13, U27.13, U35.3, U37.7, U40.3
/s2[11]: U23.14, U25.14, U27.14, U35.2, U37.6, U40.2
/s2[12]: U23.15, U25.15, U27.15, U30.9, U37.5, U39.9
/s2[13]: U23.16, U25.16, U27.16, U30.8, U37.4, U39.8
/s2[14]: U23.17, U25.17, U27.17, U30.7, U37.3, U39.7
/s2[15]: U23.18, U25.18, U27.18, U30.6, U37.2, U39.6
/s2[16]: U18.11, U20.11, U22.11, U30.5, U32.9, U39.5
/s2[17]: U18.12, U20.12, U22.12, U30.4, U32.8, U39.4
/s2[18]: U18.13, U20.13, U22.13, U30.3, U32.7, U39.3
/s2[19]: U18.14, U20.14, U22.14, U30.2, U32.6, U39.2
/s2[20]: U18.15, U20.15, U22.15, U29.9, U32.5, U34.9
/s2[21]: U18.16, U20.16, U22.16, U29.8, U32.4, U34.8
/s2[22]: U18.17, U20.17, U22.17, U29.7, U32.3, U34.7
/s2[23]: U18.18, U20.18, U22.18, U29.6, U32.2, U34.6
/s2[24]: U17.11, U19.11, U21.11, U29.5, U31.9, U34.5
/s2[25]: U17.12, U19.12, U21.12, U29.4, U31.8, U34.4
/s2[26]: U17.13, U19.13, U21.13, U29.3, U31.7, U34.3
/s2[27]: U17.14, U19.14, U21.14, U29.2, U31.6, U34.2
/s2[28]: U17.15, U19.15, U21.15, U31.5, U33.9
/s2[29]: U17.16, U19.16, U21.16, U31.4, U33.8
/s2[30]: U17.17, U19.17, U21.17, U31.3, U33.7
/s2[31]: U17.18, U19.18, U21.18, U31.2, U33.6
/s4[0]: U36.11, U38.11, U40.11, U47.2, U50.2
/s4[1]: U36.12, U38.12, U40.12, U47.3, U50.3
/s4[2]: U36.13, U38.13, U40.13, U47.4, U50.4
/s4[3]: U36.14, U38.14, U40.14, U47.5, U50.5
/s4[4]: U36.15, U38.15, U40.15, U47.6, U50.6
/s4[5]: U36.16, U38.16, U40.16, U47.7, U50.7
/s4[6]: U36.17, U38.17, U40.17, U47.8, U50.8
/s4[7]: U36.18, U38.18, U40.18, U47.9, U50.9
/s4[8]: U35.11, U37.11, U39.11, U42.2, U49.2, U52.2
/s4[9]: U35.12, U37.12, U39.12, U42.3, U49.3, U52.3
/s4[10]: U35.13, U37.13, U39.13, U42.4, U49.4, U52.4
/s4[11]: U35.14, U37.14, U39.14, U42.5, U49.5, U52.5
/s4[12]: U35.15, U37.15, U39.15, U42.6, U49.6, U52.6
/s4[13]: U35.16, U37.16, U39.16, U42.7, U49.7, U52.7
/s4[14]: U35.17, U37.17, U39.17, U42.8, U49.8, U52.8
/s4[15]: U35.18, U37.18, U39.18, U42.9, U49.9, U52.9
/s4[16]: U30.11, U32.11, U34.11, U41.2, U44.2, U51.2
/s4[17]: U30.12, U32.12, U34.12, U41.3, U44.3, U51.3
/s4[18]: U30.13, U32.13, U34.13, U41.4, U44.4, U51.4
/s4[19]: U30.14, U32.14, U34.14, U41.5, U44.5, U51.5
/s4[20]: U30.15, U32.15, U34.15, U41.6, U44.6, U51.6
/s4[21]: U30.16, U32.16, U34.16, U41.7, U44.7, U51.7
/s4[22]: U30.17, U32.17, U34.17, U41.8, U44.8, U51.8
/s4[23]: U30.18, U32.18, U34.18, U41.9, U44.9, U51.9
/s4[24]: U29.11, U31.11, U33.11, U43.2, U46.2
/s4[25]: U29.12, U31.12, U33.12, U43.3, U46.3
/s4[26]: U29.13, U31.13, U33.13, U43.4, U46.4
/s4[27]: U29.14, U31.14, U33.14, U43.5, U46.5
/s4[28]: U29.15, U31.15, U33.15, U43.6, U46.6
/s4[29]: U29.16, U31.16, U33.16, U43.7, U46.7
/s4[30]: U29.17, U31.17, U33.17, U43.8, U46.8
/s4[31]: U29.18, U31.18, U33.18, U43.9, U46.9
/s8[0]: U48.18, U50.18, U52.18, U54.2, U62.2
/s8[1]: U48.17, U50.17, U52.17, U54.3, U62.3
/s8[2]: U48.16, U50.16, U52.16, U54.4, U62.4
/s8[3]: U48.15, U50.15, U52.15, U54.5, U62.5
/s8[4]: U48.14, U50.14, U52.14, U54.6, U62.6
/s8[5]: U48.13, U50.13, U52.13, U54.7, U62.7
/s8[6]: U48.12, U50.12, U52.12, U54.8, U62.8
/s8[7]: U48.11, U50.11, U52.11, U54.9, U62.9
/s8[8]: U47.18, U49.18, U51.18, U53.2, U61.2
/s8[9]: U47.17, U49.17, U51.17, U53.3, U61.3
/s8[10]: U47.16, U49.16, U51.16, U53.4, U61.4
/s8[11]: U47.15, U49.15, U51.15, U53.5, U61.5
/s8[12]: U47.14, U49.14, U51.14, U53.6, U61.6
/s8[13]: U47.13, U49.13, U51.13, U53.7, U61.7
/s8[14]: U47.12, U49.12, U51.12, U53.8, U61.8
/s8[15]: U47.11, U49.11, U51.11, U53.9, U61.9
/s8[16]: U42.18, U44.18, U46.18, U56.2, U64.2
/s8[17]: U42.17, U44.17, U46.17, U56.3, U64.3
/s8[18]: U42.16, U44.16, U46.16, U56.4, U64.4
/s8[19]: U42.15, U44.15, U46.15, U56.5, U64.5
/s8[20]: U42.14, U44.14, U46.14, U56.6, U64.6
/s8[21]: U42.13, U44.13, U46.13, U56.7, U64.7
/s8[22]: U42.12, U44.12, U46.12, U56.8, U64.8
/s8[23]: U42.11, U44.11, U46.11, U56.9, U64.9
/s8[24]: U41.18, U43.18, U45.18, U55.2, U63.2
/s8[25]: U41.17, U43.17, U45.17, U55.3, U63.3
/s8[26]: U41.16, U43.16, U45.16, U55.4, U63.4
/s8[27]: U41.15, U43.15, U45.15, U55.5, U63.5
/s8[28]: U41.14, U43.14, U45.14, U55.6, U63.6
/s8[29]: U41.13, U43.13, U45.13, U55.7, U63.7
/s8[30]: U41.12, U43.12, U45.12, U55.8, U63.8
/s8[31]: U41.11, U43.11, U45.11, U55.9, U63.9
/shift1: J1.1, RN1.1, U1.13, U2.1, U7.1, U8.1, U13.1, U14.1
/shift2: J1.3, RN1.2, U1.14, U2.3, U19.1, U20.1, U25.1, U26.1
/shift4: J1.5, RN1.3, U1.15, U2.5, U31.1, U32.1, U37.1, U38.1
/shift8: J1.7, RN1.4, U1.16, U2.9, U43.19, U44.19, U49.19, U50.19
/shift16: J1.9, RN1.6, U1.17, U2.11, U4.5
/shift_arith: J1.15, RN1.8, U1.12, U3.2
/shift_arith': P1.192, U1.8
/~noshift_16_oe: J1.16, RN2.1, U4.6, U55.19, U56.19, U61.19, U62.19
/~shift1: J1.2, RN2.9, U2.2, U5.1, U6.1, U9.1, U10.1, U11.1, U12.1, U15.1, U16.1
/~shift2: J1.4, RN2.8, U2.4, U17.1, U18.1, U21.1, U22.1, U23.1, U24.1, U27.1, U28.1
/~shift4: J1.6, RN2.7, U2.6, U29.1, U30.1, U33.1, U34.1, U35.1, U36.1, U39.1, U40.1
/~shift8: J1.8, RN2.6, U2.8, U41.19, U42.19, U45.19, U46.19, U47.19, U48.19, U51.19, U52.19
/~shift16: J1.10, RN2.4, U2.10, U4.2
/~shift_16_oe: J1.14, RN2.2, U4.3, U53.19, U54.19, U57.19, U58.19, U59.19, U60.19, U63.19, U64.19
/~shift_left: J1.11, RN1.9, U1.18, U2.13, U5.19, U6.19, U11.19, U12.19, U17.19, U18.19, U23.19, U24.19, U29.19, U30.19, U35.19, U36.19, U41.1, U42.1, U47.1, U48.1, U53.1, U54.1, U59.1, U60.1
/~shift_left': P1.191, U1.2
/~shift_oe: J1.13, RN1.7, U1.11, U4.1, U4.4, U55.1, U56.1, U61.1, U62.1
/~shift_oe': P1.185, U1.9
/~shift_right: J1.12, RN2.3, U2.12, U9.19, U10.19, U15.19, U16.19, U21.19, U22.19, U27.19, U28.19, U33.19, U34.19, U39.19, U40.19, U45.1, U46.1, U51.1, U52.1, U57.1, U58.1, U63.1, U64.1
GND: C1.2, C2.2, C3.2, C4.2, C5.2, C6.2, C7.2, C8.2, C9.2, C10.2, C11.2, C12.2, C13.2, C14.2, C15.2, C16.2, C17.2, C18.2, C19.2, C20.2, C21.2, C22.2, C23.2, C24.2, C25.2, C26.2, C27.2, C28.2, C29.2, C30.2, C31.2, C32.2, C33.2, C34.2, C35.2, C36.2, C37.2, C38.2, C39.2, C40.2, C41.2, C42.2, C43.2, C44.2, C45.2, C46.2, C47.2, C48.2, C49.2, C50.2, C51.2, C52.2, C53.2, C54.2, C55.2, C56.2, C57.2, C58.2, C59.2, C60.2, C61.2, C62.2, C63.2, C64.2, C100.2, C101.2, C102.2, C103.2, C104.2, C105.2, J1.17, P1.3, P1.9, P1.14, P1.20, P1.25, P1.31, P1.36, P1.42, P1.52, P1.58, P1.63, P1.69, P1.74, P1.80, P1.85, P1.91, P1.101, P1.107, P1.112, P1.118, P1.123, P1.129, P1.134, P1.140, P1.150, P1.156, P1.161, P1.167, P1.172, P1.178, P1.183, P1.189, U1.1, U1.10, U1.19, U2.7, U3.7, U4.7, U4.9, U4.10, U4.12, U4.13, U5.10, U6.10, U7.10, U7.19, U8.10, U8.19, U9.10, U10.10, U11.10, U12.9, U12.10, U13.10, U13.19, U14.10, U14.19, U15.10, U16.10, U17.10, U18.10, U19.10, U19.19, U20.10, U20.19, U21.10, U22.10, U23.10, U24.8, U24.9, U24.10, U25.10, U25.19, U26.10, U26.19, U27.10, U28.10, U29.10, U30.10, U31.10, U31.19, U32.10, U32.19, U33.10, U34.10, U35.10, U36.6, U36.7, U36.8, U36.9, U36.10, U37.10, U37.19, U38.10, U38.19, U39.10, U40.10, U41.10, U42.10, U43.1, U43.10, U44.1, U44.10, U45.10, U46.10, U47.10, U48.2, U48.3, U48.4, U48.5, U48.6, U48.7, U48.8, U48.9, U48.10, U49.1, U49.10, U50.1, U50.10, U51.10, U52.10, U53.10, U54.10, U55.10, U56.10, U57.10, U58.10, U59.2, U59.3, U59.4, U59.5, U59.6, U59.7, U59.8, U59.9, U59.10, U60.2, U60.3, U60.4, U60.5, U60.6, U60.7, U60.8, U60.9, U60.10, U61.10, U62.10, U63.10, U64.10
VCC: C1.1, C2.1, C3.1, C4.1, C5.1, C6.1, C7.1, C8.1, C9.1, C10.1, C11.1, C12.1, C13.1, C14.1, C15.1, C16.1, C17.1, C18.1, C19.1, C20.1, C21.1, C22.1, C23.1, C24.1, C25.1, C26.1, C27.1, C28.1, C29.1, C30.1, C31.1, C32.1, C33.1, C34.1, C35.1, C36.1, C37.1, C38.1, C39.1, C40.1, C41.1, C42.1, C43.1, C44.1, C45.1, C46.1, C47.1, C48.1, C49.1, C50.1, C51.1, C52.1, C53.1, C54.1, C55.1, C56.1, C57.1, C58.1, C59.1, C60.1, C61.1, C62.1, C63.1, C64.1, C100.1, C101.1, C102.1, C103.1, C104.1, C105.1, J1.18, P1.6, P1.17, P1.28, P1.39, P1.55, P1.66, P1.77, P1.88, P1.104, P1.115, P1.126, P1.137, P1.153, P1.164, P1.175, P1.186, RN1.5, RN1.10, RN2.5, RN2.10, U1.20, U2.14, U3.14, U4.14, U5.20, U6.20, U7.20, U8.20, U9.20, U10.20, U11.20, U12.20, U13.20, U14.20, U15.20, U16.20, U17.20, U18.20, U19.20, U20.20, U21.20, U22.20, U23.20, U24.20, U25.20, U26.20, U27.20, U28.20, U29.20, U30.20, U31.20, U32.20, U33.20, U34.20, U35.20, U36.20, U37.20, U38.20, U39.20, U40.20, U41.20, U42.20, U43.20, U44.20, U45.20, U46.20, U47.20, U48.20, U49.20, U50.20, U51.20, U52.20, U53.20, U54.20, U55.20, U56.20, U57.20, U58.20, U59.20, U60.20, U61.20, U62.20, U63.20, U64.20
