RobertBaruch/lmarv/lmarv-1/ram-based-register-card/ram-based-register-card-try1.kicad_pcb

## KiCad design lmarv-1/ram-based-register-card/ram-based-register-card-try1.kicad_pcb (2018-05-30)

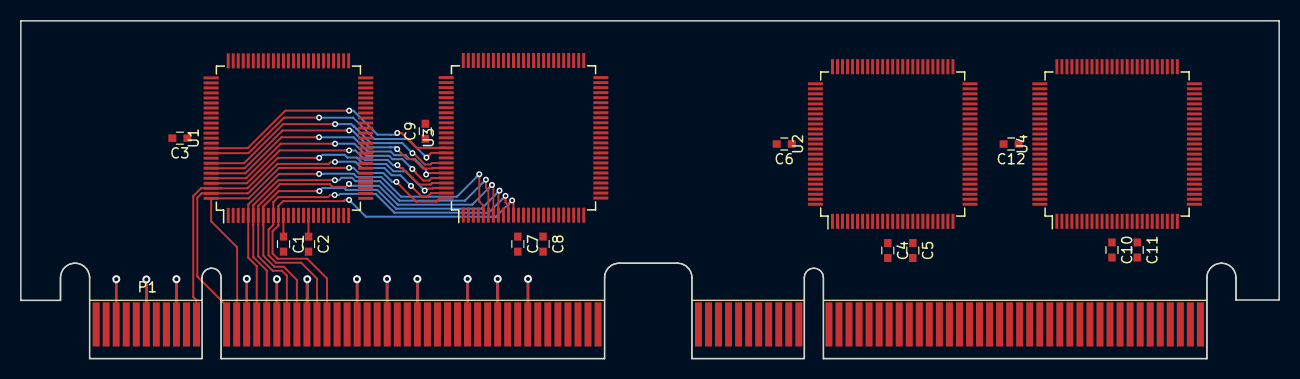
[picture p63: board ram-based-register-card-try1.kicad_pcb from above]

Board: 4 copper layers, 125.4 x 33.6 mm, 17 parts (0 on the bottom side), 124 nets.

Parts:
C1, C2, C3, C4, C5, C6, C7, C8, C9, C10, C11, C12: 0u1; C_0603
P1: dual-pcie-cardedge; PCI-EXPRESS
U1, U2, U3, U4: IDT70V24_TQ100; TQFP-100_14x14mm_Pitch0.5mm

Connections:
/rd[0]: P1.71, U2.11, U4.11
/rd[1]: P1.70, U2.10, U4.10
/rd[2]: P1.68, U2.8, U4.8
/rd[3]: P1.67, U2.7, U4.7
/rd[4]: P1.65, U2.6, U4.6
/rd[5]: P1.64, U2.5, U4.5
/rd[6]: P1.62, U2.100, U4.100
/rd[7]: P1.61, U2.99, U4.99
/rd[8]: P1.60, U2.98, U4.98
/rd[9]: P1.59, U2.97, U4.97
/rd[10]: P1.57, U2.96, U4.96
/rd[11]: P1.56, U2.95, U4.95
/rd[12]: P1.54, U2.94, U4.94
/rd[13]: P1.53, U2.93, U4.93
/rd[14]: P1.51, U2.91, U4.91
/rd[15]: P1.50, U2.90, U4.90
/rd[16]: P1.22, U1.11, U3.11
/rd[17]: P1.21, U1.10, U3.10
/rd[18]: P1.19, U1.8, U3.8
/rd[19]: P1.18, U1.7, U3.7
/rd[20]: P1.16, U1.6, U3.6
/rd[21]: P1.15, U1.5, U3.5
/rd[22]: P1.13, U1.100, U3.100
/rd[23]: P1.12, U1.99, U3.99
/rd[24]: P1.11, U1.98, U3.98
/rd[25]: P1.10, U1.97, U3.97
/rd[26]: P1.8, U1.96, U3.96
/rd[27]: P1.7, U1.95, U3.95
/rd[28]: P1.5, U1.94, U3.94
/rd[29]: P1.4, U1.93, U3.93
/rd[30]: P1.2, U1.91, U3.91
/rd[31]: P1.1, U1.90, U3.90
/rda[0]: P1.49, U1.70, U2.70, U3.70, U4.70
/rda[1]: P1.48, U1.69, U2.69, U3.69, U4.69
/rda[2]: P1.47, U1.68, U2.68, U3.68, U4.68
/rda[3]: P1.46, U1.67, U2.67, U3.67, U4.67
/rda[4]: P1.45, U1.66, U2.66, U3.66, U4.66
/rs1[0]: P1.169, U4.35
/rs1[1]: P1.168, U4.33
/rs1[2]: P1.166, U4.32
/rs1[3]: P1.165, U4.31
/rs1[4]: P1.163, U4.30
/rs1[5]: P1.162, U4.29
/rs1[6]: P1.160, U4.28
/rs1[7]: P1.159, U4.27
/rs1[8]: P1.158, U4.26
/rs1[9]: P1.157, U4.21
/rs1[10]: P1.155, U4.20
/rs1[11]: P1.154, U4.19
/rs1[12]: P1.152, U4.18
/rs1[13]: P1.151, U4.16
/rs1[14]: P1.149, U4.15
/rs1[15]: P1.148, U4.14
/rs1[16]: P1.120, U3.35
/rs1[17]: P1.119, U3.33
/rs1[18]: P1.117, U3.32
/rs1[19]: P1.116, U3.31
/rs1[20]: P1.114, U3.30
/rs1[21]: P1.113, U3.29
/rs1[22]: P1.111, U3.28
/rs1[23]: P1.110, U3.27
/rs1[24]: P1.109, U3.26
/rs1[25]: P1.108, U3.21
/rs1[26]: P1.106, U3.20
/rs1[27]: P1.105, U3.19
/rs1[28]: P1.103, U3.18
/rs1[29]: P1.102, U3.16
/rs1[30]: P1.100, U3.15
/rs1[31]: P1.99, U3.14
/rs1a[0]: P1.196, U3.55, U4.55
/rs1a[1]: P1.195, U3.56, U4.56
/rs1a[2]: P1.194, U3.57, U4.57
/rs1a[3]: P1.193, U3.58, U4.58
/rs1a[4]: P1.192, U3.59, U4.59
/rs2[0]: P1.93, U2.35
/rs2[1]: P1.92, U2.33
/rs2[2]: P1.90, U2.32
/rs2[3]: P1.89, U2.31
/rs2[4]: P1.87, U2.30
/rs2[5]: P1.86, U2.29
/rs2[6]: P1.84, U2.28
/rs2[7]: P1.83, U2.27
/rs2[8]: P1.82, U2.26
/rs2[9]: P1.81, U2.21
/rs2[10]: P1.79, U2.20
/rs2[11]: P1.78, U2.19
/rs2[12]: P1.76, U2.18
/rs2[13]: P1.75, U2.16
/rs2[14]: P1.73, U2.15
/rs2[15]: P1.72, U2.14
/rs2[16]: P1.44, U1.35
/rs2[17]: P1.43, U1.33
/rs2[18]: P1.41, U1.32
/rs2[19]: P1.40, U1.31
/rs2[20]: P1.38, U1.30
/rs2[21]: P1.37, U1.29
/rs2[22]: P1.35, U1.28
/rs2[23]: P1.34, U1.27
/rs2[24]: P1.33, U1.26
/rs2[25]: P1.32, U1.21
/rs2[26]: P1.30, U1.20
/rs2[27]: P1.29, U1.19
/rs2[28]: P1.27, U1.18
/rs2[29]: P1.26, U1.16
/rs2[30]: P1.24, U1.15
/rs2[31]: P1.23, U1.14
/rs2a[0]: P1.147, U1.55, U2.55
/rs2a[1]: P1.146, U1.56, U2.56
/rs2a[2]: P1.145, U1.57, U2.57
/rs2a[3]: P1.144, U1.58, U2.58
/rs2a[4]: P1.143, U1.59, U2.59
/~rd_bhh: P1.121, U1.83, U3.83
/~rd_bhl: P1.122, U1.84, U3.84
/~rd_blh: U2.83, U4.83
/~rd_bll: U2.84, U4.84
/~rd_wr: P1.124, U1.87, U2.87, U3.87, U4.87
/~rs1_bhh: P1.130, U3.42
/~rs1_bhl: P1.131, U3.41
/~rs1_rd: P1.132, U3.36, U4.36
/~rs2_bhh: P1.125, U1.42
/~rs2_bhl: P1.127, U1.41
/~rs2_rd: P1.128, U1.36, U2.36
GND: C1.2, C2.2, C3.2, C4.2, C5.2, C6.2, C7.2, C8.2, C9.2, C10.2, C11.2, C12.2, P1.3, P1.9, P1.14, P1.20, P1.25, P1.31, P1.36, P1.42, P1.52, P1.58, P1.63, P1.69, P1.74, P1.80, P1.85, P1.91, P1.101, P1.107, P1.112, P1.118, P1.123, P1.129, P1.134, P1.140, P1.150, P1.156, P1.161, P1.167, P1.172, P1.178, P1.183, P1.189, U1.9, U1.13, U1.34, U1.38, U1.40, U1.44, U1.45, U1.46, U1.47, U1.48, U1.49, U1.50, U1.61, U1.62, U1.63, U1.64, U1.71, U1.76, U1.77, U1.78, U1.79, U1.80, U1.81, U1.85, U1.92, U2.9, U2.13, U2.34, U2.38, U2.40, U2.44, U2.45, U2.46, U2.47, U2.48, U2.49, U2.50, U2.61, U2.62, U2.63, U2.64, U2.71, U2.76, U2.77, U2.78, U2.79, U2.80, U2.81, U2.85, U2.92, U3.9, U3.13, U3.34, U3.38, U3.40, U3.44, U3.45, U3.46, U3.47, U3.48, U3.49, U3.50, U3.61, U3.62, U3.63, U3.64, U3.71, U3.76, U3.77, U3.78, U3.79, U3.80, U3.81, U3.85, U3.92, U4.9, U4.13, U4.34, U4.38, U4.40, U4.44, U4.45, U4.46, U4.47, U4.48, U4.49, U4.50, U4.61, U4.62, U4.63, U4.64, U4.71, U4.76, U4.77, U4.78, U4.79, U4.80, U4.81, U4.85, U4.92
VCC: C1.1, C2.1, C3.1, C4.1, C5.1, C6.1, C7.1, C8.1, C9.1, C10.1, C11.1, C12.1, P1.6, P1.17, P1.28, P1.39, P1.55, P1.66, P1.77, P1.88, P1.104, P1.115, P1.126, P1.137, P1.153, P1.164, P1.175, P1.186, U1.12, U1.17, U1.37, U1.39, U1.86, U1.88, U1.89, U2.12, U2.17, U2.37, U2.39, U2.86, U2.88, U2.89, U3.12, U3.17, U3.37, U3.39, U3.86, U3.88, U3.89, U4.12, U4.17, U4.37, U4.39, U4.86, U4.88, U4.89
