RobertBaruch/lmarv/lmarv-1/ht1632c-evaluation/ht1632c-evaluation.kicad_pcb

## KiCad design lmarv-1/ht1632c-evaluation/ht1632c-evaluation.kicad_pcb (2018-07-08)

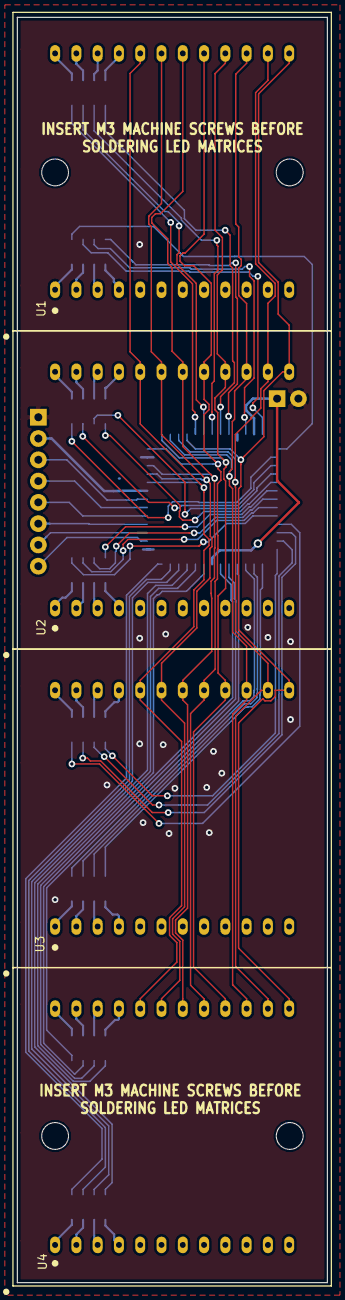
[picture p64: board ht1632c-evaluation.kicad_pcb from above]

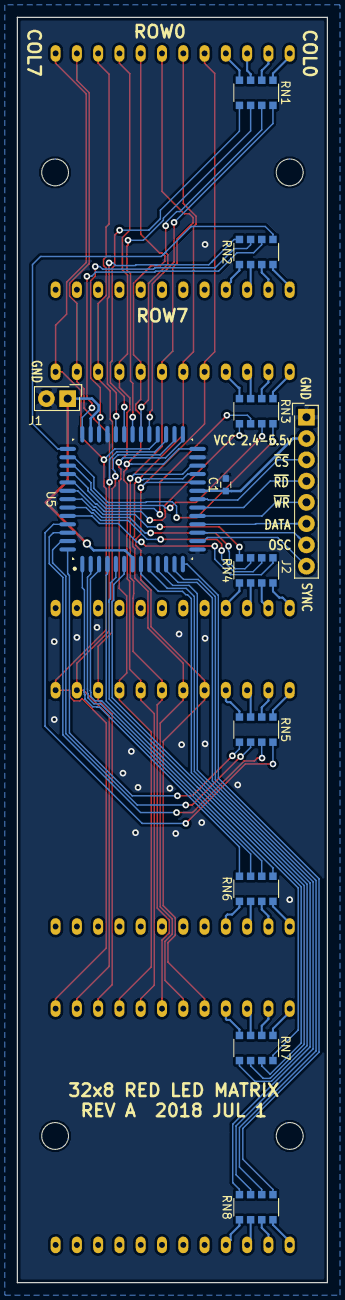
[picture p65: board ht1632c-evaluation.kicad_pcb from below]

Board: 2 copper layers, 37.0 x 151.0 mm, 16 parts (12 on the bottom side), 81 nets.

Parts:
C1: 100n; C_0603
J1: Conn_01x02; SL-102-X-XX_1x02
J2: Conn_01x08; SL-108-X-XX_1x08
RN1, RN2, RN3, RN4, RN5, RN6, RN7, RN8: CAY16-561J4LF; R_Array_Convex_4x1206
U1, U2, U3, U4: 1588ABEG
U5: HT1632C; QFP-52_14x14_Pitch1mm

Connections:
+5V: J1.1, U5.7, U5.38
/COL0: U1.20, U2.20, U3.20, U4.20, U5.22
/COL1: U1.19, U2.19, U3.19, U4.19, U5.23
/COL2: U1.18, U2.18, U3.18, U4.18, U5.24
/COL3: U1.17, U2.17, U3.17, U4.17, U5.26
/COL4: U1.16, U2.16, U3.16, U4.16, U5.27
/COL5: U1.15, U2.15, U3.15, U4.15, U5.28
/COL6: U1.14, U2.14, U3.14, U4.14, U5.29
/COL7: U1.13, U2.13, U3.13, U4.13, U5.30
/DATA: J2.7, U5.16
/OSC: J2.8, U5.15
/ROW0: RN8.5, U5.13
/ROW0': RN8.4, U4.1
/ROW1: RN8.6, U5.12
/ROW1': RN8.3, U4.2
/ROW2: RN8.7, U5.11
/ROW2': RN8.2, U4.3
/ROW3: RN8.8, U5.10
/ROW3': RN8.1, U4.4
/ROW4: RN7.5, U5.9
/ROW4': RN7.4, U4.21
/ROW5: RN7.6, U5.8
/ROW5': RN7.3, U4.22
/ROW6: RN7.7, U5.6
/ROW6': RN7.2, U4.23
/ROW7: RN7.8, U5.5
/ROW7': RN7.1, U4.24
/ROW8: RN6.5, U5.4
/ROW8': RN6.4, U3.1
/ROW9: RN6.6, U5.3
/ROW9': RN6.3, U3.2
/ROW10: RN6.7, U5.2
/ROW10': RN6.2, U3.3
/ROW11: RN6.8, U5.1
/ROW11': RN6.1, U3.4
/ROW12: RN5.5, U5.52
/ROW12': RN5.4, U3.21
/ROW13: RN5.6, U5.51
/ROW13': RN5.3, U3.22
/ROW14: RN5.7, U5.50
/ROW14': RN5.2, U3.23
/ROW15: RN5.8, U5.49
/ROW15': RN5.1, U3.24
/ROW16: RN4.5, U5.48
/ROW16': RN4.4, U2.1
/ROW17: RN4.6, U5.47
/ROW17': RN4.3, U2.2
/ROW18: RN4.7, U5.46
/ROW18': RN4.2, U2.3
/ROW19: RN4.8, U5.45
/ROW19': RN4.1, U2.4
/ROW20: RN3.5, U5.44
/ROW20': RN3.4, U2.21
/ROW21: RN3.6, U5.43
/ROW21': RN3.3, U2.22
/ROW22: RN3.7, U5.42
/ROW22': RN3.2, U2.23
/ROW23: RN3.8, U5.41
/ROW23': RN3.1, U2.24
/ROW24: RN2.5, U5.40
/ROW24': RN2.4, U1.1
/ROW25: RN2.6, U5.39
/ROW25': RN2.3, U1.2
/ROW26: RN2.7, U5.37
/ROW26': RN2.2, U1.3
/ROW27: RN2.8, U5.35
/ROW27': RN2.1, U1.4
/ROW28: RN1.5, U5.34
/ROW28': RN1.4, U1.21
/ROW29: RN1.6, U5.33
/ROW29': RN1.3, U1.22
/ROW30: RN1.7, U5.32
/ROW30': RN1.2, U1.23
/ROW31: RN1.8, U5.31
/ROW31': RN1.1, U1.24
/SYNC: J2.3, U5.20
/~CS: J2.4, U5.19
/~RD: J2.5, U5.18
/~WR: J2.6, U5.17
GNDREF: C1.2, J1.2, J2.1, U5.14, U5.25, U5.36
VCC: C1.1, J2.2, U5.21
