RobertBaruch/lmarv/lmarv-1/reflections2/reflections.kicad_pcb

## KiCad design lmarv-1/reflections2/reflections.kicad_pcb (2018-05-30)

Schematic: reflections.sch

Parts:
C1, C2, C3, C4: C; C_0805_HandSoldering
J1, J2, J4: Conn_01x02; Pin_Header_Straight_1x02_Pitch2.54mm
J3, J5, J6: Conn_01x04; Pin_Header_Straight_1x04_Pitch2.54mm
R1, R2, R3, R4, R5: R; R_0805_HandSoldering
TP1, TP2, TP3, TP4, TP5, TP6, TP7, TP8: Test_Point; Measurement_Point_Round-SMD-Pad_Small
U1, U3, U4: 74LS161; SOIC-16_3.9x9.9mm_Pitch1.27mm
U2: 74LS244; SOIC-20W_7.5x12.8mm_Pitch1.27mm

Connections:
/CP: R1.1, R2.2, R3.1, R4.2, R5.1, TP2.1, TP4.1, TP6.1, TP8.1, U1.2, U3.2, U4.2
/IN0: J4.2, U2.2 (I0a)
/OUT0: R1.2, U2.18 (O0a)
/~MR: J1.2, U1.1, U3.1, U4.1
GND: C1.2, C2.2, C3.2, C4.2, J1.1, J2.2, J4.1, R3.2, R5.2, TP1.1, TP3.1, TP5.1, TP7.1, U1.8, U2.1 (OEa), U2.10 (GND), U2.19 (OEb), U3.8, U4.8
unnamed: J3.1, U1.14
unnamed: J3.2, U1.13
unnamed: J3.3, U1.12
unnamed: J3.4, U1.11
unnamed: J5.1, U3.14
unnamed: J5.2, U3.13
unnamed: J5.3, U3.12
unnamed: J5.4, U3.11
unnamed: J6.1, U4.14
unnamed: J6.2, U4.13
unnamed: J6.3, U4.12
unnamed: J6.4, U4.11
VCC: C1.1, C2.1, C3.1, C4.1, J2.1, R2.1, R4.1, U1.3, U1.4, U1.5, U1.6, U1.7, U1.9, U1.10, U1.16, U2.4 (I1a), U2.6 (I2a), U2.8 (I3a), U2.11 (I0b), U2.13 (I1b), U2.15 (I2b), U2.17 (I3b), U2.20 (VCC), U3.3, U3.4, U3.5, U3.6, U3.7, U3.9, U3.10, U3.16, U4.3, U4.4, U4.5, U4.6, U4.7, U4.9, U4.10, U4.16

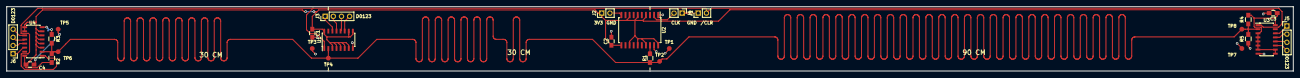
[picture p66: board reflections.kicad_pcb from above]

Board: 2 copper layers, 400.0 x 20.0 mm, 27 parts (0 on the bottom side), 18 nets.
