RobertBaruch/lmarv/lmarv-1/register-card/register-card.kicad_pcb

## KiCad design lmarv-1/register-card/register-card.kicad_pcb (2018-05-30)

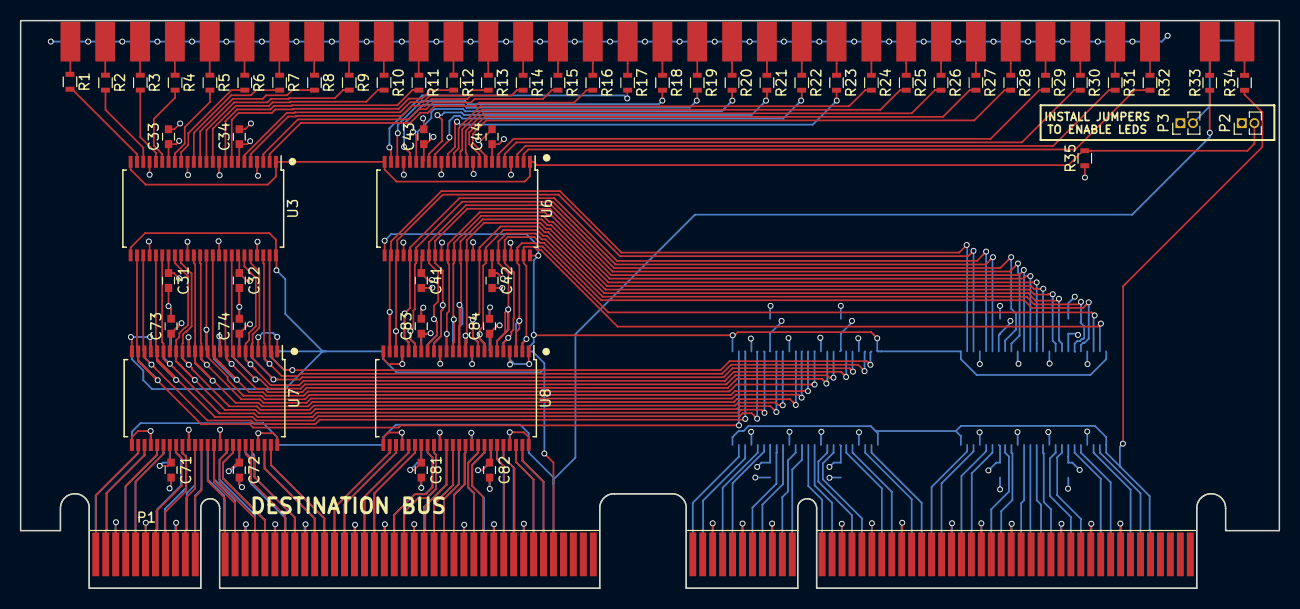
[picture p67: board register-card.kicad_pcb from above]

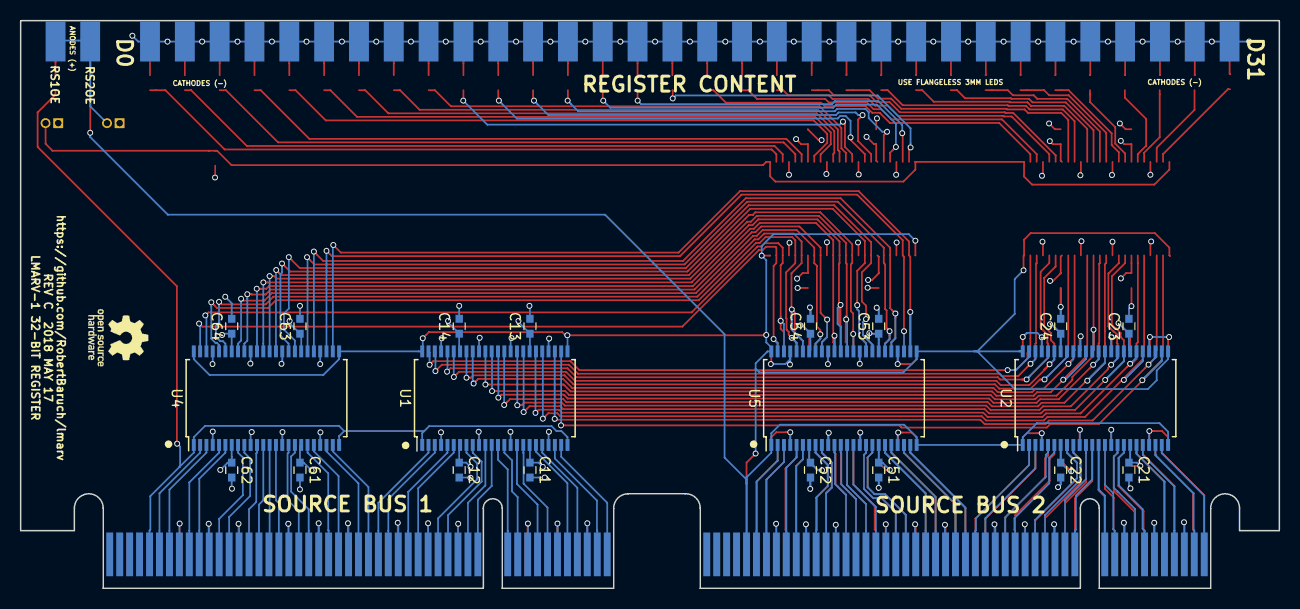
[picture p68: board register-card.kicad_pcb from below]

Board: 4 copper layers, 126.5 x 57.1 mm, 112 parts (52 on the bottom side), 201 nets.

Parts:
C11, C12, C13, C14, C21, C22, C23, C24, C31, C32, C33, C34, C41, C42, C43, C44, C51, C52, C53, C54, C61, C62, C63, C64, C71, C72, C73, C74, C81, C82, C83, C84: 100n; C_0603
D1, D2, D3, D4, D5, D6, D7, D8, D9, D10, D11, D12, D13, D14, D15, D16, D17, D18, D19, D20, D21, D22, D23, D24, D25, D26, D27, D28, D29, D30, D31, D32, D33, D34: HLMP-K150; LED_edge
P1: dual-pcie-cardedge; PCI-EXPRESS
P2, P3: CONN_01X02; Pin_Header_Straight_1x02_Pitch1.27mm
R1, R2, R3, R4, R5, R6, R7, R8, R9, R10, R11, R12, R13, R14, R15, R16, R17, R18, R19, R20, R21, R22, R23, R24, R25, R26, R27, R28, R29, R30, R31, R32, R33, R34, R35: 1k5; R_0603
U1, U2, U3, U4, U5, U6: 74LVT16374; SSOP-48_7.5x15.9mm_Pitch0.635mm
U7, U8: 74LVT162244; SSOP-48_7.5x15.9mm_Pitch0.635mm

Connections:
//LEDOE: P2.2, R35.2, U3.1, U3.24, U6.1, U6.24
/dd[0]: U4.47, U5.47, U6.47, U8.2
/dd[1]: U4.46, U5.46, U6.46, U8.3
/dd[2]: U4.44, U5.44, U6.44, U8.5
/dd[3]: U4.43, U5.43, U6.43, U8.6
/dd[4]: U4.41, U5.41, U6.41, U8.8
/dd[5]: U4.40, U5.40, U6.40, U8.9
/dd[6]: U4.38, U5.38, U6.38, U8.11
/dd[7]: U4.37, U5.37, U6.37, U8.12
/dd[8]: U4.36, U5.36, U6.36, U8.13
/dd[9]: U4.35, U5.35, U6.35, U8.14
/dd[10]: U4.33, U5.33, U6.33, U8.16
/dd[11]: U4.32, U5.32, U6.32, U8.17
/dd[12]: U4.30, U5.30, U6.30, U8.19
/dd[13]: U4.29, U5.29, U6.29, U8.20
/dd[14]: U4.27, U5.27, U6.27, U8.22
/dd[15]: U4.26, U5.26, U6.26, U8.23
/dd[16]: U1.47, U2.47, U3.47, U7.2
/dd[17]: U1.46, U2.46, U3.46, U7.3
/dd[18]: U1.44, U2.44, U3.44, U7.5
/dd[19]: U1.43, U2.43, U3.43, U7.6
/dd[20]: U1.41, U2.41, U3.41, U7.8
/dd[21]: U1.40, U2.40, U3.40, U7.9
/dd[22]: U1.38, U2.38, U3.38, U7.11
/dd[23]: U1.37, U2.37, U3.37, U7.12
/dd[24]: U1.36, U2.36, U3.36, U7.13
/dd[25]: U1.35, U2.35, U3.35, U7.14
/dd[26]: U1.33, U2.33, U3.33, U7.16
/dd[27]: U1.32, U2.32, U3.32, U7.17
/dd[28]: U1.30, U2.30, U3.30, U7.19
/dd[29]: U1.29, U2.29, U3.29, U7.20
/dd[30]: U1.27, U2.27, U3.27, U7.22
/dd[31]: U1.26, U2.26, U3.26, U7.23
/rd[0]: P1.44, U8.47
/rd[1]: P1.43, U8.46
/rd[2]: P1.41, U8.44
/rd[3]: P1.40, U8.43
/rd[4]: P1.38, U8.41
/rd[5]: P1.37, U8.40
/rd[6]: P1.35, U8.38
/rd[7]: P1.34, U8.37
/rd[8]: P1.33, U8.36
/rd[9]: P1.32, U8.35
/rd[10]: P1.30, U8.33
/rd[11]: P1.29, U8.32
/rd[12]: P1.27, U8.30
/rd[13]: P1.26, U8.29
/rd[14]: P1.24, U8.27
/rd[15]: P1.23, U8.26
/rd[16]: P1.22, U7.47
/rd[17]: P1.21, U7.46
/rd[18]: P1.19, U7.44
/rd[19]: P1.18, U7.43
/rd[20]: P1.16, U7.41
/rd[21]: P1.15, U7.40
/rd[22]: P1.13, U7.38
/rd[23]: P1.12, U7.37
/rd[24]: P1.11, U7.36
/rd[25]: P1.10, U7.35
/rd[26]: P1.8, U7.33
/rd[27]: P1.7, U7.32
/rd[28]: P1.5, U7.30
/rd[29]: P1.4, U7.29
/rd[30]: P1.2, U7.27
/rd[31]: P1.1, U7.26
/rdclk: P1.45, U1.25, U1.48, U2.25, U2.48, U3.25, U3.48, U4.25, U4.48, U5.25, U5.48, U6.25, U6.48
/rdq[0]: R32.2, U6.2
/rdq[1]: R31.2, U6.3
/rdq[2]: R30.2, U6.5
/rdq[3]: R29.2, U6.6
/rdq[4]: R28.2, U6.8
/rdq[5]: R27.2, U6.9
/rdq[6]: R26.2, U6.11
/rdq[7]: R25.2, U6.12
/rdq[8]: R24.2, U6.13
/rdq[9]: R23.2, U6.14
/rdq[10]: R22.2, U6.16
/rdq[11]: R21.2, U6.17
/rdq[12]: R20.2, U6.19
/rdq[13]: R19.2, U6.20
/rdq[14]: R18.2, U6.22
/rdq[15]: R17.2, U6.23
/rdq[16]: R16.2, U3.2
/rdq[17]: R15.2, U3.3
/rdq[18]: R14.2, U3.5
/rdq[19]: R13.2, U3.6
/rdq[20]: R12.2, U3.8
/rdq[21]: R11.2, U3.9
/rdq[22]: R10.2, U3.11
/rdq[23]: R9.2, U3.12
/rdq[24]: R8.2, U3.13
/rdq[25]: R7.2, U3.14
/rdq[26]: R6.2, U3.16
/rdq[27]: R5.2, U3.17
/rdq[28]: R4.2, U3.19
/rdq[29]: R3.2, U3.20
/rdq[30]: R2.2, U3.22
/rdq[31]: R1.2, U3.23
/rs1[0]: P1.191, U4.2
/rs1[1]: P1.190, U4.3
/rs1[2]: P1.188, U4.5
/rs1[3]: P1.187, U4.6
/rs1[4]: P1.185, U4.8
/rs1[5]: P1.184, U4.9
/rs1[6]: P1.182, U4.11
/rs1[7]: P1.181, U4.12
/rs1[8]: P1.180, U4.13
/rs1[9]: P1.179, U4.14
/rs1[10]: P1.177, U4.16
/rs1[11]: P1.176, U4.17
/rs1[12]: P1.174, U4.19
/rs1[13]: P1.173, U4.20
/rs1[14]: P1.171, U4.22
/rs1[15]: P1.170, U4.23
/rs1[16]: P1.169, U1.2
/rs1[17]: P1.168, U1.3
/rs1[18]: P1.166, U1.5
/rs1[19]: P1.165, U1.6
/rs1[20]: P1.163, U1.8
/rs1[21]: P1.162, U1.9
/rs1[22]: P1.160, U1.11
/rs1[23]: P1.159, U1.12
/rs1[24]: P1.158, U1.13
/rs1[25]: P1.157, U1.14
/rs1[26]: P1.155, U1.16
/rs1[27]: P1.154, U1.17
/rs1[28]: P1.152, U1.19
/rs1[29]: P1.151, U1.20
/rs1[30]: P1.149, U1.22
/rs1[31]: P1.148, U1.23
/rs2[0]: P1.142, U5.2
/rs2[1]: P1.141, U5.3
/rs2[2]: P1.139, U5.5
/rs2[3]: P1.138, U5.6
/rs2[4]: P1.136, U5.8
/rs2[5]: P1.135, U5.9
/rs2[6]: P1.133, U5.11
/rs2[7]: P1.132, U5.12
/rs2[8]: P1.131, U5.13
/rs2[9]: P1.130, U5.14
/rs2[10]: P1.128, U5.16
/rs2[11]: P1.127, U5.17
/rs2[12]: P1.125, U5.19
/rs2[13]: P1.124, U5.20
/rs2[14]: P1.122, U5.22
/rs2[15]: P1.121, U5.23
/rs2[16]: P1.120, U2.2
/rs2[17]: P1.119, U2.3
/rs2[18]: P1.117, U2.5
/rs2[19]: P1.116, U2.6
/rs2[20]: P1.114, U2.8
/rs2[21]: P1.113, U2.9
/rs2[22]: P1.111, U2.11
/rs2[23]: P1.110, U2.12
/rs2[24]: P1.109, U2.13
/rs2[25]: P1.108, U2.14
/rs2[26]: P1.106, U2.16
/rs2[27]: P1.105, U2.17
/rs2[28]: P1.103, U2.19
/rs2[29]: P1.102, U2.20
/rs2[30]: P1.100, U2.22
/rs2[31]: P1.99, U2.23
/~rs1oe: P1.192, R34.1, U1.1, U1.24, U4.1, U4.24
/~rs2oe: P1.143, R33.1, U2.1, U2.24, U5.1, U5.24
GNDREF: C11.2, C12.2, C13.2, C14.2, C21.2, C22.2, C23.2, C24.2, C31.2, C32.2, C33.2, C34.2, C41.2, C42.2, C43.2, C44.2, C51.2, C52.2, C53.2, C54.2, C61.2, C62.2, C63.2, C64.2, C71.2, C72.2, C73.2, C74.2, C81.2, C82.2, C83.2, C84.2, D1.1, D2.1, D3.1, D4.1, D5.1, D6.1, D7.1, D8.1, D9.1, D10.1, D11.1, D12.1, D13.1, D14.1, D15.1, D16.1, D17.1, D18.1, D19.1, D20.1, D21.1, D22.1, D23.1, D24.1, D25.1, D26.1, D27.1, D28.1, D29.1, D30.1, D31.1, D32.1, P1.3, P1.9, P1.14, P1.20, P1.25, P1.31, P1.36, P1.42, P1.52, P1.58, P1.63, P1.69, P1.74, P1.80, P1.85, P1.91, P1.101, P1.107, P1.112, P1.118, P1.123, P1.129, P1.134, P1.140, P1.150, P1.156, P1.161, P1.167, P1.172, P1.178, P1.183, P1.189, P2.1, U1.4, U1.10, U1.15, U1.21, U1.28, U1.34, U1.39, U1.45, U2.4, U2.10, U2.15, U2.21, U2.28, U2.34, U2.39, U2.45, U3.4, U3.10, U3.15, U3.21, U3.28, U3.34, U3.39, U3.45, U4.4, U4.10, U4.15, U4.21, U4.28, U4.34, U4.39, U4.45, U5.4, U5.10, U5.15, U5.21, U5.28, U5.34, U5.39, U5.45, U6.4, U6.10, U6.15, U6.21, U6.28, U6.34, U6.39, U6.45, U7.1, U7.4, U7.10, U7.15, U7.21, U7.24, U7.25, U7.28, U7.34, U7.39, U7.45, U7.48, U8.1, U8.4, U8.10, U8.15, U8.21, U8.24, U8.25, U8.28, U8.34, U8.39, U8.45, U8.48
unnamed: D1.2, R1.1
unnamed: D2.2, R2.1
unnamed: D3.2, R3.1
unnamed: D4.2, R4.1
unnamed: D5.2, R5.1
unnamed: D6.2, R6.1
unnamed: D7.2, R7.1
unnamed: D8.2, R8.1
unnamed: D9.2, R9.1
unnamed: D10.2, R10.1
unnamed: D11.2, R11.1
unnamed: D12.2, R12.1
unnamed: D13.2, R13.1
unnamed: D14.2, R14.1
unnamed: D15.2, R15.1
unnamed: D16.2, R16.1
unnamed: D17.2, R17.1
unnamed: D18.2, R18.1
unnamed: D19.2, R19.1
unnamed: D20.2, R20.1
unnamed: D21.2, R21.1
unnamed: D22.2, R22.1
unnamed: D23.2, R23.1
unnamed: D24.2, R24.1
unnamed: D25.2, R25.1
unnamed: D26.2, R26.1
unnamed: D27.2, R27.1
unnamed: D28.2, R28.1
unnamed: D29.2, R29.1
unnamed: D30.2, R30.1
unnamed: D31.2, R31.1
unnamed: D32.2, R32.1
unnamed: D33.1, R33.2
unnamed: D33.2, D34.2, P3.2
unnamed: D34.1, R34.2
VDD: C11.1, C12.1, C13.1, C14.1, C21.1, C22.1, C23.1, C24.1, C31.1, C32.1, C33.1, C34.1, C41.1, C42.1, C43.1, C44.1, C51.1, C52.1, C53.1, C54.1, C61.1, C62.1, C63.1, C64.1, C71.1, C72.1, C73.1, C74.1, C81.1, C82.1, C83.1, C84.1, P1.6, P1.17, P1.28, P1.39, P1.55, P1.66, P1.77, P1.88, P1.104, P1.115, P1.126, P1.137, P1.153, P1.164, P1.175, P1.186, P3.1, R35.1, U1.7, U1.18, U1.31, U1.42, U2.7, U2.18, U2.31, U2.42, U3.7, U3.18, U3.31, U3.42, U4.7, U4.18, U4.31, U4.42, U5.7, U5.18, U5.31, U5.42, U6.7, U6.18, U6.31, U6.42, U7.7, U7.18, U7.31, U7.42, U8.7, U8.18, U8.31, U8.42
