RobertBaruch/lmarv/card-breakout/card-breakout.kicad_pcb

## KiCad design card-breakout/card-breakout.kicad_pcb (2018-02-08)

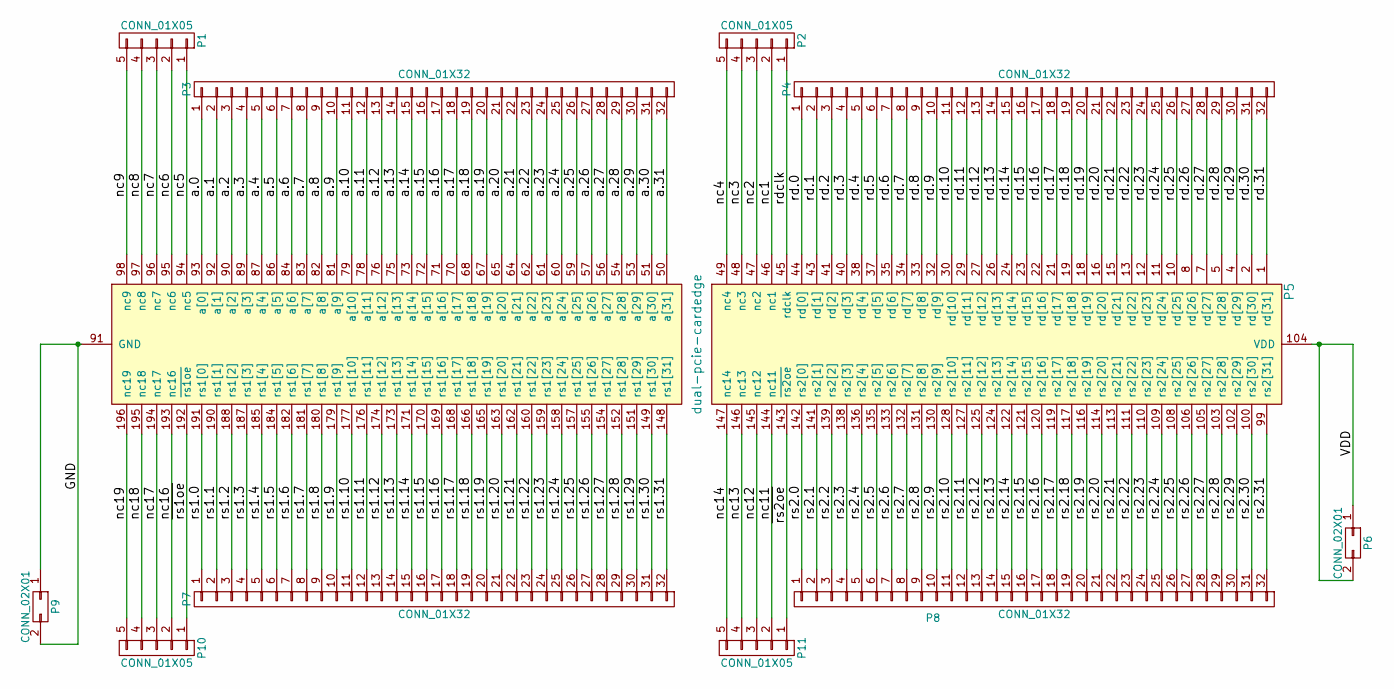
[picture p69: schematic card-breakout.sch]

Parts:
P1, P2, P10, P11: CONN_01X05; Pin_Header_Straight_1x05_Pitch2.54mm
P3, P4, P7, P8: CONN_01X32; Pin_Header_Straight_2x16_Pitch2.54mm
P5: dual-pcie-cardedge; 2pci_express_slot
P6, P9: CONN_02X01; Pin_Header_Straight_1x02_Pitch2.54mm

Connections:
/GND: P5.3 (GND), P5.9 (GND), P5.14 (GND), P5.20 (GND), P5.25 (GND), P5.31 (GND), P5.36 (GND), P5.42 (GND), P5.52 (GND), P5.58 (GND), P5.63 (GND), P5.69 (GND), P5.74 (GND), P5.80 (GND), P5.85 (GND), P5.91 (GND), P5.101 (GND), P5.107 (GND), P5.112 (GND), P5.118 (GND), P5.123 (GND), P5.129 (GND), P5.134 (GND), P5.140 (GND), P5.150 (GND), P5.156 (GND), P5.161 (GND), P5.167 (GND), P5.172 (GND), P5.178 (GND), P5.183 (GND), P5.189 (GND), P9.1, P9.2
/VDD: P5.6 (VDD), P5.17 (VDD), P5.28 (VDD), P5.39 (VDD), P5.55 (VDD), P5.66 (VDD), P5.77 (VDD), P5.88 (VDD), P5.104 (VDD), P5.115 (VDD), P5.126 (VDD), P5.137 (VDD), P5.153 (VDD), P5.164 (VDD), P5.175 (VDD), P5.186 (VDD), P6.1, P6.2
/a.0: P3.1, P5.93 (a[0])
/a.1: P3.2, P5.92 (a[1])
/a.2: P3.3, P5.90 (a[2])
/a.3: P3.4, P5.89 (a[3])
/a.4: P3.5, P5.87 (a[4])
/a.5: P3.6, P5.86 (a[5])
/a.6: P3.7, P5.84 (a[6])
/a.7: P3.8, P5.83 (a[7])
/a.8: P3.9, P5.82 (a[8])
/a.9: P3.10, P5.81 (a[9])
/a.10: P3.11, P5.79 (a[10])
/a.11: P3.12, P5.78 (a[11])
/a.12: P3.13, P5.76 (a[12])
/a.13: P3.14, P5.75 (a[13])
/a.14: P3.15, P5.73 (a[14])
/a.15: P3.16, P5.72 (a[15])
/a.16: P3.17, P5.71 (a[16])
/a.17: P3.18, P5.70 (a[17])
/a.18: P3.19, P5.68 (a[18])
/a.19: P3.20, P5.67 (a[19])
/a.20: P3.21, P5.65 (a[20])
/a.21: P3.22, P5.64 (a[21])
/a.22: P3.23, P5.62 (a[22])
/a.23: P3.24, P5.61 (a[23])
/a.24: P3.25, P5.60 (a[24])
/a.25: P3.26, P5.59 (a[25])
/a.26: P3.27, P5.57 (a[26])
/a.27: P3.28, P5.56 (a[27])
/a.28: P3.29, P5.54 (a[28])
/a.29: P3.30, P5.53 (a[29])
/a.30: P3.31, P5.51 (a[30])
/a.31: P3.32, P5.50 (a[31])
/nc1: P2.2, P5.46 (nc1)
/nc2: P2.3, P5.47 (nc2)
/nc3: P2.4, P5.48 (nc3)
/nc4: P2.5, P5.49 (nc4)
/nc5: P1.1, P5.94 (nc5)
/nc6: P1.2, P5.95 (nc6)
/nc7: P1.3, P5.96 (nc7)
/nc8: P1.4, P5.97 (nc8)
/nc9: P1.5, P5.98 (nc9)
/nc11: P5.144 (nc11), P11.2
/nc12: P5.145 (nc12), P11.3
/nc13: P5.146 (nc13), P11.4
/nc14: P5.147 (nc14), P11.5
/nc16: P5.193 (nc16), P10.2
/nc17: P5.194 (nc17), P10.3
/nc18: P5.195 (nc18), P10.4
/nc19: P5.196 (nc19), P10.5
/rd.0: P4.1, P5.44 (rd[0])
/rd.1: P4.2, P5.43 (rd[1])
/rd.2: P4.3, P5.41 (rd[2])
/rd.3: P4.4, P5.40 (rd[3])
/rd.4: P4.5, P5.38 (rd[4])
/rd.5: P4.6, P5.37 (rd[5])
/rd.6: P4.7, P5.35 (rd[6])
/rd.7: P4.8, P5.34 (rd[7])
/rd.8: P4.9, P5.33 (rd[8])
/rd.9: P4.10, P5.32 (rd[9])
/rd.10: P4.11, P5.30 (rd[10])
/rd.11: P4.12, P5.29 (rd[11])
/rd.12: P4.13, P5.27 (rd[12])
/rd.13: P4.14, P5.26 (rd[13])
/rd.14: P4.15, P5.24 (rd[14])
/rd.15: P4.16, P5.23 (rd[15])
/rd.16: P4.17, P5.22 (rd[16])
/rd.17: P4.18, P5.21 (rd[17])
/rd.18: P4.19, P5.19 (rd[18])
/rd.19: P4.20, P5.18 (rd[19])
/rd.20: P4.21, P5.16 (rd[20])
/rd.21: P4.22, P5.15 (rd[21])
/rd.22: P4.23, P5.13 (rd[22])
/rd.23: P4.24, P5.12 (rd[23])
/rd.24: P4.25, P5.11 (rd[24])
/rd.25: P4.26, P5.10 (rd[25])
/rd.26: P4.27, P5.8 (rd[26])
/rd.27: P4.28, P5.7 (rd[27])
/rd.28: P4.29, P5.5 (rd[28])
/rd.29: P4.30, P5.4 (rd[29])
/rd.30: P4.31, P5.2 (rd[30])
/rd.31: P4.32, P5.1 (rd[31])
/rdclk: P2.1, P5.45 (rdclk)
/rs1.0: P5.191 (rs1[0]), P7.1
/rs1.1: P5.190 (rs1[1]), P7.2
/rs1.2: P5.188 (rs1[2]), P7.3
/rs1.3: P5.187 (rs1[3]), P7.4
/rs1.4: P5.185 (rs1[4]), P7.5
/rs1.5: P5.184 (rs1[5]), P7.6
/rs1.6: P5.182 (rs1[6]), P7.7
/rs1.7: P5.181 (rs1[7]), P7.8
/rs1.8: P5.180 (rs1[8]), P7.9
/rs1.9: P5.179 (rs1[9]), P7.10
/rs1.10: P5.177 (rs1[10]), P7.11
/rs1.11: P5.176 (rs1[11]), P7.12
/rs1.12: P5.174 (rs1[12]), P7.13
/rs1.13: P5.173 (rs1[13]), P7.14
/rs1.14: P5.171 (rs1[14]), P7.15
/rs1.15: P5.170 (rs1[15]), P7.16
/rs1.16: P5.169 (rs1[16]), P7.17
/rs1.17: P5.168 (rs1[17]), P7.18
/rs1.18: P5.166 (rs1[18]), P7.19
/rs1.19: P5.165 (rs1[19]), P7.20
/rs1.20: P5.163 (rs1[20]), P7.21
/rs1.21: P5.162 (rs1[21]), P7.22
/rs1.22: P5.160 (rs1[22]), P7.23
/rs1.23: P5.159 (rs1[23]), P7.24
/rs1.24: P5.158 (rs1[24]), P7.25
/rs1.25: P5.157 (rs1[25]), P7.26
/rs1.26: P5.155 (rs1[26]), P7.27
/rs1.27: P5.154 (rs1[27]), P7.28
/rs1.28: P5.152 (rs1[28]), P7.29
/rs1.29: P5.151 (rs1[29]), P7.30
/rs1.30: P5.149 (rs1[30]), P7.31
/rs1.31: P5.148 (rs1[31]), P7.32
/rs2.0: P5.142 (rs2[0]), P8.1
/rs2.1: P5.141 (rs2[1]), P8.2
/rs2.2: P5.139 (rs2[2]), P8.3
/rs2.3: P5.138 (rs2[3]), P8.4
/rs2.4: P5.136 (rs2[4]), P8.5
/rs2.5: P5.135 (rs2[5]), P8.6
/rs2.6: P5.133 (rs2[6]), P8.7
/rs2.7: P5.132 (rs2[7]), P8.8
/rs2.8: P5.131 (rs2[8]), P8.9
/rs2.9: P5.130 (rs2[9]), P8.10
/rs2.10: P5.128 (rs2[10]), P8.11
/rs2.11: P5.127 (rs2[11]), P8.12
/rs2.12: P5.125 (rs2[12]), P8.13
/rs2.13: P5.124 (rs2[13]), P8.14
/rs2.14: P5.122 (rs2[14]), P8.15
/rs2.15: P5.121 (rs2[15]), P8.16
/rs2.16: P5.120 (rs2[16]), P8.17
/rs2.17: P5.119 (rs2[17]), P8.18
/rs2.18: P5.117 (rs2[18]), P8.19
/rs2.19: P5.116 (rs2[19]), P8.20
/rs2.20: P5.114 (rs2[20]), P8.21
/rs2.21: P5.113 (rs2[21]), P8.22
/rs2.22: P5.111 (rs2[22]), P8.23
/rs2.23: P5.110 (rs2[23]), P8.24
/rs2.24: P5.109 (rs2[24]), P8.25
/rs2.25: P5.108 (rs2[25]), P8.26
/rs2.26: P5.106 (rs2[26]), P8.27
/rs2.27: P5.105 (rs2[27]), P8.28
/rs2.28: P5.103 (rs2[28]), P8.29
/rs2.29: P5.102 (rs2[29]), P8.30
/rs2.30: P5.100 (rs2[30]), P8.31
/rs2.31: P5.99 (rs2[31]), P8.32
/~rs1oe: P5.192 (~rs1oe), P10.1
/~rs2oe: P5.143 (~rs2oe), P11.1

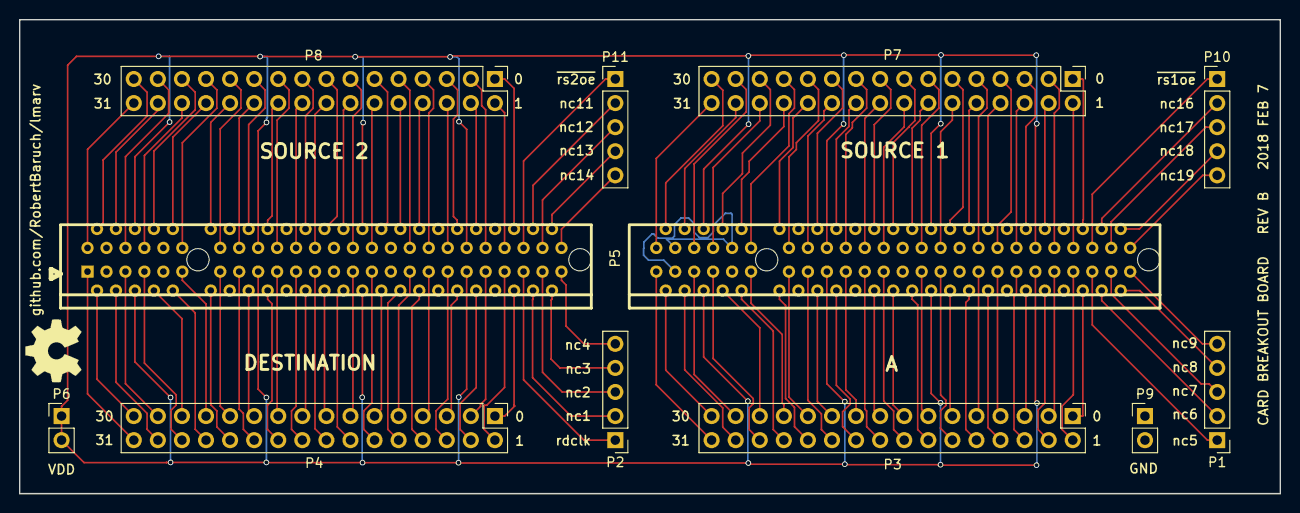
[picture p70: board card-breakout.kicad_pcb from above]

Board: 2 copper layers, 133.0 x 50.0 mm, 11 parts (0 on the bottom side), 150 nets.
