RobertBaruch/lmarv/lmarv-1/register-motherboard/register-motherboard.kicad_pcb

## KiCad design lmarv-1/register-motherboard/register-motherboard.kicad_pcb (2018-01-22)

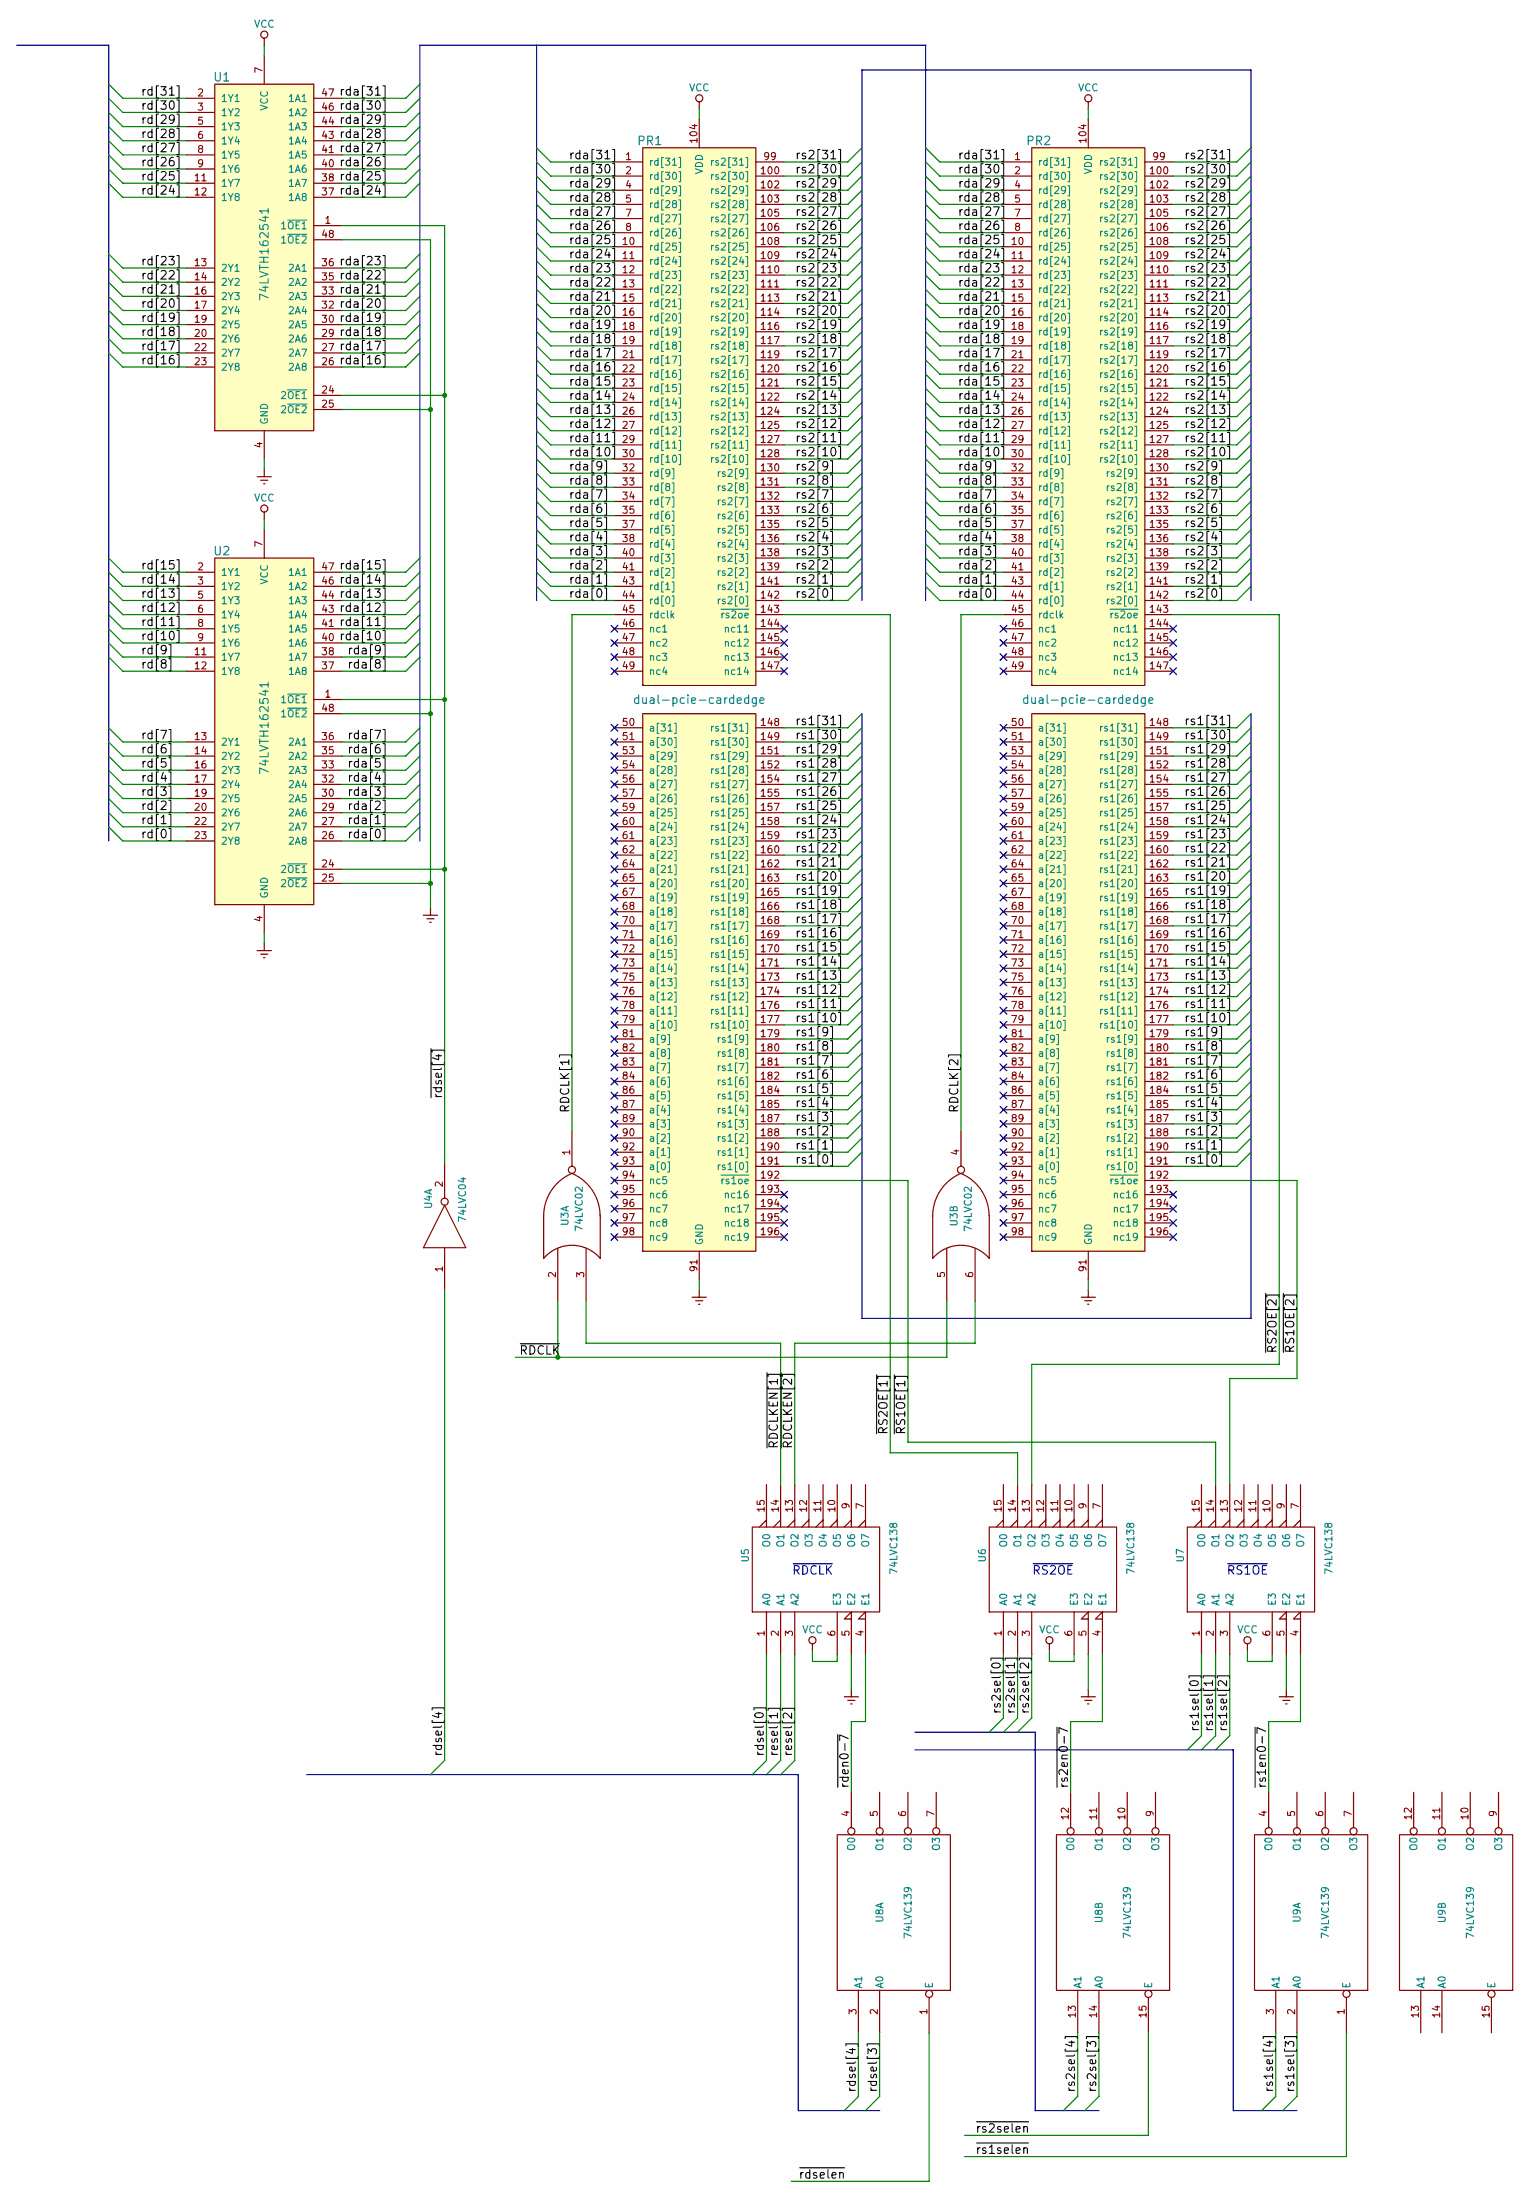
[picture p71: schematic register-motherboard.sch]

Parts:
PR1, PR2: dual-pcie-cardedge; 2pci_express_slot
U1, U2: 74LVTH162541; SSOP-48_7.5x15.9mm_Pitch0.635mm
U3: 74LVC02; SOIC-8_3.9x4.9mm_Pitch1.27mm
U4: 74LVC04; SO-4_4.4x2.3mm_Pitch1.27mm
U5, U6, U7: 74LVC138; SOIC-16_3.9x9.9mm_Pitch1.27mm
U8, U9: 74LVC139; SOIC-16_3.9x9.9mm_Pitch1.27mm

Connections:
/RDCLK[1]: PR1.45 (rdclk), U3.1
/RDCLK[2]: PR2.45 (rdclk), U3.4
/rd[0]: U2.23 (2Y8)
/rd[1]: U2.22 (2Y7)
/rd[2]: U2.20 (2Y6)
/rd[3]: U2.19 (2Y5)
/rd[4]: U2.17 (2Y4)
/rd[5]: U2.16 (2Y3)
/rd[6]: U2.14 (2Y2)
/rd[7]: U2.13 (2Y1)
/rd[8]: U2.12 (1Y8)
/rd[9]: U2.11 (1Y7)
/rd[10]: U2.9 (1Y6)
/rd[11]: U2.8 (1Y5)
/rd[12]: U2.6 (1Y4)
/rd[13]: U2.5 (1Y3)
/rd[14]: U2.3 (1Y2)
/rd[15]: U2.2 (1Y1)
/rd[16]: U1.23 (2Y8)
/rd[17]: U1.22 (2Y7)
/rd[18]: U1.20 (2Y6)
/rd[19]: U1.19 (2Y5)
/rd[20]: U1.17 (2Y4)
/rd[21]: U1.16 (2Y3)
/rd[22]: U1.14 (2Y2)
/rd[23]: U1.13 (2Y1)
/rd[24]: U1.12 (1Y8)
/rd[25]: U1.11 (1Y7)
/rd[26]: U1.9 (1Y6)
/rd[27]: U1.8 (1Y5)
/rd[28]: U1.6 (1Y4)
/rd[29]: U1.5 (1Y3)
/rd[30]: U1.3 (1Y2)
/rd[31]: U1.2 (1Y1)
/rda[0]: PR1.44 (rd[0]), PR2.44 (rd[0]), U2.26 (2A8)
/rda[1]: PR1.43 (rd[1]), PR2.43 (rd[1]), U2.27 (2A7)
/rda[2]: PR1.41 (rd[2]), PR2.41 (rd[2]), U2.29 (2A6)
/rda[3]: PR1.40 (rd[3]), PR2.40 (rd[3]), U2.30 (2A5)
/rda[4]: PR1.38 (rd[4]), PR2.38 (rd[4]), U2.32 (2A4)
/rda[5]: PR1.37 (rd[5]), PR2.37 (rd[5]), U2.33 (2A3)
/rda[6]: PR1.35 (rd[6]), PR2.35 (rd[6]), U2.35 (2A2)
/rda[7]: PR1.34 (rd[7]), PR2.34 (rd[7]), U2.36 (2A1)
/rda[8]: PR1.33 (rd[8]), PR2.33 (rd[8]), U2.37 (1A8)
/rda[9]: PR1.32 (rd[9]), PR2.32 (rd[9]), U2.38 (1A7)
/rda[10]: PR1.30 (rd[10]), PR2.30 (rd[10]), U2.40 (1A6)
/rda[11]: PR1.29 (rd[11]), PR2.29 (rd[11]), U2.41 (1A5)
/rda[12]: PR1.27 (rd[12]), PR2.27 (rd[12]), U2.43 (1A4)
/rda[13]: PR1.26 (rd[13]), PR2.26 (rd[13]), U2.44 (1A3)
/rda[14]: PR1.24 (rd[14]), PR2.24 (rd[14]), U2.46 (1A2)
/rda[15]: PR1.23 (rd[15]), PR2.23 (rd[15]), U2.47 (1A1)
/rda[16]: PR1.22 (rd[16]), PR2.22 (rd[16]), U1.26 (2A8)
/rda[17]: PR1.21 (rd[17]), PR2.21 (rd[17]), U1.27 (2A7)
/rda[18]: PR1.19 (rd[18]), PR2.19 (rd[18]), U1.29 (2A6)
/rda[19]: PR1.18 (rd[19]), PR2.18 (rd[19]), U1.30 (2A5)
/rda[20]: PR1.16 (rd[20]), PR2.16 (rd[20]), U1.32 (2A4)
/rda[21]: PR1.15 (rd[21]), PR2.15 (rd[21]), U1.33 (2A3)
/rda[22]: PR1.13 (rd[22]), PR2.13 (rd[22]), U1.35 (2A2)
/rda[23]: PR1.12 (rd[23]), PR2.12 (rd[23]), U1.36 (2A1)
/rda[24]: PR1.11 (rd[24]), PR2.11 (rd[24]), U1.37 (1A8)
/rda[25]: PR1.10 (rd[25]), PR2.10 (rd[25]), U1.38 (1A7)
/rda[26]: PR1.8 (rd[26]), PR2.8 (rd[26]), U1.40 (1A6)
/rda[27]: PR1.7 (rd[27]), PR2.7 (rd[27]), U1.41 (1A5)
/rda[28]: PR1.5 (rd[28]), PR2.5 (rd[28]), U1.43 (1A4)
/rda[29]: PR1.4 (rd[29]), PR2.4 (rd[29]), U1.44 (1A3)
/rda[30]: PR1.2 (rd[30]), PR2.2 (rd[30]), U1.46 (1A2)
/rda[31]: PR1.1 (rd[31]), PR2.1 (rd[31]), U1.47 (1A1)
/rdsel[0]: U5.1 (A0)
/rdsel[3]: U8.2 (A0)
/rdsel[4]: U4.1, U8.3 (A1)
/resel[1]: U5.2 (A1)
/resel[2]: U5.3 (A2)
/rs1[0]: PR1.191 (rs1[0]), PR2.191 (rs1[0])
/rs1[1]: PR1.190 (rs1[1]), PR2.190 (rs1[1])
/rs1[2]: PR1.188 (rs1[2]), PR2.188 (rs1[2])
/rs1[3]: PR1.187 (rs1[3]), PR2.187 (rs1[3])
/rs1[4]: PR1.185 (rs1[4]), PR2.185 (rs1[4])
/rs1[5]: PR1.184 (rs1[5]), PR2.184 (rs1[5])
/rs1[6]: PR1.182 (rs1[6]), PR2.182 (rs1[6])
/rs1[7]: PR1.181 (rs1[7]), PR2.181 (rs1[7])
/rs1[8]: PR1.180 (rs1[8]), PR2.180 (rs1[8])
/rs1[9]: PR1.179 (rs1[9]), PR2.179 (rs1[9])
/rs1[10]: PR1.177 (rs1[10]), PR2.177 (rs1[10])
/rs1[11]: PR1.176 (rs1[11]), PR2.176 (rs1[11])
/rs1[12]: PR1.174 (rs1[12]), PR2.174 (rs1[12])
/rs1[13]: PR1.173 (rs1[13]), PR2.173 (rs1[13])
/rs1[14]: PR1.171 (rs1[14]), PR2.171 (rs1[14])
/rs1[15]: PR1.170 (rs1[15]), PR2.170 (rs1[15])
/rs1[16]: PR1.169 (rs1[16]), PR2.169 (rs1[16])
/rs1[17]: PR1.168 (rs1[17]), PR2.168 (rs1[17])
/rs1[18]: PR1.166 (rs1[18]), PR2.166 (rs1[18])
/rs1[19]: PR1.165 (rs1[19]), PR2.165 (rs1[19])
/rs1[20]: PR1.163 (rs1[20]), PR2.163 (rs1[20])
/rs1[21]: PR1.162 (rs1[21]), PR2.162 (rs1[21])
/rs1[22]: PR1.160 (rs1[22]), PR2.160 (rs1[22])
/rs1[23]: PR1.159 (rs1[23]), PR2.159 (rs1[23])
/rs1[24]: PR1.158 (rs1[24]), PR2.158 (rs1[24])
/rs1[25]: PR1.157 (rs1[25]), PR2.157 (rs1[25])
/rs1[26]: PR1.155 (rs1[26]), PR2.155 (rs1[26])
/rs1[27]: PR1.154 (rs1[27]), PR2.154 (rs1[27])
/rs1[28]: PR1.152 (rs1[28]), PR2.152 (rs1[28])
/rs1[29]: PR1.151 (rs1[29]), PR2.151 (rs1[29])
/rs1[30]: PR1.149 (rs1[30]), PR2.149 (rs1[30])
/rs1[31]: PR1.148 (rs1[31]), PR2.148 (rs1[31])
/rs1sel[0]: U7.1 (A0)
/rs1sel[1]: U7.2 (A1)
/rs1sel[2]: U7.3 (A2)
/rs1sel[3]: U9.2 (A0)
/rs1sel[4]: U9.3 (A1)
/rs2[0]: PR1.142 (rs2[0]), PR2.142 (rs2[0])
/rs2[1]: PR1.141 (rs2[1]), PR2.141 (rs2[1])
/rs2[2]: PR1.139 (rs2[2]), PR2.139 (rs2[2])
/rs2[3]: PR1.138 (rs2[3]), PR2.138 (rs2[3])
/rs2[4]: PR1.136 (rs2[4]), PR2.136 (rs2[4])
/rs2[5]: PR1.135 (rs2[5]), PR2.135 (rs2[5])
/rs2[6]: PR1.133 (rs2[6]), PR2.133 (rs2[6])
/rs2[7]: PR1.132 (rs2[7]), PR2.132 (rs2[7])
/rs2[8]: PR1.131 (rs2[8]), PR2.131 (rs2[8])
/rs2[9]: PR1.130 (rs2[9]), PR2.130 (rs2[9])
/rs2[10]: PR1.128 (rs2[10]), PR2.128 (rs2[10])
/rs2[11]: PR1.127 (rs2[11]), PR2.127 (rs2[11])
/rs2[12]: PR1.125 (rs2[12]), PR2.125 (rs2[12])
/rs2[13]: PR1.124 (rs2[13]), PR2.124 (rs2[13])
/rs2[14]: PR1.122 (rs2[14]), PR2.122 (rs2[14])
/rs2[15]: PR1.121 (rs2[15]), PR2.121 (rs2[15])
/rs2[16]: PR1.120 (rs2[16]), PR2.120 (rs2[16])
/rs2[17]: PR1.119 (rs2[17]), PR2.119 (rs2[17])
/rs2[18]: PR1.117 (rs2[18]), PR2.117 (rs2[18])
/rs2[19]: PR1.116 (rs2[19]), PR2.116 (rs2[19])
/rs2[20]: PR1.114 (rs2[20]), PR2.114 (rs2[20])
/rs2[21]: PR1.113 (rs2[21]), PR2.113 (rs2[21])
/rs2[22]: PR1.111 (rs2[22]), PR2.111 (rs2[22])
/rs2[23]: PR1.110 (rs2[23]), PR2.110 (rs2[23])
/rs2[24]: PR1.109 (rs2[24]), PR2.109 (rs2[24])
/rs2[25]: PR1.108 (rs2[25]), PR2.108 (rs2[25])
/rs2[26]: PR1.106 (rs2[26]), PR2.106 (rs2[26])
/rs2[27]: PR1.105 (rs2[27]), PR2.105 (rs2[27])
/rs2[28]: PR1.103 (rs2[28]), PR2.103 (rs2[28])
/rs2[29]: PR1.102 (rs2[29]), PR2.102 (rs2[29])
/rs2[30]: PR1.100 (rs2[30]), PR2.100 (rs2[30])
/rs2[31]: PR1.99 (rs2[31]), PR2.99 (rs2[31])
/rs2sel[0]: U6.1 (A0)
/rs2sel[1]: U6.2 (A1)
/rs2sel[2]: U6.3 (A2)
/rs2sel[3]: U8.14 (A0)
/rs2sel[4]: U8.13 (A1)
/~RDCLK: U3.2, U3.5
/~RDCLKEN[1]: U3.3, U5.14 (O1)
/~RDCLKEN[2]: U3.6, U5.13 (O2)
/~RS1OE[1]: PR1.192 (~rs1oe), U7.14 (O1)
/~RS1OE[2]: PR2.192 (~rs1oe), U7.13 (O2)
/~RS2OE[1]: PR1.143 (~rs2oe), U6.14 (O1)
/~RS2OE[2]: PR2.143 (~rs2oe), U6.13 (O2)
/~rden0-7: U5.4 (E1), U8.4 (O0)
/~rdsel[4]: U1.1 (1~OE1), U1.24 (2~OE1), U2.1 (1~OE1), U2.24 (2~OE1), U4.2
/~rdselen: U8.1 (E)
/~rs1en0-7: U7.4 (E1), U9.4 (O0)
/~rs1selen: U9.1 (E)
/~rs2en0-7: U6.4 (E1), U8.12 (O0)
/~rs2selen: U8.15 (E)
GND: U3.7 (GND), U5.8 (GND), U6.8 (GND), U7.8 (GND), U8.8 (GND), U9.8 (GND)
GNDREF: PR1.3 (GND), PR1.9 (GND), PR1.14 (GND), PR1.20 (GND), PR1.25 (GND), PR1.31 (GND), PR1.36 (GND), PR1.42 (GND), PR1.52 (GND), PR1.58 (GND), PR1.63 (GND), PR1.69 (GND), PR1.74 (GND), PR1.80 (GND), PR1.85 (GND), PR1.91 (GND), PR1.101 (GND), PR1.107 (GND), PR1.112 (GND), PR1.118 (GND), PR1.123 (GND), PR1.129 (GND), PR1.134 (GND), PR1.140 (GND), PR1.150 (GND), PR1.156 (GND), PR1.161 (GND), PR1.167 (GND), PR1.172 (GND), PR1.178 (GND), PR1.183 (GND), PR1.189 (GND), PR2.3 (GND), PR2.9 (GND), PR2.14 (GND), PR2.20 (GND), PR2.25 (GND), PR2.31 (GND), PR2.36 (GND), PR2.42 (GND), PR2.52 (GND), PR2.58 (GND), PR2.63 (GND), PR2.69 (GND), PR2.74 (GND), PR2.80 (GND), PR2.85 (GND), PR2.91 (GND), PR2.101 (GND), PR2.107 (GND), PR2.112 (GND), PR2.118 (GND), PR2.123 (GND), PR2.129 (GND), PR2.134 (GND), PR2.140 (GND), PR2.150 (GND), PR2.156 (GND), PR2.161 (GND), PR2.167 (GND), PR2.172 (GND), PR2.178 (GND), PR2.183 (GND), PR2.189 (GND), U1.4 (GND), U1.10 (GND), U1.15 (GND), U1.21 (GND), U1.25 (2~OE2), U1.28 (GND), U1.34 (GND), U1.39 (GND), U1.45 (GND), U1.48 (1~OE2), U2.4 (GND), U2.10 (GND), U2.15 (GND), U2.21 (GND), U2.25 (2~OE2), U2.28 (GND), U2.34 (GND), U2.39 (GND), U2.45 (GND), U2.48 (1~OE2), U5.5 (E2), U6.5 (E2), U7.5 (E2)
VCC: PR1.6 (VDD), PR1.17 (VDD), PR1.28 (VDD), PR1.39 (VDD), PR1.55 (VDD), PR1.66 (VDD), PR1.77 (VDD), PR1.88 (VDD), PR1.104 (VDD), PR1.115 (VDD), PR1.126 (VDD), PR1.137 (VDD), PR1.153 (VDD), PR1.164 (VDD), PR1.175 (VDD), PR1.186 (VDD), PR2.6 (VDD), PR2.17 (VDD), PR2.28 (VDD), PR2.39 (VDD), PR2.55 (VDD), PR2.66 (VDD), PR2.77 (VDD), PR2.88 (VDD), PR2.104 (VDD), PR2.115 (VDD), PR2.126 (VDD), PR2.137 (VDD), PR2.153 (VDD), PR2.164 (VDD), PR2.175 (VDD), PR2.186 (VDD), U1.7 (VCC), U1.18 (VCC), U1.31 (VCC), U1.42 (VCC), U2.7 (VCC), U2.18 (VCC), U2.31 (VCC), U2.42 (VCC), U5.6 (E3), U5.16 (VCC), U6.6 (E3), U6.16 (VCC), U7.6 (E3), U7.16 (VCC), U8.16 (VCC), U9.16 (VCC)

Notes on the sheet:
~RS1OE
~RS2OE
~RDCLK

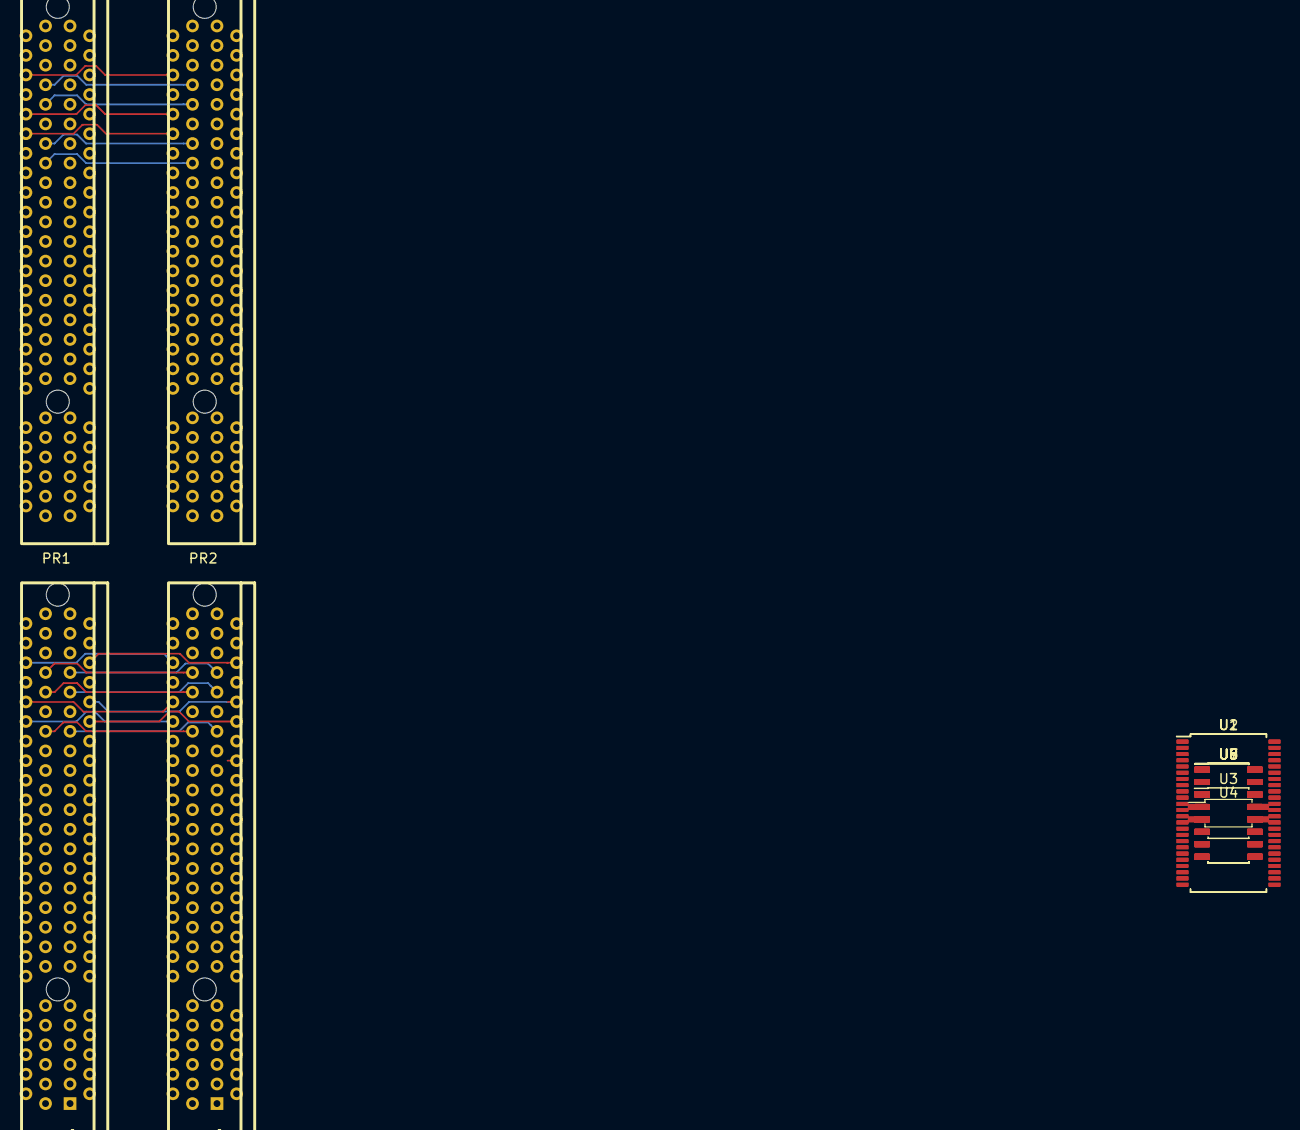
[picture p72: board register-motherboard.kicad_pcb from above]

Board: 4 copper layers, 11 parts (0 on the bottom side), 113 nets.
