RobertBaruch/lmarv/(commit log)

2018-01-22 Initial dump
    [register-card.kicad_pcb, register-card.sch, register-motherboard.kicad_pcb, register-motherboard.sch]
2018-02-08 Updated register card and breakout
    [card-breakout-B.Cu.gbl, card-breakout-B.Mask.gbs, card-breakout-B.SilkS.gbo, card-breakout-Edge.Cuts.gko, card-breakout-F.Cu.gtl, card-breakout-F.Mask.gts, card-breakout-F.SilkS.gto, card-breakout-NPTH.drl]
2018-05-30 Adds RAM-based register card
    [ram-based-register-card-B.Cu.gbl, ram-based-register-card-B.Mask.gbs, ram-based-register-card-B.SilkS.gbo, ram-based-register-card-Edge.Cuts.gm1, ram-based-register-card-F.Cu.gtl, ram-based-register-card-F.Mask.gts, ram-based-register-card-F.SilkS.gto, ram-based-register-card-NPTH.drl]
2018-05-30 Updates silkscreen and gerbers for register card
    [ram-based-register-card-B.Cu.gbl, ram-based-register-card-B.Mask.gbs, ram-based-register-card-B.SilkS.gbo, ram-based-register-card-Edge.Cuts.gm1, ram-based-register-card-F.Cu.gtl, ram-based-register-card-F.Mask.gts, ram-based-register-card-F.SilkS.gto, ram-based-register-card-NPTH.drl]
2018-07-08 Dump for backing up, 2018 Jul 7
    [alu-B.Cu.gbl, alu-B.Mask.gbs, alu-B.SilkS.gbo, alu-Edge.Cuts.gm1, alu-F.Cu.gtl, alu-F.Mask.gts, alu-F.SilkS.gto, alu-NPTH.drl]
2018-08-10 Adds tinyfpga test things
    [TinyFPGA-BX.kicad_pcb, TinyFPGA-BX.sch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]
2018-10-13 Mainly updates alu.py simulator
    [alu-B.Cu.gbl, alu-B.Mask.gbs, alu-B.SilkS.gbo, alu-Edge.Cuts.gm1, alu-F.Cu.gtl, alu-F.Mask.gts, alu-F.SilkS.gto, alu-NPTH.drl]
2018-10-22 Update alu.py, add some instruction diagrams
    [alu.kicad_pcb, alu.sch]
2018-10-27 bit_pattern: use lower case for function name
2018-10-28 Updated ALU, tester, more instruction pages
    [alu.kicad_pcb, tester_v2.kicad_pcb, tester_v2.sch]
2018-11-14 Update tester/alu boards, adds instructions book
    [alu-B.Cu.gbl, alu-B.Cu.gbr, alu-B.Mask.gbr, alu-B.Mask.gbs, alu-B.SilkS.gbo, alu-B.SilkS.gbr, alu-Edge.Cuts.gbr, alu-Edge.Cuts.gm1]
2018-11-27 Make PCA9698DDG working.
    * Fixed the i2c address of the last PCA9698DDG.
    * Fixed wrong register names for output
    * Move reset to the beginning.
    [passthru_tester.py, tester_v2.py]
2018-12-16 Updates tester, alu, adds lights-n-jumpers, ht1632 breakout
    [APTD2012.step, CAY_17-J.step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]
2018-12-16 Alters testing programs
    [TinyFPGA-BX.kicad_pcb, TinyFPGA-BX.sch]
2019-01-28 ALU rev D, with simulations
    [32to4_mux.sch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]
